linkstwo/smart-wardrobe-iot/执行ALL HOME，M1M3M4全部归零。.md

**执行ALL HOME，M1/M3/M4全部归零。**

**M2以10RPM顺时针CW转650步，进入与放衣相同的基础姿态。**

**Z轴移动到激光定位板高度EC4=3263。**

**M2以10RPM顺时针CW转**1500**步，进入激光扫描姿态。**

**X轴右移到激光起点EC1=8860。**

**清空旧激光样本，等待2帧新响应。**

**X轴以20RPM开始扫描，识别到板面后降至10RPM。**

**扫描到第SLOT块有效定位板并完整退出后，急停X轴。**

**X轴从停止位置向左相对移动1125个EC1计数。**

**Z轴从当前位置向下相对移动1200个EC4计数（中转位置）。**

**Y轴从当前位置向前相对移动1250个EC3计数。**

**M2以10RPM逆时针CCW转1500步，进入衣服吸取姿态。**

**Z轴从当前位置向下相对移动300个EC4计数。**

**电磁铁ON，吸住衣服并等待2秒。**

**Z轴从当前位置向上相对移动200个EC4计数。**

**Y轴从当前位置向前相对移动150个EC3计数。**

**M2以10RPM顺时针CW转1500步，将衣服从挂衣姿态旋转回来。**

**Y轴通过EX\_KEY3归零**

**M2以10RPM逆时针CW转4500步。**

**X轴左移到中转位置EC1=4200。**

**M2以10RPM顺时针CW转3000步。**

**Z轴向下移动到最终位置EC4=12800。**

**Y轴向前移动到EC3=1540。**

**X轴归零。**

**电磁铁OFF，放下衣服并等待2秒。**

**Z轴移动到中转高度EC4=10000。**

**执行ALL HOME，M1/M3/M4全部归零。**

**M2通过绝对编码器回到RAW=1008。**

**确认全部到位后，上报取衣成功。**

eyJjbWQiOjE3LCJwb3NpdGlvbiI6MX0=，第一件的，取衣服的

**X轴左移到中转位置EC1=5000。**

**M2以10RPM逆时针CCW转3000步，退出激光扫描姿态。此时M2仍保留最开始的CW 650步姿态。**

**Z轴移动到中转高度EC4=10000。**

**Y轴向前移动到EC3=1494。**

**X轴通过EX\_KEY1归零，使衣服回到原取放位置的X坐标。**

**Z轴向下移动到最终位置EC4=12800。**

**电磁铁OFF，放下衣服并等待2秒。**

**M4以CCW向上移动650个电机步，离开放衣位置。**

**Y轴通过EX\_KEY3归零。**

**执行ALL HOME，M1/M3/M4全部归零。**

**M2通过绝对编码器回到RAW=1008。**

**确认全部到位后，上报取衣成功。**
