linkstwo/smart-wardrobe-iot/新建 文本文档.md

放衣服 AXIS PLACE\_CLOTH

执行ALL HOME，M1/X、M3/Y、M4/Z归零。

M2以10RPM顺时针CW转650步。

Z轴到绝对位置EC4=10000。

**X轴到绝对位置EC1=这个是一个变量（要根据激光测距2测出的距离在用那个公式转化成EC1的位置）。**

**（公式K = (激光距离变化D2 - D1) / (编码器变化EC2 - EC1)**

**单位：mm/编码器计数）**

Y轴到绝对位置EC3=1381。

Z轴到绝对位置EC4=12552。

电磁铁ON，等待2秒。

M4以CCW向上运行650个电机步，速度使用命令RPM。

**X轴到绝对位置EC1=1000。**

Y轴通过EX\_KEY3物理归零。

Z轴到激光高度EC4=3263。

M2以10RPM顺时针CW转4000步。

X轴到激光起点EC1=8860。

清空旧激光样本，等待2帧新响应。

X轴以75RPM扫描，进入有效板面后降至50RPM。

找到第SLOT块有效板并完整退出后，停止X轴。

X轴从停止位置向左相对移动1125个EC1计数。

Z轴从当前位置向下相对移动1500个EC4计数。

Y轴从当前位置向前相对移动1250个EC3计数。

M2以10RPM逆时针CCW转4000步。

电磁铁OFF，等待2秒。

Z轴从释放位置向上相对移动150个EC4计数。

Y轴通过EX\_KEY3物理归零。

M2以10RPM顺时针CW转1000步。

再次执行ALL HOME，M1/M3/M4全部归零。

M2以25RPM通过绝对编码器回到RAW=1008。

确认全部到位后上报放衣成功。

取衣服 AXIS TAKE\_CLOTH

执行ALL HOME，M1/X、M3/Y、M4/Z归零。

M2以10RPM顺时针CW转650步。

Z轴到激光高度EC4=3263。

M2以10RPM顺时针CW转1500步。

X轴到激光起点EC1=8860。

清空旧激光样本，等待2帧新响应。

X轴以75RPM扫描，进入有效板面后降至50RPM。

找到第SLOT块有效板并完整退出后，停止X轴。

X轴从停止位置向左相对移动1760个EC1计数。

Z轴从当前位置向下相对移动1200个EC4计数。

Y轴从当前位置向前相对移动1350个EC3计数。

M2以10RPM逆时针CCW转1500步。

Z轴从当前位置向下相对移动670个EC4计数。

电磁铁ON，等待2秒。

Z轴从当前位置向上相对移动520个EC4计数。

Y轴从当前位置向前相对移动150个EC3计数。

M2以10RPM顺时针CW转1500步。

Y轴通过EX\_KEY3物理归零。

M2以10RPM逆时针CCW转5500步。

X轴移动到绝对位置EC1=1000。

M2以10RPM顺时针CW转4000步。

Z轴到绝对位置EC4=12552。

Y轴到绝对位置EC3=1470。

X轴到绝对位置EC1=3200。

电磁铁OFF，等待2秒。

Z轴到绝对位置EC4=10000。

再次执行ALL HOME，M1/M3/M4全部归零。

M2以25RPM通过绝对编码器回到RAW=1008。

确认全部到位后上报取衣成功。
