linkstwo/smart-wardrobe-iot/SmartWardrobe/ALL_HOME回零逻辑对话记录.md

# ALL HOME 回零逻辑对话记录

记录时间：2026-06-15 14:32:08

## 用户关注点

- 查询当前程序中，电机回到行程开关后，编码器计数是否会自动归零。
- 查询 `ALL HOME RPM=xx` 是否只有在 M1、M3、M4 三个行程开关都未触发时才会运行。
- 要求修改 `ALL HOME RPM=xx` 的行为：如果 M1、M3、M4 中有一个或两个已经在行程开关位置，也要让其他未触发行程开关的步进电机继续回到行程开关。

## 本小姐的检查结论

- 当前程序在 `HOME_EX` 到达行程开关后，只会急停对应电机并输出完成提示，不会自动调用 `EncoderCtrl_Clear()`，因此不会自动清零编码器计数。
- 修改前的 `ALL HOME RPM=xx` 会先检查 M1、M3、M4，只要其中任意一个行程开关已触发，就直接返回 `ERR 212 EX_KEY_LOW`，整个 `ALL HOME` 不会启动。
- `ALL HOME` 的参与轴是 M1-EX1、M3-EX3、M4-EX4，M2-EX2 被跳过。

## 本次修改意图

- 保留 `ALL HOME` 只作用于 M1、M3、M4 的规则。
- 将 `ALL HOME` 从“任意一个参与轴已触发就整体失败”改为“已触发的轴跳过，未触发的轴继续执行回原点”。
- 如果 M1、M3、M4 全部已经在行程开关，则不启动任何电机，并返回 `OK ALL HOME ALREADY_DONE ...`。
- 后续补充：`ALL HOME RPM=xx` 等 M1/M3/M4 全部到位后，自动清零 EC1、EC3、EC4，并把现场三轴坐标 `X=M1、Y=M3、Z=M4` 归零；M2 的 RS485 绝对值编码器不归零。
- 最新确认：旋转电机对应特殊编码器 2，因此旋转轴命令使用 `M2 ROT_*`，不是 M3 或 M5；`M2 ABS_*` 仍用于 M2 的 RS485 绝对值编码器角度闭环。
- `AXIS MOVE` / `AXIS ZERO` / `AXIS LIMIT_SET` 仍只作用于 XYZ 三轴：`X=M1`、`Y=M3`、`Z=M4`，M2 不加入 XYZ 坐标。

## 验证建议

- 三个轴都离开行程开关时，发送 `ALL HOME RPM=120`，应启动 M1、M3、M4。
- 只有 M1 已触发行程开关时，发送 `ALL HOME RPM=120`，应跳过 M1，只启动 M3、M4。
- M1、M3 已触发行程开关时，发送 `ALL HOME RPM=120`，应跳过 M1、M3，只启动 M4。
- M1、M3、M4 全部已触发行程开关时，发送 `ALL HOME RPM=120`，应返回已完成状态，不启动电机。
- 注意命令参数应为 `RPM`，不是 `PRM`。
