linkstwo/smart-wardrobe-iot/SmartWardrobe/57电机32-25(1)/57电机32-25/搂线图.jpg

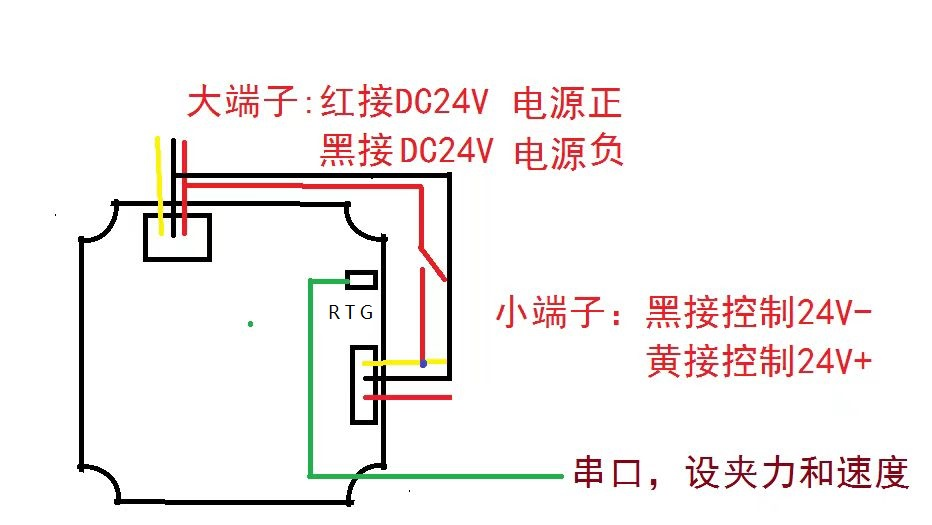
SmartWardrobe/57电机32-25(1)/57电机32-25/搂线图.jpg
