linkstwo/smart-wardrobe-iot/SmartWardrobe/57电机32-25(1)/57电机32-25/操作说明.png

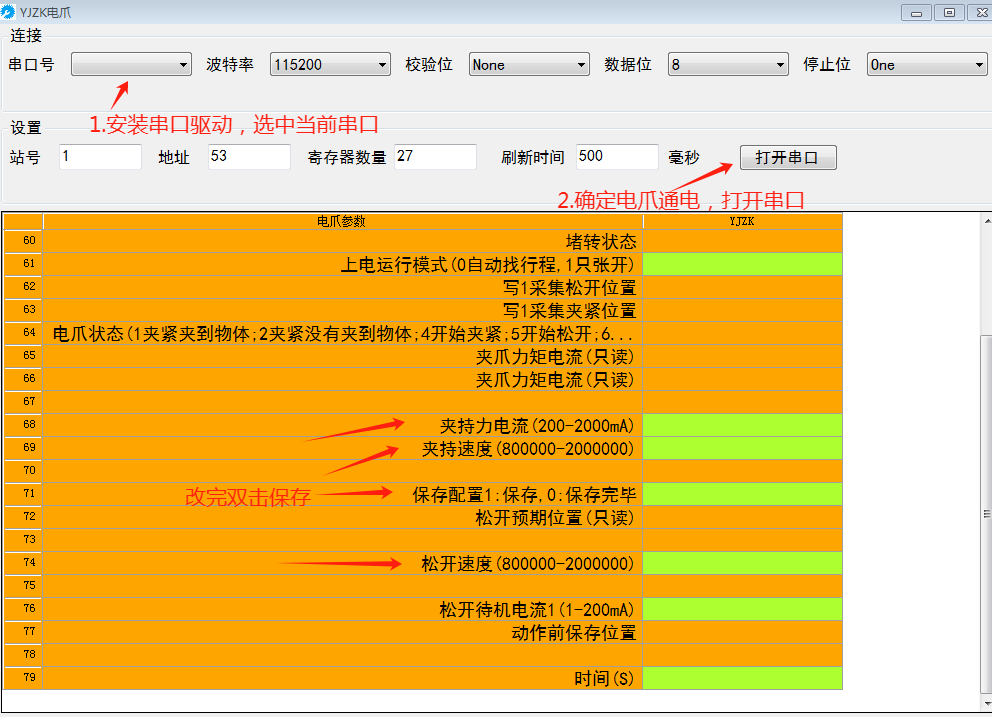
SmartWardrobe/57电机32-25(1)/57电机32-25/操作说明.png
