linkstwo/smart-wardrobe-iot/SmartWardrobe/57电机32-25(1)/57电机32-25/连接图.png

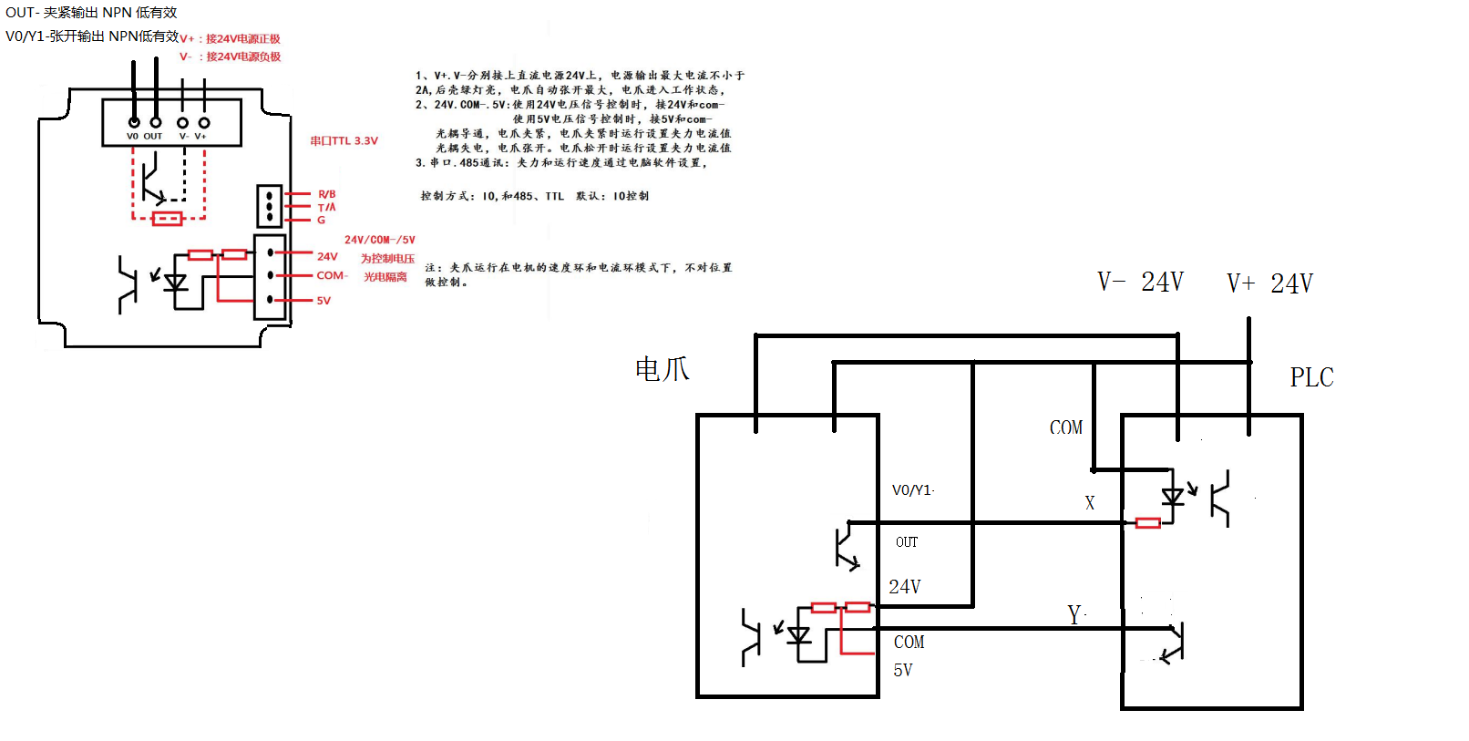
SmartWardrobe/57电机32-25(1)/57电机32-25/连接图.png
