linkstwo/smart-wardrobe-iot/SmartWardrobe/MDK-ARM/ec4_pin_crop.png

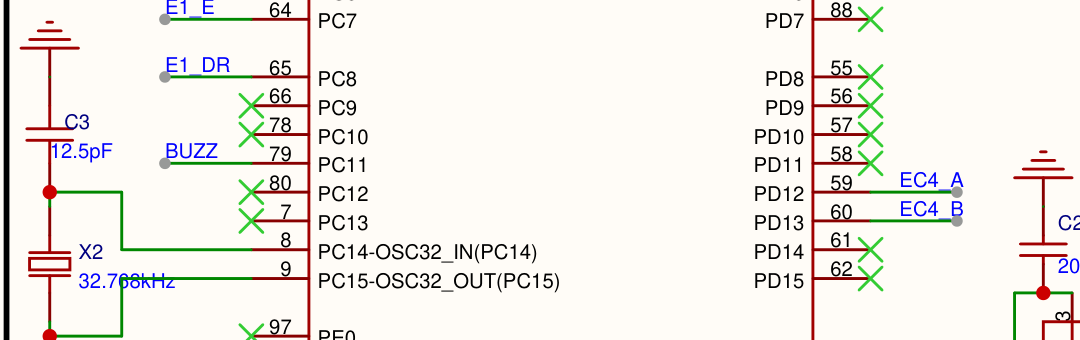
SmartWardrobe/MDK-ARM/ec4_pin_crop.png
