linkstwo/smart-wardrobe-iot/取衣服放衣服.png

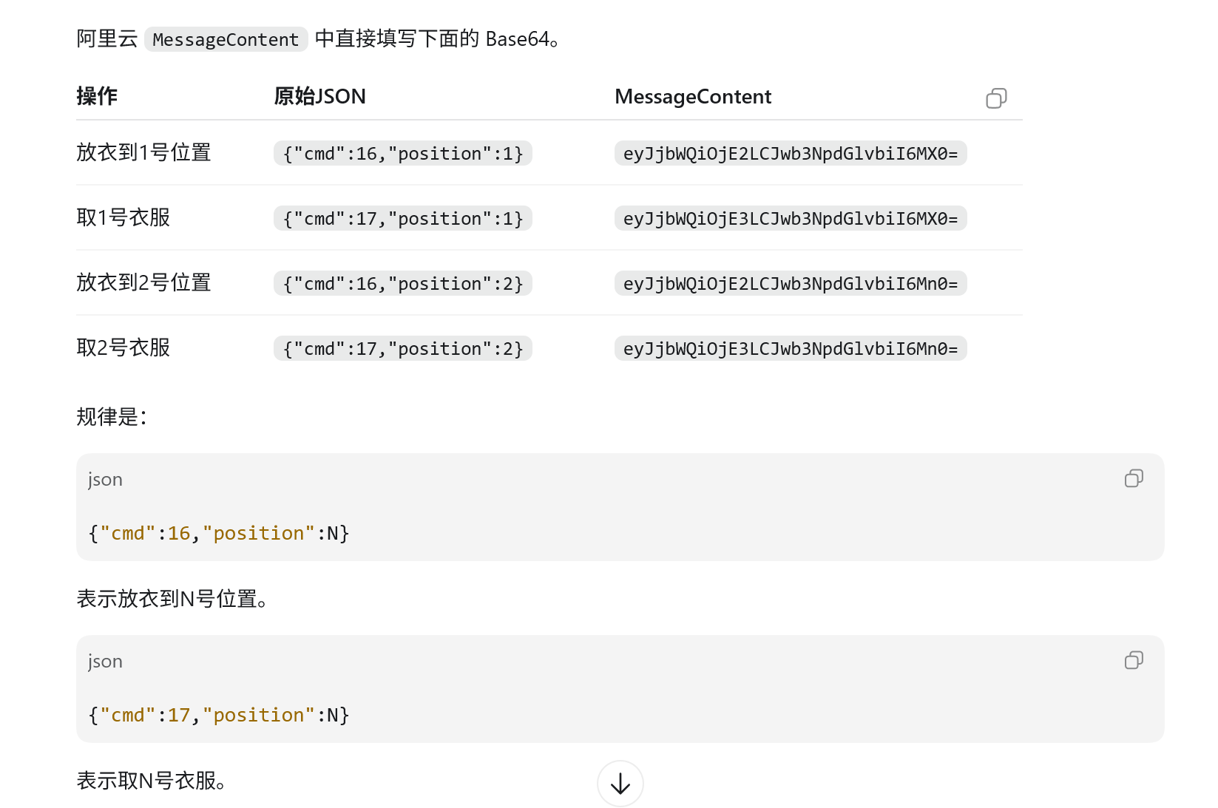
取衣服放衣服.png
