linkstwo/smart-wardrobe-iot/server_esp/修改日志/修改日志.md

# 修改日志

## 2026-07-11 10:58:17

### 修改类型
修改 / 激光衣位协议扩展

### 涉及文件
- `components/esp_mqtt/mqtt.c`
- `docs/README.md`
- `docs/协议.md`
- `协议.md`
- `修改日志/修改日志.md`

### 修改内容
- 取衣命令的 `position` 范围调整为 `1..255`，并原样转发给 STM32，表示从 X 原点扫描到的第 N 块三级定位板。
- 存衣命令仍只允许已配置的 `position=1`。
- 删除 `position=5` 映射为 1 号位的旧兼容逻辑，并同步更新协议说明。

### 修改原因
- STM32 已改为使用 JH-AI-1811 激光模块动态识别取衣位置，不再依赖固定位置别名。

### 问题修复类型
- 根本性功能实现。

### 根因分析
- 原 ESP32 参数校验只允许位置 1 和 5，会拦截新的第 N 衣位取衣命令。

### 工程原则应用
- KISS：仅按命令类型区分位置范围，不改变 UART 帧格式。
- YAGNI：存衣仍保持单一已配置位置。
- DRY：继续复用现有一字节 position 帧和 pending 命令机制。
- SOLID：MQTT 层只负责参数校验和转发，不实现机械扫描逻辑。

### 问题确认情况
- 用户已确认实施 JH-AI-1811 激光衣位识别方案。

### 风险评估
- ESP32 会允许取衣位置 1..255，目标板不存在时由 STM32 扫描超时或限位保护返回故障。

### 验证方式
- 本机未发现 ESP-IDF `idf.py`，未执行 ESP32 全量编译。
- 实机发送 `cmd=17, position=1/2/N`，确认帧原样转发；发送存衣 `position!=1` 应返回 `unsupported_position`。

## 2026-07-10 11:56:31

### 修改类型
修复 / VS Code 烧录目录恢复

### 涉及文件
- `.vscode/settings.json`
- `firmware_cloud/project_description.json`
- `build/flasher_args.json`
- `build/flash_args`
- `build/bootloader.bin`
- `build/partition-table.bin`
- `build/main.bin`
- `build/main.elf`
- `build/project_description.json`
- `修改日志/修改日志.md`

### 修改内容
- 明确设置 ESP-IDF 扩展的构建目录为 `${workspaceFolder}/build`。
- 将 clangd 的编译数据库目录从已失效的旧工程绝对路径改为当前工作区的 `build`。
- 为现有固件补充 ESP-IDF 扩展读取 ELF 文件名所需的 `project_description.json`。
- 将已完成构建并验证过的 ESP32-S3 烧录清单、三个 BIN、ELF 和项目描述同步到标准 `build` 目录，使 VS Code Flash 能完成全部前置校验。

### 修改原因
- VS Code ESP-IDF 扩展默认检查 `server_esp/build/flasher_args.json`，但完整固件此前只集中在 `firmware_cloud/`，因此直接报缺少文件并终止烧录。

### 问题修复类型
分阶段修复

### 根因分析
- 报错不是固件源码编译错误，而是扩展使用的标准构建目录与固件实际存放目录不一致。
- 只复制 `flasher_args.json` 仍会因引用的 BIN 或扩展要求的 ELF/项目描述不存在而失败，因此本次同步完整 Flash 所需文件集合。
- 当前阶段直接恢复现有已验证固件的 Flash 能力；后续源码重新构建仍应通过纯英文工程路径或修复本机 Python/ESP-IDF 的 UTF-8 路径环境完成。

### 工程原则应用
- KISS：继续使用 ESP-IDF 扩展默认的 `build` 目录，不引入额外烧录脚本。
- YAGNI：不修改系统环境变量，不新增全局路径映射。
- DRY：`build` 与 `firmware_cloud` 使用同一套已验证固件产物。
- SOLID：当前为工具链目录配置修复，不强行套用复杂架构。

### 问题确认情况
- 已确认报错目录 `build` 缺少 `flasher_args.json`，而 `firmware_cloud` 中该文件及其引用的三个 BIN 均完整存在。
- 用户回复“继续”，同意按根因方向修改。

### 风险评估
- 本次不自动烧录 `COM19`，不会直接改写 ESP32 Flash。
- 已实测 `PYTHONUTF8=1` 可以消除 `config.env` 的 GBK 解码异常，但 CMake 仍会把中文目录 `M2可转向` 解码成乱码，且本机子进程存在 `Path/PATH` 重复项；因此原路径下源码重构建仍未根治，本次先恢复现有已验证固件的 Flash 能力。

### 验证方式
- `build/flasher_args.json`、三个 BIN、`main.elf` 和 `project_description.json` 应同时存在。
- `flasher_args.json` 中的偏移和文件名应分别为 `0x0 bootloader.bin`、`0x8000 partition-table.bin`、`0x10000 main.bin`。
- VS Code 重新加载窗口后执行 Flash，不应再出现 `flasher_args.json file is missing`。

## 2026-07-10 11:21:11

### 修改类型
修复 / 云端通信联调

### 涉及文件
- `components/esp_mqtt/mqtt.c`
- `components/uart/uart.c`
- `docs/README.md`
- `协议.md`
- `docs/协议.md`
- `firmware_cloud/README.md`
- `firmware_cloud/main.bin`
- `firmware_cloud/main.elf`
- `firmware_cloud/main.map`
- `firmware_cloud/bootloader.bin`
- `firmware_cloud/partition-table.bin`
- `firmware_cloud/flash_args`
- `firmware_cloud/flasher_args.json`
- `修改日志/修改日志.md`

### 修改内容
- 将 STM32 成功、故障和状态响应的 MQTT 发布 Topic 从旧的 `wardrobe/response` 改为当前阿里云自定义 Topic `WARDROBE_MQTT_TOPIC`。
- 将存衣、取衣位置校验从仅允许 `position=1` 调整为允许 `position=1/5`，与 STM32 的 `g_wardrobe_position_map[]` 保持一致。
- 同步更新 README 和两份协议文档中的位置范围及 MQTT 同 Topic 收发说明。
- 从当前源码独立构建 ESP32-S3 固件，并将可烧录产物集中放入 `firmware_cloud/`。
- 修正 `firmware_cloud/flash_args` 和 `flasher_args.json`，使其引用当前目录内的实际固件文件。

### 修改原因
- UART 上行处理仍保留旧响应 Topic，导致 STM32 即使返回 `0x90/0x91/0xA0`，ESP32 也不会发布到当前阿里云联调使用的同一 Topic。
- STM32 已支持云端位置 1 和 5，但 ESP32 会提前拒绝 `position=5`，两端能力边界不一致。
- 原 `build/` 缓存绑定另一份旧工程路径，不能证明当前目录源码已经进入烧录固件。

### 问题修复类型
根本性修复

### 根因分析
- MQTT 下行使用 `WARDROBE_MQTT_TOPIC`，UART 上行却硬编码 `wardrobe/response`，协议上下行 Topic 没有统一事实来源。
- ESP32 的单点位置限制落后于 STM32 映射表，合法命令在进入 UART 前被错误拦截。
- 当前工程路径含中文，ESP-IDF/CMake 在本机默认编码下会产生乱码路径；本次通过临时英文构建目录编译当前源码，并校验暂存源码 SHA256 与当前源码一致。

### 工程原则应用
- KISS：直接复用已有 `WARDROBE_MQTT_TOPIC`，不新增第二套 Topic 配置。
- YAGNI：只放行当前 STM32 已明确映射的 1 和 5，不开放其他未配置位置。
- DRY：上下行统一使用同一 Topic 宏，避免重复硬编码再次漂移。
- SOLID：保持 MQTT 负责下行转换、UART 负责上行解析的现有模块边界。

### 问题确认情况
- 已确认当前 ESP32 ELF 同时包含旧响应 Topic 和阿里云 Topic，属于确定的代码不一致。
- 已确认 STM32 映射表包含 `position=1/5`。
- 用户明确回复“继续”，同意按该根因修改并构建固件。

### 风险评估
- `position=5` 当前与 `position=1` 共用运动点位 1，并不代表已经增加独立的 5 号机械坐标。
- 同 Topic 收发依赖 MQTT 命令处理器继续忽略带 `status` 字段的响应，当前代码已保留该保护。
- 若在阿里云物模型属性页查看状态，仍需另行实现物模型属性上报；本次修复的是自定义 Topic 链路。

### 验证方式
- ESP-IDF 完整构建成功，生成 ESP32-S3 `main.bin`，大小 932416 字节，应用分区剩余约 11%。
- 构建日志显示 `mqtt.c`、`uart.c` 编译成功并完成主程序、bootloader 和分区表镜像生成。
- 新 `firmware_cloud/main.elf` 包含完整阿里云 Topic，不再包含旧字符串 `wardrobe/response`。
- 烧录后发送 `{"cmd":32}`，应看到 ESP32 发出 `A5 20 00 20 5A`，收到 STM32 `0xA0` 后向同一阿里云 Topic 发布状态 JSON。
- 发送 `{"cmd":17,"position":1}` 和 `{"cmd":17,"position":5}`，两者都应进入 UART 转发链路。

## 2026-06-24 22:05:39

### 修改类型
修改

### 涉及文件
- `components/uart/CMakeLists.txt`
- `修改日志/修改日志.md`

### 修改内容
- 补充 ESP32 UART 组件 CMake 文件的中文说明，明确该组件负责 ESP32 与 STM32 串口通信。
- 说明手动添加 include 路径的原因是避免组件循环依赖。

### 修改原因
- 用户要求再次仔细检查是否还有文件漏掉中文注释。

### 问题修复类型
- 不适用

### 根因分析
- 本次不是功能修复，只补充说明性中文注释。

### 工程原则应用
- KISS：只补充构建配置说明，不改组件依赖和构建逻辑。
- YAGNI：没有调整 ESP-IDF 构建结构。
- DRY：把 UART 组件职责写在对应 CMake 文件顶部。
- SOLID：配置注释补充，不强行套用复杂架构。

### 问题确认情况
- 用户反馈可能仍有文件缺少中文注释，已重新扫描确认后补充。

### 风险评估
- 仅增加注释，无运行时行为变化，无明显风险。

### 验证方式
- 重新扫描 ESP32 配置文件中文注释覆盖情况。

## 2026-06-24 21:34:26

### 修改类型
修改

### 涉及文件
- `CMakeLists.txt`
- `main/CMakeLists.txt`
- `app/CMakeLists.txt`
- `components/esp_mqtt/CMakeLists.txt`
- `components/wifi/CMakeLists.txt`
- `components/esp_mqtt/Kconfig`
- `components/uart/Kconfig`
- `components/wifi/Kconfig`
- `components/esp_mqtt/mqtt.c`
- `修改日志/修改日志.md`

### 修改内容
- 为 ESP32 工程 CMake 和 Kconfig 配置文件补充中文注释。
- 在 MQTT 衣柜命令处理处补充中文说明，明确增加 2/3 号衣服点位时需要放开 `position` 判断。
- 明确 ESP32 点位放开必须与 STM32 `g_wardrobe_position_map[]` 和 `g_cloth_slot_cfg[]` 同步。

### 修改原因
- 用户要求继续检查还有哪些文件没有中文注释，并要求在代码中标清楚增加衣服点位的位置。

### 问题修复类型
- 不适用

### 根因分析
- 本次不是功能修复，只补充说明性中文注释。
- 原 C 源码已有较多中文注释，但 ESP-IDF 构建配置文件和 MQTT 点位扩展说明还不够完整。

### 工程原则应用
- KISS：只增加注释，不改 MQTT 协议、Topic、云端认证参数和 UART 帧格式。
- YAGNI：没有提前增加 2/3 号点位运行逻辑，只说明扩展位置。
- DRY：把 ESP32 放开点位的说明写在 `WARDROBE_SUPPORTED_SLOT` 和 `position` 判断附近。
- SOLID：当前为嵌入式 C/ESP-IDF 配置注释补充，不强行套用复杂架构。

### 问题确认情况
- 用户明确要求只写代码注释，不改代码逻辑，并要求继续仔细检查遗漏注释。

### 风险评估
- 仅增加注释，无运行时行为变化，无明显风险。
- `.vscode/*.json` 未添加注释，因为标准 JSON 不支持注释。
- `SmartWardrobeCode.ioc` 未手动添加注释，因为 CubeMX 配置文件开头标明不建议手改。

### 验证方式
- 检查 ESP32 CMake/Kconfig 文件是否已有中文说明。
- 检查 `components/esp_mqtt/mqtt.c` 中 `WARDROBE_SUPPORTED_SLOT` 和 `position` 判断处的点位扩展说明。
- 重新扫描源码和配置文件中的中文注释覆盖情况。

## 2026-06-24 21:14:03

### 修改类型
修改

### 涉及文件
- `main/main.c`
- `app/app.c`
- `app/app_init.c`
- `app/include/app.h`
- `app/include/app_init.h`
- `components/esp_mqtt/mqtt.c`
- `components/esp_mqtt/include/mqtt.h`
- `components/esp_mqtt/include/mqtt_config.h`
- `components/uart/uart.c`
- `components/uart/include/uart.h`
- `components/uart/include/uart_config.h`
- `components/wifi/wifi.c`
- `components/wifi/include/wifi.h`
- `components/wifi/include/wifi_config.h`
- `修改日志/修改日志.md`

### 修改内容
- 为 ESP32 工程核心源码补充详细简体中文注释。
- 说明 ESP32 从阿里云 MQTT 接收 `cmd`/`position` JSON 后，如何转换为 STM32 串口二进制帧。
- 说明衣柜 UART 帧格式 `A5 CMD LEN DATA CRC 5A`、CRC 计算方式和 STM32 响应帧处理路径。
- 说明当前 `WARDROBE_SUPPORTED_SLOT` 只支持 1 号位，后续增加 2 号、3 号位置时需要扩展该限制。
- 为 WiFi、MQTT、UART、应用初始化等模块补充职责、初始化顺序、任务边界和配置项说明。
- 未修改任何函数逻辑、变量名、宏数值、Topic、引脚、协议命令字或控制流程。

### 修改原因
- 用户要求两个工程的代码都增加非常详细的简体中文注释。
- ESP32 工程涉及阿里云 MQTT、UART 转发和 STM32 响应解析，原代码阅读门槛较高，需要在源码中直接标明数据流和协议边界。

### 问题修复类型
- 不适用

### 根因分析
- 本次不是 Bug 修复，而是代码可读性和维护性增强。
- 主要原因是后续可能扩展 2 号、3 号等衣柜位置，需要先把当前 1 号位限制、云端 JSON、ESP32 转发帧和 STM32 响应关系写清楚，避免扩展时改错协议层。

### 工程原则应用
- KISS：只增加注释，不引入新逻辑，不改变现有通信链路。
- YAGNI：没有提前实现 2 号、3 号位置，只在注释中标明后续扩展点。
- DRY：通过模块级注释说明共用协议格式，减少后续重复查找协议细节。
- SOLID：当前为嵌入式 C 工程注释增强，不强行套用复杂架构原则。

### 问题确认情况
- 用户明确要求“代码里面给注释，不是文件名，只写注释，不改代码”，并已回复“确认”授权批量修改。

### 风险评估
- 无明显运行风险。
- 修改范围为注释文本，不应影响编译产物和设备行为。

### 验证方式
- 检查关键协议常量仍保持原值，例如 `WARDROBE_SUPPORTED_SLOT`、MQTT Topic 和 UART 帧格式。
- 使用文本搜索检查未出现明显乱码。
- 后续可通过 ESP-IDF 编译确认注释未影响语法。

## 2026-06-18 17:33:06

### 修改类型
修复 / 文档同步

### 涉及文件
- `components/esp_mqtt/mqtt.c`
- `docs/README.md`
- `docs/协议.md`
- `协议.md`
- `修改日志/修改日志.md`

### 修改内容
- ESP32 在 MQTT 命令入口增加当前支持衣格限制：存衣、取衣只接受 `position=1`。
- 非 `position=1` 的存取命令不再转发到 STM32，直接上报 `unsupported_position` 故障响应。
- 修正协议文档中取衣、成功响应、状态响应的 CRC 示例。
- 将阿里云 `MessageContent` 示例统一改为当前可联调的 1 号位。
- 明确当前 STM32 固件只有 1 号衣服位坐标。

### 修改原因
- STM32 当前二进制协议层只支持 1 号衣服位，而 ESP32 和文档仍允许或示例使用 3/5 号位，导致云端到 ESP32 成功后，ESP32 与 STM32 联调失败或必然返回故障。
- 文档里部分 CRC 示例错误，会误导串口助手手工发帧。

### 问题修复类型
- 根本性修复

### 根因分析
- 根因是 ESP32 对外接口、协议文档和 STM32 实际能力边界没有收敛：STM32 只有 1 号位动作坐标，但 ESP32 仍放行任意 0~255 位置。
- 本次在 ESP32 下发边界提前拒绝不支持的位置，并同步文档，避免把非法业务命令发到 STM32 后再排查串口问题。

### 工程原则应用
- KISS：在 MQTT 到 UART 的边界做最小必要校验，不改动 UART 帧收发基础结构。
- YAGNI：未提前实现多格位坐标表，只支持当前实际具备动作流程的 1 号位。
- DRY：文档和 README 使用同一套 1 号位示例，减少联调口径不一致。
- SOLID：当前为嵌入式 C 协议适配，不强行套用复杂架构；保持云端命令校验、UART 转发、STM32 动作执行职责分离。

### 问题确认情况
- 已通过代码确认 STM32 `WARDROBE_SUPPORTED_SLOT` 为 `1`。
- 已通过用户提供的串口数据确认 STM32 仍在向 ESP32 发送文本状态，链路尚未完全按二进制协议打通。

### 风险评估
- 云端继续发送 `position=3` 或 `position=5` 会被 ESP32 拒绝，不再触发 STM32 动作。
- 若后续需要多衣格，需要先在 STM32 增加多衣格坐标和业务状态，再放开 ESP32 校验。

### 验证方式
- 阿里云 OpenAPI Pub 放衣服：`MessageContent=eyJjbWQiOjE2LCJwb3NpdGlvbiI6MX0=`。
- 阿里云 OpenAPI Pub 取衣服：`MessageContent=eyJjbWQiOjE3LCJwb3NpdGlvbiI6MX0=`。
- 阿里云 OpenAPI Pub 读状态：`MessageContent=eyJjbWQiOjMyfQ==`。
- 串口侧 1 号位放衣帧应为 `A5 10 01 01 10 5A`，取衣帧应为 `A5 11 01 01 11 5A`。

## 2026-06-17 11:03:50

### 修改类型
修改 / 修复

### 涉及文件
- `app/app_init.c`
- `components/esp_mqtt/mqtt.c`
- `components/esp_mqtt/include/mqtt.h`
- `components/uart/uart.c`
- `components/uart/include/uart.h`
- `components/uart/Kconfig`
- `components/uart/include/uart_config.h`
- `sdkconfig`
- `docs/README.md`

### 修改内容
- 将 MQTT 下行订阅主题从旧的 `esp32/move` 改为协议要求的 `wardrobe/command`。
- 将服务器命令格式从 `{"command":"up"}` 改为协议要求的 `{"cmd":16,"position":3}`、`{"cmd":17,"position":5}`、`{"cmd":32}`。
- 将 ESP32 发往 STM32 的 UART 数据从字符串命令改为 `A5 CMD LEN DATA CRC 5A` 二进制帧。
- 新增 STM32 上行帧解析，支持 `0x90` 操作成功、`0x91` 故障异常、`0xA0` 状态上报，并发布到 `wardrobe/response`。
- 关闭旧的 UART 接收后自动发送 `OK\n` ACK，避免污染二进制帧协议。
- 同步更新 `docs/README.md` 中的通信说明。

### 修改原因
- 用户确认当前固件需要和 `协议.md` 的智能衣柜通信协议一致，而原程序仍使用移动方向字符串和旧 MQTT 主题。

### 问题修复类型
根本性修复

### 根因分析
- 根因是固件业务协议实现与文档协议不一致：MQTT 主题、JSON 字段、UART 数据格式和上行响应解析均停留在旧的移动控制字符串协议。
- 本次直接在 MQTT 下行入口和 UART 上行解析处按协议重写转换边界，避免只改主题名或只做字符串兼容造成继续不匹配。

### 工程原则应用
- KISS：保留现有 MQTT/UART 组件边界，只替换协议转换逻辑。
- YAGNI：仅实现协议文档已有的存衣、取衣、读状态、成功、故障、状态上报，不新增额外业务功能。
- DRY：统一使用同一套 XOR CRC 计算规则，避免多处手写校验逻辑。
- SOLID：当前为嵌入式 C 组件协议适配，不强行引入复杂抽象；保持 MQTT 负责下行转换、UART 负责上行解析。

### 问题确认情况
- 已确认 `协议.md` 要求 MQTT 使用 `wardrobe/command`/`wardrobe/response`，UART 使用二进制帧。
- 用户已明确要求“现在就把这个改成和协议一样的”，并连续回复“继续”授权推进修改和验证。

### 风险评估
- 旧的 `esp32/move`、`{"command":"up"}`、串口字符串命令、`esp32/uart/log` 上报方式不再适用。
- 单片机端必须按 `A5 CMD LEN DATA CRC 5A` 二进制帧协议收发，否则无法联调。
- 成功响应 `0x90` 帧只携带位置，不携带原始动作；固件通过最近一次下发的存/取命令补全 MQTT 响应中的 `action`，因此上位机应避免并发下发多个未完成命令。

### 验证方式
- 已运行 `idf.py build`，结果为 `Project build complete`。
- 残留搜索确认旧主题 `esp32/move`、旧上报 `esp32/uart/log`、旧字符串状态 `clothing_taken_*` 未在 app/components/docs/sdkconfig 主路径中作为业务逻辑残留。
- 联调时向 `wardrobe/command` 发布 `{"cmd":17,"position":5}`，ESP32 应向 UART1 发送字节 `A5 11 01 05 15 5A`。

## 2026-06-17 14:18:33

### 修改类型
修改 / 修复

### 涉及文件
- `app/app_init.c`
- `components/esp_mqtt/mqtt.c`
- `components/esp_mqtt/include/mqtt.h`
- `components/esp_mqtt/include/mqtt_config.h`
- `docs/README.md`

### 修改内容
- 将 MQTT 订阅和发布 Topic 从简化的 `wardrobe/command` / `wardrobe/response` 统一改为阿里云自定义 Topic `/k1vtgAzED8C/${deviceName}/user/wardrobe`。
- 为 MQTT Topic 提取统一宏 `WARDROBE_MQTT_TOPIC`，减少重复字符串。
- 在 MQTT 命令处理里增加对带 `status` 字段消息的忽略逻辑，避免同主题发布/订阅时误处理自己发布的响应。
- 修正 `mqtt_config.h` 中备用 `CONFIG_MQTT_CLIENT_ID`，补全阿里云要求的 `ProductKey.DeviceName` 前缀。
- 同步更新 `docs/README.md`，说明当前阿里云 Topic 为同主题收发。

### 修改原因
- 用户提供的阿里云控制台 Topic 与当前代码中的 `wardrobe/command` 不一致，导致 ESP32 无法接收到服务器发往真实云 Topic 的消息。
- 当前控制台 Topic 同时支持发布和订阅，因此需要在同一 Topic 上区分下行命令与上行响应。

### 问题修复类型
根本性修复

### 根因分析
- 根因是 MQTT 业务 Topic 设计与阿里云控制台配置不一致。
- 以前的代码把 Topic 写成了本地化简写 `wardrobe/command`，而阿里云实际转发使用的是产品级完整路径。
- 同主题收发时未过滤上行响应会导致回环，因此补上 `status` 响应过滤。

### 工程原则应用
- KISS：用统一宏表达 Topic，减少分散字符串维护。
- YAGNI：只增加当前控制台配置需要的同主题收发与响应过滤，不扩展额外路由层。
- DRY：Topic 只保留一份定义，避免 app 和 mqtt 两处重复修改。
- SOLID：当前为单组件协议适配，不强行拆复杂抽象。

### 问题确认情况
- 已确认截图中的自定义 Topic 为 `/k1vtgAzED8C/${deviceName}/user/wardrobe`。
- 已确认当前代码里的 `wardrobe/command` 不匹配控制台配置。

### 风险评估
- 同主题收发会带来“收到自己发出的响应”的可能性；已通过 `status` 字段过滤降低风险。
- 需要确保服务器发来的下行命令不带 `status` 字段，否则会被误判为响应消息忽略。

### 验证方式
- 重新构建并确认编译通过。
- 在阿里云控制台向 `/k1vtgAzED8C/7Rzu9Cy7Ze6Yhe1YcMjQ/user/wardrobe` 发布 `{"cmd":17,"position":5}`，ESP32 应收到并向 UART1 下发 `A5 11 01 05 15 5A`。
- ESP32 上行发布的响应消息应同样出现在该 Topic 下，但被本地处理逻辑忽略，不会形成循环。

## 2026-06-17 15:49:54

### 修改类型
创建

### 涉及文件
- `esp.txt`
- `修改日志/修改日志.md`

### 修改内容
- 新增 `esp.txt`，记录本次关于 ESP32-S3、阿里云 MQTT、自定义 Topic、UART 二进制协议、STM32 联调的完整对话要点。

### 修改原因
- 用户要求“把我和你的对话都记录下来，命名为 esp.txt”。

### 问题修复类型
不适用

### 根因分析
- 本次不是问题修复，而是根据用户要求保存联调过程记录，便于后续查阅。

### 工程原则应用
- KISS：创建单个文本文件记录关键过程，不引入额外格式或工具。
- YAGNI：只记录当前 ESP32/阿里云/STM32 联调相关内容，不扩展无关文档。
- DRY：集中到一个 `esp.txt`，避免分散记录。
- SOLID：文档记录任务不涉及复杂架构，不强行套用。

### 问题确认情况
- 用户明确要求创建 `esp.txt`。
- 创建前已检查当前项目根目录不存在同名文件，未覆盖已有内容。

### 风险评估
- 无明显风险。

### 验证方式
- 检查 `esp.txt` 是否存在并包含本次联调记录。

## 2026-06-10 15:24:19

### 修改类型
修复

### 涉及文件
- `app/CMakeLists.txt`

### 修改内容
- 移除了 `app` 组件对未启用蓝牙组件 `bluetooth` 的强制依赖。

### 修改原因
- 当前主程序未启用蓝牙功能，但 `app` 组件仍强制依赖 `bluetooth`，导致 VSCode/ESP-IDF 索引蓝牙头文件时在 `CONFIG_BT_ENABLED` 关闭状态下找不到 `esp_bt.h`。

### 问题修复类型
根本性修复

### 根因分析
- 根因是未使用蓝牙功能时仍将蓝牙组件纳入依赖图，而当前 `sdkconfig` 中 `CONFIG_BT_ENABLED` 未启用，蓝牙组件头文件路径不会完整暴露给索引/构建环境。

### 工程原则应用
- KISS：仅移除未使用依赖，不改动蓝牙实现和业务逻辑。
- YAGNI：当前 MQTT、WiFi、UART 链路不需要蓝牙，不保留未使用组件依赖。
- DRY：避免通过重复配置或额外 includePath 掩盖依赖关系问题。
- SOLID：当前改动为构建依赖收敛，不涉及复杂面向对象设计，不强行套用。

### 问题确认情况
- 已确认报错来自 `esp_bt.h` 找不到，且当前配置关闭了 `CONFIG_BT_ENABLED`。
- 用户已确认按“不使用蓝牙，移除无用依赖”方向修改。

### 风险评估
- 对当前 WiFi、MQTT、UART 主链路无明显风险。
- 如果后续需要启用蓝牙，需要重新把 `bluetooth` 加回依赖并在 `menuconfig` 中启用 Bluetooth。

### 验证方式
- 重新运行 ESP-IDF reconfigure/build。
- 重启 VSCode ESP-IDF/clangd 索引，确认 `esp_bt.h: No such file or directory` 不再出现在当前主链路相关文件中。

## 2026-06-10 20:38:32

### 修改类型
删除 / 修改

### 涉及文件
- `app/CMakeLists.txt`
- `app/include/app.h`
- `app/include/app_init.h`
- `app/app.c`
- `app/app_init.c`
- `main/main.c`
- `components/uart/uart.c`
- `components/uart/CMakeLists.txt`
- `components/bluetooth/`
- `components/https/`
- `components/iic/`
- `components/spi/`

### 修改内容
- 删除 Bluetooth、HTTP/HTTPS、I2C、SPI 四类不用组件目录。
- 移除 app 层对上述组件的配置字段、初始化/反初始化入口、回调声明和构建依赖。
- 移除 UART 组件中对 HTTP/HTTPS 客户端的残留依赖，仅保留原有 MQTT 日志上报路径。

### 修改原因
- 用户确认当前项目不再使用 Bluetooth、HTTP、I2C、SPI，需要从工程中删除这些代码以减少固件体积和构建依赖。

### 问题修复类型
- 根本性修复

### 根因分析
- 当前固件体积过大，同时 app 层和 UART 组件仍保留未使用组件依赖，导致这些组件会进入构建依赖图或阻止删除后的编译。
- 本次从组件目录、app 初始化入口和构建依赖入口移除未使用功能，避免只关闭运行时开关但仍编译无用代码。

### 工程原则应用
- KISS：仅删除用户确认不用的组件及其必要引用，不改动 WiFi、MQTT、UART 主链路。
- YAGNI：移除当前不需要的 Bluetooth、HTTP/HTTPS、I2C、SPI 功能，避免无用固件体积。
- DRY：统一从 app 初始化和构建依赖入口删除未使用组件，避免多处残留重复维护。
- SOLID：当前为嵌入式组件裁剪，不强行套用复杂架构，保持组件边界清晰。

### 问题确认情况
- 用户已明确确认“蓝牙、http、I2C、SPI 的代码都删了，我不用这些东西了，其他代码不变”。

### 风险评估
- 已删除功能无法再被当前工程直接调用；后续若要恢复，需要重新添加对应组件目录和 app 层初始化入口。
- 对 WiFi、MQTT、UART 主链路无明显设计风险，但需要重新构建验证。

### 验证方式
- 运行 `idf.py build`，确认删除组件后工程仍可编译。
- 查看 `build/main.bin` 大小，确认固件体积下降。

## 2026-06-10 21:05:00

### 修改类型
修复

### 涉及文件
- `app/app_init.c`
- `修改日志/修改日志.md`

### 修改内容
- 在 WiFi 初始化时打印当前编译进固件的 STA 目标 SSID，便于确认设备实际连接的热点名称。
- 移除 `app_init_wifi()` 中重复调用 `wifi_sta_connect()` 的逻辑，连接动作保留在 `components/wifi/wifi.c` 的 `WIFI_EVENT_STA_START` 事件处理中。

### 修改原因
- 日志显示 `wifi:sta is connecting, return error`，原因是 WiFi 启动事件已经调用连接，app 层随后又重复调用连接。
- WiFi 连接失败的主因仍是 `reason: 201 / WIFI_REASON_NO_AP_FOUND`，需要通过日志确认当前目标 SSID 是否与手机热点一致。

### 问题修复类型
- 防御性兜底 / 根本性修复

### 根因分析
- 重复连接报错的根因是连接职责重复：WiFi 组件事件层和 app 初始化层都触发了 `esp_wifi_connect()`。
- 无法找到热点的根因不在本次代码修改中完全确认，当前证据指向热点 SSID、频段或手机热点兼容性问题。

### 工程原则应用
- KISS：只删除重复连接调用，并增加必要诊断日志，不改动 WiFi 主流程。
- YAGNI：没有加入扫描列表、配网等额外功能。
- DRY：连接动作只保留在一个入口，避免重复触发。
- SOLID：当前为小范围嵌入式初始化修复，不强行套用复杂架构。

### 问题确认情况
- 用户已确认按建议修改。
- 重复连接原因已由代码路径确认；热点找不到仍需结合实际手机热点配置验证。

### 风险评估
- 对 WiFi 启动流程风险较低，因为保留了原本事件驱动连接入口。
- 若后续修改 WiFi 组件取消 STA_START 自动连接，则需要重新补充显式连接入口。

### 验证方式
- 运行 `idf.py build` 确认编译通过。
- 烧录后查看日志是否出现 `WiFi STA target SSID: ...`，且不再出现 `sta is connecting, return error`。

## 2026-06-10 21:18:00

### 修改类型
修改

### 涉及文件
- `sdkconfig`
- `修改日志/修改日志.md`

### 修改内容
- 将实际参与编译的 WiFi STA SSID 修改为 `TPH`。
- 将实际参与编译的 WiFi STA 密码修改为 `666888tph`。

### 修改原因
- 用户确认当前热点已改为 `TPH`，但日志显示固件仍使用 `sdkconfig` 中旧的 `Zqbkami` 配置。

### 问题修复类型
- 根本性修复

### 根因分析
- `wifi_config.h` 中的 `#ifndef CONFIG_WIFI_STA_SSID` 只是备用默认值；当 `sdkconfig` 已定义同名配置时，实际编译值以 `sdkconfig` 为准。
- 本次直接修改 `sdkconfig`，使固件实际连接目标与用户热点一致。

### 工程原则应用
- KISS：只修改实际生效的 WiFi 配置项，不改动连接逻辑。
- YAGNI：没有添加额外配网功能。
- DRY：避免同时维护多个冲突的 WiFi 配置来源。
- SOLID：当前为配置修正，不涉及复杂架构设计。

### 问题确认情况
- 用户已明确确认修改为 `TPH / 666888tph`。

### 风险评估
- 仅影响设备连接的目标 WiFi 热点，无其他明显风险。

### 验证方式
- 运行 `idf.py build` 后检查 `build/config/sdkconfig.h` 中的 `CONFIG_WIFI_STA_SSID` 是否为 `TPH`。
- 烧录后查看启动日志 `WiFi STA target SSID: TPH`。

## 2026-06-10 21:28:00

### 修改类型
修复

### 涉及文件
- `sdkconfig`
- `修改日志/修改日志.md`

### 修改内容
- 将实际参与编译的 MQTT Broker Host 从 `192.168.25.250` 修改为 `220.177.56.240`。
- 将实际参与编译的 MQTT 用户名和密码同步为 `mqtt_config.h` 中的阿里云服务器凭据。

### 修改原因
- 用户确认 MQTT 服务在阿里云服务器，之前固件仍连接局域网地址 `192.168.25.250`，导致 TCP 连接超时。
- `mqtt_config.h` 中的默认配置被 `sdkconfig` 覆盖，必须修改 `sdkconfig` 才能让固件实际生效。

### 问题修复类型
- 根本性修复

### 根因分析
- 根因是 MQTT 运行配置来源不一致：头文件备用默认值为公网服务器，但 `sdkconfig` 中实际编译值仍是旧局域网地址和空认证信息。
- 本次直接修改实际配置源 `sdkconfig`，让固件连接目标与用户的阿里云服务器一致。

### 工程原则应用
- KISS：只修改实际生效的 MQTT 配置，不改动 MQTT 连接逻辑。
- YAGNI：没有引入额外配网或动态配置功能。
- DRY：减少头文件默认值与 sdkconfig 实际值不一致导致的重复配置误判。
- SOLID：当前为配置修复，不涉及复杂架构设计。

### 问题确认情况
- 用户已明确确认修复。

### 风险评估
- 仅影响 MQTT 连接目标和认证信息。
- 若阿里云安全组、服务器防火墙或 MQTT 服务监听配置未放行 `1883`，仍可能连接失败。

### 验证方式
- 运行 `idf.py build` 后检查 `build/config/sdkconfig.h` 中 MQTT 配置是否为阿里云服务器。
- 烧录后查看启动日志是否显示 `MQTT initialized, broker: 220.177.56.240:1883`。

## 2026-06-10 22:02:20

### 修改类型
修复

### 涉及文件
- `sdkconfig`
- `components/esp_mqtt/include/mqtt_config.h`
- `components/esp_mqtt/Kconfig`
- `修改日志/修改日志.md`

### 修改内容
- 将实际参与编译的 MQTT Broker Host 修改为阿里云 IoT 实例地址 `iot-06z00dgi0u8jci8.mqtt.iothub.aliyuncs.com`。
- 将 MQTT Client ID 修改为阿里云 IoT 签名格式的 clientId。
- 将 MQTT Username 修改为阿里云 IoT 要求的 `DeviceName&ProductKey` 格式。
- 将 MQTT Password 修改为用户提供的 HMAC-SHA256 签名结果。
- 同步更新 MQTT 组件头文件备用默认值和 Kconfig 默认值，避免后续 reconfigure 时回退到旧配置。

### 修改原因
- 当前设备已经成功连接 WiFi 并获取 IP，但 MQTT 仍然连接超时；根因是固件仍在使用旧的公网 IP 和普通 MQTT 认证参数。
- 用户确认目标是阿里云物联网平台，阿里云 IoT 不能用普通 `IP + client_id + username + password` 方式接入，需要使用平台生成的 endpoint、clientId、username 和签名 password。

### 问题修复类型
- 根本性修复

### 根因分析
- 旧配置连接的是 `220.177.56.240:1883`，而用户提供的阿里云 IoT 设备连接地址是 `iot-06z00dgi0u8jci8.mqtt.iothub.aliyuncs.com:1883`。
- 旧 `client_id` 为普通字符串 `esp32_server`，不包含阿里云 IoT 要求的 `securemode`、`signmethod` 和 `timestamp` 参数。
- 旧 password 不是本次阿里云 IoT 连接参数对应的签名值，因此即使网络可达也无法作为该设备上线。

### 工程原则应用
- KISS：仅修正 MQTT 连接配置，不改动 WiFi、UART 和业务逻辑。
- YAGNI：没有引入动态注册、证书 TLS 或额外配置系统，先满足当前设备直连接入需求。
- DRY：同步更新 `sdkconfig`、头文件备用值和 Kconfig 默认值，减少多处配置不一致。
- SOLID：当前为嵌入式配置修复，不强行套用复杂架构，保持组件边界不变。

### 问题确认情况
- 用户已提供阿里云 IoT MQTT 连接参数，且日志已确认 WiFi 正常联网，MQTT 失败集中在 broker 连接和认证配置。

### 风险评估
- 仅影响 MQTT 连接目标和认证信息。
- 如果阿里云平台侧设备密钥、实例 endpoint、时间戳签名或端口策略发生变化，需要重新生成并同步这组参数。

### 验证方式
- 运行 `idf.py build`，确认特殊字符配置可正常编译。
- 烧录后查看日志是否显示 `MQTT initialized, broker=iot-06z00dgi0u8jci8.mqtt.iothub.aliyuncs.com:1883`。
- 设备联网后应出现 `MQTT connected to broker`，阿里云物联网平台设备状态应变为在线。

## 2026-06-23 18:56:13

### 修改类型
修改

### 涉及文件
- `components/esp_mqtt/mqtt.c`
- `docs/README.md`
- `协议.md`
- `docs/协议.md`
- `修改日志/修改日志.md`

### 修改内容
- 在 ESP32 MQTT 衣柜命令处理中新增 `WARDROBE_CMD_RESET_HOME 0x12`。
- `mqtt_wardrobe_command_handler()` 支持 `{"cmd":18}`，并转发零数据 UART 帧 `A5 12 00 12 5A` 给 STM32。
- 存衣服 `cmd=16` 和取衣服 `cmd=17` 仍要求 `position=1`，复位回零 `cmd=18` 与读状态 `cmd=32` 不要求 `position`。
- 同步更新 README 和协议文档中的下行命令说明。

### 修改原因
- 用户要求通过 MQTT 发送复位回零命令，并指出 ESP32 工程也需要同步修改。
- 原 ESP32 白名单只允许 `0x10`、`0x11`、`0x20`，会把 `cmd=18` 判定为 `unsupported_cmd`。

### 问题修复类型
- 根本性修复

### 根因分析
- 根因是 ESP32 MQTT 网关端尚未暴露 STM32 已支持的 `0x12` 复位回零帧，导致 MQTT 下发 `{"cmd":18}` 无法转发到 STM32。
- 本次直接在命令白名单和协议文档中补齐 `0x12`，复用现有零数据帧构造逻辑，避免新增重复转发路径。

### 工程原则应用
- KISS：只增加一个命令常量和白名单条件，不改变 UART 帧构造流程。
- YAGNI：没有新增额外 MQTT 字段、位置参数或复杂状态管理。
- DRY：复用已有 `data_len=0` 帧生成逻辑，与读状态命令保持一致。
- SOLID：当前为嵌入式 C 网关协议入口扩展，不强行套用复杂架构。

### 问题确认情况
- 用户明确提供 `server_esp` 工程路径，并要求同步修改 MQTT 复位命令。

### 风险评估
- 影响范围限定为 ESP32 MQTT 衣柜命令白名单和文档。
- `cmd=18` 会触发 STM32 执行复位回零；存衣服、取衣服、读状态逻辑保持不变。

### 验证方式
- 编译 ESP32 工程。
- 通过 MQTT Topic `/k1vtgAzED8C/7Rzu9Cy7Ze6Yhe1YcMjQ/user/wardrobe` 发送 `{"cmd":18}`。
- ESP32 日志应显示写入 UART 帧 `A5 12 00 12 5A`。
- STM32 侧应启动 `ALL HOME RPM=60` 回零。

## 2026-06-23 20:14:32

### 修改类型
修复

### 涉及文件
- `components/esp_mqtt/mqtt.c`
- `修改日志/修改日志.md`

### 修改内容
- 将 `mqtt_init()` 中的 `s_initialized = true` 提前到 `xTaskCreate(mqtt_event_task, ...)` 之前。
- 在 MQTT 事件任务创建失败时回滚 `s_initialized = false`，避免初始化状态残留。
- MQTT 发布、UART 转发、衣柜 `cmd=18` 复位命令协议均未改动。

### 修改原因
- 现场日志出现 `Failed to send event to queue, type=6`。
- `type=6` 对应 `MQTT_EVT_PUBLISHED`，表示 MQTT 发布成功后的内部发布完成事件入队失败。

### 问题修复类型
- 根本性修复

### 根因分析
- 根因是 `mqtt_event_task()` 的循环条件依赖 `s_initialized`，但原逻辑先创建任务，后设置 `s_initialized = true`。
- FreeRTOS 任务创建后可能立即运行，此时 `s_initialized` 仍为 `false`，事件任务会直接退出，导致后续发布完成事件无人消费，队列最终塞满。
- 本次将初始化标志提前到任务创建前，保证事件任务启动时能持续消费队列。

### 工程原则应用
- KISS：只调整初始化顺序和失败回滚，不改变 MQTT 发布流程。
- YAGNI：没有扩大队列、增加延时或新增状态保护。
- DRY：继续复用原有事件队列和回调任务。
- SOLID：当前为嵌入式 C 初始化竞态修复，不强行套用复杂架构。

### 问题确认情况
- 用户提供现场日志，已确认警告发生在 MQTT 发布成功后的内部事件入队阶段。

### 风险评估
- 影响范围限定为 MQTT 事件任务启动时序。
- 修复后应减少或消除 `Failed to send event to queue, type=6`，不会改变发送到服务器的 MQTT 内容。

### 验证方式
- 编译 ESP32 工程。
- 烧录后观察启动日志，应能继续正常连接 MQTT。
- 连续收到 STM32 状态帧并发布响应时，不应再持续出现 `Failed to send event to queue, type=6`。
- 通过 MQTT 发送 `{"cmd":18}`，确认 ESP32 仍转发 `A5 12 00 12 5A`。

## 2026-07-16 22:17:29

### 修改类型
修改 / 修复

### 涉及文件
- `components/esp_mqtt/mqtt.c`

### 修改内容
- 删除STORE命令仅允许`position=1`的旧限制。
- STORE和TAKE现在统一接受`position=1..255`，并按原有1字节DATA字段原样转发给STM32。
- 二进制帧格式、CRC、成功帧和故障帧格式保持不变。

### 修改原因
- STM32放衣已经改为按第N块激光定位板生成动态X，ESP32若继续拒绝`STORE position!=1`，云端无法使用第二块及后续衣位。

### 问题修复类型
- 根本性修复。

### 根因分析
- 旧MQTT入口仍保留固定放衣点时代的单槽校验，与STM32新的动态定位契约不一致。
- 本次统一STORE/TAKE的position语义，消除跨设备接口约束冲突。

### 工程原则应用
- KISS：复用已有的1..255通用位置校验，不新增映射表。
- YAGNI：不改变协议帧和云端响应结构。
- DRY：STORE/TAKE共用同一position校验和组帧路径。
- SOLID：当前为嵌入式C协议入口修复，不强行引入额外抽象。

### 问题确认情况
- 用户明确要求云端STORE和TAKE的position都直接作为第N块定位板编号。

### 风险评估
- 旧云端`position=1`行为保持兼容；新增开放2..255，实际可用上限仍由机械行程、定位板数量和扫描超时决定。

### 验证方式
- 已使用项目现有ESP-IDF 5.3.5 CMake构建目录完成增量编译，`mqtt.c`重新编译、链接并成功生成`build/main.bin`。
- `main.bin`大小为`0xe3a00`，最小应用分区剩余`0x1c600`字节（11%）。
- 实机分别下发STORE的`position=1`和`position=2`，均应生成`A5 10 01 <position> CRC 5A`并转发到STM32，不应再返回`unsupported_position`。
