linkstwo/smart-wardrobe-iot/SmartWardrobe/修改日志/修改日志.md

## 2026-07-11 09:45:38

### 修改类型
优化 / Y 轴普通坐标运动减速

### 涉及文件
- `APP/Src/cmd_dispatch.c`
- `MDK-ARM/build_y_decel_profile.log`
- `MDK-ARM/SmartWardrobeCode/SmartWardrobeCode.hex`
- `修改日志/修改日志.md`

### 修改内容
- 为 M3/Y 轴编码器目标运动增加最后 `1200` 计数的线性减速曲线，坐标增加和坐标减小方向统一生效。
- 剩余距离大于等于 `1200` 计数时保持命令 RPM；进入减速区后从命令 RPM 线性降低到现有最低 `20 RPM` 或硬件最低 RPM。
- Y 轴短距离运动在启动前即计算曲线 RPM，避免先以最高速度运行约 20ms 再开始减速。
- 保留原有 20ms 调速周期、失速增强、反向检测、目标容差和到位急停。
- X/Z 编码器 PID、上电回零、单独 `Y_HOME`、EX_KEY3 限位和 M2 控制均未修改。

### 修改原因
- Y 轴机械传动和惯量与 X/Z 不同，原统一 PID 在较大误差时长期保持最高 RPM，最低速度又限制为 `20 RPM`，现场观察不到明显减速区。

### 问题修复类型
- 根本性修复 / 运动曲线优化

### 根因分析
- Y 轴并非缺少调速调用，而是原调速结果受统一 PID 参数和 RPM 限幅影响，减速发生得晚且最终直接急停。
- 仅修改周期调速会导致短距离动作先以最高 RPM 启动，因此启动速度和运行时速度必须使用同一距离曲线。

### 工程原则应用
- KISS：采用剩余距离线性插值，参数和现场减速距离直接对应。
- YAGNI：只调整 M3 普通编码器目标运动，不改回零和其他轴。
- DRY：启动和周期调速复用同一 `enc_move_y_profile_rpm()` 计算函数。
- SOLID：减速策略保持在编码器目标运动层，不侵入电机硬件和坐标映射模块。

### 问题确认情况
- 用户确认问题发生在普通坐标后退，并选择 Y 轴前后方向统一、距离分段减速、减速距离 `1200` 计数。

### 风险评估
- Y 轴在最后 1200 计数内运行时间会增加，需要通过实机确认 `20 RPM` 下不会因负载产生失步或失速增强。
- 无公共接口和协议变化；X/Z、回零、RS485 和云端通信无直接影响。

### 验证方式
- Keil ARM Compiler V6.24 已完成全量重编译：`0 Error(s), 0 Warning(s)`。
- 新 HEX 生成时间：`2026-07-11 09:45:14`。
- 实机分别执行 Y 轴坐标增加、坐标减小和小于 1200 计数的短距离运动，确认启动速度和减速区符合预期。
- 回归验证上电回零、EX_KEY3 回零、X/Z、M2 和取放衣完整流程。

## 2026-07-11 09:23:29

### 修改类型
修复

### 涉及文件
- `APP/Inc/rs485_abs_encoder.h`
- `APP/Inc/cmd_dispatch.h`
- `APP/Src/rs485_abs_encoder.c`
- `APP/Src/uart_console.c`
- `APP/COMMANDS.md`
- `APP/SERIAL_COMMANDS_EASY.md`
- `APP/Src/cmd_dispatch.c`
- `Src/main.c`
- `MDK-ARM/build_rs485_root_fix.log`
- `MDK-ARM/SmartWardrobeCode/SmartWardrobeCode.hex`

### 修改内容
- 将 M2 上电回零和运行监控中的阻塞式 RS485 读取改为请求、接收中断、结果轮询组成的非阻塞状态机。
- USART2 发送保留短时同步发送，发送结束后立即使用 `HAL_UARTEx_ReceiveToIdle_IT()` 接收 5/7 字节 Modbus 响应。
- M1/M3/M4 的 `ALL HOME` 启动成功并完成后，才请求 M2 上电回零。
- M2 运行期间每约 60ms提交一次角度读取；连续 3 次通信失败才急停 M2。
- 主循环每轮最多补跑 10 个 1ms tick，超出部分直接同步到真实 `HAL_GetTick()`。
- 清理未接通运行链路的旧异步函数，增加 USART2 接收事件、错误、超时和取消处理。

### 修改原因
- 原 `Rs485AbsEncoder_ReadM2()` 在 `CmdDispatch_SafetyTick1ms()` 内最多执行三次阻塞接收和延时，导致主循环积压并集中回放 1ms 任务。
- M2 与 M1/M3/M4 同时回零还会叠加机械动作、供电负载和通信时序风险。

### 问题修复类型
- 根本性修复

### 根因分析
- 问题源头是阻塞式 Modbus 事务进入 1ms 实时调度路径，而不是 USART3、ESP32 协议或 M2 编码器功能被关闭。
- 阻塞结束后的无上限 tick 补偿会把历史控制任务集中执行，表现为状态帧突发和启动流程异常。

### 工程原则应用
- KISS：保留现场验证过的同步发送时序，只将等待响应改为中断接收。
- YAGNI：仅异步化实时路径，手动编码器命令继续复用原同步接口。
- DRY：正常响应、异常响应、CRC、超时和错误统一由 RS485 驱动处理。
- SOLID：通信驱动负责 Modbus 事务，命令分发层只负责回零和运动状态。

### 问题确认情况
- 用户现场隔离验证确认：关闭 M2 上电回零后，约 1ms 一条的 11 字节状态帧连发现象消失；用户已明确确认实施根本性修复。

### 风险评估
- USART2 非阻塞接收时序仍需通过实机编码器验证；如果编码器响应快于接收中断建立，可能出现接收超时。
- 已保留发送完成后立即开启接收、80ms 超时恢复、通信重试和主循环补偿上限作为保护。

### 验证方式
- Keil ARM Compiler V6.24 全量重编译，要求 0 Error、0 Warning 并生成新 HEX。
- 已完成全量重编译：`0 Error(s), 0 Warning(s)`；HEX 生成时间为 `2026-07-11 09:25:12`。
- 实机确认 M1/M3/M4 先回零，随后 M2 回到 `RAW=1008` 附近。
- 编码器正常和断线两种情况下观察 ESP32，不得再次出现约 1ms 一条的 11 字节状态帧。
- 验证 `M2 ABS_STATUS`、`ABS_MOVE`、`ABS_ZERO` 和取放衣流程。

## 2026-07-10 22:06:37

### 修改类型
修复 / 回退不兼容的 RS485 异步实现

### 涉及文件
- `APP/Inc/rs485_abs_encoder.h`
- `APP/Src/uart_console.c`
- `APP/Src/cmd_dispatch.c`
- `修改日志/修改日志.md`

### 修改内容
- M2 上电回零和运行监控恢复调用已在现场验证可用的同步 `Rs485AbsEncoder_ReadM2()`。
- 移除 USART2 与异步 RS485 回调的运行时连接，不再由 UART 中断驱动 M2 回零状态机。
- 保留基于真实 `HAL_GetTick()` 的状态心跳节流修复。

### 修改原因
- 现场烧录后衣柜无法启动；构建结果正常，说明问题出在新增异步 USART2 收发与现场 RS485 编码器时序不兼容，而不是编译错误。

### 问题修复类型
- 分阶段修复 / 运行稳定性回退。

### 根因分析
- 原同步 Modbus 收发已在现场可用；异步改造改变了发完请求到开启接收的实际时序，M2 无法获得有效位置响应，导致上电回零链路异常。
- 状态帧突发的直接原因已由真实时间心跳节流消除，因此无需以未验证的异步时序替代现场可用的 RS485 通信。

### 工程原则应用
- KISS：恢复已验证的通信实现，只保留对 ESP32 刷帧问题必要的时间节流。
- YAGNI：暂不保留未完成现场时序验证的中断通信方案。
- DRY：继续复用已有 `Rs485AbsEncoder_ReadM2()` 读取和校验逻辑。
- SOLID：当前优先恢复稳定运行，后续异步通信需独立验证后再引入。

### 问题确认情况
- 用户已明确确认按“回退异步 RS485、保留真实时间心跳”方向修改。

### 风险评估
- M2 编码器无响应时，同步读取仍可能造成短暂主循环延迟；但状态上报不会因 tick 补偿而高频突发。
- M2 上电自动回零保持启用。

### 验证方式
- 编译并烧录 STM32 固件。
- 上电确认衣柜各轴恢复启动，M2 仍执行自动回零。
- 观察 ESP32：上电前 3 秒无主动状态帧，后续不出现约 1ms 连发。

## 2026-07-10 21:32:50

### 修改类型
根本性修复 / RS485 异步化

### 涉及文件
- `APP/Inc/rs485_abs_encoder.h`
- `APP/Src/rs485_abs_encoder.c`
- `APP/Src/uart_console.c`
- `APP/Src/cmd_dispatch.c`
- `Src/main.c`

### 修改内容
- 恢复 `M2_ABS_BOOT_HOME_ENABLE=1U`，保留 M2 上电自动回零。
- 新增 USART2 中断式异步读取接口；M2 上电回零和运行位置监控不再调用阻塞式 `HAL_UART_Receive()`。
- 为异步事务增加超时、错误、取消和结果轮询处理。
- 状态心跳改为依据真实 `HAL_GetTick()` 时间差发送，不再根据补跑的 1ms tick 次数累计。

### 修改原因
- 已通过关闭 M2 上电回零的现场隔离验证，确认阻塞 RS485 读取进入 1ms 调度路径会导致状态帧突发。

### 问题修复类型
- 根本性修复，附加防御性兜底。

### 根因分析
- 原 M2 上电回零和运行监控在 `CmdDispatch_SafetyTick1ms()` 中同步等待 RS485 响应，单次失败可阻塞数百毫秒。
- 主循环随后补跑积压 tick，导致原基于 tick 计数的状态上报在短时间内连续触发。

### 工程原则应用
- KISS：复用已启用的 USART2 中断，不新增任务系统或动态内存。
- YAGNI：仅异步化会进入 1ms 调度的 M2 位置读取，保留手动命令的同步接口。
- DRY：统一由 RS485 驱动管理异步事务状态、超时和帧校验。
- SOLID：通信驱动负责收发状态，命令分发层只负责回零和运动状态机。

### 问题确认情况
- 用户现场验证：关闭 M2 上电回零后，ESP32 的约 1ms 11 字节状态帧连发消失。
- 用户已明确同意按异步 RS485 方向实施根治。

### 风险评估
- M2 上电回零仍依赖绝对值编码器正确响应；无响应时将按原有超时策略停止回零，不阻塞主循环。
- 手动同步 M2 编码器命令若与后台异步事务重叠，会返回 `BUSY`，避免 UART2 并发访问。

### 验证方式
- 编译并烧录 STM32 固件。
- 上电后确认 M1/M3/M4 与 M2 均执行各自回零。
- 观察 ESP32 UART：静默结束后不得连续约 1ms 收到 11 字节状态帧；状态帧应按配置周期发送。
- 断开 M2 编码器或制造超时后，确认系统不中断、不刷状态帧，且输出 M2 通信故障。

## 2026-07-10 16:11:53

### 修改类型
修复 / 通信启动时序优化

### 涉及文件
- `Src/main.c`

### 修改内容
- 新增 `WARDROBE_STATUS_BOOT_MUTE_MS`，默认设置为 `3000U`。
- 新增 `g_wardrobe_status_boot_mute_done`，用于记录上电主动状态上报静默窗口是否结束。
- 在 `Wardrobe_StatusHeartbeat_Tick1ms()` 中加入上电静默判断：上电前 3000ms 不主动发送 `0xA0` 状态帧，静默结束后重新开始累计状态上报周期。

### 修改原因
- 现场反馈 STM32 上电后会主动向 ESP32 发送数据，容易在 ESP32 初始化阶段造成误判或日志干扰。
- 当前云端模式需要保留后续周期状态上报，因此不彻底关闭 `WARDROBE_BINARY_STATUS_HEARTBEAT_ENABLE`，而是只屏蔽上电初期主动上报。

### 问题修复类型
- 分阶段修复 / 防御性兜底

### 根因分析
- 当前固件开启了 `WARDROBE_BINARY_STATUS_HEARTBEAT_ENABLE=1U`，主循环每 1ms 累计状态上报计数，计满 `WARDROBE_STATUS_HEARTBEAT_MS` 后会主动发送 `0xA0` 状态帧。
- 本次修改针对“ESP32 上电初始化阶段不应被 STM32 主动状态帧打扰”的时序问题增加静默窗口。
- 如果现场收到的是非 `A5 A0 ... 5A` 的上电瞬时乱码，仍需继续检查串口 TX 上电毛刺、电源时序、共地和 ESP32 UART 接收启动时序。

### 工程原则应用
- KISS：只在现有状态上报调度入口增加启动静默窗口，不改 ESP32 协议、不改取放衣状态机。
- YAGNI：不新增握手协议或运行时配置命令，先满足当前“上电前三秒关闭主动上报”的明确需求。
- DRY：继续复用原有 `Wardrobe_StatusHeartbeat_Tick1ms()`、`Wardrobe_SendStatus()` 和 `Wardrobe_SendFrame()` 链路。
- SOLID：当前为嵌入式 C 启动时序修复，不强行套用复杂架构。

### 问题确认情况
- 已通过源码确认 STM32 当前存在主动 `0xA0` 状态上报路径。
- 用户已明确回复“确认修改”，同意按上电静默窗口方向修改。

### 风险评估
- 上电后首个主动 `0xA0` 状态帧会延后：先静默 3000ms，再重新累计一个 `WARDROBE_STATUS_HEARTBEAT_MS` 周期。
- ESP32 主动下发的命令处理不受影响；如果 ESP32 在静默期间发送 `READ_STATUS`，STM32 仍会按命令回复状态。

### 验证方式
- 重新编译并烧录 STM32。
- 上电后观察 ESP32 UART 原始日志：前 3000ms 内不应出现 STM32 主动 `A5 A0 06 ... CRC 5A` 状态帧。
- 静默结束并经过状态上报周期后，应恢复周期性 `0xA0` 状态帧。

## 2026-07-10 11:21:11

### 修改类型
修复 / 云端通信恢复

### 涉及文件
- `Src/main.c`
- `MDK-ARM/build_cloud_uart.log`
- `MDK-ARM/SmartWardrobeCode/SmartWardrobeCode.axf`
- `MDK-ARM/SmartWardrobeCode/SmartWardrobeCode.hex`
- `MDK-ARM/SmartWardrobeCode/SmartWardrobeCode.map`
- `修改日志/修改日志.md`

### 修改内容
- 将 `WARDROBE_BINARY_PROTOCOL_ENABLE` 从 `0U` 改为 `1U`，恢复 ESP32/阿里云二进制命令处理。
- 将 `WARDROBE_BINARY_STATUS_HEARTBEAT_ENABLE` 从 `0U` 改为 `1U`，每 3000 ms 主动发送一次 `0xA0` 状态帧。
- 将 `WARDROBE_TEXT_OUTPUT_ENABLE` 从 `1U` 改为 `0U`，避免 ASCII 调试文本污染与 ESP32 共用的 USART3 二进制数据流。
- 使用 Keil ARM Compiler V6.24 重新生成 AXF、HEX 和 MAP 固件产物。

### 修改原因
- 当前固件仍处于之前启用的纯 ASCII 串口调试模式，主循环会取出并丢弃 ESP32 二进制帧，且不会周期上报状态。
- 用户已恢复阿里云联调需求，需要 USART3 回到云端二进制协议运行模式。

### 问题修复类型
根本性修复

### 根因分析
- `WARDROBE_BINARY_PROTOCOL_ENABLE=0U` 导致 `UartConsole_PollFrame()` 取得的合法帧进入 discard 分支，不调用 `Wardrobe_HandleFrame()`。
- `WARDROBE_BINARY_STATUS_HEARTBEAT_ENABLE=0U` 导致状态计数器持续清零，不调用 `Wardrobe_SendStatus()`。
- `Wardrobe_SendFrame()` 在二进制协议关闭时不会向 USART3 写入任何响应字节，因此读状态、成功、故障和周期状态都无法返回 ESP32。

### 工程原则应用
- KISS：只恢复现有二进制协议和状态心跳开关，不改取放衣状态机、坐标、PID 或底层电机控制。
- YAGNI：没有新增运行时模式切换或额外协议命令。
- DRY：继续复用现有 `Wardrobe_HandleFrame()`、`Wardrobe_SendFrame()` 和 `Wardrobe_StatusHeartbeat_Tick1ms()` 链路。
- SOLID：当前为嵌入式 C 通信模式配置修复，不强行引入额外抽象。

### 问题确认情况
- 已通过源码、历史修改日志和当前 MAP 文件确认固件处于纯串口调试模式。
- 用户明确回复“继续”，同意按云端二进制协议方向修改。

### 风险评估
- USART3 普通 ASCII 文本输出被关闭，串口助手将不再看到 `OK/ERR/STAT` 文本回复。
- 上电后会每 3 秒发送一次 11 字节二进制状态帧。
- 阿里云存衣、取衣和回零命令将重新执行真实机械动作，烧录联调前必须确认运动空间安全。

### 验证方式
- `MDK-ARM/build_cloud_uart.log` 显示 `0 Error(s), 0 Warning(s)`。
- 新 MAP 文件中 `main.o` 已引用 `UartConsole_QueueBytes()`，并包含 `g_wardrobe_status_hb_ms` 状态计数器。
- 烧录后发送 `A5 20 00 20 5A`，STM32 应立即返回 `A5 A0 06 ... CRC 5A`，并每 3 秒继续上报状态帧。

## 2026-07-09 21:34:43

### 修改类型
修改 / 流程调整

### 涉及文件
- `APP/Src/cmd_dispatch.c`
- `APP/COMMANDS.md`
- `APP/SERIAL_COMMANDS_EASY.md`
- `程序介绍.md`
- `MDK-ARM/build_place_m2turn.log`
- `MDK-ARM/SmartWardrobeCode/SmartWardrobeCode.hex`
- `MDK-ARM/SmartWardrobeCode/SmartWardrobeCode.axf`

### 修改内容
- 将固件版本号更新为 `SmartWardrobe-STM32F407 v1.4.39-place-m2turn`。
- 在 `AXIS PLACE_CLOTH` 放衣流程中，Y/M3 回 `EX_KEY3` 后新增 `M2 MOVE DIR=CCW RPM=10 STEP=600`。
- 在 X/M1 到挂衣点 `X=13000` 后新增 `M2 MOVE DIR=CW RPM=10 STEP=600`。
- 放衣流程现在为：`ALL_HOME,X2250,Y3433,M5_CW10800,WAIT,Z350,X5000,Y_HOME,M2_CCW600,X13000,M2_CW600,Z2450,Y3100,M5_CCW10800,WAIT,Y_HOME,ALL_HOME`。
- 将 M2 定步转向参数抽为放衣/取衣共用常量，取衣原有 M2 顺序和步数保持不变。
- 同步更新命令文档、简易串口说明和程序介绍。

### 修改原因
- 用户明确要求在放衣第 8 步 Y/M3 退出后新增 M2 逆时针转向，并在第 9 步 X/M1 到挂衣点后新增 M2 顺时针转回。

### 问题修复类型
根本性修复

### 根因分析
- 放衣状态机原来从 Y/M3 回 `EX_KEY3` 后直接进入 X/M1 挂衣点，再进入 Z/M4 挂衣高度，没有执行现场要求的 M2 转向/转回动作。
- 本次在状态机中插入两个明确的 M2 等待步骤，确保 M2 动作完成后才进入后续轴移动，避免动作顺序被跳过或并行干扰。

### 工程原则应用
- KISS：只在放衣流程目标位置插入两段 M2 定步动作，不改变其他轴的闭环控制逻辑。
- YAGNI：没有新增额外配置命令，当前按现场固定值 `RPM=10, STEP=600` 执行。
- DRY：M2 转向参数由放衣和取衣共用常量维护，避免两套步数定义不一致。
- SOLID：当前为嵌入式 C 状态机流程调整，不强行套用复杂架构。

### 问题确认情况
- 用户已明确指定新增动作位置、方向、速度和步数。
- 需要烧录后通过 `SYS VER` 和 `AXIS PLACE_CLOTH` 启动回显确认新固件已运行。

### 风险评估
- 影响范围限定于 `AXIS PLACE_CLOTH` 放衣流程。
- 取衣流程保留原有 M2 `CCW 600`、`CW 600` 顺序，不受本次放衣流程插入动作影响。

### 验证方式
- 构建日志 `MDK-ARM/build_place_m2turn.log` 应显示 `0 Error(s), 0 Warning(s)`。
- 检查新 `axf` 中应包含 `SmartWardrobe-STM32F407 v1.4.39-place-m2turn`、`M2_CCW600,X%ld,M2_CW600,Z%ld`、`OK PLACE_CLOTH M2_MOVE M2 CCW RPM=10 STEP=600` 和 `OK PLACE_CLOTH M2_BACK M2 CW RPM=10 STEP=600`。
- 烧录后发送 `SYS VER`，应返回 `OK VER SmartWardrobe-STM32F407 v1.4.39-place-m2turn`。
- 执行 `AXIS PLACE_CLOTH`，启动回显应包含 `Y_HOME,M2_CCW600,X13000,M2_CW600,Z2450`。

## 2026-07-09 18:05:51

### 修改类型
修改 / 修复

### 涉及文件
- `APP/Src/cmd_dispatch.c`
- `APP/COMMANDS.md`
- `APP/SERIAL_COMMANDS_EASY.md`
- `程序介绍.md`
- `MDK-ARM/build_take_z300.log`
- `MDK-ARM/SmartWardrobeCode/SmartWardrobeCode.hex`
- `MDK-ARM/SmartWardrobeCode/SmartWardrobeCode.axf`
- `MDK-ARM/build_place_z350.log`
- `MDK-ARM/SmartWardrobeCode/SmartWardrobeCode.hex`
- `MDK-ARM/SmartWardrobeCode/SmartWardrobeCode.axf`

### 修改内容
- 将固件版本号更新为 `SmartWardrobe-STM32F407 v1.4.33-placez350`。
- 将放衣流程第 6 步 Z/M4 抬高目标从 `EC4=3000` 改为 `EC4=350`。
- 更新 `AXIS PLACE_CLOTH` 启动回显，从 `Z3000` 改为 `Z350`。
- 同步更新命令文档、简易串口说明和程序介绍。
- 使用 `uVision.com` 重新构建并生成新的 `SmartWardrobeCode.hex`。

### 修改原因
- 用户明确要求“放衣服的第6步改成350”。

### 问题修复类型
根本性修复

### 根因分析
- 放衣第 6 步抬高高度由 `PLACE_CLOTH_LIFT_Z` 控制，旧值为 `3000`。
- 本次按现场调试要求将该业务参数改为 `350`，并同步启动回显和文档。

### 工程原则应用
- KISS：只修改放衣抬高高度常量和相关说明，不改动状态机结构。
- YAGNI：没有新增额外配置接口。
- DRY：继续由 `PLACE_CLOTH_LIFT_Z` 统一驱动动作目标。
- SOLID：当前为嵌入式 C 参数修正，不强行套用复杂架构。

### 问题确认情况
- 用户已明确指定目标值为 `350`。
- 已确认新 `axf` 中包含 `SmartWardrobe-STM32F407 v1.4.33-placez350` 和 `Z350`。

### 风险评估
- 影响范围限定于 `AXIS PLACE_CLOTH` 放衣流程第 6 步 Z/M4 抬高目标。
- 取衣流程和放衣挂衣点 `Z=2450` 不受本次修改影响。

### 验证方式
- 构建日志 `MDK-ARM/build_place_z350.log` 显示 `0 Error(s), 0 Warning(s)`。
- 新 `hex/axf` 产物时间为 `2026/7/9 18:05:33`。
- 烧录后发送 `SYS VER`，应返回 `OK VER SmartWardrobe-STM32F407 v1.4.33-placez350`。
- 执行 `AXIS PLACE_CLOTH`，启动回显应包含 `Z350,X5000`。

## 2026-07-09 17:56:00

### 修改类型
修改 / 修复

### 涉及文件
- `APP/Src/cmd_dispatch.c`
- `APP/COMMANDS.md`
- `APP/SERIAL_COMMANDS_EASY.md`
- `程序介绍.md`
- `MDK-ARM/build_take_pick2250.log`
- `MDK-ARM/SmartWardrobeCode/SmartWardrobeCode.hex`
- `MDK-ARM/SmartWardrobeCode/SmartWardrobeCode.axf`

### 修改内容
- 将固件版本号更新为 `SmartWardrobe-STM32F407 v1.4.32-pick2250`。
- 将取衣流程中 `M2_CCW480` 后的 X/M1 目标从 `X=12700` 改为取放交换点 `X=2250`。
- 将 `TAKE_CLOTH_PICK_X` 从复用 `TAKE_CLOTH_SLOT_X` 改为复用 `PLACE_CLOTH_PICK_X`。
- 更新 `AXIS TAKE_CLOTH` 启动回显，从 `M2_CCW480,X12700,...` 改为 `M2_CCW480,X2250,...`。
- 同步更新命令文档、简易串口说明和程序介绍。
- 使用 `uVision.com` 重新构建并生成新的 `SmartWardrobeCode.hex`。

### 修改原因
- 用户确认取衣流程中 M2 转向后应回到取放交换区，X/M1 应到 `2250`，不是继续到取衣衣格点 `12700`。

### 问题修复类型
根本性修复

### 根因分析
- 旧代码中 `TAKE_CLOTH_PICK_X` 被定义为 `TAKE_CLOTH_SLOT_X`，导致取衣第 10 步仍使用衣格 X 点 `12700`。
- 实际业务流程中，`12700` 只用于进入衣格取衣；M2 转向后要回取放交换区，应使用 `PLACE_CLOTH_PICK_X=2250`。

### 工程原则应用
- KISS：直接让 `TAKE_CLOTH_PICK_X` 复用已有交换点常量，不新增重复坐标。
- YAGNI：没有引入额外配置结构。
- DRY：复用 `PLACE_CLOTH_PICK_X`，避免 `2250` 多处硬编码。
- SOLID：当前为嵌入式 C 流程参数修正，不强行套用复杂架构。

### 问题确认情况
- 用户明确指出“应该是 2250”。
- 已确认新 `axf` 中包含 `SmartWardrobe-STM32F407 v1.4.32-pick2250` 和 `M2_CCW480,X2250`。

### 风险评估
- 影响范围限定于 `AXIS TAKE_CLOTH` 中 M2 转向后的 X/M1 回交换点动作。
- 取衣进入衣格的第一段 X 仍保持 `12700`，未受本次修正影响。

### 验证方式
- 构建日志 `MDK-ARM/build_take_pick2250.log` 显示 `0 Error(s), 0 Warning(s)`。
- 新 `hex/axf` 产物时间为 `2026/7/9 17:55:38`。
- 烧录后发送 `SYS VER`，应返回 `OK VER SmartWardrobe-STM32F407 v1.4.32-pick2250`。
- 执行 `AXIS TAKE_CLOTH`，启动回显应包含 `M2_CCW480,X2250,Y3433,Z0`。

## 2026-07-09 17:36:23

### 修改类型
修改 / 修复 / 分阶段调参 / 防御性兜底

### 涉及文件
- `APP/Src/cmd_dispatch.c`
- `APP/COMMANDS.md`
- `APP/SERIAL_COMMANDS_EASY.md`
- `程序介绍.md`
- `MDK-ARM/build_take_boost.log`
- `MDK-ARM/SmartWardrobeCode/SmartWardrobeCode.hex`
- `MDK-ARM/SmartWardrobeCode/SmartWardrobeCode.axf`

### 修改内容
- 将固件版本号更新为 `SmartWardrobe-STM32F407 v1.4.31-boost`。
- 将编码器闭环无计数失速超时从 `300ms` 调整为 `1200ms`。
- 新增失速前脱困提速逻辑：编码器连续 `250ms` 无计数变化时，先将闭环输出保持到 `BOOST_RPM=45`。
- 新增 `stall_boost_active` 状态，编码器恢复计数、到位、停止流程时自动清除。
- `ERR 206 Mx_ENC_STALL` 日志新增 `BOOST=%u` 字段，便于确认最终失速前是否已经进入脱困提速。
- 新增 `ERR 206 Mx_ENC_BOOST_SPEED_FAIL`，用于识别脱困提速下发失败。
- 同步更新命令文档、简易串口说明和程序介绍。
- 使用 `uVision.com` 重新构建并生成新的 `SmartWardrobeCode.hex`。

### 修改原因
- 用户现场反馈 `ERR 206 M1_ENC_STALL CNT=12568 TARGET=12700 LAST=12568 RPM=20.23 STILL=300`，说明启用 KI/KD 后近目标段仍停留在约 `20rpm`，没有在 `300ms` 内产生 EC1 计数变化。
- 继续单纯加大 KI/KD 容易带来过冲和抖动风险；更直接的修复是将“失速判死”改为“先提速脱困，再判真正失速”。

### 问题修复类型
分阶段修复 / 防御性兜底

### 根因分析
- 近目标误差较小时，PID 输出会被 `RPM_MIN=20` 附近夹住；即使启用 KI/KD，在 `300ms` 窗口内也可能来不及把速度抬高。
- 当前日志证明问题更像低速段输出无法让 EC1 继续变化，而不是目标值本身错误。
- 本次通过 `250ms -> BOOST_RPM=45`、`1200ms -> 真失速` 的两阶段判定，让低速段先尝试脱困，同时保留最终保护。

### 工程原则应用
- KISS：在既有闭环监控链路上增加脱困状态，不重写运动控制框架。
- YAGNI：暂不加入串口在线调参命令，先满足当前现场验证。
- DRY：复用现有 PID 状态和失速日志，只增加必要的 boost 状态字段。
- SOLID：当前为嵌入式 C 控制逻辑调试，不强行套用复杂架构。

### 问题确认情况
- 已根据用户最新现场日志确认 `KI/KD` 启用后仍在 `RPM≈20` 附近触发失速。
- 已确认新 `axf` 中包含 `SmartWardrobe-STM32F407 v1.4.31-boost`、`BOOST=%u` 和 `ERR 206 M%u_ENC_BOOST_SPEED_FAIL` 字符串。

### 风险评估
- 脱困提速可能增加近目标段过冲概率；当前仍保留到位判断、方向错误保护和最终 `1200ms` 失速保护。
- 影响范围限定于 M1/M3/M4 编码器闭环目标运动链路，包括 `ENC_MOVE`、`AXIS ENC_MOVE`、`AXIS PLACE_CLOTH` 和 `AXIS TAKE_CLOTH` 的单轴闭环移动。

### 验证方式
- 构建日志 `MDK-ARM/build_take_boost.log` 显示 `0 Error(s), 0 Warning(s)`。
- 新 `hex/axf` 产物时间为 `2026/7/9 17:35:57`。
- 烧录后发送 `SYS VER`，应返回 `OK VER SmartWardrobe-STM32F407 v1.4.31-boost`。
- 再执行 `AXIS TAKE_CLOTH`；若仍报 `ERR 206`，记录 `RPM/STILL/BOOST` 判断是否已经进入脱困提速。

## 2026-07-09 17:09:30

### 修改类型
修改 / 修复 / 分阶段调参

### 涉及文件
- `APP/Src/cmd_dispatch.c`
- `APP/COMMANDS.md`
- `APP/SERIAL_COMMANDS_EASY.md`
- `程序介绍.md`
- `MDK-ARM/build_take_pid.log`
- `MDK-ARM/SmartWardrobeCode/SmartWardrobeCode.hex`
- `MDK-ARM/SmartWardrobeCode/SmartWardrobeCode.axf`

### 修改内容
- 将固件版本号更新为 `SmartWardrobe-STM32F407 v1.4.30-pid`。
- 将编码器闭环参数从 `Kp=0.04, Ki=0, Kd=0` 调整为 `Kp=0.04, Ki=0.12, Kd=0.0002`。
- 将积分限幅从 `20000.0` 收紧为 `120.0`，避免启用 KI 后积分长期饱和导致过冲。
- 保持最低闭环速度 `RPM_MIN=20` 和扩展失速日志 `CNT/TARGET/LAST/RPM/STILL`。
- 同步更新命令文档、简易串口说明和程序介绍中的 PID 参数说明。
- 使用 `uVision.com` 重新构建并生成新的 `SmartWardrobeCode.hex`。

### 修改原因
- 用户现场反馈新日志 `ERR 206 M1_ENC_STALL CNT=12214 TARGET=12700 LAST=12214 RPM=20.20 STILL=300`，说明在约 `20 RPM` 输出下，EC1 仍连续 `300ms` 无计数变化。
- 用户明确要求启用 `KI` 和 `KD`。
- 本次启用积分项用于在静止无计数阶段继续抬高速度输出；微分项小幅启用，避免对编码器噪声过度敏感。

### 问题修复类型
分阶段修复

### 根因分析
- `RPM=20.20 STILL=300` 证明问题已不是简单的 `RPM_MIN=5` 过低；在当前控制和驱动状态下，M1 接近目标时仍可能需要更强的闭环输出才能继续产生编码器变化。
- 对静止无计数场景，D 项帮助有限，因为误差不变化时微分接近 0；真正能在停住时逐步增加输出的是 I 项。
- 直接大幅提高 Kp 或取消失速保护风险较高，因此本次采用小 KD、受限 KI 的分阶段调参。

### 工程原则应用
- KISS：只调整 PID 参数和积分限幅，不重写闭环状态机。
- YAGNI：暂不加入串口在线调参命令，先满足当前现场验证。
- DRY：继续复用既有 PID 字段和失速日志，不新增重复诊断链路。
- SOLID：当前为嵌入式 C 运动参数调试，不强行套用复杂架构。

### 问题确认情况
- 用户已明确要求“把 KI 和 KD 也用上”。
- 已确认 `cmd_dispatch.c` 中参数为 `Kp=0.04, Ki=0.12, Kd=0.0002, I_LIMIT=120, RPM_MIN=20`。
- 已确认新 `axf` 中包含 `SmartWardrobe-STM32F407 v1.4.30-pid`。

### 风险评估
- 启用 KI 后接近目标时输出会更积极，可能增加过冲风险；已通过积分限幅降低风险。
- 影响范围限定于 M1/M3/M4 编码器闭环目标运动链路，包括 `ENC_MOVE`、`AXIS ENC_MOVE`、`AXIS PLACE_CLOTH` 和 `AXIS TAKE_CLOTH` 的单轴闭环移动。

### 验证方式
- 构建日志 `MDK-ARM/build_take_pid.log` 显示 `0 Error(s), 0 Warning(s)`。
- 新 `hex/axf` 产物时间为 `2026/7/9 17:09:17`。
- 烧录后发送 `SYS VER`，应返回 `OK VER SmartWardrobe-STM32F407 v1.4.30-pid`。
- 再执行 `AXIS TAKE_CLOTH`，若仍触发 `ERR 206`，继续记录 `CNT/TARGET/LAST/RPM/STILL` 判断是否需要提高 `RPM_MIN`、延长失速判定或检查 EC1 计数链路。

## 2026-07-09 16:57:30

### 修改类型
修改 / 修复 / 防御性诊断增强

### 涉及文件
- `APP/Src/cmd_dispatch.c`
- `APP/COMMANDS.md`
- `APP/SERIAL_COMMANDS_EASY.md`
- `程序介绍.md`
- `MDK-ARM/build_take_pmin20.log`
- `MDK-ARM/SmartWardrobeCode/SmartWardrobeCode.hex`
- `MDK-ARM/SmartWardrobeCode/SmartWardrobeCode.axf`

### 修改内容
- 将固件版本号更新为 `SmartWardrobe-STM32F407 v1.4.29-pmin20`。
- 将编码器闭环目标运动的最低 PID 输出速度从 `5.0 RPM` 提高到 `20.0 RPM`。
- 保持 `Kp=0.04, Ki=0, Kd=0`，暂不启用积分和微分项，避免未经实机滤波验证就引入积分饱和或微分噪声。
- 将 `ERR 206 Mx_ENC_STALL` 日志扩展为输出 `CNT/TARGET/LAST/RPM/STILL`，便于判断失速时的当前计数、目标计数、最近变化计数、闭环输出速度和无计数变化时长。
- 将失速检测局部日志缓冲区从 `96` 字节扩大到 `128` 字节，避免新增字段被截断。
- 同步更新串口命令文档和程序介绍中的 PID 调试说明。
- 使用 `uVision.com` 重新构建固件，生成新的 `SmartWardrobeCode.hex`。

### 修改原因
- 用户现场反馈 `ERR 206 M1_ENC_STALL CNT=12219 TARGET=12700`，并确认机械无明显阻力，同时询问 PID 是否只写了 P。
- 经源码确认当前确实为 `Ki=0, Kd=0` 的 P 控制；接近目标时若闭环输出速度过低或编码器 300ms 内无跳变，会触发 `ENC_STALL`。
- 本次先提高最低闭环速度并增强失速日志，以区分低速输出不足、编码器计数链路异常和失速判定过紧等不同原因。

### 问题修复类型
分阶段修复 / 防御性兜底

### 根因分析
- 已确认当前 PID 结构中虽然包含 I/D 计算，但默认参数 `Ki=0, Kd=0`，所以实际控制输出为 `Kp * error`。
- 当前报错的直接触发条件不是“目标还差 481 count”，而是运动过程中 `ENC_MOVE_STALL_TIMEOUT_MS=300` 内编码器计数没有变化。
- 本次没有直接启用 KI/KD，因为积分项可能造成过冲，微分项可能放大编码器抖动；更稳妥的第一阶段是提高最低输出速度并增加可诊断日志。

### 工程原则应用
- KISS：只调整闭环最低速度和失速日志，不重构运动控制链路。
- YAGNI：暂不加入运行时 PID 配置命令，先满足当前实机定位需求。
- DRY：继续复用现有 `EncMove_t` 中的 PID 状态字段，不新增重复状态。
- SOLID：当前为嵌入式 C 调参和诊断增强，不强行套用复杂架构。

### 问题确认情况
- 用户已确认按该方向修改。
- 已确认源码中 `ENC_MOVE_PID_KI_DEFAULT=0.0f`、`ENC_MOVE_PID_KD_DEFAULT=0.0f`。
- 已确认新 `axf` 中包含 `SmartWardrobe-STM32F407 v1.4.29-pmin20` 和扩展后的 `ERR 206 M%u_ENC_STALL ... LAST ... RPM ... STILL` 字符串。

### 风险评估
- 影响范围限定于 M1/M3/M4 编码器闭环目标运动链路，包括 `ENC_MOVE`、`AXIS ENC_MOVE`、`AXIS PLACE_CLOTH` 和 `AXIS TAKE_CLOTH` 中的单轴闭环移动。
- 最低闭环速度提高后，接近目标时冲过目标的概率可能上升；当前仍有到位容差和方向/失速保护，需要通过实机日志继续观察。

### 验证方式
- 构建日志 `MDK-ARM/build_take_pmin20.log` 显示 `0 Error(s), 0 Warning(s)`。
- 新 `hex/axf` 产物时间为 `2026/7/9 16:57:06`。
- 烧录后发送 `SYS VER`，应返回 `OK VER SmartWardrobe-STM32F407 v1.4.29-pmin20`。
- 再执行 `AXIS TAKE_CLOTH`，若仍触发 `ERR 206`，应记录新增的 `LAST/RPM/STILL` 字段继续判断。

## 2026-07-09 16:35:40

### 修改类型
修改 / 修复

### 涉及文件
- `APP/Src/cmd_dispatch.c`
- `APP/COMMANDS.md`
- `APP/SERIAL_COMMANDS_EASY.md`
- `程序介绍.md`

### 修改内容
- 将取衣专用 X 目标从 `TAKE_CLOTH_SLOT_X=12500` 调整为 `TAKE_CLOTH_SLOT_X=12700`。
- `TAKE_CLOTH_PICK_X` 继续复用 `TAKE_CLOTH_SLOT_X`，因此取衣进入衣格 X 和后续取衣流程 X 目标同步为 `12700`。
- 将固件版本号更新为 `SmartWardrobe-STM32F407 v1.4.28-x12700`。
- 同步更新取衣启动回显和说明文档中的取衣 X 目标。

### 修改原因
- 用户现场反馈 `ERR 206 M1_ENC_STALL CNT=12047 TARGET=12500` 和 `ERR 203 TAKE_CLOTH_SLOT_X_NOT_REACHED`，并明确要求把目标改为 `X=12700`。
- 当前需要继续按实机反馈调整取衣 X 调试目标。

### 问题修复类型
分阶段修复

### 根因分析
- 从代码逻辑看，M1/X 是编码器闭环目标运动，不是固定步数后停止；如果编码器 300ms 没有变化，会触发 `M1_ENC_STALL`。
- 本次将目标调到 `12700` 是按现场需求继续校准目标点；若后续仍在相近位置报 `ENC_STALL`，应继续检查 M1 机械阻力、电机驱动、联轴器/同步带以及 EC1 编码器计数链路。

### 工程原则应用
- KISS：只调整取衣 X 调试目标和版本标记，不改动底层闭环算法。
- YAGNI：没有引入额外坐标配置结构。
- DRY：继续让 `TAKE_CLOTH_PICK_X` 复用 `TAKE_CLOTH_SLOT_X`，避免同一取衣 X 目标分散维护。
- SOLID：当前为嵌入式 C 参数调整，不强行套用复杂架构。

### 问题确认情况
- 用户已明确指定目标改为 `X=12700`。
- 已复查源码确认 M1/X 到位判断使用 `cloth_axis_wait_done()` 和编码器计数容差；失速判断来自 `CmdDispatch_SafetyTick1ms()` 中的 `ENC_MOVE_STALL_TIMEOUT_MS=300`。

### 风险评估
- 影响范围限定为 `AXIS TAKE_CLOTH` 取衣流程的 X/M1 取衣目标及相关回显/说明文档。
- 若 `12700` 超过当前机械可达范围或仍存在卡滞，取衣流程仍会报 `M1_ENC_STALL`。

### 验证方式
- 重新构建工程并烧录新 hex。
- 烧录后发送 `SYS VER`，应返回 `SmartWardrobe-STM32F407 v1.4.28-x12700`。
- 执行取衣流程，`SLOT_X` 日志应显示 `TARGET=12700`。

## 2026-07-09 16:24:07

### 修改类型
修改 / 修复

### 涉及文件
- `APP/Src/cmd_dispatch.c`
- `MDK-ARM/SmartWardrobeCode/SmartWardrobeCode.hex`
- `MDK-ARM/SmartWardrobeCode/SmartWardrobeCode.axf`
- `MDK-ARM/SmartWardrobeCode/cmd_dispatch.o`
- `MDK-ARM/build_take_x12500.log`

### 修改内容
- 将固件版本号从 `SmartWardrobe-STM32F407 v1.4.26` 更新为 `SmartWardrobe-STM32F407 v1.4.27-x12500`，用于现场确认是否烧录了包含 X=12500 修复的新固件。
- 使用 Keil UV4 重新构建工程并生成新的 `SmartWardrobeCode.hex`。
- 构建日志显示 `0 Error(s), 0 Warning(s)`。

### 修改原因
- 用户现场串口仍显示 `OK TAKE_CLOTH SLOT_X M1 CNT=0 TARGET=13000 START`，与当前源码中的 `TAKE_CLOTH_SLOT_X=12500` 不一致。
- 经核对发现旧构建产物时间戳为 15:51，早于 16:02 的源码修改时间，说明现场很可能烧录了旧 hex。

### 问题修复类型
根本性修复

### 根因分析
- 根因不是当前源码仍为 13000，而是构建产物未更新或现场烧录了旧固件。
- 本次通过版本号标记和重新构建，确保后续可用 `SYS VER` 区分新旧固件。

### 工程原则应用
- KISS：只更新版本标记并重新构建，不引入额外诊断协议。
- YAGNI：没有修改无关运动逻辑。
- DRY：继续以 `CMD_VERSION_TEXT` 作为固件版本唯一回显来源。
- SOLID：当前为嵌入式 C 构建与版本标记调整，不强行套用复杂架构。

### 问题确认情况
- 已确认源码中取衣 `SLOT_X` 目标为 `TAKE_CLOTH_SLOT_X=12500`。
- 已确认旧 `SmartWardrobeCode.axf` 中版本仍为 `v1.4.26`，新构建后的 `axf` 中版本为 `v1.4.27-x12500`。

### 风险评估
- 运行逻辑风险来自上一条 X=12500 改动；本次版本号和重新构建本身无额外机械动作风险。
- 必须烧录新生成的 `SmartWardrobeCode.hex`，否则现场仍会运行旧目标 `13000`。

### 验证方式
- 构建命令生成日志 `MDK-ARM/build_take_x12500.log`，结果为 `0 Error(s), 0 Warning(s)`。
- 烧录后发送 `SYS VER`，应返回 `SmartWardrobe-STM32F407 v1.4.27-x12500`。
- 再执行取衣流程，`SLOT_X` 日志应显示 `TARGET=12500`，不是 `TARGET=13000`。

## 2026-07-09 16:00:48

### 修改类型
修改 / 修复

### 涉及文件
- `APP/Src/cmd_dispatch.c`
- `APP/COMMANDS.md`
- `APP/SERIAL_COMMANDS_EASY.md`
- `程序介绍.md`

### 修改内容
- 新增取衣专用衣格 X 坐标常量 `TAKE_CLOTH_SLOT_X=12500`。
- 将 `AXIS TAKE_CLOTH` 启动时的 `g_take_cloth.slot_x` 从衣格配置表的放衣挂衣 X 坐标改为 `TAKE_CLOTH_SLOT_X`。
- 将 `TAKE_CLOTH_PICK_X` 改为复用 `TAKE_CLOTH_SLOT_X`，确保取衣进衣格 X 和后续取衣流程 X 目标都保持为 `12500`。
- 同步更新取衣启动回显和说明文档，将取衣第一步 X 从 `13000` 改为 `12500`，并明确放衣挂衣点仍为 `13000`。

### 修改原因
- 用户反馈 `ERR 206 M1_ENC_STALL CNT=12507 TARGET=13000` 和 `ERR 203 TAKE_CLOTH_SLOT_X_NOT_REACHED`，并明确要求“调回目标跟计数一样的 12500”。
- 当前现场 M1/X 已接近 `12500`，但取衣第一步仍以 `13000` 为目标，导致继续向 13000 运动并触发卡滞保护。

### 问题修复类型
根本性修复

### 根因分析
- 根因是取衣流程的 `SLOT_X` 直接复用衣格配置表 `g_cloth_slot_cfg[]` 中的放衣挂衣 X 坐标 `PLACE_CLOTH_HANG_X=13000`。
- 现场取衣进入衣格需要使用 `12500`，放衣挂衣仍需要 `13000`，两个业务坐标不应共用同一个 X 值。

### 工程原则应用
- KISS：只新增取衣专用 X 常量并替换取衣启动赋值，不重构槽位配置表。
- YAGNI：没有新增多槽位配置结构或运行时参数，先满足当前 1 号位实机路径。
- DRY：`TAKE_CLOTH_PICK_X` 复用 `TAKE_CLOTH_SLOT_X`，避免两个 12500 分散维护。
- SOLID：当前为嵌入式 C 状态机参数边界调整，不强行套用复杂架构。

### 问题确认情况
- 用户已明确指定目标改为 `12500`。
- 已根据源码确认取衣 `SLOT_X` 来自 `g_take_cloth.slot_x`，旧赋值为 `slot_cfg->x`，即当前 1 号位配置中的 `PLACE_CLOTH_HANG_X=13000`。

### 风险评估
- 影响范围限定为 `AXIS TAKE_CLOTH` 取衣流程的第一段 X/M1 目标和相关回显/说明文档。
- 放衣流程仍使用 `PLACE_CLOTH_HANG_X=13000`，不受本次改动影响。

### 验证方式
- 静态核对取衣启动回显应显示 `SEQ=ALL_HOME,X12500,Z2450,Y3100,...`。
- 烧录后空载低速执行 `AXIS TAKE_CLOTH RPM=35 TOL=6`，串口应出现 `OK TAKE_CLOTH SLOT_X M1 ... TARGET=12500 ...`，不应再出现 `TAKE_CLOTH_SLOT_X_NOT_REACHED` 目标 13000。

## 2026-07-09 15:40:40

### 修改类型
修改 / 修复

### 涉及文件
- `APP/Src/cmd_dispatch.c`
- `APP/COMMANDS.md`
- `APP/SERIAL_COMMANDS_EASY.md`
- `程序介绍.md`

### 修改内容
- 将 `AXIS TAKE_CLOTH` 取衣流程第 8 步从 Y/M3 到固定编码器位置 `EC3=500` 改为 Y/M3 回 `EX_KEY3` 行程开关位置。
- `TAKE_CLOTH_MOVE_TRANSFER_Y` 改为启动 `take_cloth_start_y_home()`，并在 `TAKE_CLOTH_MOVE_M2` 中等待 `take_cloth_y_home_wait_done()` 完成后再执行 `M2_CCW480`。
- 将 `EX_KEY3` 触发完成标志接入 `TAKE_CLOTH_MOVE_M2` 等待状态，避免行程开关瞬时触发后状态机漏掉完成事件。
- 更新取衣启动回显和说明文档，将流程显示为 `...,Z2936,Y_HOME,M2_CCW480,X12500,...`。

### 修改原因
- 用户明确要求“取衣服的第 8 步 Y 转移退出：Y=500 改成退到行程开关的位置上”。
- 现场报错显示 M3/Y 在退到 `Y=500` 前发生卡滞，固定中转点不符合当前机械退出路径要求。

### 问题修复类型
根本性修复

### 根因分析
- 根因是取衣流程抓取并抬升后，Y 轴退出动作仍依赖固定编码器目标 `EC3=500`；现场机械路径实际要求退到 `EX_KEY3` 行程开关位置，再继续 M2 转向和后续取衣点动作。
- 本次直接将状态机的完成条件改为行程开关触发，而不是继续调大容差或延长等待时间。

### 工程原则应用
- KISS：只替换取衣流程中第 8 步的执行和等待条件，不重构整套状态机。
- YAGNI：没有新增额外可配置参数或复杂路径规划。
- DRY：复用已有 `take_cloth_start_y_home()`、`take_cloth_y_home_wait_done()` 和 EX_KEY3 限位守护机制。
- SOLID：当前为嵌入式 C 状态机小范围调整，不强行套用复杂架构。

### 问题确认情况
- 用户已明确指定修改目标。
- 已根据源码确认旧流程在 `TAKE_CLOTH_MOVE_TRANSFER_Y` 中启动 `MOTOR_ID_3` 到 `TAKE_CLOTH_TRANSFER_Y=500`，并在 `TAKE_CLOTH_MOVE_M2` 中等待该目标到位。

### 风险评估
- 影响范围限定为 `AXIS TAKE_CLOTH` 取衣流程抓取抬升后的 Y 轴退出步骤，以及相关回显/说明文档。
- 如果 EX_KEY3 行程开关接线、低电平触发或机械位置异常，取衣流程会在 `TAKE_CLOTH_TRANSFER_Y_HOME_NOT_REACHED` 处失败。

### 验证方式
- 编译工程，确认 `APP/Src/cmd_dispatch.c` 无语法错误。
- 空载低速执行 `AXIS TAKE_CLOTH RPM=35 TOL=6`，启动回显应包含 `...,Z2936,Y_HOME,M2_CCW480,X12500,...`。
- 观察串口应先出现 `OK TAKE_CLOTH TRANSFER_Y_HOME START`，触发 EX_KEY3 后出现 `OK TAKE_CLOTH TRANSFER_Y_HOME DONE`，然后才执行 `OK TAKE_CLOTH M2_MOVE M2 CCW RPM=10 STEP=480`。

## 2026-07-09 11:51:31

### 修改类型
修复

### 涉及文件
- `APP/Src/cmd_dispatch.c`

### 修改内容
- 补全取衣状态机中的 `TAKE_CLOTH_MOVE_M2` 实际执行步骤。
- 将流程从 `Y=500` 后进入 `TAKE_CLOTH_MOVE_M2`，执行 `M2 MOVE DIR=CCW RPM=10 STEP=480`，等待 M2 定步动作完成后再进入 `X=12500`。

### 修改原因
- 前一轮已加入 M2 常量、辅助函数和串口回显，但复查发现状态机枚举与 case 分支未真正插入完整 M2 步骤；若不修复，流程回显会显示 M2，但运行时不会执行该 M2 动作。

### 问题修复类型
根本性修复

### 根因分析
- 根因是状态机路径缺少 `TAKE_CLOTH_MOVE_M2` 中间状态，导致新增需求没有接入真实运行路径。

### 工程原则应用
- KISS：只补齐缺失状态和等待逻辑，不重构取衣流程。
- YAGNI：没有添加额外配置项或复杂调度。
- DRY：复用现有 `MotorCtrl_MoveSteps`、忙碌检测和失败处理机制。
- SOLID：当前为嵌入式 C 状态机小改动，不强行套用复杂架构。

### 问题确认情况
- 已通过代码复查确认原状态机中没有 `TAKE_CLOTH_MOVE_M2` case，属于确定问题。

### 风险评估
- 影响取衣流程中 `Y=500` 到 `X=12500` 之间的动作顺序；放衣流程不受影响。

### 验证方式
- 使用 `Select-String` 核对枚举和状态机 case。
- 使用 `armclang -fsyntax-only` 对 `APP/Src/cmd_dispatch.c` 做语法检查。
## 2026-07-09 11:41:41

### 修改类型
修改

### 涉及文件
- `APP/Src/cmd_dispatch.c`
- `APP/COMMANDS.md`

### 修改内容
- 在 `AXIS TAKE_CLOTH` 取衣流程中，于 Y/M3 到中转位置 `EC3=500` 之后新增 M2 定步动作：`M2 MOVE DIR=CCW RPM=10 STEP=480`。
- 新增取衣状态 `TAKE_CLOTH_MOVE_M2`，等待 Y=500 到位后启动 M2；M2 定步动作完成后再进入 X/M1 到 `EC1=12500`。
- 新增 M2 取衣动作参数常量 `TAKE_CLOTH_M2_RPM=10.0f`、`TAKE_CLOTH_M2_STEPS=480U`。
- 将取衣启动回显 `SEQ` 更新为包含 `M2_CCW480`。
- 将固件版本号更新为 `SmartWardrobe-STM32F407 v1.4.26`。
- 同步更新命令说明文档中的取衣步骤。

### 修改原因
- 用户要求在取衣步骤 8 之后增加 `M2 MOVE DIR=CCW RPM=10 STEP=480`，实际插入位置为 Y/M3 到 `EC3=500` 后、X/M1 到 `EC1=12500` 前。

### 问题修复类型
根本性修复

### 根因分析
- 原 `AXIS TAKE_CLOTH` 状态机在 `Y500` 后直接进入 `X12500`，缺少用户实机调试所需的 M2 旋转定步动作。
- 本次在状态机中加入独立 M2 步骤，并等待该动作完成后再继续后续 X/Y/Z 动作，避免仅在回显中假装执行或让动作并发造成时序不确定。

### 工程原则应用
- KISS：只新增一个状态和两个常量，复用现有 `MotorCtrl_MoveSteps()` 与电机状态查询逻辑。
- YAGNI：没有新增复杂参数系统，固定实现用户明确指定的 M2 方向、速度和步数。
- DRY：复用已有电机忙碌判断和定步运动接口，避免复制底层运动控制逻辑。
- SOLID：保持状态机步骤职责清晰，M2 动作作为独立步骤插入，不破坏原有轴运动函数职责。

### 问题确认情况
- 用户已明确要求“8之后加一个M2 MOVE DIR=CCW RPM=10 STEP=480”。
- 已确认当前取衣步骤中第 8 步为 `X=12500`，因此按用户意图把新增 M2 动作插在 `Y=500` 后、`X=12500` 前。

### 风险评估
- 影响范围限定为 `AXIS TAKE_CLOTH` 取衣流程及其回显/文档。
- 新增 M2 定步动作会延长取衣流程时间；如果 M2 正在执行其他动作，取衣流程会报 `TAKE_CLOTH_M2_MOVE_FAIL` 并中止。

### 验证方式
- 使用 `armclang -fsyntax-only` 对 `APP/Src/cmd_dispatch.c` 做语法检查。
- 烧录后发送 `VER`，应返回 `SmartWardrobe-STM32F407 v1.4.26`。
- 空载执行 `AXIS TAKE_CLOTH RPM=35 TOL=6`，启动回显应包含 `...,Z2936,Y500,M2_CCW480,X12500,Y3433,Z0,...`。
- 串口运行日志应在 `TRANSFER_Y` 到位后出现 `OK TAKE_CLOTH M2_MOVE M2 CCW RPM=10 STEP=480`，然后才出现 `PICK_X ... TARGET=12500`。
## 2026-07-09 11:18:40

### 修改类型
修改

### 涉及文件
- `APP/Src/cmd_dispatch.c`
- `APP/COMMANDS.md`

### 修改内容
- 将 `AXIS TAKE_CLOTH` 取衣流程中 `PICK_X` 的 M1/X 轴目标从复用 `PLACE_CLOTH_PICK_X=2250` 调整为独立常量 `TAKE_CLOTH_PICK_X=12500`。
- 同步更新取衣启动回显 `SEQ`，将取衣后段目标显示为 `X12500`。
- 将固件版本号更新为 `SmartWardrobe-STM32F407 v1.4.25`。
- 同步更新命令说明文档中的取衣流程 X 目标。

### 修改原因
- 用户要求将取衣服 X 轴目标步数改为 `12500`，且该变化只应影响 `AXIS TAKE_CLOTH`，不应连带改变 `AXIS PLACE_CLOTH` 的取衣点 `2250`。

### 问题修复类型
根本性修复

### 根因分析
- 原取衣流程后段 `TAKE_CLOTH_MOVE_PICK_X` 直接复用 `PLACE_CLOTH_PICK_X=2250`，导致放衣取衣点和取衣流程回到交换区的 X 目标耦合。
- 本次新增取衣专用常量 `TAKE_CLOTH_PICK_X`，让取衣流程的 X 目标可独立调试，避免修改取衣参数时误影响放衣流程。

### 工程原则应用
- KISS：只新增一个取衣专用坐标常量并替换取衣状态机中的对应引用，不重构状态机。
- YAGNI：没有新增配置存储或动态参数系统，只满足当前明确的 `12500` 调试目标。
- DRY：保留公共默认速度/容差复用，同时拆开已经产生差异的 X 目标，避免错误复用。
- SOLID：当前为 C 状态机参数调整，不强行套用复杂架构；保持取衣/放衣职责边界更清晰。

### 问题确认情况
- 用户已明确要求“取衣服X轴的目标步数改成12500”。
- 已确认代码中取衣后段 X 目标原先复用 `PLACE_CLOTH_PICK_X=2250`，本次按用户目标改为取衣专用 `12500`。

### 风险评估
- 影响范围限定为 `AXIS TAKE_CLOTH` 后段 `PICK_X` 目标和相关串口回显/文档。
- `AXIS PLACE_CLOTH` 仍使用 `PLACE_CLOTH_PICK_X=2250`，无意外连带修改。

### 验证方式
- 使用 `armclang -fsyntax-only` 对 `APP/Src/cmd_dispatch.c` 做语法检查。
- 烧录后发送 `VER`，应返回 `SmartWardrobe-STM32F407 v1.4.25`。
- 空载执行 `AXIS TAKE_CLOTH RPM=35 TOL=6`，启动回显应包含 `...,Z2936,Y500,X12500,Y3433,Z0,...`，运行日志应出现 `OK TAKE_CLOTH PICK_X M1 ... TARGET=12500 ...`。
# 修改日志

## 2026-07-07 09:27:21

### 修改类型
修改

### 涉及文件
- `Src/main.c`
- `修改日志/修改日志.md`

### 修改内容
- 新增上电自动 `ALL HOME` 参数：`WARDROBE_BOOT_HOME_ENABLE`、`WARDROBE_BOOT_HOME_DELAY_MS`、`WARDROBE_BOOT_HOME_RETRY_PERIOD_MS`。
- 新增 `g_wardrobe_boot_home_pending`、`g_wardrobe_boot_home_ms`、`g_wardrobe_boot_home_last_try_ms`，用于记录上电自动回零启动状态。
- 新增 `Wardrobe_BootHome_Tick1ms()`，上电延时 2 秒后自动触发一次 `ALL HOME`。
- 将 `Wardrobe_BootHome_Tick1ms()` 接入主循环 1ms 调度。
- 如果延时期间云端取衣、放衣或回零命令已经成功启动，则取消本次上电自动回零，避免重复触发机械动作。

### 修改原因
- 用户确认需要设备上电后延时 2 秒自动执行一次 `ALL HOME`。
- 取衣服和放衣服流程仍保留前置 `ALL HOME`，但设备上电后先建立机械零点，可减少后续云端指令第一次动作前的等待感。

### 问题修复类型
- 分阶段修复

### 根因分析
- 现场不希望通过阿里云连续下发两次取衣或放衣命令来达到“先归零再动作”的效果。
- 根本方向是设备启动阶段主动建立机械基准，而不是要求云端或用户承担预回零步骤。
- 本次只增加上电自动回零，不取消取/放衣流程内部的前置回零；这样可以降低坐标漂移、断电后手动移动、编码器状态不一致带来的机械风险。

### 工程原则应用
- KISS：复用现有 `CmdDispatch_Execute()` 和 `CMD_ACTION_REV_EXKEY` 的 `ALL HOME` 能力，没有重写回零控制逻辑。
- YAGNI：没有新增云端协议、配置界面或持久化开关，只实现用户确认的上电延时自动回零。
- DRY：上电自动回零复用已有云端回零命令的 ParsedCmd 路径，避免复制 M1/M3/M4 回零细节。
- SOLID：当前为嵌入式 C 主循环调度，新增函数只负责上电自动回零启动，保持职责边界清晰。

### 问题确认情况
- 用户已明确回复“确认修改”，并指定方案为“上电延时 2 秒后自动执行一次 ALL HOME；取/放衣流程仍保留前置 ALL HOME”。

### 风险评估
- 上电后设备会自动驱动 M1/M3/M4 向回零限位方向运动，属于机械动作风险；现场首次测试必须空载、低风险环境，并保持急停可用。
- 不改变取/放衣坐标、夹爪步数、云端帧协议和最终回零逻辑。
- 如果上电 2 秒内用户已经下发取/放衣或回零命令，自动回零会被取消，避免重复动作。

### 验证方式
- 编译 Keil 工程，确认 `Src/main.c` 与 `APP/Src/cmd_dispatch.c` 无语法错误。
- 烧录后上电等待约 2 秒，观察 M1/M3/M4 应自动执行 `ALL HOME`。
- 串口日志应出现 `OK BOOT ALL_HOME START`，随后应出现各轴 `HOME_EX*_DONE` 和 `OK ALL HOME_ZERO_DONE EC=1,3,4 AXIS=XYZ`。
- 上电自动回零完成后，再从阿里云下发一次取衣或放衣命令，确认仍能按原流程执行，且不需要用户手动先按回零。

## 2026-07-07 08:55:42

### 修改类型
修复

### 涉及文件
- `APP/Src/cmd_dispatch.c`
- `修改日志/修改日志.md`

### 修改内容
- 新增 `cloth_continue_after_start_home()`，统一处理取衣服和放衣服流程在前置 `ALL_HOME` 完成后的状态推进。
- 将 `all_home_mark_done()` 中原本只识别 `WAIT_START_HOME` 的分散判断，改为统一调用前置回零完成推进函数。
- 前置回零完成时同时兼容 `START_HOME` 和 `WAIT_START_HOME` 状态，避免云端一次取衣服/放衣服指令只触发回零、不继续后续动作。

### 修改原因
- 用户反馈阿里云取衣服或放衣服需要按两次，第一次设备只回到零点，第二次才启动实际取衣服或放衣服流程。
- 当前流程设计上本来应当“一次指令 = 前置回零 + 后续取/放衣完整流程”，不应依赖用户再次下发相同指令。

### 问题修复类型
- 根本性修复

### 根因分析
- 取衣服和放衣服状态机启动后都会先执行前置 `ALL_HOME`，回零完成后依赖 `all_home_mark_done()` 推进到后续取/放衣步骤。
- 原推进逻辑只在状态严格等于 `PLACE_CLOTH_WAIT_START_HOME` 或 `TAKE_CLOTH_WAIT_START_HOME` 时继续，状态边界不够稳健。
- 本次把前置回零完成后的继续动作集中处理，并兼容 `START_HOME` 与 `WAIT_START_HOME`，让同一条云端指令在回零完成后可靠进入后续取/放衣动作。
- 两层忙碌判断本身用于防止任务重入和运动冲突，不直接删除；删除会增加重复命令打断机械动作的风险。

### 工程原则应用
- KISS：只补齐前置回零完成后的状态推进，不重写取放衣状态机、不改坐标和夹爪参数。
- YAGNI：没有新增云端协议、队列系统或额外模式开关，只解决当前一次指令不能可靠继续的问题。
- DRY：将放衣和取衣的前置回零完成推进集中到一个函数，避免两套判断分散维护。
- SOLID：当前为嵌入式 C 状态机，保持单一职责；新增函数只负责“前置回零完成后继续业务流程”，不混入运动控制细节。

### 问题确认情况
- 用户已明确确认修改，目标是阿里云一次取衣服或放衣服指令即可启动完整流程。
- 根据源码确认取放衣流程确实以前置 `ALL_HOME` 为第一步，本次修复针对回零完成后的状态推进可靠性。

### 风险评估
- 影响范围集中在 `AXIS PLACE_CLOTH` 和 `AXIS TAKE_CLOTH` 的前置回零完成衔接。
- 不改变最终回零、坐标、速度、容差、夹爪步数和云端帧协议。
- 无明显高风险；现场仍需低速空载验证，确认一次云端指令回零后会继续执行后续动作。

### 验证方式
- 编译 Keil 工程，确认 `APP/Src/cmd_dispatch.c` 无语法错误。
- 阿里云下发一次 `{"cmd":16,"position":1}`，观察设备应先 `ALL_HOME`，随后自动进入 `PLACE_CLOTH` 后续动作，不需要第二次点击。
- 阿里云下发一次 `{"cmd":17,"position":1}` 或现场使用的 `position=5`，观察设备应先 `ALL_HOME`，随后自动进入 `TAKE_CLOTH` 后续动作，不需要第二次点击。
- 串口日志中 `OK ALL HOME_ZERO_DONE EC=1,3,4 AXIS=XYZ` 后应继续出现取衣 `SLOT_X` 或放衣 `PICK_X` 相关动作日志。

## 2026-07-03 21:09:12

### 修改类型
修改

### 涉及文件
- `APP/Src/cmd_dispatch.c`
- `APP/COMMANDS.md`
- `APP/SERIAL_COMMANDS_EASY.md`
- `程序介绍.md`
- `MDK-ARM/SmartWardrobeCode/SmartWardrobeCode.build_log.htm`
- `MDK-ARM/SmartWardrobeCode/SmartWardrobeCode.axf`
- `MDK-ARM/SmartWardrobeCode/SmartWardrobeCode.hex`
- `修改日志/修改日志.md`

### 修改内容
- 在放衣服 `AXIS PLACE_CLOTH` 流程中，加入夹爪夹紧并等待 2 秒后，先让 Z/M4 移动到 `EC4=3000` 的步骤。
- 将后续原有流程保持为：X 到 `5000`，Y 回 `EX_KEY3`，再进入挂衣点动作。
- 同步更新串口返回 `SEQ` 和项目文档中的放衣流程说明。
- 顺带将文档中的 1 号衣服位 Z 坐标同步为当前源码实际值 `2450`。

### 修改原因
- 用户要求放衣夹紧等待后先抬高 Z 轴到 3000，再执行后续步骤。

### 问题修复类型
- 不适用

### 根因分析
- 本次不是故障修复，而是业务流程调整。
- 原流程在夹爪夹紧等待后直接移动 X 到过渡位置；新需求要求先抬高 Z 轴，减少后续横向移动前的机械干涉风险。

### 工程原则应用
- KISS：只在放衣状态机中插入必要状态，未改动取衣流程和无关电机控制逻辑。
- YAGNI：未新增未要求的点位、参数配置界面或额外动作。
- DRY：复用现有 `place_cloth_start_axis_move()` 和 `cloth_axis_wait_done()`，不复制底层运动控制逻辑。
- SOLID：当前为嵌入式 C 状态机改动，不强行套用复杂架构；保持单一流程状态职责清晰。

### 问题确认情况
- 用户明确要求修改放衣流程，目标步骤和坐标已明确为 Z 轴移动到 3000。

### 风险评估
- 影响范围集中在 `AXIS PLACE_CLOTH` 放衣流程；`AXIS TAKE_CLOTH` 不受行为影响。
- 若现场 Z 轴 `3000` 超出机械安全范围或限位配置，会触发原有到位/故障处理，需要按实际机械行程确认。

### 验证方式
- 编译 Keil 工程，确认 `cmd_dispatch.c` 无语法错误。
- 串口发送 `AXIS PLACE_CLOTH`，确认返回 `SEQ` 包含 `...,M5_CW10800,WAIT,Z3000,X5000,...`。
- 实机低速测试放衣流程，观察 M5 夹紧等待后 Z/M4 是否先到 `EC4=3000`，再执行 X/M1 到 `EC1=5000`。

## 2026-06-24 22:05:39

### 修改类型
修改

### 涉及文件
- `APP/Src/cmd_dispatch.c`
- `APP/Inc/motion_profile.h`
- `Inc/dma.h`
- `Inc/gpio.h`
- `Inc/tim.h`
- `Inc/usart.h`
- `Inc/stm32f4xx_it.h`
- `Src/dma.c`
- `Src/system_stm32f4xx.c`
- `修改日志/修改日志.md`

### 修改内容
- 在 `cmd_dispatch.c` 文件开头增加醒目的中文总说明。
- 为 `cmd_dispatch.c` 中参数校验、编码器目标运动、ALL HOME、取衣/放衣启动、响应格式化、状态查询等关键函数补充函数级中文注释。
- 为若干中文注释偏少的头文件和 CubeMX 生成文件补充用途说明。

### 修改原因
- 用户反馈 `cmd_dispatch.c` 看起来没有中文注释，并要求再次仔细检查是否还有文件漏掉中文注释。

### 问题修复类型
- 不适用

### 根因分析
- 本次不是功能修复，只补充说明性中文注释。
- `cmd_dispatch.c` 实际已有大量中文注释，但文件为 UTF-8 无 BOM，部分编辑器若按 ANSI/GBK 打开可能显示异常。

### 工程原则应用
- KISS：只加注释，不改任何状态机逻辑、协议、坐标、宏值或引脚配置。
- YAGNI：没有新增功能或提前实现新点位。
- DRY：把关键职责和扩展位置写在对应函数/表附近。
- SOLID：注释补充，不强行套用复杂架构。

### 问题确认情况
- 已扫描确认 `cmd_dispatch.c` 是唯一同名源文件，并统计到该文件包含大量中文注释。

### 风险评估
- 仅增加注释，无运行时行为变化，无明显风险。

### 验证方式
- 按 UTF-8 重新打开 `APP/Src/cmd_dispatch.c`，检查文件头和关键函数中文注释。
- 重新扫描业务 `.c/.h` 文件，确认不存在完全缺少中文注释的源码文件。

## 2026-06-24 21:34:26

### 修改类型
修改

### 涉及文件
- `Src/main.c`
- `APP/Src/cmd_dispatch.c`
- `APP/Src/axis_planner.c`
- `APP/Src/motor_ctrl.c`
- `修改日志/修改日志.md`

### 修改内容
- 补充云端 `position` 到内部 `motion_slot` 映射表的中文注释。
- 补充 STM32 衣格坐标表 `g_cloth_slot_cfg[]` 的中文扩展说明，明确增加 2/3 号点位时要写的位置。
- 补充 XYZ 三轴规划器和电机控制层说明，明确当前没有 PID 控制，现有逻辑是开环 STEP 输出加到位容差判断。

### 修改原因
- 用户要求继续检查中文注释遗漏位置，并要求在代码中标清楚增加衣服点位的位置。
- 用户询问 XYZ 三轴是否已有 PID 控制程序，需要在核心控制代码附近给出明确注释，避免误解。

### 问题修复类型
- 不适用

### 根因分析
- 本次不是功能修复，只补充说明性中文注释。
- 原代码已有取放衣点位和三轴规划逻辑，但扩展点位和 PID 判断说明还不够集中。

### 工程原则应用
- KISS：只补充必要注释，不改控制逻辑、坐标、协议和宏值。
- YAGNI：没有提前新增 2/3 号点位数据，也没有虚构 PID 参数。
- DRY：把点位扩展说明集中写在映射表和坐标表附近，减少后续重复查找。
- SOLID：当前为嵌入式 C 注释补充，不强行套用复杂架构。

### 问题确认情况
- 用户明确要求只写代码注释，不改代码逻辑，并要求继续仔细检查遗漏注释。

### 风险评估
- 仅增加注释，无运行时行为变化，无明显风险。

### 验证方式
- 检查 `Src/main.c` 的 `g_wardrobe_position_map[]` 注释。
- 检查 `APP/Src/cmd_dispatch.c` 的 `g_cloth_slot_cfg[]` 注释。
- 检查 `APP/Src/axis_planner.c` 和 `APP/Src/motor_ctrl.c` 中关于“当前没有 PID”的说明。

## 2026-06-24 21:14:03

### 修改类型
修改

### 涉及文件
- `APP/Src/motor_hw.c`
- `APP/Src/motor_ctrl.c`
- `APP/Src/motion_profile.c`
- `APP/Src/encoder_hw.c`
- `APP/Src/encoder_ctrl.c`
- `APP/Src/axis_coord.c`
- `APP/Src/axis_limit.c`
- `APP/Src/axis_limit_store.c`
- `APP/Src/axis_planner.c`
- `APP/Src/uart_console.c`
- `APP/Src/rs485_abs_encoder.c`
- `APP/Src/telemetry_curve.c`
- `APP/Src/heartbeat.c`
- `APP/Src/cmd_parser.c`
- `APP/Src/cmd_dispatch.c`
- `APP/Src/yjzk_gripper.c`
- `APP/Inc/motor_hw.h`
- `APP/Inc/motor_ctrl.h`
- `APP/Inc/motion_profile.h`
- `APP/Inc/encoder_hw.h`
- `APP/Inc/encoder_ctrl.h`
- `APP/Inc/axis_coord.h`
- `APP/Inc/axis_limit.h`
- `APP/Inc/axis_limit_store.h`
- `APP/Inc/axis_planner.h`
- `APP/Inc/uart_console.h`
- `APP/Inc/rs485_abs_encoder.h`
- `APP/Inc/telemetry_curve.h`
- `APP/Inc/heartbeat.h`
- `APP/Inc/cmd_parser.h`
- `APP/Inc/cmd_dispatch.h`
- `APP/Inc/yjzk_gripper.h`
- `Src/main.c`
- `Src/usart.c`
- `Src/tim.c`
- `Src/gpio.c`
- `Src/dma.c`
- `Src/stm32f4xx_it.c`
- `Src/stm32f4xx_hal_msp.c`
- `Src/system_stm32f4xx.c`
- `Inc/main.h`
- `Inc/usart.h`
- `Inc/tim.h`
- `Inc/gpio.h`
- `Inc/dma.h`
- `Inc/stm32f4xx_it.h`
- `Inc/stm32f4xx_hal_conf.h`
- `修改日志/修改日志.md`

### 修改内容
- 为 STM32 工程自写业务源码和项目使用的外设初始化文件补充详细简体中文注释。
- 说明 M1~M5 电机硬件映射、STEP PWM、方向/使能、软停止、计步中断和往返运动状态。
- 说明 X/Y/Z 与电机的映射关系：X=M1，Y=M3，Z=M4；M2 为旋转轴，M5 为夹爪。
- 说明三轴坐标累计、三轴运动规划、限位保护、Flash 参数保存和旧版本配置迁移逻辑。
- 说明 USART3 同时支持 ASCII 文本命令和 `A5 CMD LEN DATA CRC 5A` 二进制衣柜协议帧。
- 说明 `cmd_dispatch.c` 中放衣服、取衣服状态机，当前 1 号衣格配置表 `g_cloth_slot_cfg[]`，以及后续增加 2 号、3 号衣格时应扩展的位置。
- 说明 `Src/main.c` 中 ESP32/云端命令 `0x10` 存衣、`0x11` 取衣、`0x12` 回零、`0x20` 读状态的处理路径，以及 `position` 到内部 `motion_slot` 的映射。
- 说明 USART2、USART3、UART4、TIM、GPIO、DMA、中断和 HAL MSP 文件在当前项目中的用途。
- 未修改任何函数逻辑、变量名、宏数值、衣格坐标、引脚配置、串口波特率、协议命令字或状态机流程。

### 修改原因
- 用户要求两个工程的代码都增加非常详细的简体中文注释。
- STM32 工程同时包含电机控制、编码器、三轴坐标、限位、夹爪、RS485 绝对值编码器、取放衣状态机和云端帧协议，需要在源码中直接标明模块职责和数据流。

### 问题修复类型
- 不适用

### 根因分析
- 本次不是 Bug 修复，而是代码可读性和维护性增强。
- 主要原因是后续可能扩展 2 号、3 号等衣柜位置，需要先在代码注释中明确当前 1 号位坐标配置、云端 position 映射、STM32 内部 motion_slot 和取放衣状态机之间的关系。

### 工程原则应用
- KISS：只增加注释，不改变任何控制逻辑和硬件配置。
- YAGNI：没有提前实现新衣格功能，只标明未来扩展点和当前限制。
- DRY：通过头文件和模块级注释集中说明接口职责，减少后续重复追踪调用链。
- SOLID：当前为嵌入式 C 工程注释增强，不强行套用复杂面向对象架构。

### 问题确认情况
- 用户明确要求“代码里面给注释，不是文件名，只写注释，不改代码”，并已回复“确认”授权批量修改。

### 风险评估
- 无明显运行风险。
- 修改范围为注释文本，不应影响编译产物和设备行为。
- `system_stm32f4xx.c` 和 `stm32f4xx_hal_conf.h` 仅补充少量项目用途说明，未大范围修改厂商模板。

### 验证方式
- 检查关键协议常量和业务宏仍保持原值，例如 `WARDROBE_CMD_STORE`、`WARDROBE_CMD_TAKE`、`WARDROBE_TEXT_OUTPUT_ENABLE`、`CLOTH_SLOT1_ID`。
- 使用文本搜索检查未出现明显乱码。
- 后续可通过 Keil/STM32 工程编译确认注释未影响语法。

## 2026-06-23 17:04:50

### 修改类型
修改 / 根本性修复

### 涉及文件
- `APP/Src/cmd_dispatch.c`
- `APP/COMMANDS.md`
- `APP/SERIAL_COMMANDS_EASY.md`
- `程序介绍.md`

### 修改内容
- 按当前代码参数同步取衣服、放衣服流程的串口回显和说明文档。
- 将 M5 夹爪夹紧/松开显示步数统一为 `10800`。
- 将 1 号衣服位 Y 坐标说明统一为 `3100`。

### 修改原因
- 用户确认当前代码里的 `CLOTH_GRIP_*_STEPS=10800` 和 `PLACE_CLOTH_HANG_Y=3100` 是现场有效值，应以代码为准。
- 旧回显和文档仍显示 `10300`、`3291`，会误导现场调试。

### 问题修复类型
- 根本性修复

### 根因分析
- 根因是参数已由用户更新，但串口回显字符串和说明文档没有同步更新。
- 本次不改变动作状态机，只消除代码实际动作与可见说明之间的不一致。

### 工程原则应用
- KISS：只更新展示字符串和文档，不改动已确认的运动逻辑。
- YAGNI：没有新增配置项或兼容旧参数分支。
- DRY：以 `cmd_dispatch.c` 中当前常量为事实来源，同步所有说明。
- SOLID：当前为嵌入式 C 参数说明同步，不强行套用复杂架构。

### 问题确认情况
- 用户明确说明“按代码的来，这个是我改的”。

### 风险评估
- 不改变电机实际动作，只改变串口回显和文档说明。
- 无明显运行逻辑风险。

### 验证方式
- 检索 `APP/Src/cmd_dispatch.c`、`APP/COMMANDS.md`、`APP/SERIAL_COMMANDS_EASY.md`、`程序介绍.md`，确认不再残留旧值 `10300` 和 `3291`。
- 串口启动 `AXIS PLACE_CLOTH` / `AXIS TAKE_CLOTH` 时，`SEQ` 应显示 `M5_CW10800` / `M5_CCW10800`。

## 2026-06-23 09:58:18

### 修改类型
修改 / 根本性修复

### 涉及文件
- `APP/Src/cmd_dispatch.c`
- `APP/COMMANDS.md`
- `APP/SERIAL_COMMANDS_EASY.md`
- `程序介绍.md`

### 修改内容
- 放衣服流程在 M5 夹爪夹紧并等待 2 秒后，新增 X/M1 到 `EC1=5000` 的过渡动作，然后继续原有 Y 回 `EX_KEY3` 和后续挂衣动作。
- 取衣服流程在 M5 夹爪夹紧并等待 2 秒后，新增 Z/M4 到 `EC4=2936` 的上移动作，然后继续原有 `Y=500 -> X=2250 -> Y=3433 -> Z=0` 和后续松爪动作。
- 同步更新 `AXIS PLACE_CLOTH` / `AXIS TAKE_CLOTH` 的串口启动回显 `SEQ` 和说明文档。

### 修改原因
- 用户明确要求在放衣服夹爪夹住并停 2 秒后插入 `X=5000`，其他动作不变。
- 用户明确要求在取衣服夹爪夹住并停 2 秒后插入 `Z=2936`，其他动作不变。

### 问题修复类型
- 根本性修复

### 根因分析
- 本次不是异常修复，而是按最新机械路径要求调整自动取放衣状态机。
- 根因是当前状态机缺少用户现场确认的两个过渡动作，直接进入后续动作会与新的机械路径要求不一致。

### 工程原则应用
- KISS：只新增两个明确的状态步骤和两个目标常量，不改动底层电机、编码器闭环、夹爪步数和整体回零机制。
- YAGNI：没有新增额外参数、复杂路径规划或多槽位扩展。
- DRY：继续复用现有 `place_cloth_start_axis_move()`、`take_cloth_start_axis_move()` 和 `cloth_axis_wait_done()` 到位等待逻辑。
- SOLID：当前为嵌入式 C 状态机小范围流程调整，不强行套用复杂架构。

### 问题确认情况
- 用户已明确给出两个要新增的动作、插入位置和“其他动作不变”的约束。
- 代码路径确认插入点分别对应 `PLACE_CLOTH_WAIT_CLOSE` 和 `TAKE_CLOTH_WAIT_AFTER_CLOSE`。

### 风险评估
- 改动影响范围限定为自动放衣服和自动取衣服流程。
- 新增两段单轴运动会增加流程时间，并改变夹爪夹住衣服后的机械路径；现场测试应保持急停可用。

### 验证方式
- 检查 `AXIS PLACE_CLOTH` 启动回显应包含 `...,M5_CW10300,WAIT,X5000,Y_HOME,...`。
- 检查 `AXIS TAKE_CLOTH` 启动回显应包含 `...,M5_CW10300,WAIT,Z2936,Y500,...`。
- 烧录后空载低速执行 `AXIS PLACE_CLOTH RPM=35 TOL=5` 和 `AXIS TAKE_CLOTH RPM=35 TOL=5`，观察新增动作是否按顺序执行，且原有后续动作不变。

## 2026-06-20 12:25:44

### 修改类型
修复 / 根本性修复

### 涉及文件
- `APP/Src/cmd_dispatch.c`

### 修改内容
- 为编码器闭环运动状态增加 `done` / `fault` 标记。
- 在编码器闭环确认到达目标后记录完成状态，自动取放衣状态机等待同一目标时可直接继续。
- 在编码器状态失败、方向错误、卡滞、主动中止等路径维护完成/故障标记，避免旧状态残留。
- 未修改取衣顺序、`Y=500` 中转位置、`TOL=2` 默认容差和 M5 夹爪参数。

### 修改原因
- 用户反馈 `AXIS TAKE_CLOTH` 在夹爪夹住衣服后，Y 到 `500` 后不继续执行 X 到 `2250`。
- 代码里 `TAKE_CLOTH_MOVE_PICK_X` 会先等待 `M3/Y=500` 到位，原逻辑依赖当前编码器计数再次复核，可能出现底层闭环已判定到位并停轴，但状态机后续没有可靠拿到“本次运动已完成”的结果。

### 问题修复类型
- 根本性修复

### 根因分析
- 根因是编码器闭环完成结果没有被持久记录给上层状态机使用，`cloth_axis_wait_done()` 只能重新读取当前编码器和电机状态判断。
- 当 M3 从 `3291` 回到 `500` 后，闭环 tick 已经可能执行 `ENC_MOVE_DONE` 并清除 `active`，但取衣状态机下一拍仍可能因为二次复核条件没有明确完成标记而停在 `TAKE_CLOTH_MOVE_PICK_X`。
- 本次让底层闭环完成结果成为明确状态，状态机等待同一个目标时优先识别该完成状态，不需要删除必要的安全等待。

### 工程原则应用
- KISS：只补齐编码器运动状态的完成/故障语义，不重写取衣状态机。
- YAGNI：不引入新的流程步骤、不改默认容差、不新增无关调试协议。
- DRY：继续复用 `cloth_axis_wait_done()`，放衣和取衣共享同一套到位等待逻辑。
- SOLID：当前为嵌入式 C 状态机小范围修复，不强行套用复杂架构。

### 问题确认情况
- 已根据代码路径确认卡点位于 `TAKE_CLOTH_MOVE_PICK_X` 等待 `MOTOR_ID_3` 到 `TAKE_CLOTH_TRANSFER_Y=500` 后再启动 X 轴。
- 用户明确否定放宽容差方案，因此本次不修改 `TOL`，改为修复完成状态传递。

### 风险评估
- 影响范围集中在 M1/M3/M4 编码器闭环完成结果和自动取放衣等待逻辑。
- 保留方向错误、编码器状态失败、卡滞保护；不会在未完成或故障时继续流程。
- 无明显无关功能风险。

### 验证方式
- 使用 ArmClang 对 `APP/Src/cmd_dispatch.c` 做语法检查。
- 烧录后执行 `AXIS TAKE_CLOTH RPM=35 TOL=2`，观察夹爪夹紧并等待后，Y 到 `500` 后应继续启动 X 到 `2250`。
- 若仍不继续，查询 `M3 ENC_STATUS` 和 `AXIS STATUS`，并关注是否出现 `M3_ENC_WRONG_DIR` 或 `M3_ENC_STALL`。
## 2026-06-20 11:12:07

### 修改类型
修改 / 根本性修复

### 涉及文件
- `APP/Src/cmd_dispatch.c`
- `APP/COMMANDS.md`
- `APP/SERIAL_COMMANDS_EASY.md`
- `程序介绍.md`
- `修改日志/修改日志.md`

### 修改内容
- 将自动放衣/取衣流程中的 M5 夹爪夹紧步数从 `3000` 修正为 `10300`。
- 将自动放衣/取衣流程中的 M5 夹爪松开步数从 `10000` 修正为 `10300`。
- 同步更新启动响应 `SEQ`、调试日志字符串、命令说明、速查说明和程序介绍。
- 明确记录流程假设：夹爪初始状态为松开，自动取放流程开头不额外执行松爪动作。

### 修改原因
- 用户重新现场测试后确认此前夹爪步数测错，最新实测命令为：松开 `M5 MOVE DIR=CCW RPM=30 STEP=10300`，夹紧 `M5 MOVE DIR=CW RPM=30 STEP=10300`。
- 若继续使用旧参数，夹紧或松开行程会不完整或不符合实际机械状态。

### 问题修复类型
- 根本性修复

### 根因分析
- 根因是现场实测参数更新：之前写入的夹爪动作步数不是最终有效值。
- 本次直接修正参数来源，并保持原有状态机等待 M5 完成的机制不变。

### 工程原则应用
- KISS：只改已确认的夹爪步数常量和对应说明，不重构取放衣状态机。
- YAGNI：不新增开机自动松爪步骤，因为用户明确夹爪初始状态就是松开。
- DRY：继续使用统一的 `CLOTH_GRIP_CLOSE_STEPS` / `CLOTH_GRIP_OPEN_STEPS` 常量驱动放衣和取衣流程。
- SOLID：当前为嵌入式 C 参数修正，不强行套用复杂架构。

### 问题确认情况
- 用户已明确说明此前测错，并确认最新夹紧、松开命令均为 `STEP=10300`。
- 用户已明确要求“现在可以修改了”，并要求记住夹爪初始状态为松开。

### 风险评估
- 自动取放流程会真实执行更长的 M5 行程，现场首次测试应保持急停可用。
- 初始状态依赖机械夹爪确实处于松开状态；如果上电前夹爪不是松开，应先手动执行松开命令复位机械状态。

### 验证方式
- 使用 ArmClang 对 `APP/Src/cmd_dispatch.c` 做语法检查。
- 烧录后先单独测试 `M5 MOVE DIR=CW RPM=30 STEP=10300` 和 `M5 MOVE DIR=CCW RPM=30 STEP=10300`。
- 再测试 `AXIS PLACE_CLOTH RPM=35 TOL=2` 和 `AXIS TAKE_CLOTH RPM=35 TOL=2`，观察 M5 夹紧/松开动作是否完整并等待完成。

## 2026-06-20 10:26:51

### 修改类型
修改 / 根本性修复

### 涉及文件
- `APP/Src/cmd_dispatch.c`
- `APP/COMMANDS.md`
- `APP/SERIAL_COMMANDS_EASY.md`
- `程序介绍.md`
- `修改日志/修改日志.md`

### 修改内容
- 将自动放衣/取衣流程中的夹爪步骤从 `GRIP_*_NOT_CONFIGURED` 故障改为真实执行 M5 定步数动作。
- 夹紧动作接入 `M5 MOVE DIR=CW RPM=30 STEP=3000`。
- 松开动作接入 `M5 MOVE DIR=CCW RPM=30 STEP=10000`。
- 新增自动流程对 M5 夹爪动作完成的等待逻辑，M5 定步数运动完成后再延时 2 秒进入下一步。
- 将 M5 纳入自动取放流程忙碌检测和 `AXIS STOP/ESTOP` 中断范围，避免夹爪运动中又启动取放流程或中断时漏停 M5。
- 自动流程运行中若收到单电机 `Mx STOP/ESTOP`，会取消整套取放衣流程并停止 M1/M3/M4/M5，避免只停单轴导致其他轴或夹爪残留动作。
- 将固件版本更新为 `SmartWardrobe-STM32F407 v1.4.16`。
- 同步更新命令说明、速查说明和程序介绍中的 M5 夹爪控制方式。

### 修改原因
- 用户已现场测出夹爪松开和夹紧的真实 M5 步数命令，自动取放衣流程不应继续在夹爪步骤返回未配置故障。
- 之前保留 `GRIP_*_NOT_CONFIGURED` 是因为缺少夹紧/松开步数，属于阶段性防护；现在参数已经确认，可以接入真实动作。

### 问题修复类型
- 根本性修复

### 根因分析
- 根因是自动取放衣状态机缺少已确认的 M5 夹爪动作参数，导致流程到夹爪步骤只能故障退出。
- 本次直接把用户实测参数绑定到状态机，并等待 M5 动作完成，避免只发送动作不等待造成后续轴提前移动。

### 工程原则应用
- KISS：复用现有 `MotorCtrl_MoveSteps()` 和电机状态查询，不新增独立夹爪驱动链路。
- YAGNI：只接入当前已确认的夹紧/松开动作参数，不新增未验证的夹爪校准协议。
- DRY：放衣和取衣共用 `cloth_grip_start()`、`cloth_grip_wait_done()`，避免四处复制 M5 控制逻辑。
- SOLID：当前为嵌入式 C 状态机小范围修改，不强行引入复杂架构；夹爪控制仍归属于电机控制能力。

### 问题确认情况
- 用户已明确确认松开命令为 `M5 MOVE DIR=CCW RPM=30 STEP=10000`，夹紧命令为 `M5 MOVE DIR=CW RPM=30 STEP=3000`。
- 用户已明确表示“现在可以修改了”，本次按该确认参数执行修改。

### 风险评估
- 自动放衣/取衣流程会真实驱动 M5 夹爪，现场首次测试应低速空载或半载观察，并保持急停可用。
- `AXIS STOP/ESTOP` 和自动流程运行中的单电机 `Mx STOP/ESTOP` 现在会同时停止取放流程相关电机，符合中断预期。
- 无明显无关功能影响。

### 验证方式
- 编译 `MDK-ARM/SmartWardrobeCode.uvprojx`，确认 `APP/Src/cmd_dispatch.c` 无语法错误。
- 烧录后先单独测试 `M5 MOVE DIR=CW RPM=30 STEP=3000` 和 `M5 MOVE DIR=CCW RPM=30 STEP=10000`。
- 再测试 `AXIS PLACE_CLOTH RPM=35 TOL=2` 和 `AXIS TAKE_CLOTH RPM=35 TOL=2`，观察 M5 在夹紧/松开步骤是否动作完成后再进入下一轴动作。

## 2026-06-19 23:59:25

### 修改类型
修改 / 分阶段修复

### 涉及文件
- `Src/main.c`
- `Inc/main.h`
- `Src/gpio.c`
- `APP/Inc/cmd_parser.h`
- `APP/Src/cmd_parser.c`
- `APP/Src/cmd_dispatch.c`
- `APP/Src/motor_hw.c`
- `修改日志/修改日志.md`

### 修改内容
- 移除主程序对 UART4 电夹爪模块 `YjzkGripper` 的包含、初始化和业务调用。
- 删除命令解析中的 `GRIP_STATUS`、`GRIP_OPEN`、`GRIP_CLOSE`、`GRIP_READ`、`GRIP_WRITE` 动作入口。
- 删除 `M5_GRIP_ONLY` 特判，使 `M5` 走和 `M1` 相同的普通电机命令分支。
- 更新帮助文本，`M1~M5` 均支持 `RUN/STOP/ESTOP/SPEED/ACCEL/DECEL/MOVE/RECIP/RECIP_INF/CFG/STATUS/CURVE_*`。
- 保留 M5 无编码器的事实，编码器相关 `ENC_STATUS/ENC_CLR/ENC_MOVE` 仍限制在现有 M1~M4 或 M1/M3/M4 范围内。
- 自动取放衣流程中的夹爪动作先改为 `GRIP_*_NOT_CONFIGURED` 故障，等待后续补充 M5 夹紧/松开步数后再接入。

### 修改原因
- 现场确认电夹爪实际与 M1、M2、M3、M4 一样使用脉冲方向控制，而不是 UART4 Modbus 电夹爪接口。
- 原代码把 M5 特判成 UART4 电夹爪，导致 `M5 RUN/MOVE/STOP` 等普通电机命令被拒绝。
- 当前尚未提供夹紧和松开的具体脉冲步数，自动取放衣流程不能继续调用旧 UART4 接口，也不能假装夹爪动作已经完成。

### 问题修复类型
- 分阶段修复

### 根因分析
- 根因是 M5 设备类型判断错误：软件层按 UART4 电夹爪处理，硬件实际需要走 TIM12 脉冲、PD0 方向、PB15 使能的电机控制链路。
- 本次先恢复 M5 的通用电机控制能力，夹取/松开动作等用户提供步数参数后再绑定到 M5 `MOVE` 流程。

### 工程原则应用
- KISS：直接复用现有 `MotorCtrl_*` 和 `handle_motor_cmd()`，不新增另一套 M5 控制路径。
- YAGNI：未提前猜测夹紧/松开步数，不硬编码未知动作参数。
- DRY：M5 与 M1~M4 共用同一套 RUN/MOVE/STOP/CFG/STATUS 命令逻辑。
- SOLID：把 M5 从错误的 UART4 夹爪职责中移出，恢复为电机控制模块负责。

### 问题确认情况
- 用户已确认电夹爪和 M1、M2、M3、M4 是相同控制方式。
- 用户说明夹紧和松开具体脉冲步数稍后提供，因此本次仅做控制链路切换，不实现最终自动夹取步数。

### 风险评估
- `GRIP_*` 文本命令不再可用，M5 应改用 `M5 RUN/MOVE/STOP/CFG/STATUS` 等电机命令。
- 自动放衣/取衣流程运行到夹爪步骤会返回 `*_GRIP_*_NOT_CONFIGURED` 故障；这是刻意的防护，避免未配置步数时继续执行错误动作。
- UART4 初始化被主程序移除；若后续仍有其他外设需要 UART4，需要重新确认再恢复。

### 验证方式
- 使用 `gcc -fsyntax-only` 检查 `Src/main.c`、`APP/Src/cmd_dispatch.c`、`APP/Src/cmd_parser.c`、`APP/Src/motor_hw.c`、`Src/gpio.c`。
- 烧录后可用 `M5 STATUS` 查看 M5 状态。
- 可用 `M5 MOVE DIR=CW RPM=低速 CNT=小步数` 和 `M5 STOP` 验证 M5 脉冲方向控制是否正常。
- 自动取衣/放衣在未配置夹爪步数前应在夹爪步骤返回明确故障，而不是调用 UART4 旧接口。

## 2026-06-19 23:16:29

### 修改类型
修复 / 分阶段修复

### 涉及文件
- `Src/main.c`
- `APP/Inc/cmd_parser.h`
- `APP/Src/cmd_parser.c`
- `APP/Src/cmd_dispatch.c`
- `修改日志/修改日志.md`

### 修改内容
- 将云端心跳从 USART3 ASCII 文本心跳改为周期发送衣柜协议二进制状态帧 `0xA0`。
- 关闭默认 USART3 文本输出，避免 ASCII 调试日志混入 ESP32 二进制协议口。
- 新增云端 `position` 到机械 `SLOT` 的显式映射：当前 `position=1` 和 `position=5` 都映射到机械槽位 `SLOT=1`。
- 为命令参数新增 `SLOT`，并让放衣服、取衣服状态机从槽位配置表读取挂衣坐标。
- 将取衣服固定的 `CLOTH_SLOT1_*` 坐标引用整理为运行时 `g_take_cloth.slot_x/y/z`。

### 修改原因
- 当前心跳实际是 ASCII `HB...` 文本，不是 ESP32/云端协议期望的 `A5 ... 5A` 二进制帧，云端侧会表现为看不到心跳。
- 原 `position=5` 只是协议入口放行，动作层仍然隐式固定 1 号坐标，容易误判为已经支持真实 5 号衣位。
- 取衣服运行到某一步卡住时，协议心跳应独立于动作状态机继续输出，用于判断主循环是否仍在运行。

### 问题修复类型
- 分阶段修复 / 根因收敛

### 根因分析
- 心跳问题的根因是通信契约不一致：ESP32/云端侧看二进制协议帧，而 STM32 周期输出的是 USART3 ASCII 文本。
- 取衣逻辑问题的根因是云端位置编号和机械槽位坐标没有明确映射层，导致 `position=5` 与真实机械动作坐标关系不清。
- 当前没有 5 号位真实机械坐标，因此本次不伪造 5 号独立坐标，而是显式声明 `position=5 -> SLOT=1`。

### 工程原则应用
- KISS：复用已有 `Wardrobe_SendStatus()` 发送协议状态帧，不新增另一套心跳协议。
- YAGNI：没有在缺少真实坐标时提前实现多衣位坐标表，只保留当前已知的机械 1 号槽配置。
- DRY：槽位坐标集中在 `g_cloth_slot_cfg`，放衣和取衣共用同一份槽位定义。
- SOLID：嵌入式 C 小范围修复中不强行套复杂架构，但将协议位置映射和动作槽位配置分离，职责更清晰。

### 问题确认情况
- 已确认用户下发的 `position=5` 是取衣服动作入口需要兼容的位置编号。
- 已确认旧心跳是 ASCII 文本，不是云端协议二进制帧。
- 用户已回复确认，授权按协议心跳和取衣位置逻辑整理方向修改。

### 风险评估
- USART3 默认文本输出被关闭后，串口助手不会再看到 `OK...`、`HB...` 这类 ASCII 调试文本；协议帧、接收文本命令解析和二进制命令解析不受影响。
- `position=5` 当前仍执行机械 `SLOT=1` 坐标；若后续需要真实 5 号衣位，必须补充 `g_cloth_slot_cfg` 中对应坐标并调整映射。
- 周期 `0xA0` 状态帧会占用少量 USART3 带宽，周期沿用 3000ms，风险较低。

### 验证方式
- 使用 `gcc -fsyntax-only` 检查 `Src/main.c`、`APP/Src/cmd_dispatch.c`、`APP/Src/cmd_parser.c`、`APP/Src/heartbeat.c`。
- 烧录后空闲状态应每约 3 秒输出一帧 `A5 A0 06 ... CRC 5A` 状态帧。
- 下发 `cmd=0x11, position=5` 时，应启动取衣流程，并最终仍以原始 `position=5` 返回成功或故障帧。
- 如需串口文本调试，可临时将 `WARDROBE_TEXT_OUTPUT_ENABLE` 改为 `1U`，但接 ESP32 协议口时建议保持关闭。

## 2026-06-19 22:14:15

### 修改类型
修复 / 诊断增强

### 涉及文件
- `APP/Src/heartbeat.c`
- `APP/Src/uart_console.c`
- `修改日志/修改日志.md`

### 修改内容
- 将默认心跳从完整系统状态输出改为短心跳：`HB TS=... SEQ=... LOST=...`。
- 为 USART3 文本发送增加 TX 起始时间记录和 500ms 超时恢复。
- 新增 USART3 `HAL_UART_ErrorCallback()` 处理，发生 UART 错误时重启接收并恢复 TX 队列。

### 修改原因
- 取衣服流程运行到某一步后，现场表现为心跳不再输出且程序像是卡住。
- 原心跳每次拼接完整系统状态，内容较长且依赖多模块状态，不适合作为“程序是否存活”的轻量信号。
- 原 USART3 异步发送只依赖 `HAL_UART_TxCpltCallback()` 清除忙标志，一旦发送完成回调丢失或 UART 进入错误状态，后续心跳和调试输出会被堵住。

### 问题修复类型
- 分阶段修复 / 防御性兜底

### 根因分析
- 当前可确认的问题是心跳输出链路不够稳健：心跳内容过重，且 USART3 TX 忙状态缺少超时恢复。
- 现场“心跳停”尚不能完全证明取衣服状态机本身停止；也可能是 USART3 输出链路被堵，导致主循环仍运行但看不到心跳。
- 本次先把心跳改为轻量存活信号，并为 USART3 输出增加错误恢复，便于下一次现场判断是真卡死还是仅输出卡死。

### 工程原则应用
- KISS：用短心跳直接表达存活状态，不再把完整系统状态塞进周期心跳。
- YAGNI：没有新增复杂诊断协议或取衣服状态机重构，只补当前必须的输出可靠性。
- DRY：继续复用 `UartConsole_QueueLineDropOldest()` 队列接口，不新增并行串口输出路径。
- SOLID：保持心跳模块只负责轻量存活输出，完整状态查询仍由命令响应负责。

### 问题确认情况
- 已确认用户反馈为取衣服过程中某一步后心跳停止。
- 已确认原心跳依赖 `CmdDispatch_FormatSystemStatus()`，输出内容较重。
- 已确认原 USART3 TX 忙状态只在发送完成回调中恢复，缺少错误/超时兜底。

### 风险评估
- 心跳内容格式会从完整中文系统状态变为短 `HB` 文本；若上位机依赖旧心跳文本解析完整状态，需要改为主动发送 `STATUS` 查询。
- USART3 TX 超时恢复会在发送卡住超过 500ms 后中止当前发送并继续队列，可能丢弃卡住时正在发送的那一条文本，但能避免后续心跳全部堵死。

### 验证方式
- 重新编译烧录后，空闲状态下应周期性输出 `HB TS=... SEQ=... LOST=...`。
- 执行取衣服流程时，即使某一步等待较久，仍应持续看到短心跳递增。
- 若某次 USART3 发送异常，最多短暂停顿后应继续输出后续心跳。
- 如需要完整系统状态，发送 `STATUS` 命令单独查询。

## 2026-06-19 21:58:22

### 修改类型
修改 / 兼容修复

### 涉及文件
- `Src/main.c`
- `修改日志/修改日志.md`

### 修改内容
- 将衣柜协议支持的位置从单一 `position=1` 扩展为 `position=1` 和 `position=5`。
- 新增 `Wardrobe_IsSupportedPosition()` 判断函数，`position=5` 会复用当前已有取衣服/放衣服动作流程。

### 修改原因
- 云端/ESP32 下发的取衣服指令为 `{"cmd":17,"position":5}`，其中 `cmd=17` 对应 STM32 的 `0x11` 取衣服命令。
- 原代码只允许 `position=1`，收到 `position=5` 会返回故障帧并直接拒绝执行，导致取衣服动作没有启动。

### 问题修复类型
- 分阶段修复

### 根因分析
- 根因是 STM32 衣柜协议层的支持位置判断与上游下发的位置编号不一致。
- 当前机械取放流程仍使用一套固定坐标，尚未实现多衣位坐标表，因此本次先让 `position=5` 兼容进入现有动作流程。
- 后续如果需要真实支持多个不同衣位，应增加衣位坐标表并按 `position` 选择不同取放坐标。

### 工程原则应用
- KISS：使用一个小函数集中判断支持位置，不改动底层电机、串口或取放状态机。
- YAGNI：没有提前实现完整多衣位坐标表，只满足当前 `position=5` 的现场联调需求。
- DRY：位置支持判断集中在 `Wardrobe_IsSupportedPosition()`，避免多处硬编码。
- SOLID：当前为嵌入式 C 小范围协议兼容修复，不强行套用复杂架构；保持协议入口与动作调度边界清晰。

### 问题确认情况
- 已解码用户提供的 Base64 指令，确认内容为 `{"cmd":17,"position":5}`。
- 已确认 `cmd=17` 是取衣服命令，动作未执行的原因是 `position=5` 被原支持位置判断拒绝。
- 用户已回复继续，授权按兼容方向修改。

### 风险评估
- `position=5` 目前会执行与 `position=1` 相同的固定取/放衣服动作，不代表已经具备真实 5 号衣位坐标。
- 若云端认为 5 号位有独立机械位置，后续必须补齐坐标映射，否则动作会走当前固定衣位。

### 验证方式
- 重新编译烧录后，通过 ESP32/云端发送 `eyJjbWQiOjE3LCJwb3NpdGlvbiI6NX0=`。
- STM32 应不再因位置不支持直接返回故障，而应启动当前取衣服流程。
- 动作完成后应按原协议返回成功帧，成功数据中的 position 应保持为 `5`。

## 2026-06-19 21:44:31

### 修改类型
修复

### 涉及文件
- `Src/main.c`
- `修改日志/修改日志.md`

### 修改内容
- 在 `UartConsole_Init()` 之后调用 `UartConsole_SetTextOutputEnabled(true)`，恢复 USART3 文本输出。
- 让启动提示、心跳、`PING`、`STATUS`、`VER` 等文本响应重新进入发送队列。

### 修改原因
- 现场确认心跳输出不发送，需要恢复 USART3 文本心跳。
- 原发送路径在文本输出开关关闭时会直接返回成功但不实际发送，导致心跳看起来“发送成功”，串口却没有输出。

### 问题修复类型
- 根本性修复

### 根因分析
- 根因是 `UartConsole_Init()` 默认将 `g_text_output_enabled` 置为 `0U`，而心跳通过 `UartConsole_QueueLineDropOldest()` 发送文本。
- 当文本输出关闭时，`UartConsole_QueueLineDropOldest()` 直接返回 `true`，没有把心跳内容加入 TX 队列。
- 本次在系统初始化阶段显式开启文本输出，使心跳发送路径与现场调试需求一致。

### 工程原则应用
- KISS：只在初始化阶段打开已有文本输出开关，不改串口底层、中断、DMA 或心跳模块结构。
- YAGNI：没有新增协议、命令或额外调试机制，只恢复当前需要的心跳输出。
- DRY：复用现有 `UartConsole_SetTextOutputEnabled()` 接口，不复制发送逻辑。
- SOLID：当前为嵌入式 C 初始化修复，不强行套用复杂架构；保持串口控制职责集中在 `UartConsole`。

### 问题确认情况
- 已确认心跳模块调用 `UartConsole_QueueLineDropOldest()`，且该函数受 `g_text_output_enabled` 控制。
- 用户已明确确认需要继续修改，按该根因执行修复。

### 风险评估
- 影响范围为 USART3 文本输出恢复。
- 若 USART3 同时连接 ESP32 二进制协议解析端，文本心跳可能再次进入同一串口链路，需要现场确认当前连接对象是否就是串口调试助手。

### 验证方式
- 重新编译烧录后，串口助手连接 USART3：PB10=TX、PB11=RX，参数 `115200, 8N1`。
- 上电后应看到 `OK SmartWardrobe Ready`，随后周期性看到系统状态心跳文本。
- 发送 `PING` 应返回 `OK PONG`。

## 2026-06-18 20:21:05

### 修改类型
修复 / 根本性修复

### 涉及文件
- `APP/Src/cmd_dispatch.c`
- `程序介绍.md`
- `修改日志/修改日志.md`

### 修改内容
- 修复 `AXIS TAKE_CLOTH` 中 EX_KEY3 触发时可能没有给取衣状态机设置 `y_home_done` 的时序漏洞。
- 将 EX_KEY3 完成事件匹配条件从仅 `TAKE_CLOTH_MOVE_PICK_X` 扩展为 `TAKE_CLOTH_HOME_Y_WITH_CLOTH` 或 `TAKE_CLOTH_MOVE_PICK_X`。
- 固件版本号更新为 `SmartWardrobe-STM32F407 v1.4.12`。

### 修改原因
- 用户继续反馈取衣流程夹爪抓取后 Y 轴回行程开关，三轴仍不继续动作。

### 问题修复类型
- 根本性修复

### 根因分析
- 1ms 调度中 `take_cloth_tick()` 先运行，EX_KEY3 限位守护后运行。
- Y 回行程完成的那一拍，状态机可能仍处于 `TAKE_CLOTH_HOME_Y_WITH_CLOTH` 或刚切到 `TAKE_CLOTH_MOVE_PICK_X`。
- 之前只在 `TAKE_CLOTH_MOVE_PICK_X` 状态下记录 `y_home_done`，存在时序漏判，导致下一步 X 不启动。

### 工程原则应用
- KISS：扩大完成事件的状态匹配范围，不改变底层电机/行程开关驱动。
- YAGNI：不增加复杂事件队列。
- DRY：继续复用已有 `y_home_done` 机制。
- SOLID：限位守护捕获完成事件，取衣状态机消费完成事件。

### 问题确认情况
- 已从当前代码执行顺序确认该时序漏洞。

### 风险评估
- 只影响取衣流程中 Y 回 EX_KEY3 后进入 X 轴回取放点的推进条件。
- 若 EX_KEY3 没有实际触发，不会设置完成标志。

### 验证方式
- 使用 `gcc -fsyntax-only -DSTM32F407xx ... APP/Src/cmd_dispatch.c` 做语法检查。
- 空载运行 `AXIS TAKE_CLOTH RPM=35 TOL=2`，观察夹爪抓取后 Y 回 EX_KEY3，随后应继续执行 X=2250。

## 2026-06-18 19:58:47

### 修改类型
修复 / 根本性修复

### 涉及文件
- `APP/Src/cmd_dispatch.c`
- `程序介绍.md`
- `修改日志/修改日志.md`

### 修改内容
- 修复 `AXIS TAKE_CLOTH` 夹爪抓取后 Y 轴退到 EX_KEY3 后流程不继续的问题。
- 为放衣/取衣流程增加 `y_home_done` 状态标志，在 EX_KEY3 触发瞬间记录 Y 回行程已完成，避免下一拍重新读取行程开关时因信号弹开或 guard 已清除导致状态机误判未完成。
- `TAKE_CLOTH` 在 Y 回行程完成后直接进入 `X=2445`，不再卡在 `cloth_y_home_wait_done()`。
- 移除取衣流程中残留的 `Y=3433` 回取放点动作，保持最新确认顺序：X=13331，Z=2436，Y=3291，等待，夹爪抓取，Y 回 EX_KEY3，X=2445，Z=0，等待，夹爪松开，等待，ALL HOME。
- 同步固件版本号为 `SmartWardrobe-STM32F407 v1.4.11`。

### 修改原因
- 用户现场反馈夹爪取到衣服后，Y 轴退后，之后设备不动。

### 问题修复类型
- 根本性修复

### 根因分析
- Y 回 EX_KEY3 的完成事件原本只在限位守护里打印 `OK M3 HOME_EX3_DONE` 并清除 guard。
- 取衣状态机下一拍再调用 `cloth_y_home_wait_done()` 时，需要重新读取 EX_KEY3；如果开关信号弹开、状态变化或 guard 已清除，就可能返回未完成/失败，导致流程停在进入 X=2445 之前。
- 本次在 EX_KEY3 触发瞬间直接写入流程级完成标志，状态机消费该标志后再进入下一步，避免事件丢失。

### 工程原则应用
- KISS：增加一个明确的流程完成标志，不重写行程开关底层逻辑。
- YAGNI：不引入复杂事件队列，只处理当前 Y 回行程完成事件。
- DRY：放衣和取衣共用 `cloth_y_home_wait_done()` 的完成标志消费逻辑。
- SOLID：行程开关守护负责捕获硬件事件，自动流程状态机负责消费事件并推进动作。

### 问题确认情况
- 根据代码路径确认，取衣流程卡点位于 `TAKE_CLOTH_MOVE_PICK_X` 前的 Y 回行程完成判断。

### 风险评估
- 改动只影响自动放衣/取衣流程的 Y 回 EX_KEY3 完成判断。
- 若 EX_KEY3 从未触发，流程仍会等待或报错，不会错误进入下一步。

### 验证方式
- 使用 `gcc -fsyntax-only -DSTM32F407xx ... APP/Src/cmd_dispatch.c` 做语法检查。
- 空载运行 `AXIS TAKE_CLOTH RPM=30 TOL=2`，观察夹爪抓取后 Y 回 EX_KEY3，随后应继续执行 X=2445、Z=0。

## 2026-06-18 18:17:25

### 修改类型
创建 / 文档记录

### 涉及文件
- `速度和容差调试说明.txt`
- `修改日志/修改日志.md`

### 修改内容
- 新增 `速度和容差调试说明.txt`。
- 记录取衣服、放衣服默认速度和容差所在代码位置。
- 记录串口临时调试命令、云端 MessageContent 示例，以及云端扩展 RPM/TOL 所需改动方向。

### 修改原因
- 用户要求将“电机速度和容差在哪里调”记录成 txt 文件，便于后续查看和现场调试。

### 问题修复类型
- 不适用

### 根因分析
- 本次不是问题修复，而是调试说明文档沉淀。

### 工程原则应用
- KISS：使用单个 txt 文件记录最常用调试信息，便于现场直接查看。
- YAGNI：没有额外创建复杂文档结构或协议扩展，只记录当前需要的信息。
- DRY：集中记录 MessageContent、默认宏和调试命令，避免后续重复询问或分散查找。
- SOLID：文档任务不涉及面向对象结构，不强行套用复杂架构。

### 问题确认情况
- 用户明确要求记录并写成 txt 文件。

### 风险评估
- 仅新增说明文档，不影响代码运行。

### 验证方式
- 打开 `速度和容差调试说明.txt`，确认其中包含默认宏位置、串口调试命令和阿里云 MessageContent。

## 2026-06-18 17:43:59

### 修改类型
修改 / 流程调整

### 涉及文件
- `APP/Src/cmd_dispatch.c`
- `APP/COMMANDS.md`
- `APP/SERIAL_COMMANDS_EASY.md`
- `程序介绍.md`
- `修改日志/修改日志.md`

### 修改内容
- 按用户要求调整 `AXIS PLACE_CLOTH` 和 `AXIS TAKE_CLOTH` 流程。
- 放衣服和取衣服启动后，先执行一次 `ALL HOME` 归零。
- 初始归零完成后，再继续原有放衣服或取衣服顺序动作。
- 保留动作结束后的 `ALL HOME`，因此取放流程现在是“开始归零 + 业务动作 + 结束归零”。
- 同步更新串口命令文档、速查文档和程序介绍。

### 修改原因
- 用户明确要求不新增云端复位命令，而是在 STM32 执行放衣服或取衣服函数时先归零，再执行对应取放动作。

### 问题修复类型
- 分阶段修复

### 根因分析
- 当前云端和 ESP32 已能下发取放命令，但 STM32 机械动作前的初始位置可能不确定。
- 本次将归零收敛到 STM32 内部流程，不要求云端额外发送复位命令，降低云端控制复杂度。
- 这不是新增协议命令，而是在现有 `0x10` / `0x11` 对应的业务流程内部加入前置归零。

### 工程原则应用
- KISS：复用现有 `ALL HOME` 逻辑，不新增云端命令和新协议帧。
- YAGNI：不扩展额外复位指令，只改当前取放流程需要的前置动作。
- DRY：取放流程继续复用已有 `ALL HOME` 和原状态机，不复制回零实现。
- SOLID：协议入口、取放状态机和底层电机控制边界保持不变，只调整状态机顺序。

### 问题确认情况
- 用户明确回复“还是按照我的来改”，确认采用取放动作前先归零的方向。

### 风险评估
- 每次取衣服或放衣服都会先执行一次 `ALL HOME`，动作总时长会增加。
- 如果衣物已经被夹持或设备处于不适合回零的位置，前置回零可能带来机械风险；现场应确认夹爪和衣物状态。
- 保留动作结束后的 `ALL HOME`，因此一次完整流程会包含两次归零。

### 验证方式
- 已用 `gcc -fsyntax-only -DSTM32F407xx` 对 `APP/Src/cmd_dispatch.c` 做语法检查。
- 串口执行 `AXIS PLACE_CLOTH RPM=30 TOL=36`，返回序列应包含 `SEQ=ALL_HOME,...,ALL_HOME`。
- 串口执行 `AXIS TAKE_CLOTH RPM=30 TOL=36`，返回序列应包含 `SEQ=ALL_HOME,...,ALL_HOME`。
- 通过 ESP32/云端下发 1 号位存取命令时，STM32 应先归零，再继续取放动作。

## 2026-06-18 17:33:06

### 修改类型
修复 / 协议收敛

### 涉及文件
- `APP/Inc/uart_console.h`
- `APP/Src/uart_console.c`
- `修改日志/修改日志.md`

### 修改内容
- 为 `UartConsole` 增加文本输出开关接口。
- STM32 默认关闭 USART3 文本输出，只保留二进制协议帧收发。
- 这样 `OK SmartWardrobe Ready`、状态心跳和调试文本不会再污染 ESP32 协议解析。

### 修改原因
- 用户提供的串口日志证明 STM32 仍在发送系统状态文本，而 ESP32 侧只按 `A5 CMD LEN DATA CRC 5A` 解析二进制帧，导致两端链路没有真正打通。

### 问题修复类型
- 根本性修复

### 根因分析
- 根因是协议口和调试口混用：STM32 的 USART3 同时承担文本调试输出和协议帧收发，导致 ESP32 收到非协议文本后只能忽略或误判。
- 本次先把默认文本输出关掉，消除协议串口上的污染源，再逐步只保留 `0x90/0x91/0xA0` 这类协议帧。

### 工程原则应用
- KISS：用一个开关收敛文本输出，不重写现有状态机。
- YAGNI：不新增额外调试协议，只保留当前协议链路需要的二进制帧。
- DRY：复用已有 `UartConsole` 发送路径，避免新增一套并行串口模块。
- SOLID：协议口与调试输出边界更清晰，减少职责混杂。

### 问题确认情况
- 已确认 STM32 当前通过 USART3 周期性输出系统状态文本。
- 已确认 ESP32 协议解析只接受 `A5` 帧头的二进制协议。

### 风险评估
- 关闭文本输出后，USART3 不再适合直接做串口命令行调试。
- 若现场仍需文本调试，应改用其他串口或在编译期/初始化时显式开启文本输出。

### 验证方式
- 重新编译 STM32 后，USART3 不应再主动输出 `OK SmartWardrobe Ready` 或系统状态文本。
- ESP32 串口日志应只看到协议帧相关的 `A5 ... 5A` 数据或对应 MQTT 上报。

## 2026-06-18 16:17:34

### 修改类型
修复 / 根本性修复

### 涉及文件
- `Src/main.c`
- `APP/Inc/uart_console.h`
- `APP/Src/uart_console.c`
- `APP/Inc/cmd_dispatch.h`
- `APP/Src/cmd_dispatch.c`
- `修改日志/修改日志.md`

### 修改内容
- 将 STM32 的 USART3 接收入口扩展为兼容 ESP32 的 `A5 CMD LEN DATA CRC 5A` UART 二进制帧协议。
- 新增 STM32 对 `0x10` 存衣服、`0x11` 取衣服、`0x20` 读状态命令的解析。
- 将 `0x10` 映射到已有 `AXIS PLACE_CLOTH`，将 `0x11` 映射到已有 `AXIS TAKE_CLOTH`，不重写底层运动流程。
- STM32 动作完成后按协议回 `0x90`，故障或不支持的位置按协议回 `0x91`。
- 新增 `0xA0` 状态上报帧，返回 RAM 中维护的衣物数量和系统运行时长。
- 保留原文本串口命令能力：非 `0xA5` 开头的数据仍按原来的命令行方式处理，便于现场调试。

### 修改原因
- ESP32 侧已经按文档发送 UART 二进制帧，但 STM32 侧仍按文本命令行解析，导致 `A5 10 01 ...` 这类帧无法被 `CmdParser_Parse()` 正确识别。
- 阿里云链路依赖 ESP32 收到 STM32 的 `0x90`、`0x91`、`0xA0` 二进制响应帧；STM32 继续返回文本 `OK ...` 会导致 ESP32 无法按协议上报云端。

### 问题修复类型
- 根本性修复

### 根因分析
- 根因是 STM32 与 ESP32 的 UART 边界协议不一致：ESP32 已改为二进制帧协议，而 STM32 仍使用文本命令协议。
- 本次修复直接在 STM32 USART3 边界层识别并收发协议帧，再复用已有动作调度层，避免只在云端或 ESP32 侧做兼容造成链路继续不一致。
- 当前 STM32 只有 1 号衣服位的运动坐标，因此二进制协议层只接受 `DATA[0]=1` 的存取动作；其它位置会返回故障帧，避免把其它格位误执行成 1 号格动作。

### 工程原则应用
- KISS：只新增 UART 帧边界适配和完成事件出口，不重写电机、编码器、夹爪流程。
- YAGNI：不提前实现多格位坐标表，当前仅支持已有的 1 号衣服位。
- DRY：复用已有 `AXIS PLACE_CLOTH` / `AXIS TAKE_CLOTH` 状态机，避免复制一套动作流程。
- SOLID：串口协议解析、动作调度、底层驱动职责保持分离；本次只打通协议层和调度层之间的必要事件。

### 问题确认情况
- 已确认 ESP32 代码和协议文档使用 `A5 CMD LEN DATA CRC 5A` 二进制帧。
- 已确认 STM32 原入口 `UartConsole_PollLine()` 使用文本命令解析，不能直接识别 ESP32 下发的二进制帧。

### 风险评估
- 对原 USART3 文本调试命令有兼容保留，但同一串口同时连接 ESP32 时，文本日志仍可能被 ESP32 接收并忽略。
- 当前只支持 1 号衣服位；若阿里云下发 3 号、5 号等位置，STM32 会返回故障帧而不是误动作。
- `0x90` 在动作完成事件后发送，不是启动命令时立即发送；如果 ESP32 后续实现严格 3 秒超时重试，需要再在协议中区分“已接收”和“已完成”。

### 验证方式
- 使用 MinGW `gcc -fsyntax-only` 对 `main.c`、`uart_console.c`、`cmd_dispatch.c` 做语法检查。
- 联调时向 ESP32/STM32 UART 发送 `A5 10 01 01 10 5A`，STM32 应启动 1 号位存衣流程，完成后回复 `A5 90 01 01 90 5A`。
- 联调时发送 `A5 11 01 01 11 5A`，STM32 应启动 1 号位取衣流程，完成后回复 `A5 90 01 01 90 5A`。
- 联调时发送 `A5 20 00 20 5A`，STM32 应回复 `0xA0` 状态帧。

## 2026-06-18 15:24:50

### 修改类型
修复 / 逻辑修正

### 涉及文件
- `APP/Src/cmd_dispatch.c`
- `APP/COMMANDS.md`
- `APP/SERIAL_COMMANDS_EASY.md`
- `程序介绍.md`
- `修改日志/修改日志.md`

### 修改内容
- 按用户重新确认的取衣顺序修正 `AXIS TAKE_CLOTH` 状态机。
- 取衣流程改为：X=13331，Z=2436，Y=3291，等待 2 秒，夹爪抓取，Y 回 EX_KEY3，X=2445，Z=0，等待 2 秒，夹爪松开，等待 2 秒，最后 `ALL HOME`。
- 移除取衣流程中“抓取后额外等待 2 秒”步骤。
- 移除取衣流程中回到取放区后再执行 `Y=3433` 的步骤。
- 同步更新命令文档、串口速查和程序版本号 `SmartWardrobe-STM32F407 v1.4.10`。

### 修改原因
- 用户明确指出当前取衣逻辑应以最新确认的顺序为准，抓取后应先 Y 回行程开关，再移动 X 和 Z，之后延迟 2 秒松爪并回零。

### 问题修复类型
- 根本性修复

### 根因分析
- 之前实现混合了两版需求：既保留了抓取后的额外等待，又在回到取放区后执行 `Y=3433`。
- 最新确认的取衣流程不包含这两步，因此状态机与现场动作要求不一致。

### 工程原则应用
- KISS：只调整取衣状态机顺序，不改动底层编码器、夹爪和回零实现。
- YAGNI：不引入新的点位管理或多衣位表功能。
- DRY：继续复用现有编码器到位复核和 Y 回 EX_KEY3 复核逻辑。
- SOLID：流程调度层负责动作顺序，底层驱动职责保持不变。

### 问题确认情况
- 用户已明确给出最新取衣顺序，并说明该顺序才是正确逻辑。

### 风险评估
- 取衣流程抓取后不再额外等待 2 秒；夹爪控制仍以 Modbus 写命令返回成功为准，不等于机械夹紧力传感确认。
- 回到取放区后不再执行 `Y=3433`，Y 轴会保持在 EX_KEY3 行程开关位置直到最后 `ALL HOME`。

### 验证方式
- 使用 `gcc -fsyntax-only -DSTM32F407xx ... APP/Src/cmd_dispatch.c` 做语法检查。
- 空载运行 `AXIS TAKE_CLOTH RPM=30 TOL=2`，观察动作顺序是否为 X、Z、Y、等待、夹爪、Y 回行程、X、Z、等待、松爪、等待、ALL HOME。

## 2026-06-18 15:04:16

### 修改类型
修复 / 根本性修复

### 涉及文件
- `APP/Src/cmd_dispatch.c`
- `程序介绍.md`
- `修改日志/修改日志.md`

### 修改内容
- 将放衣服/取衣服自动流程中的轴等待逻辑从“电机不忙就进入下一步”改为“电机不忙后必须复核编码器已到达或越过目标计数”。
- 为 Y 轴回行程动作增加 EX_KEY3 到位复核，避免 Y 轴异常停止但未压到行程开关时继续下一步。
- `AXIS TAKE_CLOTH` 的 X 轴到 1 号位 `13331` 和回取放点 `2445` 增加失败中止：未确认到位会输出 `TAKE_CLOTH_SLOT_X_NOT_REACHED` 或 `TAKE_CLOTH_PICK_X_NOT_REACHED`。
- 同步将固件版本号更新为 `SmartWardrobe-STM32F407 v1.4.9`。

### 修改原因
- 用户反馈 `AXIS TAKE_CLOTH RPM=30 TOL=2` 实际运行中 X 轴有时没有动作，需要检查取衣流程逻辑。

### 问题修复类型
- 根本性修复

### 根因分析
- 原流程启动 X 轴后，下一状态只检查 M1 是否处于 RUN/RAMP 状态；如果 M1 因编码器方向错误、堵转、状态异常或其它原因停止，流程会把“不忙”误当作“到位”，继续执行 Z/Y 后续动作。
- 本次在状态机层增加编码器目标复核，确保自动流程只有在目标点确认完成后才进入下一步。

### 工程原则应用
- KISS：复用现有编码器读数、目标计数和行程开关检测，不重写底层电机控制。
- YAGNI：只修复当前自动流程的到位确认问题，不额外增加复杂点位管理功能。
- DRY：放衣服和取衣服共用同一套轴到位复核和 Y 回行程复核 helper。
- SOLID：状态机负责流程安全确认，底层电机/编码器模块职责不变。

### 问题确认情况
- 已从代码确认自动流程原本存在“只看 busy、不确认到位”的逻辑缺陷。
- `TOL=2` 下如果 EC1 本来就在目标计数 ±2 内，X 不动作仍是正常“已到位”行为；本次修复的是异常停止也继续下一步的问题。

### 风险评估
- 改动会让自动流程更严格：如果某轴停止后未确认到位，会直接报错并中止，不再继续后续动作。
- 现场如果存在较大机械惯性越过目标，仍按原编码器闭环语义允许“越过目标”视为完成。

### 验证方式
- 使用 `gcc -fsyntax-only -DSTM32F407xx ... APP/Src/cmd_dispatch.c` 做语法检查。
- 空载运行 `AXIS TAKE_CLOTH RPM=30 TOL=2`，观察 X 到 `13331`、回 `2445` 后才进入后续轴动作。
- 故意断开或反接 EC1/让 M1 堵转时，应输出对应 `TAKE_CLOTH_*_NOT_REACHED` 或底层 `M1_ENC_*` 错误，并停止自动流程。

## 2026-06-18 14:30:08

### 修改类型
功能新增 / 分阶段修复

### 涉及文件
- `APP/Inc/cmd_parser.h`
- `APP/Src/cmd_parser.c`
- `APP/Src/cmd_dispatch.c`
- `APP/COMMANDS.md`
- `APP/SERIAL_COMMANDS_EASY.md`
- `程序介绍.md`
- `修改日志/修改日志.md`

### 修改内容
- 新增 `AXIS TAKE_CLOTH [RPM=30] [TOL=36]` 取衣服顺序流程命令。
- 明确 1 号衣服位为编码器计数 `X=13331,Y=3291,Z=2436`，取放交换点为编码器计数 `X=2445,Y=3433,Z=0`。
- 取衣流程按单轴顺序执行：X 到 13331，Z 到 2436，Y 到 3291，等待 2 秒，夹爪抓取并等待 2 秒，Y 回 EX_KEY3，X 到 2445，Z 到 0，Y 到 3433，等待 2 秒，夹爪松开并等待 2 秒，最后执行 `ALL HOME`。
- 将 `AXIS PLACE_CLOTH` 文档说明补充为放衣服到 1 号衣服位，便于后续扩展 2 号、3 号衣服位。
- 启动 `PLACE_CLOTH` / `TAKE_CLOTH` 前增加 M1/M3/M4 忙碌互锁，避免普通 `RUN` 或 `HOME_EX` 尚未结束时启动自动流程。
- 固件版本号更新为 `SmartWardrobe-STM32F407 v1.4.8`。

### 修改原因
- 用户明确要求新增取衣服函数，按现场实测编码器计数逐轴运动，不能三轴一起动，且当前点位对应 1 号衣服位置。

### 问题修复类型
- 分阶段修复

### 根因分析
- 取衣服和放衣服一样，碰撞风险来自路径策略：三轴同时运动会形成对角路径，可能撞到杆子。
- 本次新增独立取衣顺序状态机，使用编码器绝对计数逐轴到位，只有最后复位阶段调用 `ALL HOME`。
- 现场流程还需要继续验证夹爪实际到位反馈和编码器异常中止策略；当前仍沿用已有夹爪写寄存器与编码器闭环机制。

### 工程原则应用
- KISS：复用现有编码器闭环、EX_KEY3 回行程和 `ALL HOME` 清零逻辑，不重写底层运动控制。
- YAGNI：只实现当前明确需要的 1 号衣服位取衣流程，不提前实现 2 号、3 号点位表。
- DRY：沿用放衣流程已有点位常量，并抽出 1 号衣服位常量，减少后续点位含义混乱。
- SOLID：命令解析、流程调度和底层电机/夹爪驱动仍保持各自职责；当前任务规模不强行重构为复杂路径规划器。

### 问题确认情况
- 用户已明确提供 1 号衣服位、取放交换点、运动顺序和“不能三轴一起动”的约束。
- 用户原始取衣顺序中未再次写出回到取放点后的 `Y=3433`，但用户同时明确给出取衣点 `X=2445,Y=3433,Z=0`；本次按完整点位补上单轴 `Y=3433` 后再松爪。

### 风险评估
- 新增 `AXIS TAKE_CLOTH` 命令，不改变原有手动运动命令行为。
- 取衣流程会控制 M1/M3/M4 和 M5 夹爪，现场首次测试应空载低速运行，并保持急停可用。
- 夹爪动作目前仍以 Modbus 写寄存器成功为准，不等同于机械夹取力或到位传感确认。

### 验证方式
- 重新构建 Keil 工程，确认 `0 Error(s), 0 Warning(s)`。
- 烧录后发送 `VER`，应返回 `OK VER SmartWardrobe-STM32F407 v1.4.8`。
- 空载发送 `AXIS TAKE_CLOTH RPM=10 TOL=100`，观察是否严格按 X、Z、Y、夹爪、Y 回行程、X、Z、Y、夹爪、ALL HOME 的顺序执行。
- 流程运行中测试 `AXIS STOP` / `AXIS ESTOP`，确认能中断 M1/M3/M4 和 Y 回行程动作。

## 2026-06-18 12:36:56

### 修改类型
功能新增 / 根本性修复

### 涉及文件
- `APP/Inc/cmd_parser.h`
- `APP/Src/cmd_parser.c`
- `APP/Src/cmd_dispatch.c`
- `APP/COMMANDS.md`
- `APP/SERIAL_COMMANDS_EASY.md`
- `程序介绍.md`
- `修改日志/修改日志.md`

### 修改内容
- 新增 `AXIS PLACE_CLOTH [RPM=30] [TOL=36]` 放衣服顺序流程命令。
- 按用户实测编码器计数写入取衣点 `X=2445,Y=3433,Z=0` 和挂衣点 `X=13331,Y=3291,Z=2436`。
- 放衣流程改为逐轴运动：先 X 到 2445，再 Y 到 3433，夹爪夹紧并等待 2 秒，Y 回 EX_KEY3，X 到 13331，Z 到 2436，Y 到 3291，夹爪松开并等待 2 秒，Y 回 EX_KEY3，最后才执行 `ALL HOME`。
- 流程运行中拒绝新的单电机/三轴运动命令，仅允许 `AXIS STOP`、`AXIS ESTOP`、`ALL STOP`、`ALL ESTOP` 中断。
- 补强放衣流程中断逻辑：`AXIS STOP/ESTOP` 会停止 M1/M3/M4 并取消 Y 回行程守护，避免流程处于 Y 回 EX_KEY3 阶段时只取消编码器闭环而未停 HOME 运动。
- 流程运行中同时拒绝手动 M5 夹爪命令，避免外部夹爪开合命令干扰放衣状态机。
- 固件版本号更新为 `SmartWardrobe-STM32F407 v1.4.7`。
- 同步更新正式命令文档、串口速查和程序介绍。

### 修改原因
- 用户明确说明放衣服时不能三轴一起动，否则会撞到杆子；现有 `AXIS ENC_MOVE` 是三轴同时编码器闭环运动，不适合作为放衣服流程。

### 问题修复类型
- 根本性修复

### 根因分析
- 碰撞风险根因不是点位本身，而是运动路径策略：同时移动 X/Y/Z 会让机械结构走对角路径，可能扫到杆子。
- 本次新增独立顺序状态机，所有取衣/挂衣点位均按 EC1/EC3/EC4 绝对编码器计数逐轴到位，只有最后复位阶段调用现有 `ALL HOME`，符合用户要求。

### 工程原则应用
- KISS：复用现有 `enc_move_start_absolute()`、`HOME_EX3` 行程开关检测和 `ALL HOME` 清零逻辑，不重写底层运动控制。
- YAGNI：只实现当前放衣服固定流程，不新增复杂路径规划器或点位表管理。
- DRY：复用现有编码器闭环、行程开关和夹爪接口，避免复制底层控制逻辑。
- SOLID：命令解析只增加动作枚举，流程控制集中在命令调度状态机中，底层电机/编码器模块职责不变。

### 问题确认情况
- 用户明确提供点位和运动顺序，并明确要求流程中不能三轴一起动，只有最后复位指令可以三轴一起动。

### 风险评估
- 新增 `AXIS PLACE_CLOTH` 命令，不改变原有 `AXIS MOVE` 与 `AXIS ENC_MOVE` 行为。
- 风险集中在现场点位方向、Y 轴回 EX_KEY3 路径和夹爪动作寄存器是否已调通；夹爪通信失败时流程会输出 `WARN` 并继续，便于先验证运动路径。

### 验证方式
- 已通过 Keil MDK 命令行重构建 `SmartWardrobeCode`，结果为 `0 Error(s), 0 Warning(s)`。
- 烧录后发送 `VER`，应返回 `OK VER SmartWardrobe-STM32F407 v1.4.7`。
- 先空载发送 `AXIS PLACE_CLOTH RPM=20 TOL=36`，观察是否严格按 X、Y、夹爪、Y 回行程、X、Z、Y、夹爪、Y 回行程、ALL HOME 的顺序执行。
- 流程运行中测试 `AXIS STOP` 和 `AXIS ESTOP`，尤其在 Y 回 EX_KEY3 阶段确认可立即中断。
- 流程运行中发送 M5 夹爪命令，应返回 `ERR ... PLACE_CLOTH_BUSY`。

## 2026-06-18 09:51:09

### 修改类型
修复 / 文档同步

### 涉及文件
- `APP/Src/motor_hw.c`
- `Src/gpio.c`
- `Inc/main.h`
- `程序介绍.md`
- `修改日志/修改日志.md`

### 修改内容
- 清理 M5 仍被描述为 DM542 步进驱动的旧注释，改为说明 M5 步进输出已不再由命令使用，当前通过 UART4 控制电夹爪。
- 在 `程序介绍.md` 中补充 `yjzk_gripper.c/.h` 模块说明。
- 将 `程序介绍.md` 中三轴/M3 旋转限位说明修正为三轴/M2 旋转限位。
- 移除 `程序介绍.md` 常用命令中的 `EC5 STATUS`，避免误导现场继续查询已停用的 EC5。
- 将 `程序介绍.md` 当前版本号同步为 `SmartWardrobe-STM32F407 v1.4.6`。

### 修改原因
- 当前代码和命令文档已经将 M5 改为 UART4 电夹爪通道，EC5 已停用，但部分注释和程序介绍仍残留旧的 M5 步进/DM542/EC5 信息，容易导致现场调试按旧硬件语义操作。

### 问题修复类型
- 根本性修复

### 根因分析
- 6 月 18 日新增 M5 UART4 电夹爪实现后，源码、Keil 工程和命令文档已基本同步，但程序介绍与少量底层注释没有一起更新，导致“事实来源”不一致。
- 本次直接修正残留说明，使文档与当前实现保持一致，而不是增加额外解释绕开旧信息。

### 工程原则应用
- KISS：只修正已确认不一致的文档和注释，不改动运动控制逻辑。
- YAGNI：不新增额外调试命令或配置项。
- DRY：让程序介绍、命令文档和源码注释指向同一硬件事实。
- SOLID：文档与注释同步不涉及架构设计，不强行套用复杂原则。

### 问题确认情况
- 已通过源码与文档检索确认 `M5 GRIP_*`、`UART4`、`yjzk_gripper.c/.h` 已存在，且 `EC5` 在命令文档中标注为停用；残留问题集中在 `程序介绍.md` 和少量注释。

### 风险评估
- 仅修改文档和注释，不改变固件二进制逻辑；无明显运行风险。

### 验证方式
- 使用 `rg "EC5 STATUS|v1\.3\.4|M5 uses DM542|M1~M5: active low" 程序介绍.md APP/COMMANDS.md APP/SERIAL_COMMANDS_EASY.md APP/Src/motor_hw.c Src/gpio.c Inc/main.h` 检查当前文档和源码注释中的旧描述是否已清理。
- 查看 Keil 构建日志 `MDK-ARM/SmartWardrobeCode/SmartWardrobeCode.build_log.htm`，确认最近构建结果为 `0 Error(s), 0 Warning(s)`。

## 2026-06-15 18:12:00

### 修改类型
修改 / 文档补充

### 涉及文件
- `6.15星期一.txt`
- `修改日志/修改日志.md`

### 修改内容
- 在 `6.15星期一.txt` 中补充 v1.4.6 测试指令对应的大概位移。
- 明确 `360 count ≈ 5cm`、`720 count ≈ 10cm`、`36 count ≈ 5mm`。
- 区分 `AXIS ENC_MOVE` 的绝对目标计数和 `M1/M3/M4 ENC_MOVE` 的相对移动计数。

### 修改原因
- 用户要求记录运行这些测试指令时大概会移动多少厘米。

### 问题修复类型
- 不适用

### 根因分析
- 本次为测试记录补充说明，不涉及程序缺陷修复。

### 工程原则应用
- KISS：直接在原记录文件中补充位移换算和对应指令。
- YAGNI：不新增额外文件。
- DRY：沿用现场确认的计数与位移比例。
- SOLID：文档补充不涉及架构设计。

### 问题确认情况
- 用户明确要求补充指令对应的移动厘米数。

### 风险评估
- 仅文档更新，不影响固件运行逻辑。

### 验证方式
- 打开 `6.15星期一.txt`，确认每条测试指令旁边有对应位移说明。

## 2026-06-15 18:05:00

### 修改类型
创建 / 文档记录

### 涉及文件
- `6.15星期一.txt`
- `修改日志/修改日志.md`

### 修改内容
- 创建 `6.15星期一.txt`，记录今天关于 ALL HOME、M2 旋转轴、XYZ 坐标、编码器闭环移动和 v1.4.6 精度测试指令的关键对话内容。
- 重点记录 `VER`、`ALL HOME RPM=120`、`AXIS ENC_MOVE X=720 Y=720 Z=720 RPM=30 TOL=36`、小距离测试和急停命令。

### 修改原因
- 用户要求将今天对话内容写成 txt 文件放在当前文件夹，尤其记录 v1.4.6 应发送哪些指令测试精度。

### 问题修复类型
- 不适用

### 根因分析
- 本次为对话与测试步骤归档，不涉及程序缺陷修复。

### 工程原则应用
- KISS：用单个 txt 文件集中记录现场测试最关键的信息。
- YAGNI：不额外创建复杂文档结构。
- DRY：复用今天已确认的最终测试指令，避免散落在多个说明中。
- SOLID：文档归档不涉及架构设计。

### 问题确认情况
- 用户明确要求创建记录文件并指定文件名为 `6.15星期一`。

### 风险评估
- 仅新增记录文件并更新修改日志，不影响固件运行逻辑。

### 验证方式
- 打开 `6.15星期一.txt`，确认包含 v1.4.6 精度测试指令和注意事项。

## 2026-06-15 17:45:00

### 修改类型
修正

### 涉及文件
- `APP/Src/cmd_dispatch.c`
- `APP/COMMANDS.md`
- `APP/SERIAL_COMMANDS_EASY.md`
- `程序介绍.md`
- `修改日志/修改日志.md`

### 修改内容
- 将 `AXIS ENC_MOVE` 默认容差从 `720 count` 修正为 `36 count`。
- 将文档示例从 `AXIS ENC_MOVE X=14400 Y=14400 Z=14400 RPM=60 TOL=720` 修正为 `AXIS ENC_MOVE X=720 Y=720 Z=720 RPM=30 TOL=36`。
- 文档按现场实测说明：`720 count` 约等于 `10cm`，`36 count` 约等于 `5mm`。
- 固件版本号更新为 `SmartWardrobe-STM32F407 v1.4.6`。

### 修改原因
- 现场测试表明 `AXIS ENC_MOVE X=1440 ... TOL=720` 会在 `EC=720` 时提前判定到位；`TOL=720` 实际是约 10cm 目标的一半，不能作为 ±5mm 容差。

### 问题修复类型
- 根本性修正

### 根因分析
- 前一版按理论 `1440 count = 10mm` 写入示例和默认容差，但现场实测比例为 `720 count ≈ 10cm`；单位换算错误导致目标值过大、默认容差过大。

### 工程原则应用
- KISS：只修正默认容差和文档示例，不改动已验证的编码器闭环控制逻辑。
- YAGNI：暂不加入额外比例换算层，先按现场实测计数直接控制。
- DRY：同步更新正式命令文档、速查和程序介绍。
- SOLID：不涉及架构调整。

### 问题确认情况
- 用户提供现场数据确认 `X=1440 TOL=720` 最终停在 `EC=720`，且该运动距离约为 10cm。

### 风险评估
- 影响 `AXIS ENC_MOVE` 未显式提供 `TOL` 时的默认到位容差；显式传入 `TOL` 的命令按用户参数执行。

### 验证方式
- 烧录后发送 `VER`，应返回 `OK VER SmartWardrobe-STM32F407 v1.4.6`。
- 回零后发送 `AXIS ENC_MOVE X=720 Y=720 Z=720 RPM=30 TOL=36`，三轴应在 EC1/EC3/EC4 接近 720 count 时停止。

## 2026-06-15 17:20:00

### 修改类型
修改 / 功能增强

### 涉及文件
- `APP/Src/cmd_dispatch.c`
- `APP/COMMANDS.md`
- `APP/SERIAL_COMMANDS_EASY.md`
- `程序介绍.md`
- `修改日志/修改日志.md`

### 修改内容
- 将原先仅支持 M4/EC4 的 `ENC_MOVE` 扩展为 `M1/M3/M4 ENC_MOVE`，分别使用 EC1/EC3/EC4 做相对编码器计数闭环到位。
- 新增 `AXIS ENC_MOVE X=... Y=... Z=... RPM=... [TOL=...]`，使用绝对编码器计数闭环移动三轴：`X=EC1`、`Y=EC3`、`Z=EC4`。
- `AXIS ENC_MOVE` 默认容差设置为 720 count，对应皮带 10mm/转、1440 count/转时约 5mm。
- 保留旧 `AXIS MOVE` 开环电机步数规划，不直接改变原命令语义。
- `AXIS STOP` / `AXIS ESTOP` 同步停止新增的三轴编码器闭环动作。
- 固件版本号更新为 `SmartWardrobe-STM32F407 v1.4.5`。

### 修改原因
- 用户确认编码器 A/B 线已通过硬件调整正常，并希望采用编码器计数闭环方案提升皮带传动定位精度。

### 问题修复类型
- 分阶段修复

### 根因分析
- 原 `AXIS MOVE` 使用电机累计步数坐标，不能直接反映皮带传动末端的实际编码器反馈；皮带弹性、打滑、负载冲击等会导致开环步数与实际位移偏差。
- 本阶段先复用现有编码器反馈和卡滞/方向检测逻辑，增加 M1/M3/M4 的编码器到位控制，为后续是否替换默认 `AXIS MOVE` 或增加 S 曲线做现场验证。

### 工程原则应用
- KISS：优先扩展现有 `ENC_MOVE` 机制，不重写整个三轴规划器。
- YAGNI：暂不加入滑差补偿表、S 曲线和反向间隙补偿，先验证编码器闭环主路径。
- DRY：用统一 `g_enc_move[]` 状态数组复用 M1/M3/M4 编码器闭环检测。
- SOLID：命令调度层负责命令状态机，编码器读取仍由 `EncoderCtrl` 负责，电机执行仍由 `MotorCtrl` 负责。

### 问题确认情况
- 用户已确认接线正常，并确认采用本小姐推荐的编码器闭环优先方案。

### 风险评估
- 新增 `AXIS ENC_MOVE`，旧 `AXIS MOVE` 保持不变；主要风险集中在现场各轴编码器方向是否与 `CW` 增加计数一致。
- 若某轴编码器方向与电机方向相反，运行中会触发 `M*_ENC_WRONG_DIR` 并急停对应电机。

### 验证方式
- 烧录后发送 `VER`，应返回 `OK VER SmartWardrobe-STM32F407 v1.4.5`。
- 分别测试 `M1 ENC_MOVE DIR=CW RPM=20 CNT=1440 TOL=720`、`M3 ENC_MOVE ...`、`M4 ENC_MOVE ...`，确认到位后返回 `OK Mx ENC_MOVE_DONE`。
- 回零并清 EC1/EC3/EC4 后测试 `AXIS ENC_MOVE X=14400 Y=14400 Z=14400 RPM=60 TOL=720`，确认三轴按 EC1/EC3/EC4 到位停止。

## 2026-06-15 16:45:00

### 修改类型
修改 / 文档补充

### 涉及文件
- `APP/SERIAL_COMMANDS_EASY.md`
- `ALL_HOME回零逻辑对话记录.md`
- `修改日志/修改日志.md`

### 修改内容
- 在串口命令速查中补充 `ALL HOME RPM=120` 的 M1/M3/M4 回零、跳过已触发行程开关轴、完成后清零 EC1/EC3/EC4 与 XYZ 的说明。
- 补充 `M2 ABS_*` 与 `M2 ROT_*` 命令速查，明确二者都作用于 M2，但用途不同。
- 明确 `AXIS MOVE / AXIS ZERO / AXIS LIMIT_SET` 仍只作用于 `X=M1、Y=M3、Z=M4`，M2 不参与 XYZ 坐标。
- 更新对话记录，记录用户最新确认旋转轴为 M2。

### 修改原因
- 用户最新确认旋转轴可以改成 M2，因为旋转电机对应特殊编码器 2；现场调试文档需要同步，避免继续按 M3 或 M5 发送旋转轴命令。

### 问题修复类型
- 根本性修复

### 根因分析
- 源码和正式命令文档已迁移到 M2，但简易串口速查缺少 `M2 ABS_*`、`M2 ROT_*` 和 `ALL HOME` 的最新说明，容易造成现场测试按旧命令操作。

### 工程原则应用
- KISS：只补充现场调试需要的命令说明，不扩大源码改动。
- YAGNI：没有新增命令或行为，只同步已有实现的文档。
- DRY：让简易速查与正式命令文档保持同一事实来源。
- SOLID：文档更新不涉及架构设计，不强行套用。

### 问题确认情况
- 用户已明确确认旋转轴改为 M2。

### 风险评估
- 仅文档与对话记录更新，不改变固件运行逻辑；无明显运行风险。

### 验证方式
- 阅读 `APP/SERIAL_COMMANDS_EASY.md`，确认 `ALL HOME`、`M2 ABS_*`、`M2 ROT_*`、`X=M1/Y=M3/Z=M4` 的说明一致。
- 烧录后发送 `M2 ROT_STATUS` 应返回 `ROT M2 STEP=...`；发送 `M3 ROT_STATUS` 或 `M5 ROT_STATUS` 应返回 `ERR ... M2_ONLY`。

## 2026-06-15 16:31:36

### 修改类型
修改 / 修正

### 涉及文件
- `APP/Inc/axis_coord.h`
- `APP/Src/axis_coord.c`
- `APP/Src/axis_limit.c`
- `APP/Src/cmd_dispatch.c`
- `APP/COMMANDS.md`
- `程序介绍.md`
- `修改日志/修改日志.md`

### 修改内容
- 将旋转轴从临时确认的 M5 修正为用户最新确认的 M2。
- 新增统一旋转轴电机宏 `AXIS_ROT_MOTOR_ID = MOTOR_ID_2`，旋转轴步数跟踪和旋转限位均使用该宏。
- `M2 ROT_STATUS / ROT_ZERO / ROT_SET / ROT_SAVE / ROT_GET / ROT_LIMIT_SET / ROT_LIMIT_GET` 作为旋转轴命令入口。
- 旋转轴限位触发时急停 M2，不再影响 M3/Y 轴。
- `AXIS ZERO` 仅清 `X=M1、Y=M3、Z=M4` 三轴坐标，不清 M2 旋转轴步数。
- 固件版本号更新为 `SmartWardrobe-STM32F407 v1.4.4`。

### 修改原因
- 用户确认旋转轴对应 M2，且 M2 对应特殊的 RS485 绝对值编码器；因此旋转轴相关命令和限位不应绑定 M3 或 M5。

### 问题修复类型
- 根本性修复

### 根因分析
- 上一轮为了避免 M3/Y 轴与旋转轴冲突，曾将旋转轴临时迁移到 M5；用户最新确认实际旋转轴为 M2。
- 若旋转轴继续绑定 M5，会导致 `ROT_*` 命令控制对象与现场硬件不一致。
- 若旋转轴继续绑定 M3，会干扰 `Y=M3` 的 `AXIS MOVE / AXIS LIMIT`。

### 工程原则应用
- KISS：使用一个宏集中定义旋转轴电机，减少后续再次调整时的改动范围。
- YAGNI：未改写 M2 ABS 绝对值编码器协议，只迁移旋转轴步数/限位绑定。
- DRY：继续复用原有 ROT 状态、保存和限位逻辑，避免复制一套新实现。
- SOLID：坐标轴映射仍由 `axis_coord.c` 管理，旋转轴电机选择通过明确宏表达。

### 问题确认情况
- 用户明确确认旋转轴改为 M2，因为旋转电机对应特殊编码器 2。

### 风险评估
- `M2 ABS_*` 与 `M2 ROT_*` 都作用于 M2，但前者基于 RS485 绝对值编码器，后者当前仍是开环步数基线/限位逻辑；现场使用时应区分命令含义。
- M2 不参与 `AXIS MOVE / AXIS ZERO / AXIS LIMIT` 的 `X/Y/Z` 三轴坐标，三轴仍为 `X=M1、Y=M3、Z=M4`。

### 验证方式
- 编译固件，确认无语法错误。
- 烧录后发送 `VER`，应返回 `OK VER SmartWardrobe-STM32F407 v1.4.4`。
- 发送 `M2 ROT_STATUS`，应返回 `ROT M2 STEP=...`。
- 发送 `M3 ROT_STATUS`，应返回 `ERR ... M2_ONLY`，确认 M3 不再作为旋转轴。
- 测试 `AXIS MOVE` 时确认 Y 轴仍由 M3 执行，且不被 M2 旋转限位干扰。

## 2026-06-15 15:32:27

### 修改类型
修改

### 涉及文件
- `APP/Src/cmd_dispatch.c`
- `APP/Src/axis_coord.c`
- `APP/COMMANDS.md`
- `APP/SERIAL_COMMANDS_EASY.md`
- `程序介绍.md`
- `ALL_HOME回零逻辑对话记录.md`
- `修改日志/修改日志.md`

### 修改内容
- 为 `ALL HOME RPM=xx` 增加整组回零完成跟踪：M1/M3/M4 全部到达行程开关后，统一清零 EC1、EC3、EC4。
- 在 EC1/EC3/EC4 清零后调用三轴坐标归零，使 `X/Y/Z` 坐标同步回到 0。
- 将三轴坐标映射修正为现场测试结果：`X=M1`、`Y=M3`、`Z=M4`。
- M2 的 RS485 绝对值编码器不参与 `ALL HOME` 后的编码器清零。
- 当 M1/M3/M4 已全部在行程开关时，`ALL HOME` 会立即执行 EC1/EC3/EC4 与 XYZ 清零，并返回 `ALREADY_DONE`。
- 固件版本号更新为 `SmartWardrobe-STM32F407 v1.4.3`。

### 修改原因
- 用户要求发送 `ALL HOME RPM=xx` 后，等参与回零的 M1/M3/M4 都回到行程开关位置，再将编码器 1、3、4 的计数和 XYZ 坐标清零，同时不要清零特殊的 M2 绝对值编码器。

### 问题修复类型
- 根本性修复

### 根因分析
- 原逻辑只负责各轴到行程开关后独立急停，没有整组完成后的统一“机械原点确认 -> 编码器归零 -> 坐标归零”动作。
- 原坐标映射仍是旧规则 `X=M1、Y=M4、Z=M2`，与现场确认的 `X=M1、Y=M3、Z=M4` 不一致；如果不修正，`XYZ` 归零会错误包含 M2 并遗漏 M3。
- 本次通过整组完成掩码跟踪 M1/M3/M4 到位状态，只在三轴全部到位后执行清零，避免某个轴未回到原点时提前归零。

### 工程原则应用
- KISS：在现有 `HOME_EX` 安全轮询内增加整组完成判断，不引入新的任务系统。
- YAGNI：只清零当前要求的 EC1/EC3/EC4 与 XYZ，不增加额外配置项。
- DRY：复用 `EncoderCtrl_Clear()`、`AxisCoord_ZeroNow()` 和现有行程开关守护数组。
- SOLID：清零动作封装在命令调度层辅助函数中，坐标映射仍由 `axis_coord.c` 统一负责。

### 问题确认情况
- 用户明确确认现场三轴为 `X=M1`、`Y=M3`、`Z=M4`，并明确要求 M2 特殊编码器不归零。
- 源码已确认 M2 特殊编码器为 RS485 绝对值编码器，通过 `M2 ABS_STATUS` / `M2 ABS_ZERO` / `M2 ABS_MOVE` 使用，不属于本次 EC1/EC3/EC4 清零范围。

### 风险评估
- 会改变 `AXIS MOVE/STATUS/ZERO/LIMIT` 的三轴电机映射，使其符合现场测试结果；若旧上位机仍按 `Y=M4、Z=M2` 使用，需要同步调整。
- `ALL HOME` 完成后会自动清零 EC1/EC3/EC4 和 XYZ，现场测试时应确认三轴确实已经压到各自行程开关。

### 验证方式
- 编译固件，确认无语法错误。
- 烧录后发送 `VER`，应返回 `OK VER SmartWardrobe-STM32F407 v1.4.3`。
- 测试 `ALL HOME RPM=120`：M1/M3/M4 全部到位后应额外输出 `OK ALL HOME_ZERO_DONE EC=1,3,4 AXIS=XYZ`。
- 再查询 `EC1 STATUS`、`EC3 STATUS`、`EC4 STATUS` 和 `AXIS STATUS`，应接近或等于 0。
- 确认 `M2 ABS_STATUS` 的 RAW/DEG 不会因 `ALL HOME` 后清零动作被重置。

## 2026-06-15 14:32:08

### 修改类型
修改 / 创建

### 涉及文件
- `APP/Src/cmd_dispatch.c`
- `APP/COMMANDS.md`
- `ALL_HOME回零逻辑对话记录.md`
- `修改日志/修改日志.md`

### 修改内容
- 将 `ALL HOME RPM=xx` 从“任意参与轴行程开关已触发就整体拒绝运行”改为“已触发的轴跳过，未触发的 M1/M3/M4 继续回到行程开关”。
- 当 M1/M3/M4 全部已在行程开关时，返回 `OK ALL HOME ALREADY_DONE`，不启动任何电机。
- 在 `ALL HOME` 成功响应中增加 `RUN` 和 `SKIP_LOW` 统计，便于现场判断启动了几个轴、跳过了几个已触发行程开关的轴。
- 更新命令文档中 `ALL HOME RPM=120` 的说明。
- 创建本次对话记录文件。
- 固件版本号更新为 `SmartWardrobe-STM32F407 v1.4.2`。

### 修改原因
- 用户要求发送 `ALL HOME RPM=xx` 时，如果 M1、M3、M4 中有一个或两个已经在行程开关位置，其他未触发行程开关的步进电机仍应继续回到行程开关。

### 问题修复类型
- 根本性修复

### 根因分析
- 原逻辑在启动任意电机前先统一扫描 M1/M3/M4 的行程开关，只要任意一个已触发就返回 `EX_KEY_LOW`，导致其他仍未回原点的轴也无法执行回原点。
- 本次直接调整 `ALL HOME` 的调度规则：按轴判断，已触发的轴不再视为全局错误，而是作为已到位轴跳过；未触发的轴正常启动回原点。

### 工程原则应用
- KISS：只修改 `ALL HOME` 分支的启动调度，不改底层电机控制和单轴 `HOME_EX` 行为。
- YAGNI：未新增额外配置命令或复杂状态机，只实现当前现场需要的跳过已到位轴。
- DRY：继续复用现有 `g_rev_exkey_guards`、`rev_exkey_is_blocked_low()` 和 `MotorCtrl_Run()`。
- SOLID：当前为嵌入式 C 命令调度小范围修改，不强行套用复杂架构；保持行程开关判断和电机启动职责清晰。

### 问题确认情况
- 已通过源码确认原 `ALL HOME` 在任意参与轴触发行程开关时会返回 `ERR 212 EX_KEY_LOW`，与用户描述的现场需求不符。
- 用户已明确要求修改为跳过已在行程开关的轴并继续启动其他轴。

### 风险评估
- 影响范围限定在 `ALL HOME` 命令；单轴 `M1 HOME_EX1`、`M3 HOME_EX3`、`M4 HOME_EX4` 仍保持原有“已触发则拒绝启动”的保护行为。
- 已在行程开关上的轴不会被启动，未触发的轴会继续按 `CCW` 方向回原点。

### 验证方式
- 编译固件，确认无语法错误。
- 烧录后发送 `VER`，应返回 `OK VER SmartWardrobe-STM32F407 v1.4.2`。
- 分别测试 M1/M3/M4 无轴触发、一个轴触发、两个轴触发、三个轴全触发时的 `ALL HOME RPM=120` 行为。

## 2026-05-29 17:01:58

### 修改类型
新增 / 修改

### 涉及文件
- `APP/Inc/rs485_abs_encoder.h`
- `APP/Src/rs485_abs_encoder.c`
- `APP/Inc/cmd_parser.h`
- `APP/Src/cmd_parser.c`
- `APP/Src/cmd_dispatch.c`
- `APP/COMMANDS.md`
- `程序介绍.md`
- `修改日志/修改日志.md`

### 修改内容
- 新增 `M2 ABS_ZERO` 命令。
- 新增 RS485 Modbus 写单寄存器功能，用于向编码器寄存器 `0x0008` 写入 `1`，将当前位置设为编码器内部零点。
- `M2 ABS_ZERO` 写入成功后会再次读取 M2 绝对值编码器，并返回当前 `RAW/DEG`。
- 固件版本更新为 `SmartWardrobe-STM32F407 v1.4.1`。
- 更新命令文档和程序介绍。

### 修改原因
- 用户需要自己规定一个指定零点，并让每次上电自动回到该位置。

### 问题修复类型
- 功能新增 / 根本性实现

### 根因分析
- 已有上电自动归零逻辑回到 `DEG=0`。
- 要让 `DEG=0` 对应用户规定的机械位置，最稳妥方式是使用编码器手册提供的“当前位置设为零点”寄存器，而不是在 MCU 侧叠加临时偏移。

### 工程原则应用
- KISS：直接复用编码器内置零点设定功能。
- YAGNI：只实现 M2 当前需要的零点标定命令，未加入多从站参数配置。
- DRY：复用已有 Modbus CRC、UART2 收发和 M2 状态读取逻辑。
- SOLID：RS485 写寄存器封装在编码器驱动层，命令层只负责触发和响应。

### 问题确认情况
- 手册确认寄存器 `0x0008` 写入 `1` 可设置当前编码器单圈值为 0。

### 风险评估
- `M2 ABS_ZERO` 会改变编码器内部零点，后续 `DEG=0` 和上电自动归零都会回到新位置。
- 使用前必须确保 M2 已经停在想要的机械零点位置。

### 验证方式
- Keil MDK 命令行编译通过：0 Error(s), 0 Warning(s)。
- 烧录后发送 `VER` 应返回 `OK VER SmartWardrobe-STM32F407 v1.4.1`。
- 将 M2 移到目标零点位置，发送 `M2 ABS_ZERO`，再发送 `M2 ABS_STATUS` 确认 `DEG` 接近 0。
- 重新上电，确认 M2 自动回到该零点。

## 2026-05-29 16:55:59

### 修改类型
新增 / 修改

### 涉及文件
- `APP/Src/cmd_dispatch.c`
- `APP/COMMANDS.md`
- `程序介绍.md`
- `修改日志/修改日志.md`

### 修改内容
- 新增 M2 上电自动归零状态机。
- 上电后延时约 2 秒，读取 M2 RS485 绝对值编码器。
- 若 M2 已在 `DEG=0` 附近，则输出 `OK M2 BOOT_HOME_DONE` 且不动作。
- 若不在零点附近，则以 `RPM=20` 自动选择较短方向回到已校准零点 `DEG=0`。
- 若编码器通信失败、M2 非空闲或电机启动失败，则输出对应 `M2_BOOT_HOME_*` 错误并不强行动作。
- 固件版本更新为 `SmartWardrobe-STM32F407 v1.4.0`。
- 更新命令文档和程序介绍。

### 修改原因
- 用户需要实现“上电后 M2 自动回到校准的零点”的功能。

### 问题修复类型
- 功能新增 / 根本性实现

### 根因分析
- M2 已接入绝对值编码器并完成按角度运动控制，校准零点可定义为编码器 `DEG=0`。
- 上电自动归零应复用现有 M2 ABS 到位判断、方向校验、通信失败和卡滞保护，而不是绕过保护直接运行电机。

### 工程原则应用
- KISS：通过上电延时状态机触发一次归零，不引入复杂任务系统。
- YAGNI：当前只实现 M2 上电回到 `DEG=0`，未增加多电机配置菜单。
- DRY：复用 M2 ABS 运动状态结构和安全检查逻辑。
- SOLID：归零启动逻辑放在命令调度安全层，RS485 读取仍由独立驱动负责。

### 问题确认情况
- 已确认 M2 RS485 编码器可读取角度，且用户明确要求上电自动回零。

### 风险评估
- 上电后 M2 会自动运动到零点，现场必须保证机械路径安全。
- 如果编码器通信失败或 M2 不空闲，固件不会强行动作。

### 验证方式
- Keil MDK 命令行编译通过：0 Error(s), 0 Warning(s)。
- 烧录后发送 `VER` 应返回 `OK VER SmartWardrobe-STM32F407 v1.4.0`。
- 上电后等待约 2 秒，观察是否输出 `OK M2 BOOT_HOME...`，并确认 M2 回到 `DEG=0` 附近。

## 2026-05-29 16:37:30

### 修改类型
修复

### 涉及文件
- `APP/Src/cmd_dispatch.c`
- `APP/COMMANDS.md`
- `程序介绍.md`
- `修改日志/修改日志.md`

### 修改内容
- 将 M2 RS485 绝对值编码器方向映射修正为：`DIR=CW` 时编码器 `RAW` 减少，`DIR=CCW` 时编码器 `RAW` 增加。
- 自动选择方向、方向错误检测、越过目标检测统一使用修正后的方向映射。
- 固件版本更新为 `SmartWardrobe-STM32F407 v1.3.9`。
- 更新命令文档和程序介绍中的 M2 ABS 方向说明。

### 修改原因
- 用户测试 `M2 ABS_MOVE ... DIR=CCW` 时电机只动一点点，且此前出现 `ERR 208 M2_ABS_WRONG_DIR RAW=127 TARGET_RAW=305`。
- 现象说明电机命令方向与编码器 RAW 增减方向和程序旧假设相反。

### 问题修复类型
- 根本性修复

### 根因分析
- 旧程序假设 `DIR=CW` 会让 M2 绝对值编码器 RAW 增加。
- 实机表现为 `DIR=CW` 时 RAW 减少，导致方向检测或越过目标检测过早触发，表现为“只动一点点就停”。

### 工程原则应用
- KISS：只修正 M2 ABS 方向映射，不关闭安全保护。
- YAGNI：未新增复杂配置命令，先按当前实机硬件关系固定映射。
- DRY：自动选方向、剩余距离和方向校验复用同一方向映射函数。
- SOLID：改动限定在命令调度层的 M2 ABS 运动判断逻辑。

### 问题确认情况
- 用户提供的 `M2_ABS_WRONG_DIR` 和“只动一点点”现象与方向映射相反一致。

### 风险评估
- 影响 M2 `ABS_MOVE` 的方向判断和自动选方向。
- 不影响普通 `M2 RUN/MOVE`、其他电机、EC1~EC5 TIM 编码器读取。

### 验证方式
- Keil MDK 命令行编译通过：0 Error(s), 0 Warning(s)。
- 烧录后发送 `VER` 应返回 `OK VER SmartWardrobe-STM32F407 v1.3.9`。
- 先发送 `M2 ABS_STATUS` 读取当前角度，再测试 `M2 ABS_MOVE DEG=... RPM=20 TOL=2`。

## 2026-05-29 15:41:24

### 修改类型
修复

### 涉及文件
- `APP/Src/rs485_abs_encoder.c`
- `修改日志/修改日志.md`

### 修改内容
- 将 RS485 Modbus 回复接收从固定读取 7 字节改为先读地址/功能码/字节数，再根据正常帧或异常帧继续读取剩余字节。
- 正常读寄存器回复继续按 7 字节解析；异常回复按 5 字节解析并返回 `EXCEPTION`。

### 修改原因
- 用户实测 `M2 ABS_STATUS` 返回 `ERR 208 RX_TIMEOUT`。
- 原实现固定等待 7 字节，若编码器返回 5 字节 Modbus 异常帧，会被误判为超时，不利于区分协议错误和完全无回复。

### 问题修复类型
- 根本性修复

### 根因分析
- Modbus RTU 正常回复和异常回复长度不同，驱动不应假设所有回复固定 7 字节。
- 分段接收可以准确区分“完全无回复”“异常回复”“CRC 错误”和“帧格式错误”。

### 工程原则应用
- KISS：只修正 Modbus 接收长度判断，不改动命令接口。
- YAGNI：未添加额外调试协议，先提升现有错误码有效性。
- DRY：继续复用同一个 CRC 校验函数。
- SOLID：修复限定在 RS485 编码器驱动层。

### 问题确认情况
- 已确认当前返回为 `RX_TIMEOUT`，但尚不能确定硬件完全无回复还是异常帧被旧逻辑误判；本次修改用于收敛诊断。

### 风险评估
- 对正常 7 字节回复兼容；异常帧会从 `RX_TIMEOUT` 变为更准确的 `EXCEPTION`。

### 验证方式
- Keil MDK 命令行编译通过：0 Error(s), 0 Warning(s)。
- 重新烧录后发送 `M2 ABS_STATUS`，根据返回继续判断接线/波特率/地址/寄存器问题。

## 2026-05-29 14:59:13

### 修改类型
修改 / 新增

### 涉及文件
- `APP/Inc/rs485_abs_encoder.h`
- `APP/Src/rs485_abs_encoder.c`
- `APP/Inc/cmd_parser.h`
- `APP/Src/cmd_parser.c`
- `APP/Src/cmd_dispatch.c`
- `Src/main.c`
- `Src/usart.c`
- `MDK-ARM/SmartWardrobeCode.uvprojx`
- `APP/COMMANDS.md`
- `程序介绍.md`

### 修改内容
- 新增 UART2/RS485 Modbus RTU 绝对值编码器读取模块，默认读取 M2 编码器地址 `1` 的位置寄存器 `0x0000`。
- 将 UART2 初始化为 `9600, 8N1`，并在主程序中启用 `MX_USART2_UART_Init()` 和 `Rs485AbsEncoder_Init()`。
- 新增 `M2 ABS_STATUS` 命令，用于读取 M2 绝对值编码器 `RAW/DEG`。
- 新增 `M2 ABS_MOVE DEG=n RPM=n [DIR=CW|CCW] [TOL=n]` 命令，用于让 M2 转到指定绝对角度。
- `M2 ABS_MOVE` 增加通信失败、方向反向、卡滞检测，到位或越过目标时自动急停 M2。
- 更新 Keil 工程文件，将 `rs485_abs_encoder.c` 加入编译。
- 更新命令文档和程序介绍。

### 修改原因
- 用户确认 BRT38-R0M1024-RT1 绝对值编码器通过 RS485-TTL 模块接入 UART2，并用于 M2，需要读取角度和转到指定角度。

### 问题修复类型
- 根本性修复 / 功能新增

### 根因分析
- 该编码器是 RS485 Modbus RTU 绝对值编码器，不能沿用原 TIM A/B 相编码器读取链路。
- 正确接入方式是通过 UART2 主动发送 Modbus 查询帧，校验返回 CRC 后将 0~1023 的绝对位置换算为角度。

### 工程原则应用
- KISS：新增独立 RS485 编码器模块，命令层只调用清晰接口。
- YAGNI：仅实现当前需要的 M2 读角度和按角度运动，未扩展多从站配置菜单。
- DRY：保留原 EC1~EC5 TIM 编码器链路，不复制原脉冲编码器逻辑。
- SOLID：保持串口协议读取、命令解析、电机运动控制职责分离。

### 问题确认情况
- 已确认硬件模块只有 TTL 串口侧 `VCC/GND/TXD/RXD` 与 RS485 侧 `A/B`，适合由 UART2 直接收发，无需额外 DE/RE 方向控制引脚。

### 风险评估
- UART2 波特率从 115200 改为 9600，UART2 现在专用于 M2 RS485 编码器。
- `M2 ABS_MOVE` 默认假设编码器 RAW 增加对应电机 `CW`；若实际相反，会触发 `M2_ABS_WRONG_DIR`，需要在命令中换方向或调整电机方向定义。

### 验证方式
- Keil MDK 命令行编译通过：0 Error(s), 0 Warning(s)。
- 烧录后先发送 `M2 ABS_STATUS`，手动转动 M2 观察 `RAW/DEG` 是否变化。
- 再低速测试 `M2 ABS_MOVE DEG=90 RPM=20`，观察到位后是否输出 `OK M2 ABS_MOVE_DONE`。

## 2026-05-24 20:25:00

### 修改类型
修复

### 涉及文件
- `Src/main.c`
- `修改日志/修改日志.md`

### 修改内容
- EC3 测试固件增加 1 秒自动输出一次 `EC3 STATUS` 状态。
- 串口命令解析增加尾部空格/Tab 裁剪，避免终端发送 `EC3 STATUS ` 时无法匹配。
- 增加简写命令 `STATUS` 和 `CLR`，便于排查串口命令输入问题。

### 修改原因
- 用户反馈发送 `EC3 STATUS` 没反应，需要先区分程序是否运行、USART3 TX 是否通、以及命令是否被正确接收。

### 问题修复类型
- 分阶段修复

### 根因分析
- 当前现象无法仅凭“没反应”确认是接线、串口参数、命令换行、RX 输入还是固件问题。
- 自动周期输出可以先验证固件运行和 USART3 发送链路；若能看到自动输出但命令无响应，再集中排查 RX 和终端换行。

### 工程原则应用
- KISS：通过自动状态输出建立最小可观察性，不引入复杂日志系统。
- YAGNI：仅增加 EC3 测试需要的状态输出和简写命令。
- DRY：复用原 `ec3_status_response` 状态格式化函数。
- SOLID：当前为测试固件诊断增强，不强行套用复杂架构。

### 问题确认情况
- 已确认用户现象为发送 `EC3 STATUS` 后串口无响应，但尚不能确定是 TX、RX、换行还是接线问题。

### 风险评估
- 测试固件会每秒自动输出一行 EC3 状态，便于调试，但不适合作为正式业务固件长期使用。

### 验证方式
- 烧录后不发送任何命令，串口应每秒收到一行 `EC3 ...`。
- 若能看到自动输出，再发送 `PING`、`STATUS`、`EC3 STATUS` 验证 RX。
- 已重新 Rebuild `SmartWardrobe`，结果 `0 Error(s), 0 Warning(s)`，测试固件代码体积 `Code=16078`。

## 2026-05-24 20:12:00

### 修改类型
分阶段修复

### 涉及文件
- `Src/main.c`
- `Src/stm32f4xx_it.c`
- `MDK-ARM/SmartWardrobe.uvprojx`
- `修改日志/修改日志.md`

### 修改内容
- 增加 `EC3_ENCODER_TEST_ONLY` 测试固件模式，仅保留 EC3 编码器、USART3 串口和状态查询逻辑。
- 在 `SmartWardrobe` 目标中启用 `EC3_ENCODER_TEST_ONLY` 宏，并临时排除完整 `APP` 业务模块参与编译。
- 在测试固件模式下屏蔽电机定时器中断对 `MotorCtrl_OnTimUpdate` 的依赖，避免排除电机模块后链接失败。

### 修改原因
- Keil 当前链接器受限，完整工程代码体积约 47KB，超过当前版本允许的最大代码体积，无法生成 `.axf`。
- 用户当前目标是先烧录测试 EC3 编码器，因此采用测试固件模式绕过完整业务体积限制。

### 问题修复类型
- 分阶段修复

### 根因分析
- `L6050U` 的根因是 Keil 链接器授权/版本限制，不是源码语法错误。
- 根本解决完整工程烧录仍需要完整 Keil 授权、换 GCC/STM32CubeIDE 工具链，或系统性瘦身完整业务功能。
- 当前测试固件模式是面向 EC3 编码器测试目标的阶段性可烧录方案。

### 工程原则应用
- KISS：使用编译宏切换测试固件，不破坏原完整业务代码。
- YAGNI：测试固件只实现 `EC3 STATUS`、`EC3 CLR` 和 `PING`。
- DRY：未复制完整命令框架，避免把测试固件做复杂。
- SOLID：当前为临时测试入口，不强行套用复杂架构。

### 问题确认情况
- 已确认完整工程链接失败是代码体积超过当前 Keil 链接器限制。
- 已确认用户希望本小姐继续解决，使其可以先烧录测试。

### 风险评估
- 当前 `SmartWardrobe` 目标会编译为 EC3 编码器测试固件，不包含完整衣柜业务功能。
- 恢复完整业务固件时，需要去掉 `EC3_ENCODER_TEST_ONLY` 宏并恢复 `APP` 源文件编译，或改用不受 32KB 限制的工具链/授权。

### 验证方式
- 已 Rebuild `SmartWardrobe`，结果 `0 Error(s), 0 Warning(s)`。
- 已生成 `MDK-ARM/SmartWardrobe/SmartWardrobe.axf` 和 `MDK-ARM/SmartWardrobe/SmartWardrobe.hex`，测试固件代码体积 `Code=12678`。
- 烧录后串口发送 `EC3 STATUS`，转动编码器观察计数和 A/B 电平变化。
- 发送 `EC3 CLR` 确认清零。

## 2026-05-24 20:00:00

### 修改类型
修复

### 涉及文件
- `MDK-ARM/SmartWardrobe.uvprojx`
- `MDK-ARM/SmartWardrobeCode.uvprojx`
- `修改日志/修改日志.md`

### 修改内容
- 将 Keil RTE 中 `ARM::CMSIS:CORE` 依赖版本从 `6.1.0` 调整为本机已安装的 `6.3.0`。
- 后续验证发现 Keil 仍按 `6.1.0` 实例化 `SmartWardrobe` 目标，因此进一步移除两个工程文件中多余的 `CMSIS CORE` RTE 组件依赖，保留项目内已有的 `Drivers/CMSIS` 源码引用。

### 修改原因
- Keil 构建时报错 `Error #541: 'ARM::CMSIS:CORE@6.1.0' component is missing`，本机 Pack 目录存在 CMSIS `6.3.0`，不存在 `6.1.0`。

### 问题修复类型
- 根本性修复

### 根因分析
- 工程文件固定引用缺失的 CMSIS 6.1.0 Pack，导致 RTE 组件实例化失败，目标文件 `.axf` 无法生成，后续 ST-LINK 下载也无法加载 `SmartWardrobe.axf`。
- 当前项目已经显式包含 `Drivers/CMSIS/Include` 和 `Drivers/CMSIS/Device/ST/STM32F4xx/Include`，不依赖 RTE 自动拷贝 CMSIS CORE 文件即可编译。

### 工程原则应用
- KISS：只修改 RTE 依赖版本，不改动源码和启动流程。
- YAGNI：未引入额外 Pack 或重建工程。
- DRY：同步修正两个 Keil 工程文件，避免同类构建错误重复出现。
- SOLID：不适用，当前为工程配置修复。

### 问题确认情况
- 已确认本机 `C:/Keil_v5/ARM/PACK/ARM/CMSIS/` 下存在 `6.3.0`，不存在 `6.1.0`。
- 用户已确认按该方向修改。

### 风险评估
- 该修改移除了多余 RTE 组件依赖；若后续重新通过 Keil RTE 管理组件，需要重新选择 CMSIS CORE 组件。

### 验证方式
- 重新 Rebuild `SmartWardrobe` 目标，确认能生成 `MDK-ARM/SmartWardrobe/SmartWardrobe.axf`。
- 生成 `.axf` 后再执行 ST-LINK 下载。

## 2026-05-24 19:50:00

### 修改类型
修复

### 涉及文件
- `APP/Inc/cmd_parser.h`
- `APP/Src/cmd_parser.c`
- `APP/Src/cmd_dispatch.c`
- `Src/tim.c`
- `APP/COMMANDS.md`
- `MDK-ARM/pid_build.log`
- `修改日志/修改日志.md`

### 修改内容
- 将新增测试目标从 `EC1` 修正为 `EC3`，串口命令改为 `EC3 STATUS` 和 `EC3 CLR`。
- 将测试接口映射从 `MOTOR_ID_1/TIM1/PE9/PE11` 修正为 `MOTOR_ID_3/TIM3/PA6/PA7`。
- 将内部上拉配置从 TIM1/PE9/PE11 调整到 TIM3/PA6/PA7，并恢复 TIM1/TIM2 相关输入为无上拉。
- 更新串口命令文档中的 EC3 接线和返回格式说明。

### 修改原因
- 用户确认实际测试的是 EC3 接口编码器，EC3_A 接 PA6，EC3_B 接 PA7。

### 问题修复类型
- 根本性修复

### 根因分析
- 前一次按 EC1/PE9/PE11 建立测试命令，接口对象与实际硬件接线不一致。
- EC3_A=PA6、EC3_B=PA7 对应 STM32F407 的 TIM3_CH1/TIM3_CH2，应复用现有第三路编码器硬件计数链路。

### 工程原则应用
- KISS：直接修正目标映射和 GPIO 上拉位置，不新增无关兼容命令。
- YAGNI：未保留错误的 EC1 快捷测试入口，避免误用。
- DRY：继续复用 `EncoderCtrl`/`EncoderHw` 的统一计数逻辑。
- SOLID：命令解析、命令调度和硬件读取职责保持分离。

### 问题确认情况
- 已由用户确认 EC3_A=PA6、EC3_B=PA7。

### 风险评估
- 影响 EC3/TIM3 的输入上拉配置；TIM1/TIM2/TIM4/TIM5 维持无上拉。
- 原有 `M3 ENC_STATUS` 仍可查询同一路编码器，新增 `EC3 STATUS` 只是更直接的测试入口。

### 验证方式
- 烧录后串口发送 `EC3 STATUS`，慢慢转动编码器，观察 `CNT`、`RAW`、`A`、`B`、`DEG` 是否变化。
- 发送 `EC3 CLR` 后再次查询，确认 `CNT` 和 `RAW` 回到 0 附近。
- 由于本机 Keil Pack 缺少 `ARM::CMSIS:CORE@6.1.0`，命令行构建仍需在 Pack 修复后重新验证。

## 2026-05-24 19:41:28

### 修改类型
修改

### 涉及文件
- `APP/Inc/cmd_parser.h`
- `APP/Src/cmd_parser.c`
- `APP/Inc/encoder_hw.h`
- `APP/Src/encoder_hw.c`
- `APP/Src/cmd_dispatch.c`
- `Src/tim.c`
- `APP/COMMANDS.md`
- `MDK-ARM/build_ec1.log`

### 修改内容
- 新增 `EC1` 串口命令目标，支持 `EC1 STATUS` 和 `EC1 CLR`。
- `EC1 STATUS` 返回累计计数、TIM1 原始计数、A/B 当前电平、方向、按 360PPR 四倍频换算的角度和 CPR。
- 为编码器硬件层新增 A/B 电平读取接口，便于确认 PE9/PE11 接线和信号状态。
- 将 TIM1 编码器输入 PE9/PE11 配置为内部上拉，适配 NPN 开路集电极编码器输出。
- 更新串口命令文档，补充 EC1 接线、计数和测试说明。
- 运行 Keil 命令行重构建验证，并生成 `MDK-ARM/build_ec1.log`。

### 修改原因
- 用户需要在 STM32F407VET6 项目中，为 EC1_A=PE9、EC1_B=PE11 的增量式光电编码器增加串口测试指令。

### 问题修复类型
- 根本性修复

### 根因分析
- PE9/PE11 已是 TIM1_CH1/TIM1_CH2，项目已有 TIM1 编码器计数链路，但缺少面向 EC1 的直接串口测试入口和 A/B 电平诊断信息。
- NPN 开路集电极输出需要上拉，否则高电平会悬空；因此在 TIM1 输入配置中启用内部上拉。

### 工程原则应用
- KISS：复用现有 TIM1 硬件编码器和命令框架，只增加必要测试命令。
- YAGNI：未新增中断软解码、自动校准或复杂诊断流程。
- DRY：EC1 复用 `EncoderCtrl`/`EncoderHw`，避免复制一套计数逻辑。
- SOLID：新增目标解析、调度和硬件读取接口职责清晰，不强行重构现有模块。

### 问题确认情况
- 已确认 STM32F407VET6 的 PE9/PE11 可作为 TIM1_CH1/TIM1_CH2，且项目现有 TIM1 已配置为编码器模式。

### 风险评估
- 对 TIM1/EC1 输入启用内部上拉；若外部已有更强上拉，二者并联通常不影响使用。
- 未修改 TIM2~TIM5 编码器配置，原有 `M1 ENC_STATUS`、`ALL ENC_STATUS` 等命令保持兼容。

### 验证方式
- 已尝试通过 Keil `UV4.exe` 重构建 `SmartWardrobe` 目标；当前本机 Keil Pack 缺少 `ARM::CMSIS:CORE@6.1.0`，日志显示 `Target not created`，因此未能完成真实编译验证。
- 烧录后串口发送 `EC1 STATUS`，慢慢转动编码器，观察 `CNT`、`RAW`、`A`、`B`、`DEG` 是否变化。
- 发送 `EC1 CLR` 后再次查询，确认 `CNT` 和 `RAW` 回到 0 附近。
# 2026-05-28 18:35:11

### 修改类型
修复

### 涉及文件
- `APP/Inc/cmd_parser.h`
- `APP/Src/cmd_parser.c`
- `APP/Src/cmd_dispatch.c`
- `APP/COMMANDS.md`
- `程序介绍.md`
- `Src/main.c`
- `Src/stm32f4xx_it.c`
- `MDK-ARM/build_ec_mapping_final.log`

### 修改内容
- 将编码器命令目标从旧的单一路径 `EC3` 改为通用 `EC1`~`EC5`。
- 统一编码器映射为 `EC1=M1`、`EC2=M2`、`EC3=M3`、`EC4=M4`、`EC5=M5`。
- 将 M4 闭环运动 `M4 ENC_MOVE` 明确改为使用 EC4 编码器。
- 将系统帮助、串口命令文档和程序介绍同步为新编码器映射。
- 将旧测试宏名 `EC3_ENCODER_TEST_ONLY` 改为中性名称 `ENCODER_TEST_ONLY`，避免后续误解。
- 保留 `ALL HOME` 不包含 M2 的行为，文档注明 M2 当前不用初始化。

### 修改原因
- 用户确认硬件已改为 EC1 对应 M1、EC2 对应 M2、EC3 对应 M3、EC4 对应 M4。
- 原程序仍存在 `EC3` 写死绑定 M4 的命令入口和文档说明，容易导致串口测试和闭环控制对象混乱。

### 问题修复类型
- 根本性修复

### 根因分析
- 命令解析层只识别 `EC3`，并将其固定映射到 `MOTOR_ID_4`，与当前硬件规则不一致。
- 底层 `encoder_hw.c` 已经按电机 ID 保存多路编码器映射，因此应在命令层统一支持 `EC1`~`EC5`，而不是保留单个 `EC3` 特例。

### 工程原则应用
- KISS：复用现有 `EncoderCtrl` 和 `EncoderHw`，只修正命令目标和 M4 闭环绑定。
- YAGNI：没有新增复杂校准、自动识别或额外控制算法。
- DRY：统一 `ECx STATUS/CLR` 处理函数，避免为每个 EC 单独复制调度逻辑。
- SOLID：保持命令解析、命令调度和编码器硬件读取职责分离。

### 问题确认情况
- 已确认源码中旧的 `EC3_MOTOR_ID`、`CMD_TARGET_EC3`、`handle_ec3_cmd` 等写死路径已移除。
- 已确认 `M4 ENC_MOVE` 当前读取 `M4_ENCODER_ID`，即 `MOTOR_ID_4` 对应的 EC4。

### 风险评估
- 串口命令 `EC3 STATUS/CLR` 的含义从旧的 M4 测试入口变为当前规则下的 M3 编码器入口。
- 如果旧上位机仍发送 `EC3 STATUS` 期望查看 M4，需要改为发送 `EC4 STATUS`。

### 验证方式
- 已执行 Keil 命令行构建：
  - `MDK-ARM/build_ec_mapping_final.log`
  - 结果：`0 Error(s), 0 Warning(s)`
- 烧录后建议串口依次发送 `EC1 STATUS`、`EC2 STATUS`、`EC3 STATUS`、`EC4 STATUS`，转动对应电机编码器确认 `CNT/A/B` 变化。
# 2026-05-28 19:03:15

### 修改类型
修复

### 涉及文件
- `APP/Src/encoder_hw.c`
- `Src/tim.c`
- `APP/COMMANDS.md`
- `MDK-ARM/pid_build.log`
- `修改日志/修改日志.md`
- `MDK-ARM/build_ec3_ec4_swap_pullup.log`

### 修改内容
- 交换 M3 和 M4 的编码器硬件映射：
  - M3 改为 `TIM3 / PA6 / PA7`
  - M4 改为 `TIM4 / PD12 / PD13`
- 将 TIM4 编码器输入 `PD12/PD13` 从 `GPIO_NOPULL` 改为 `GPIO_PULLUP`。
- 更新串口命令文档中的 EC3/EC4 引脚说明。

### 修改原因
- 用户实测 `M3 RUN` 时 `EC4` 计数变化，而 `EC3` 不变化，说明程序中的 M3/M4 编码器映射与硬件接线相反。
- 原理图确认 `EC4_A=PD12`、`EC4_B=PD13`，应对应 TIM4，而不是旧程序中的 TIM3/PA6/PA7。

### 问题修复类型
- 根本性修复

### 根因分析
- `encoder_hw.c` 中 `g_encoder_map` 第 3、4 项顺序反了，导致 `M3` 查询到 `EC4`，`M4` 查询到 `EC3`。
- `M4 ENC_MOVE` 因读取不到真实 M4 编码器变化，触发 `ERR 206 M4_ENC_STALL`。

### 工程原则应用
- KISS：只修正硬件映射和必要上拉配置，不改动闭环控制算法。
- YAGNI：未添加额外诊断命令或复杂自适应映射。
- DRY：继续复用统一的 `EncoderHw` / `EncoderCtrl` 编码器链路。
- SOLID：硬件映射修复保持在硬件抽象层，命令层和控制层无需重复处理特例。

### 问题确认情况
- 用户已提供串口日志证明 `M3 RUN` 时 `EC4` 计数从 330 增长到 968，而 `EC3` 仍为 0。
- 已通过原理图局部截图确认 `EC4_A/EC4_B` 连接到 `PD12/PD13`。

### 风险评估
- 会改变 `EC3 STATUS` 和 `EC4 STATUS` 的实际硬件来源，使其与原理图一致。
- 若硬件线束仍按旧程序映射接线，则需要同步调整线束；当前修改以原理图和用户实测为准。

### 验证方式
- 已执行 Keil 命令行构建：
  - `MDK-ARM/build_ec3_ec4_swap_pullup.log`
  - 结果：`0 Error(s), 0 Warning(s)`
- 烧录后执行：
  - `EC3 CLR`
  - `EC4 CLR`
  - `M3 RUN DIR=CW RPM=50`
  - `EC3 STATUS`
  - `EC4 STATUS`
  - `ALL ESTOP`
  - 预期：M3 运行时 `EC3` 变化，`EC4` 不应随 M3 变化。
- 再执行：
  - `EC4 CLR`
  - `M4 ENC_MOVE DIR=CW RPM=20 CNT=1440`
  - 预期：不再因 EC4 计数不变触发 `M4_ENC_STALL`。
# 2026-05-28 19:10:09

### 修改类型
修复

### 涉及文件
- `Src/tim.c`
- `APP/Src/cmd_dispatch.c`
- `修改日志/修改日志.md`
- `MDK-ARM/build_ec4_tim4_pullup_v137.log`

### 修改内容
- 确认并修复 TIM4 编码器输入 `PD12/PD13` 的 GPIO 上拉配置，将其设置为 `GPIO_PULLUP`。
- 将固件版本号更新为 `SmartWardrobe-STM32F407 v1.3.7`，便于烧录后通过 `VER` 确认当前板子运行的是新固件。

### 修改原因
- 用户反馈 EC4 编码器实物接入后 `STATUS` 仍无变化。
- 复查源码发现 TIM4 的 `PD12/PD13` 仍为 `GPIO_NOPULL`，对于 NPN 开路集电极编码器可能导致输入悬空或无法可靠计数。

### 问题修复类型
- 根本性修复

### 根因分析
- 前一次修复已将 M4 映射到 TIM4/PD12/PD13，但 TIM4 输入上拉未真正写入源码。
- 若编码器输出为开路集电极，没有上拉时 MCU 引脚无法稳定获得高电平，TIM4 编码器计数可能保持不变。

### 工程原则应用
- KISS：只修正 TIM4 输入上拉和版本号，不改动闭环算法。
- YAGNI：未加入额外临时延时或绕过 `M4_ENC_STALL` 的保护逻辑。
- DRY：继续复用统一 TIM 编码器初始化路径。
- SOLID：保持 GPIO/TIM 初始化职责在 `tim.c`，命令层只负责版本展示。

### 问题确认情况
- 已确认 `Src/tim.c` 中 TIM4 分支 `PD12/PD13` 当前为 `GPIO_PULLUP`。
- 已确认 `APP/Src/cmd_dispatch.c` 版本号为 `v1.3.7`。

### 风险评估
- 对 TIM4/EC4 输入电平有影响；若外部已有强上拉，内部上拉并联通常无明显风险。
- 不影响电机脉冲输出、方向控制和其他编码器映射。

### 验证方式
- 已执行 Keil 命令行构建：
  - `MDK-ARM/build_ec4_tim4_pullup_v137.log`
  - 结果：`0 Error(s), 0 Warning(s)`
- 烧录后先发送 `VER`，应返回 `OK VER SmartWardrobe-STM32F407 v1.3.7`。
- 再发送 `EC4 STATUS`，手动转动 EC4 编码器，观察 `A/B` 是否变化、`CNT` 是否变化。
## 2026-05-29 17:17:42

### 修改类型
修复

### 涉及文件
- `APP/Src/rs485_abs_encoder.c`
- `APP/Src/cmd_dispatch.c`

### 修改内容
- 为 M2 RS485 绝对值编码器读取增加短重试，降低偶发 `RX_TIMEOUT` 对 `ABS_STATUS`、`ABS_MOVE`、上电回零的影响。
- 将 M2 上电自动回零从“延时后只读一次”改为“等待并周期重试”，仅在超过 15 秒仍无法读取编码器时才报 `M2_BOOT_HOME_COMM_RX_TIMEOUT`。

### 修改原因
- 现场现象是零点设置可以成功，但上电回零或状态读取仍可能返回 `ERR 208 RX_TIMEOUT`，说明 UART2/RS485 链路并非完全不可用，更符合编码器或 RS485 转接模块上电稳定时间、偶发响应延迟导致的读命令超时。

### 问题修复类型
- 分阶段修复

### 根因分析
- 当前确认的直接原因是读取路径对单次超时过于敏感：`ABS_ZERO` 可以通过写入和后续校验成功，但 `ABS_STATUS`、上电回零读当前位置时只要一次未收到响应就失败。
- 若修改后仍超时，需要继续确认硬件层面的 A/B 接线、GND 共地、供电稳定性、编码器地址和通信参数。

### 工程原则应用
- KISS：只在通信读取和上电回零等待逻辑上做小范围修复，不引入复杂状态机。
- YAGNI：没有添加暂时用不到的多编码器地址配置和 EEPROM 管理功能。
- DRY：保留统一的 `Rs485AbsEncoder_Read` 入口，让所有 M2 绝对值编码器读取都获得相同重试保护。
- SOLID：当前为嵌入式 C 小范围修复，不强行套用复杂架构，保持模块职责清晰。

### 问题确认情况
- 已通过代码路径确认 `M2_ABS_BOOT_HOME_ENABLE` 开启，旧逻辑上电 2 秒后只尝试读取一次编码器，失败即报错。
- 用户反馈“零点设置成功但仍 RX_TIMEOUT”与该读取路径过于敏感高度吻合。

### 风险评估
- 读取失败时最长会多等待几次重试，单次命令响应可能略慢。
- 上电自动回零在编码器未就绪时会推迟启动，避免误报和过早动作。

### 验证方式
- 烧录后上电观察是否不再立即报 `M2_BOOT_HOME_COMM_RX_TIMEOUT`。
- 发送 `M2 ABS_STATUS` 连续测试 5 到 10 次，应稳定返回 `ABS M2 ADDR=1 RAW=...`。
- 设置零点后发送 `M2 ABS_MOVE DEG=0 RPM=20 TOL=2`，确认 M2 能回到零点附近并自动停止。
## 2026-05-30 14:52:04

### 修改类型
修复

### 涉及文件
- `APP/Src/motor_hw.c`
- `Src/gpio.c`
- `Inc/main.h`

### 修改内容
- 将 M5 从原来的继电器高电平有效逻辑改为 DM542 步进驱动使用的低电平使能逻辑。
- 将 M5 上电默认 EN 状态改为高电平禁用，避免初始化期间误使能。
- 更新 M5 使能脚相关注释，明确 M1~M5 均为低电平使能。

### 修改原因
- 现场现象为 `M5 RUN DIR=CCW RPM=80` 不转，但 `STOP` 时抖动一下。该现象与旧逻辑高度吻合：旧代码运行时 PB15 拉高，停止时 PB15 拉低；若 DM542 的 ENA 低电平才允许驱动工作，则运行期间会被禁用，停止瞬间才短暂释放。

### 问题修复类型
- 根本性修复

### 根因分析
- M5 实际硬件为 DM542 步进驱动，不是继电器输出。旧代码把 M5 EN 配成高电平有效，与 DM542 当前接线/使能语义不匹配，导致运行命令输出 STEP/DIR 时驱动未真正使能。

### 工程原则应用
- KISS：只修改 M5 使能极性和默认电平，不改动通用电机控制框架。
- YAGNI：没有新增多余命令或复杂配置项。
- DRY：继续复用现有 `MotorHw_SetEnable` 极性表统一处理 M1~M5。
- SOLID：当前为嵌入式 C 硬件适配修复，不强行套用复杂抽象，保持职责集中在硬件映射层。

### 问题确认情况
- 用户确认接线无问题，并反馈运行不动、停止抖动；代码中确认 M5 旧逻辑为高电平有效继电器模式，因此判断为确定性较高的使能极性错误。

### 风险评估
- 影响范围限定为 M5 的 EN 输出电平。
- M1~M4 使能极性未改变。
- 如果现场 DM542 的 ENA 没有接入，改动不会影响 STEP/DIR 输出，但也不会解决由电平转换不足导致的不动问题。

### 验证方式
- 已使用 Keil 命令行构建 `SmartWardrobeCode`，结果为 `0 Error(s), 0 Warning(s)`。
- 烧录后发送 `M5 RUN DIR=CCW RPM=80`，M5 应持续转动；发送 `M5 STOP` 后应停止，不应只在停止瞬间抖动。
## 2026-06-15 00:27:48

### 修改类型
创建

### 涉及文件
- `编码器和步进电机的控制对话.txt`
- `修改日志/修改日志.md`

### 修改内容
- 创建“编码器和步进电机的控制对话”文本文件。
- 整理并保存本次对话中关于编码器、步进电机反馈方式、M2/M4 局部闭环和 PID 判断的内容。
- 在修改日志中追加本次文件创建记录。

### 修改原因
- 用户要求将今天对话框内容生成文本文件，并保存在当前项目文件夹中。

### 问题修复类型
- 不适用

### 根因分析
- 本次不是程序问题修复，而是按用户要求保存对话内容。

### 工程原则应用
- KISS：使用单一文本文件保存对话内容，便于直接查看。
- YAGNI：没有额外创建无关格式或附加工程文件。
- DRY：复用现有修改日志文件记录变更。
- SOLID：当前任务是文档保存，不强行套用复杂架构。

### 问题确认情况
- 用户明确要求创建文本文件并指定文件名。

### 风险评估
- 创建新文本文件，不覆盖已有同名文件，无明显风险。

### 验证方式
- 检查项目根目录是否存在 `编码器和步进电机的控制对话.txt`。
- 打开文本文件，确认内容包含编码器、步进电机反馈和 PID 判断说明。

## 2026-06-18 18:30:29

### 修改类型
修复

### 涉及文件
- `APP/Src/cmd_dispatch.c`
- `APP/COMMANDS.md`
- `APP/SERIAL_COMMANDS_EASY.md`
- `程序介绍.md`
- `速度和容差调试说明.txt`
- `修改日志/修改日志.md`

### 修改内容
- 在 `AXIS TAKE_CLOTH` 取衣状态机中新增 `TAKE_CLOTH_MOVE_PICK_Y` 步骤。
- 将取衣流程从 `Y_HOME -> X取放点 -> Z取放点 -> OPEN` 修正为 `Y_HOME -> X取放点 -> Z取放点 -> Y取放点 -> OPEN`。
- 同步更新命令返回的取衣/放衣顺序描述和相关文档说明。
- 将取衣/放衣文档示例默认值同步为当前代码实际值 `RPM=35,TOL=2`。
- 将速度/容差说明文件中的默认宏值同步为当前代码实际值。

### 修改原因
- 用户反馈取衣时夹到衣服后，Y 轴回到行程开关位置，后续三轴不再按预期动作。
- 代码检查确认取衣流程缺少从 Y 轴行程开关位置移动到取放交换点 `Y=3433` 的步骤，导致衣服没有被送到取衣口 Y 坐标就准备松开夹爪。

### 问题修复类型
- 根本性修复

### 根因分析
- 根因是取衣状态机步骤不完整：`TAKE_CLOTH_MOVE_PICK_Z` 后直接进入 `TAKE_CLOTH_WAIT_BEFORE_OPEN`，等待 Z 到 `0` 后就开夹爪，没有启动 M3/Y 轴到取放交换点。
- 本次新增专门的 Y 轴移动状态，让状态机在开夹爪前必须确认 M3 到达 `PLACE_CLOTH_PICK_Y`。

### 工程原则应用
- KISS：只补充缺失的取衣状态，不改动电机控制、编码器闭环和串口协议。
- YAGNI：没有新增云端命令或额外配置项。
- DRY：继续复用现有 `take_cloth_start_axis_move()` 和 `cloth_axis_wait_done()` 到位判断逻辑。
- SOLID：当前为嵌入式 C 状态机修复，不强行套用复杂架构，保持职责集中在命令调度模块。

### 问题确认情况
- 已通过代码路径确认取衣流程确实缺少 Y 轴回取放交换点动作，用户反馈现象与状态机缺失步骤一致。

### 风险评估
- 影响范围限定为 `AXIS TAKE_CLOTH` 取衣流程。
- 放衣服流程、ESP32 串口协议、云端 MessageContent 不受影响。

### 验证方式
- 已执行 `gcc -fsyntax-only -std=c99` 检查 `APP/Src/cmd_dispatch.c`，结果通过。
- 烧录后执行 `AXIS TAKE_CLOTH`，预期夹爪夹紧后顺序为：Y 回 EX_KEY3，X 到 `2250`，Z 到 `0`，Y 到 `3433`，等待后再松开夹爪。

## 2026-06-18 20:51:59

### 修改类型
修复 / 诊断增强 / 分阶段修复

### 涉及文件
- `APP/Src/cmd_dispatch.c`
- `程序介绍.md`
- `修改日志/修改日志.md`

### 修改内容
- 仅调整 `AXIS TAKE_CLOTH` 取衣流程，不改 `AXIS PLACE_CLOTH` 放衣流程。
- 为取衣流程增加 `take_cloth_y_home_wait_done()`，让取衣在夹爪抓取后等待 Y 轴回 EX_KEY3 时只消费取衣自己的 `y_home_done` 标志。
- 为取衣流程单轴启动增加串口回显：`SLOT_X`、`SLOT_Z`、`SLOT_Y`、`PICK_X`、`PICK_Z`，并显示当前编码器计数、目标计数和 `START/ALREADY_DONE`。
- 在取衣夹爪抓取后的 Y 回零阶段增加 `OK TAKE_CLOTH Y_HOME_AFTER_GRIP START/DONE` 回显。
- 固件版本号更新为 `SmartWardrobe-STM32F407 v1.4.13`，并同步 `程序介绍.md`。

### 修改原因
- 现场反馈取衣流程夹爪抓住衣服后，Y 轴回到行程开关，之后三轴不继续动作。
- 当前代码表面逻辑会在 Y 回零后启动 X=2250，但缺少关键步骤回显，无法判断是卡在 Y 回零等待、X 启动失败、X 被判定已到位，还是编码器闭环随后报错。

### 问题修复类型
- 分阶段修复。

### 根因分析
- 已确认取衣状态机没有三轴同时运动，顺序仍为 `ALL_HOME -> X=13000 -> Z=2436 -> Y=3291 -> WAIT -> GRIP -> Y_HOME -> X=2250 -> Z=0 -> WAIT -> OPEN -> ALL_HOME`。
- 取衣和放衣的单轴启动底层逻辑相同，放衣可执行说明 M1 基础驱动和编码器闭环不一定是全局失效。
- 当前现场现象仍缺少串口中间状态支撑，因此本次先把取衣侧 Y 回零等待与诊断输出补齐，便于下一次实测直接定位卡点。

### 工程原则应用
- KISS：只增加取衣侧必要状态输出和等待隔离，不改动放衣流程和底层驱动。
- YAGNI：不提前扩展 2 号、3 号衣服位，也不改云端协议。
- DRY：继续复用现有编码器闭环移动和行程开关机制，只在取衣侧增加专用等待入口。
- SOLID：当前为嵌入式状态机小范围修复，不强行套用复杂架构。

### 问题确认情况
- 已从代码确认取衣动作顺序没有三轴联动，且 Y_HOME 后理论上会进入 `PICK_X`。
- 尚需现场用新增串口回显确认实际卡点。

### 风险评估
- 影响范围限制在 `TAKE_CLOTH` 取衣流程。
- 未改 `PLACE_CLOTH` 放衣流程。
- 新增回显可能增加串口输出量，但只在取衣关键步骤输出，风险较低。

### 验证方式
- 已运行 `gcc -fsyntax-only ... APP/Src/cmd_dispatch.c`，通过。
- 已运行 `gcc -fsyntax-only ... APP/Src/cmd_parser.c`，通过。
- 烧录后发送 `AXIS TAKE_CLOTH RPM=35 TOL=2`。
- 观察夹爪抓取后是否依次出现：`OK TAKE_CLOTH Y_HOME_AFTER_GRIP START`、`OK M3 HOME_EX3_DONE EX_KEY3_LOW`、`OK TAKE_CLOTH Y_HOME_AFTER_GRIP DONE`、`OK TAKE_CLOTH PICK_X M1 CNT=... TARGET=2250 START` 或 `ALREADY_DONE`。
## 2026-06-18 21:26:26

### 修改类型
修复

### 涉及文件
- `APP/Src/cmd_dispatch.c`
- `APP/COMMANDS.md`
- `APP/SERIAL_COMMANDS_EASY.md`
- `程序介绍.md`
- `修改日志/修改日志.md`

### 修改内容
- 仅调整 `AXIS TAKE_CLOTH` 取衣服流程，未改动 `AXIS PLACE_CLOTH` 放衣服流程。
- 将取衣服在 `Y=3291` 到位后的动作从“先等 2 秒再夹紧”改为“先夹爪夹紧，再等待 2 秒”。
- 在取衣服松开夹爪并等待 2 秒后，新增 Y/M3 回 `EX_KEY3` 行程开关的步骤，再进入 `ALL HOME` 归零。
- 为取衣服松爪后的 Y 回行程开关新增 `Y_HOME_AFTER_OPEN START/DONE` 串口回显。
- 同步更新取衣服命令回显和说明文档中的流程描述。

### 修改原因
- 用户确认取衣服目标流程应为：X 到 `13000`，Z 到 `2436`，Y 到 `3291`，夹爪抓取后停 2 秒，Y 回行程开关，X 到 `2250`，Z 到 `0`，停 2 秒，松夹爪，Y 再回行程开关，之后归零。
- 代码检查确认旧流程与该目标不一致：抓取前多等 2 秒，且松爪后直接进入 `ALL HOME`，没有像放衣服流程一样先单独让 Y 轴回行程开关。

### 问题修复类型
- 根本性修复

### 根因分析
- 根因是 `TAKE_CLOTH` 状态机步骤定义和跳转顺序与真实机械流程不一致。
- 旧状态机在 `TAKE_CLOTH_MOVE_SLOT_Y` 后进入等待状态，再执行 `GRIP_CLOSE`，导致抓取动作晚于预期。
- 旧状态机在 `TAKE_CLOTH_WAIT_OPEN` 后直接进入 `TAKE_CLOTH_ALL_HOME`，缺少松爪后的独立 Y 轴回行程开关步骤。
- 本次直接修正状态机顺序和 Y 回零完成标志判断，而不是在外部命令或延时处打补丁。

### 工程原则应用
- KISS：只调整取衣服状态机的必要步骤和回显，不改动放衣服流程及底层电机、编码器、串口驱动。
- YAGNI：没有增加新的衣服位、云端协议字段或额外配置。
- DRY：继续复用现有 `take_cloth_start_y_home()`、`take_cloth_y_home_wait_done()`、`take_cloth_start_axis_move()` 和 `cloth_axis_wait_done()`。
- SOLID：当前为嵌入式 C 状态机修复，不强行套用复杂架构，保持命令调度模块职责集中。

### 问题确认情况
- 已通过代码对比确认 `PLACE_CLOTH` 在松爪后存在 `Y_HOME -> ALL_HOME`，而 `TAKE_CLOTH` 缺少同类步骤。
- 用户已明确回复“确认”，授权按该方向修改。

### 风险评估
- 影响范围限定为 `AXIS TAKE_CLOTH` 取衣服流程和相关说明文档。
- `AXIS PLACE_CLOTH` 放衣服程序未改动。
- 新增一次取衣服末尾 Y 轴回行程开关动作，会让取衣流程多等待该轴到位后再整体归零，符合用户确认的目标逻辑。

### 验证方式
- 编译或语法检查 `APP/Src/cmd_dispatch.c`。
- 烧录后发送 `AXIS TAKE_CLOTH RPM=35 TOL=2`，观察串口回显顺序应包含 `GRIP_CLOSE` 后等待、`Y_HOME_AFTER_GRIP START/DONE`、`PICK_X`、`PICK_Z`、`GRIP_OPEN`、`Y_HOME_AFTER_OPEN START/DONE`、最终 `TAKE_CLOTH DONE`。
- 现场确认取衣末尾松爪后 Y/M3 会先回 `EX_KEY3`，再执行 `ALL HOME`。
## 2026-06-18 21:39:08

### 修改类型
修复

### 涉及文件
- `APP/Src/cmd_dispatch.c`
- `APP/COMMANDS.md`
- `APP/SERIAL_COMMANDS_EASY.md`
- `程序介绍.md`
- `修改日志/修改日志.md`

### 修改内容
- 仅调整 `AXIS TAKE_CLOTH` 取衣服流程，未改动 `AXIS PLACE_CLOTH` 放衣服流程。
- 在取衣服 `Y_HOME -> X=2250 -> Z=0` 中间补入 `Y=3433` 步骤。
- 新增 `TAKE_CLOTH_MOVE_PICK_Y` 状态，等待 X/M1 到 `2250` 后启动 Y/M3 到 `3433`，再等待 Y/M3 到位后启动 Z/M4 到 `0`。
- 同步更新取衣服串口回显和说明文档，流程改为 `... Y_HOME,X2250,Y3433,Z0,WAIT,OPEN,WAIT,Y_HOME,ALL_HOME`。

### 修改原因
- 用户进一步确认取衣服在 `X=2250` 后还需要先让 Y/M3 到 `3433`，再让 Z/M4 到 `0`。
- 当前取衣服状态机少了 `Y=3433` 这一步，导致动作顺序与机械放衣位置不一致。

### 问题修复类型
- 根本性修复

### 根因分析
- 根因是 `TAKE_CLOTH` 状态机在取放交换点阶段步骤不完整：`TAKE_CLOTH_MOVE_PICK_X` 后直接进入 `TAKE_CLOTH_MOVE_PICK_Z`。
- 放衣服流程本身已有 `X=2250 -> Y=3433 -> GRIP` 的取放点逻辑；取衣服放回交换点时也需要先恢复 Y 到 `3433`，再降 Z 到 `0`。
- 本次通过新增专门状态补齐动作序列，而不是用延时或重复命令规避。

### 工程原则应用
- KISS：只补取衣服缺失状态，不改动放衣服流程和底层驱动。
- YAGNI：没有新增额外衣服位、参数或云端协议字段。
- DRY：复用现有 `take_cloth_start_axis_move()`、`cloth_axis_wait_done()` 和 `PLACE_CLOTH_PICK_Y` 常量。
- SOLID：当前为嵌入式 C 状态机小范围修复，不强行套用复杂架构。

### 问题确认情况
- 通过代码确认旧取衣流程中 `X=2250` 后直接启动 `Z=0`，用户已明确指出缺少 `Y=3433`。

### 风险评估
- 影响范围限定为 `AXIS TAKE_CLOTH` 取衣服流程和相关说明文档。
- `AXIS PLACE_CLOTH` 放衣服流程未改动。
- 新增 Y/M3 到 `3433` 会让取衣流程多一次单轴到位等待，符合用户确认的机械流程。

### 验证方式
- 语法检查 `APP/Src/cmd_dispatch.c`。
- 烧录后发送 `AXIS TAKE_CLOTH RPM=35 TOL=2`，观察串口回显应依次出现 `PICK_X`、`PICK_Y`、`PICK_Z`，其中 `PICK_Y` 目标为 `3433`。
## 2026-06-18 21:52:59

### 修改类型
修复

### 涉及文件
- `APP/Src/cmd_dispatch.c`
- `APP/COMMANDS.md`
- `APP/SERIAL_COMMANDS_EASY.md`
- `程序介绍.md`
- `修改日志/修改日志.md`

### 修改内容
- 仅调整 `AXIS TAKE_CLOTH` 取衣服流程，未改动 `AXIS PLACE_CLOTH` 放衣服流程。
- 将取衣服夹爪抓取并等待 2 秒后的动作，从 Y/M3 回 `EX_KEY3` 行程开关改为 Y/M3 到编码器位置 `500`。
- 新增 `TAKE_CLOTH_TRANSFER_Y` 常量，并将对应状态命名为 `TAKE_CLOTH_MOVE_TRANSFER_Y`。
- 同步更新取衣服串口回显和说明文档，流程改为 `... GRIP,WAIT,Y500,X2250,Y3433,Z0,WAIT,OPEN,WAIT,Y_HOME,ALL_HOME`。

### 修改原因
- 用户确认抓取衣服后不是立即回行程开关，而是先让 Y 轴运动到 `500`，再执行后续 `X=2250 -> Y=3433 -> Z=0`。
- 当前代码仍使用 `take_cloth_start_y_home()`，导致该步骤实际是回行程开关，不符合用户确认的机械动作。

### 问题修复类型
- 根本性修复

### 根因分析
- 根因是取衣服状态机中抓取后的过渡动作目标错误：旧逻辑调用行程开关回零函数，而用户确认的目标是编码器位置 `500`。
- 本次用绝对编码器闭环移动到 `500`，并等待该位置到位后再启动 X/M1 到 `2250`，避免用行程开关动作替代中转位置。

### 工程原则应用
- KISS：只替换取衣服抓取后的单个过渡状态目标，不改动放衣服流程。
- YAGNI：没有新增云端协议、额外衣服位或复杂参数配置。
- DRY：复用现有 `take_cloth_start_axis_move()` 和 `cloth_axis_wait_done()`。
- SOLID：当前为嵌入式 C 状态机局部修复，不强行套用复杂架构。

### 问题确认情况
- 用户明确回复“确定”，确认抓取后 Y 轴目标为 `500`。

### 风险评估
- 影响范围限定为 `AXIS TAKE_CLOTH` 取衣服流程。
- `AXIS PLACE_CLOTH` 放衣服流程未改动。
- 若现场 Y=500 位置尚未校准，后续动作会按编码器计数 `500` 到位判断执行，需要烧录后实测确认该中转位置安全。

### 验证方式
- 语法检查 `APP/Src/cmd_dispatch.c`。
- 烧录后发送 `AXIS TAKE_CLOTH RPM=35 TOL=2`，观察串口回显应出现 `OK TAKE_CLOTH TRANSFER_Y M3 ... TARGET=500 ...`，随后才出现 `PICK_X`、`PICK_Y`、`PICK_Z`。
## 2026-06-23 18:11:19

### 修改类型
修复

### 涉及文件
- `APP/Src/cmd_dispatch.c`
- `修改日志/修改日志.md`

### 修改内容
- 调整取衣服和放衣服共用的 X/M1 到位等待逻辑。
- 新增 X 轴专用等待判断：读取 EC1 编码器后，只要 X 已经到目标位置或越过目标位置，就急停 M1 并进入下一步。
- 保留 Y/M3、Z/M4 原来的等待逻辑不变。

### 修改原因
- 用户要求不要额外加状态保护，只要 X 轴到了预定点就执行下一步。
- 原逻辑在 `cloth_axis_wait_done()` 中会先判断电机是否忙，X 正在运行时直接返回等待，只有后续编码器闭环 tick 标记完成后状态机才进入下一步；现场表现可能像 X 后续动作被状态挡住。

### 问题修复类型
- 根本性修复

### 根因分析
- 根因是 X/M1 的流程进入下一步依赖状态标志与忙状态，而用户期望以 EC1 编码器位置作为直接判定依据。
- 本次把 X 轴到位判断改为位置优先：先检查 EC1 是否到达目标，再处理故障和等待状态，避免 X 到点后仍被忙状态阻塞。

### 工程原则应用
- KISS：只改 X 轴等待判定，不重构整套取衣/放衣状态机。
- YAGNI：没有增加新的保护状态、配置项或额外命令。
- DRY：取衣服和放衣服继续复用同一个 `cloth_axis_wait_done()` 入口，X 轴内部统一处理。
- SOLID：当前是嵌入式 C 状态机局部修复，不强行套用复杂架构。

### 问题确认情况
- 已按用户明确要求修改：不要加状态保护，X 到预定点就动下一步。

### 风险评估
- 影响范围限定为 X/M1 在取衣服、放衣服流程中的到位等待判断。
- X 到达或越过目标位置时会立即进入下一步；若机械惯性较大，需要现场确认停点误差是否可接受。

### 验证方式
- 编译检查 `APP/Src/cmd_dispatch.c`。
- 烧录后分别执行 `AXIS PLACE_CLOTH` 和 `AXIS TAKE_CLOTH`。
- 观察 X 轴到 `2250`、`5000`、`13000`、`2250` 等目标点后是否继续进入下一步。
- 如仍卡住，读取 `EC1 STATUS`、`M1 STATUS` 和串口错误回显，确认是否为 EC1 未到点、编码器方向错误或卡滞。
## 2026-06-23 18:35:51

### 修改类型
修改

### 涉及文件
- `Src/main.c`
- `修改日志/修改日志.md`

### 修改内容
- 新增衣柜 MQTT/上位机协议命令 `cmd=18`，对应 STM32 帧命令 `0x12`。
- 收到 `cmd=18` 后执行现有 `ALL HOME RPM=120` 回零逻辑。
- `cmd=16` 放衣服、`cmd=17` 取衣服、`cmd=32` 读取状态保持不变。

### 修改原因
- 用户需要通过 MQTT 发起复位/回零动作。
- 原协议只支持放衣服、取衣服和读取状态，没有直接复位命令。

### 问题修复类型
- 根本性修复

### 根因分析
- 根因是 MQTT/衣柜帧协议未暴露已有的 `ALL HOME` 回零能力。
- 本次复用现有 `CmdDispatch_Execute()` 和 `CMD_ACTION_REV_EXKEY`，没有重新实现第二套回零逻辑。

### 工程原则应用
- KISS：只新增一个协议命令和一个小的启动函数。
- YAGNI：没有新增可配置速度、位置参数或复杂状态机。
- DRY：复用已有 `ALL HOME` 回零逻辑。
- SOLID：当前为嵌入式 C 协议入口扩展，不强行套用复杂架构。

### 问题确认情况
- 用户已明确回复“继续”，授权添加 MQTT 复位命令。

### 风险评估
- 影响范围限定为衣柜帧协议入口。
- 复位命令会启动 M1/M3/M4 回行程开关并清零 EC1/EC3/EC4 与 XYZ。
- 若外部 ESP32/MQTT 网关未同步支持 `cmd=18` 转发为 `0x12` 帧，还需要同步修改网关端。

### 验证方式
- 编译 `Src/main.c`。
- 通过 MQTT 发送 `{"cmd":18}`，确认设备启动 `ALL HOME RPM=120`。
- 串口侧观察应出现 `OK ALL HOME ...` 或回零完成相关回显。

## 2026-06-23 18:56:13

### 修改类型
修改

### 涉及文件
- `Src/main.c`
- `修改日志/修改日志.md`

### 修改内容
- 将衣柜 MQTT/上位机复位回零命令 `cmd=18` 对应的 `WARDROBE_HOME_RPM` 从 `120.0f` 调整为 `60.0f`。
- `cmd=16` 放衣服、`cmd=17` 取衣服、`cmd=32` 读取状态逻辑保持不变。

### 修改原因
- 用户明确要求复位回零使用 `ALL HOME RPM=60`，不要再使用 `ALL HOME RPM=120`。

### 问题修复类型
- 根本性修复

### 根因分析
- 根因是 MQTT/上位机复位入口中固定的回零速度常量仍为 `120.0f`，导致 `cmd=18` 触发的回零动作速度不符合当前现场要求。
- 本次直接修改复位入口使用的速度常量，使 `Wardrobe_StartResetHome()` 构造的 `ALL HOME` 命令按 `RPM=60` 执行。

### 工程原则应用
- KISS：只调整复位命令使用的 RPM 常量，不改动已有回零调度和取放衣状态机。
- YAGNI：没有新增可配置参数或额外 MQTT 字段。
- DRY：继续复用现有 `ALL HOME` 回零逻辑。
- SOLID：当前为嵌入式 C 协议入口常量修正，不强行套用复杂架构。

### 问题确认情况
- 用户明确要求“ALL HOME RPM=60，不要120”，已按该要求修改。

### 风险评估
- 影响范围限定为 MQTT/上位机 `cmd=18` 触发的复位回零速度。
- 回零速度降低后动作时间会变长，但运动更慢。

### 验证方式
- 编译 `Src/main.c`。
- 通过 MQTT 发送 `{"cmd":18}`，确认设备启动 `ALL HOME RPM=60`。
- 串口侧观察应出现 `OK ALL HOME ...` 或回零完成相关回显。

## 2026-07-08 10:20:56

### 修改类型
修改

### 涉及文件
- `APP/Src/cmd_dispatch.c`
- `APP/COMMANDS.md`
- `MDK-ARM/pid_build.log`
- `修改日志/修改日志.md`

### 修改内容
- 将固件版本号从 `SmartWardrobe-STM32F407 v1.4.16` 更新为 `SmartWardrobe-STM32F407 v1.4.17`。
- 为 M1/M3/M4 的编码器目标运动链路增加 PID 调速状态字段和保守默认参数。
- 在 `M1/M3/M4 ENC_MOVE`、`AXIS ENC_MOVE`、`AXIS PLACE_CLOTH`、`AXIS TAKE_CLOTH` 使用的编码器目标运动中，根据剩余编码器误差周期性调整电机 RPM。
- 保留原有到位急停、编码器方向错误检测、卡滞检测和故障上报逻辑。
- 更新命令文档，说明当前 PID 只作用于 M1/M3/M4 编码器目标运动链路，`AXIS MOVE` 和 M2 绝对值编码器暂不并入本 PID。
- 新增 `MDK-ARM/pid_build.log` 记录本轮 Keil 命令行构建尝试结果。

### 修改原因
- 用户要求先按方案完善 PID 功能。
- 原工程中 `axis_planner.c` 和 `motor_ctrl.c` 明确说明当前没有 PID，编码器只用于到位判断和诊断，不能满足“运动中按误差调速”的需求。

### 问题修复类型
分阶段修复

### 根因分析
- 根因是现有 M1/M3/M4 编码器目标运动只用固定 RPM 连续运行，接近目标时没有根据剩余误差主动降速，最终主要依赖到位后急停。
- 本次在现有 `EncMove_t` 异步监控链路内加入 PID 调速，复用原有编码器读取、方向校验、卡滞检测和电机改速接口，避免重写取放衣状态机。
- 当前为第一阶段：先解决 XYZ 编码器目标运动的 PID 调速；M2 绝对值编码器和旧 `AXIS MOVE` 开环规划后续可单独评估。

### 工程原则应用
- KISS：只在现有编码器目标运动链路中增加 PID 调速，不引入新任务框架或新通信协议。
- YAGNI：没有新增暂时用不到的上位机 PID 配置命令，先采用保守源码常量便于实机验证。
- DRY：`M1/M3/M4 ENC_MOVE`、`AXIS ENC_MOVE`、取衣、放衣继续复用同一套 `EncMove_t` 和 SafetyTick 监控逻辑。
- SOLID：当前为嵌入式 C 状态机局部增强，不强行引入复杂模块拆分；后续若需要在线调参，再考虑独立 PID 配置接口。

### 问题确认情况
- 已确认原代码没有真正 PID：原运动链路为固定 RPM 运行加编码器到位/故障判断。
- 用户已明确回复“先按你说的这样加吧”，授权按 M1/M3/M4 编码器目标运动 PID 调速方向修改。

### 风险评估
- 影响范围限定为 M1/M3/M4 的编码器目标运动链路。
- 默认 `Ki=0`、`Kd=0`，实际为保守位置比例调速加完整 PID 状态框架，避免未经实机调参的积分饱和和微分噪声。
- 如果机械最低稳定速度高于当前默认最小 RPM，实机可能仍出现低速段卡滞，需要根据现场串口日志调整 `ENC_MOVE_PID_RPM_MIN_DEFAULT` 或 `ENC_MOVE_PID_KP_DEFAULT`。

### 验证方式
- 本次本地验证：执行 `UV4.exe -b SmartWardrobeCode.uvprojx`，Keil 因目标指定 ARM Compiler V6.24 但本机只检测到 6.18 而中止，结果已记录到 `MDK-ARM/pid_build.log`。
- 本次本地验证：使用本机 `armclang 6.18` 对 `APP/Src/cmd_dispatch.c` 执行 `-fsyntax-only` 语法检查，退出码为 0。
- 后续在装有/注册 ARM Compiler V6.24 的 Keil 环境中重新编译 `SmartWardrobeCode.uvprojx`，确认 0 Error。
- 烧录后先执行 `M1 ENC_MOVE DIR=CW RPM=20 CNT=360 TOL=36`，观察接近目标时是否降速并输出 `OK M1 ENC_MOVE_DONE`。
- 再分别执行 `M3 ENC_MOVE`、`M4 ENC_MOVE` 小距离测试。
- 最后执行 `AXIS ENC_MOVE X=720 Y=720 Z=720 RPM=30 TOL=36`，确认三轴均能到位且无 `ERR 206`。
- 取放衣流程验证前，先用低 RPM 和较大 TOL 进行空载测试。
## 2026-07-08 10:44:45

### 修改类型
修改

### 涉及文件
- `Src/main.c`
- `APP/Src/cmd_dispatch.c`
- `修改日志/修改日志.md`

### 修改内容
- 将 `WARDROBE_TEXT_OUTPUT_ENABLE` 从 `0U` 改为 `1U`，打开 USART3 普通 ASCII 文本调试输出。
- 新增 `WARDROBE_BINARY_STATUS_HEARTBEAT_ENABLE` 开关，并默认设置为 `0U`。
- 在 `Wardrobe_StatusHeartbeat_Tick1ms()` 中关闭周期性自动发送 `A5 A0 06 ... 5A` 二进制状态帧，避免普通串口助手 ASCII 窗口被 11 Bytes 状态帧刷屏。
- 保留手动读取状态命令逻辑：收到二进制读状态命令 `A5 20 00 20 5A` 时仍会调用 `Wardrobe_SendStatus()` 返回状态帧。
- 将版本号从 `SmartWardrobe-STM32F407 v1.4.17` 更新为 `SmartWardrobe-STM32F407 v1.4.18`。

### 修改原因
- 用户反馈发送 `M2 STATUS` 一类 ASCII 指令没有反应，同时串口疯狂显示 11 Bytes 乱码。
- 根因是文本输出默认关闭，而二进制状态帧不受文本输出开关控制，导致串口助手能看到二进制帧但看不到 `OK/ERR/STAT` 文本回复。

### 问题修复类型
根本性修复

### 根因分析
- `UartConsole_QueueLine()` 和 `UartConsole_QueueLineDropOldest()` 在 `g_text_output_enabled == 0U` 时直接返回，不会把 ASCII 文本加入发送队列。
- `UartConsole_QueueBytes()` 不受 `g_text_output_enabled` 控制，二进制状态帧仍会发送。
- 因此用户在 ASCII 串口窗口中看到 `A5 A0 06 ... 5A` 被显示成乱码，但 `M2 STATUS` 等文本命令的响应被丢弃。
- 本次同时打开文本输出并关闭自动二进制状态心跳，使调试时能看到文本响应且不再自动刷屏。

### 工程原则应用
- KISS：只改串口输出开关和状态心跳发送门控，不改协议解析、不改取放衣和 PID 运动逻辑。
- YAGNI：没有新增复杂运行时命令或双模式配置系统，先满足当前串口调试需求。
- DRY：保留现有 `Wardrobe_SendStatus()` 供手动读状态复用，没有复制第二套状态响应逻辑。
- SOLID：当前为嵌入式 C 主循环输出策略调整，不强行套用复杂架构。

### 问题确认情况
- 用户已明确授权“你直接改”。
- 现象、截图和代码路径一致：11 Bytes 且末尾 `Z` 对应二进制状态帧尾 `0x5A`，文本响应关闭对应 `M2 STATUS` 无文本回显。

### 风险评估
- 调试串口会开始输出 `OK/ERR/STAT` 文本，便于现场调试。
- 自动状态心跳关闭后，ESP32 不会再被 STM32 周期性主动推送状态；但 ESP32/上位机主动发 `0x20` 读状态仍可获得状态帧。
- 若后续需要恢复云端周期状态上报，可将 `WARDROBE_BINARY_STATUS_HEARTBEAT_ENABLE` 改回 `1U`。

### 验证方式
- 本次已使用本机 `armclang 6.18` 对 `Src/main.c` 和 `APP/Src/cmd_dispatch.c` 执行 `-fsyntax-only` 语法检查，退出码为 0。
- 烧录后打开普通串口助手 ASCII 显示，确认不再自动刷 11 Bytes 二进制状态帧。
- 发送 `VER`，应返回 `SmartWardrobe-STM32F407 v1.4.18`。
- 发送 `M2 STATUS`、`M2 ABS_STATUS`、`M2 ROT_STATUS`，应看到文本响应。
- 如需验证手动二进制读状态，使用 HEX 发送 `A5 20 00 20 5A`，应返回 `A5 A0 06 ... 5A`。
## 2026-07-08 10:52:18

### 修改类型
修改

### 涉及文件
- `Src/main.c`
- `APP/Src/cmd_dispatch.c`
- `修改日志/修改日志.md`

### 修改内容
- 将固件切换为纯 USART3 ASCII 串口调试模式。
- 将 `WARDROBE_BOOT_HOME_ENABLE` 设置为 `0U`，关闭上电自动 HOME，避免调试刚启动就被自动运动流程干扰。
- 新增并启用 `WARDROBE_BINARY_PROTOCOL_ENABLE 0U`，主循环不再执行 ESP32/云端二进制帧命令。
- `Wardrobe_SendFrame()` 在纯串口调试模式下直接丢弃 `A5 ... 5A` 二进制回复，避免 ASCII 串口窗口继续显示乱码帧。
- 主循环仍会轮询并丢弃二进制帧，防止帧队列堆积，但不会执行二进制协议动作。
- 保持 `WARDROBE_TEXT_OUTPUT_ENABLE 1U`，只保留 `M2 STATUS`、`M2 ABS_STATUS`、`AXIS ...` 等 ASCII 文本命令和响应。
- 将版本号从 `SmartWardrobe-STM32F407 v1.4.18` 更新为 `SmartWardrobe-STM32F407 v1.4.19`。

### 修改原因
- 用户反馈上一轮仍无效，并明确要求“改成纯串口调试”。
- 上一轮虽然关闭了自动状态心跳，但仍保留二进制协议入口和二进制回复；如果 ESP32 或其他设备持续发二进制读状态/业务帧，STM32 仍可能产生二进制输出或执行云端协议逻辑。

### 问题修复类型
根本性修复

### 根因分析
- 真正需要的是把 USART3 从“ESP32 二进制协议 + ASCII 调试共用口”切到“纯 ASCII 调试口”。
- 根因不是 `M2 STATUS` 命令格式，而是调试口仍混杂二进制协议流，普通串口助手无法稳定观察文本响应。
- 本次从输入和输出两侧同时切断二进制协议：输入侧丢弃帧不执行，输出侧不发送二进制帧，调试侧只保留 ASCII 文本命令。

### 工程原则应用
- KISS：通过宏开关切换调试模式，不删除原有 ESP32 协议代码，后续可一行改回。
- YAGNI：没有新增运行时模式切换命令，先满足当前现场串口调试。
- DRY：保留原有 ASCII 命令解析和响应路径，不复制第二套调试命令系统。
- SOLID：当前为嵌入式 C 主循环门控调整，不引入复杂抽象。

### 问题确认情况
- 用户明确要求直接改成纯串口调试，已按要求修改。

### 风险评估
- 当前固件烧录后不再响应 ESP32/阿里云二进制帧，也不会自动上电 HOME。
- 需要云端控制或自动 HOME 时，必须把 `WARDROBE_BINARY_PROTOCOL_ENABLE` 和/或 `WARDROBE_BOOT_HOME_ENABLE` 改回 `1U`。
- 纯串口调试期间建议断开 ESP32 TX/RX，或者至少确认 ESP32 不再占用 USART3。

### 验证方式
- 本次已使用本机 `armclang 6.18` 对 `Src/main.c` 和 `APP/Src/cmd_dispatch.c` 执行 `-fsyntax-only` 语法检查，退出码为 0。
- 烧录后串口助手选择 ASCII/文本模式，波特率 `115200 8N1`。
- 上电后不应再自动刷 `11 Bytes` 二进制帧，也不应自动执行 HOME。
- 发送 `VER`，应返回 `SmartWardrobe-STM32F407 v1.4.19`。
- 发送 `M2 STATUS`、`M2 ABS_STATUS`、`M2 ROT_STATUS`，应看到文本响应。
## 2026-07-08 11:06:38

### 修改类型
修改

### 涉及文件
- `APP/Src/cmd_dispatch.c`
- `APP/COMMANDS.md`
- `修改日志/修改日志.md`

### 修改内容
- 按真实硬件修正 M2 控制方式：M2 没有 EX_KEY2 行程开关，只保留 RS485 绝对值编码器角度控制。
- 将 `M2_ABS_BOOT_HOME_ENABLE` 从 `1U` 改为 `0U`，关闭 M2 上电自动角度归零，避免调试时 M2 自己转动。
- 禁用 `M2 HOME_EX2` 行程开关回零命令；收到该命令时返回 `M2_NO_EXKEY_USE_ABS_MOVE`，提示改用绝对值编码器角度控制。
- 从系统 `HELP` 摘要中移除 `M2 HOME_EX2`。
- 更新 `APP/COMMANDS.md`，说明当前硬件 M2 不使用行程开关，M2 只用 `ABS_STATUS` / `ABS_ZERO` / `ABS_MOVE`。
- 将版本号从 `SmartWardrobe-STM32F407 v1.4.19` 更新为 `SmartWardrobe-STM32F407 v1.4.20`。

### 修改原因
- 用户确认 M2 没有行程开关，只需要控制角度。
- 原代码仍保留 `M2 HOME_EX2` 和 M2 上电自动角度归零，容易在现场造成误操作或上电后非预期运动。

### 问题修复类型
根本性修复

### 根因分析
- M2 的实际硬件能力与命令文档/代码中暴露的 `HOME_EX2` 行程开关回零能力不一致。
- 如果继续允许 `M2 HOME_EX2`，固件会让 M2 向 CCW 方向寻找不存在的 EX_KEY2，存在盲转风险。
- 本次从命令执行、HELP 文本和文档三处同步收敛为“只用绝对值编码器角度控制”。

### 工程原则应用
- KISS：只禁用 M2 行程开关命令并关闭 M2 自动归零，不重构 M1/M3/M4 的回零逻辑。
- YAGNI：没有新增复杂的硬件配置系统，先按当前真实硬件固定 M2 为角度控制。
- DRY：继续复用现有 `ABS_STATUS`、`ABS_ZERO`、`ABS_MOVE` 角度控制链路。
- SOLID：当前是嵌入式 C 命令分发修正，不强行引入抽象层。

### 问题确认情况
- 用户明确说明“M2没有行程开关，只需控制角度”，已按此硬件事实修改。

### 风险评估
- `M2 HOME_EX2` 不再可用，改用 `M2 ABS_MOVE DEG=... RPM=...`。
- M2 上电后不会自动转到 0 度，需要手动发送角度控制命令。
- 若未来 M2 重新加装行程开关，需要恢复 `M2 HOME_EX2` 支持并重新验证 EX_KEY2 接线。

### 验证方式
- 本次已使用本机 `armclang 6.18` 对 `APP/Src/cmd_dispatch.c` 执行 `-fsyntax-only` 语法检查，退出码为 0。
- 烧录后发送 `VER`，应返回 `SmartWardrobe-STM32F407 v1.4.20`。
- 发送 `M2 HOME_EX2 RPM=60`，应返回错误 `M2_NO_EXKEY_USE_ABS_MOVE`。
- 发送 `M2 ABS_STATUS`，应返回当前绝对值编码器角度。
- 发送 `M2 ABS_MOVE DEG=0 RPM=20 TOL=2`，M2 应按绝对值编码器角度移动到 0 度附近。
## 2026-07-08 11:11:41

### 修改类型
修改

### 涉及文件
- `APP/Src/cmd_dispatch.c`
- `APP/COMMANDS.md`
- `修改日志/修改日志.md`

### 修改内容
- 按用户要求恢复 M2 基于 RS485 绝对值编码器的上电自动回零点功能。
- 将 `M2_ABS_BOOT_HOME_ENABLE` 从 `0U` 改回 `1U`。
- 保持 `M2 HOME_EX2` 禁用，M2 仍然不使用行程开关。
- M2 上电自动回零目标仍为 `M2_ABS_BOOT_HOME_TARGET_DEG 0.0f`，即回到用户通过 `M2 ABS_ZERO` 指定的 `DEG=0` 零点。
- 更新命令文档，说明先用 `M2 ABS_ZERO` 保存机械零点，之后上电会自动尝试回到 `DEG=0`。
- 将版本号从 `SmartWardrobe-STM32F407 v1.4.20` 更新为 `SmartWardrobe-STM32F407 v1.4.21`。

### 修改原因
- 用户希望上电后 M2 回到其指定的零点。
- M2 无行程开关，因此应使用绝对值编码器零点作为上电回零目标，而不是 EX_KEY2。

### 问题修复类型
根本性修复

### 根因分析
- 用户所说的“指定零点”对应绝对值编码器的 `DEG=0`，由 `M2 ABS_ZERO` 写入。
- 原上一轮为了纯串口调试关闭了 `M2_ABS_BOOT_HOME_ENABLE`，导致 M2 上电不会自动回到 `DEG=0`。
- 本次只恢复 M2 绝对值编码器上电归零，不恢复 M2 行程开关回零，符合当前硬件事实。

### 工程原则应用
- KISS：只打开 M2 绝对值编码器上电回零开关，不新增第二套零点系统。
- YAGNI：不恢复不存在的 EX_KEY2，也不新增复杂参数配置。
- DRY：复用现有 `M2 ABS_ZERO`、`M2 ABS_MOVE` 和 M2 boot-home 状态机。
- SOLID：当前为嵌入式 C 参数开关修正，不强行抽象。

### 问题确认情况
- 用户明确说明希望上电后 M2 回到其指定的零点，已按该目标修改。

### 风险评估
- 上电约 2 秒后，M2 会尝试以 `M2_ABS_BOOT_HOME_RPM 25.0f` 回到 `DEG=0`，调试时需确保机械周围安全。
- 如果尚未发送过 `M2 ABS_ZERO` 正确设置零点，M2 会回到编码器当前保存的 0 度位置。
- 若方向配置或编码器方向不匹配，可能出现 `M2_ABS_WRONG_DIR`，需要根据串口日志调整方向配置。

### 验证方式
- 本次已使用本机 `armclang 6.18` 对 `APP/Src/cmd_dispatch.c` 执行 `-fsyntax-only` 语法检查，退出码为 0。
- 烧录后发送 `VER`，应返回 `SmartWardrobe-STM32F407 v1.4.21`。
- 手动把 M2 调到希望的机械零点，发送 `M2 ABS_ZERO`。
- 发送 `M2 ABS_STATUS`，确认角度接近 `DEG=0`。
- 重新上电，观察 M2 是否自动回到 `DEG=0` 附近。
## 2026-07-08 11:21:24

### 修改类型
修改

### 涉及文件
- `Src/main.c`
- `APP/Src/cmd_dispatch.c`
- `修改日志/修改日志.md`

### 修改内容
- 按用户明确需求恢复 M1/M3/M4 上电自动 `ALL HOME`。
- 将 `WARDROBE_BOOT_HOME_ENABLE` 从 `0U` 改回 `1U`。
- 保持 `WARDROBE_BINARY_PROTOCOL_ENABLE 0U`、`WARDROBE_BINARY_STATUS_HEARTBEAT_ENABLE 0U`、`WARDROBE_TEXT_OUTPUT_ENABLE 1U`，即仍保持纯 ASCII 串口调试，不恢复 ESP32 二进制协议和状态刷屏。
- 保持 `M2_ABS_BOOT_HOME_ENABLE 1U`，M2 上电后按绝对值编码器回到用户通过 `M2 ABS_ZERO` 指定的 `DEG=0` 零点。
- 将版本号从 `SmartWardrobe-STM32F407 v1.4.21` 更新为 `SmartWardrobe-STM32F407 v1.4.22`。

### 修改原因
- 用户澄清期望行为：上电后 M1/M3/M4 自动 `ALL HOME`，M2 转到其指定零点。
- 上一轮纯串口调试时关闭了 `WARDROBE_BOOT_HOME_ENABLE`，导致 M1/M3/M4 不再自动回零，不符合最终需求。

### 问题修复类型
根本性修复

### 根因分析
- M1/M3/M4 的上电自动回零由 `Src/main.c` 中的 `WARDROBE_BOOT_HOME_ENABLE` 控制。
- M2 的上电回零由 `APP/Src/cmd_dispatch.c` 中的 `M2_ABS_BOOT_HOME_ENABLE` 控制。
- 两者是独立开关：用户最终需要两个都开启，但仍关闭 ESP32 二进制协议以便串口文本调试。

### 工程原则应用
- KISS：只恢复 M1/M3/M4 上电 HOME 开关，不改动已完成的 M2 角度零点逻辑和 PID 逻辑。
- YAGNI：没有恢复 ESP32 二进制协议和周期状态刷屏，避免再次干扰串口调试。
- DRY：继续复用已有 `ALL HOME` 和 M2 ABS boot-home 状态机。
- SOLID：当前为嵌入式 C 配置修正，不引入额外模式系统。

### 问题确认情况
- 用户明确说明“上电后 M1/M3/M4 自动 ALL HOME，M2 转到零点”，已按此行为修改。

### 风险评估
- 上电后 M1/M3/M4 会自动运动到各自回零开关，M2 会自动运动到 `DEG=0`，需要确保机械空间安全。
- 当前仍为纯 ASCII 串口调试模式，ESP32/MQTT 二进制控制不可用。
- 如果需要恢复云端控制，后续再将 `WARDROBE_BINARY_PROTOCOL_ENABLE` 改回 `1U` 并重新验证。

### 验证方式
- 本次已使用本机 `armclang 6.18` 对 `Src/main.c` 和 `APP/Src/cmd_dispatch.c` 执行 `-fsyntax-only` 语法检查，退出码为 0。
- 烧录后发送 `VER`，应返回 `SmartWardrobe-STM32F407 v1.4.22`。
- 重新上电，观察 M1/M3/M4 是否自动执行 `ALL HOME`。
- 重新上电，观察 M2 是否自动回到 `DEG=0` 附近。
- 串口助手应显示 ASCII 文本日志，不应自动刷 `11 Bytes` 二进制状态帧。
## 2026-07-08 11:32:12

### 修改类型
修改

### 涉及文件
- `APP/Src/cmd_dispatch.c`
- `APP/COMMANDS.md`
- `修改日志/修改日志.md`

### 修改内容
- 按用户实测数据修改 M2 上电自动回零目标：`ADDR=1, RAW=1008, DEG=354.38, CPR=1024`。
- 新增 `M2_ABS_BOOT_HOME_USE_FIXED_RAW 1U` 和 `M2_ABS_BOOT_HOME_TARGET_RAW 1008U`。
- 将 `M2_ABS_BOOT_HOME_TARGET_DEG` 改为 `354.38f`，用于日志显示和目标角度语义说明。
- M2 boot-home 目标 `target_raw` 改为直接使用固定 RAW 值，不再通过 `DEG=0` 或 `M2 ABS_ZERO` 推算。
- 更新命令文档，说明当前 M2 上电自动回到固定 `RAW=1008`，不再依赖 `M2 ABS_ZERO` 保存的零点。
- 将版本号从 `SmartWardrobe-STM32F407 v1.4.22` 更新为 `SmartWardrobe-STM32F407 v1.4.23`。

### 修改原因
- 用户反馈 M2 回零有问题，并提供实际需要的零点数据，希望固件上电直接回到该数据对应位置。
- 固定 RAW 目标比依赖 `ABS_ZERO` 更直接，能避免编码器零点写入或 DEG 换算带来的现场不确定性。

### 问题修复类型
根本性修复

### 根因分析
- 现有 M2 上电回零目标以 `DEG=0` 为基准，依赖绝对值编码器零点写入是否正确。
- 用户已经实测出机械需要的位置是 `RAW=1008`，因此最直接的根因修复是把上电目标从逻辑零点改为固定绝对原始计数。
- 固件仍保留 `M2 ABS_STATUS` / `M2 ABS_MOVE` / `M2 ABS_ZERO`，但 boot-home 不再依赖 `ABS_ZERO`。

### 工程原则应用
- KISS：直接使用用户实测 RAW 值作为上电目标，不新增复杂标定表。
- YAGNI：只实现当前需要的固定零点，不做多零点管理或云端配置。
- DRY：复用原 M2 boot-home 的方向选择、容差判断、卡滞检测和错误上报状态机。
- SOLID：当前为嵌入式 C 常量和目标计算修正，不引入额外抽象。

### 问题确认情况
- 用户提供实测数据：`ABS M2 ADDR=1 RAW=1008 DEG=354.38 CPR=1024`，已按该数据修改。

### 风险评估
- 上电后 M2 会尝试回到固定 `RAW=1008`，需确认该位置在机械安全范围内。
- 如果后续机械零点重新调整，需要重新修改 `M2_ABS_BOOT_HOME_TARGET_RAW`。
- 若出现 `M2_ABS_WRONG_DIR`，说明编码器 RAW 增减方向与电机方向配置不匹配，需要调整 `M2_ABS_CW_RAW_INCREASES` 或接线方向。

### 验证方式
- 本次已使用本机 `armclang 6.18` 对 `APP/Src/cmd_dispatch.c` 执行 `-fsyntax-only` 语法检查，退出码为 0。
- 烧录后发送 `VER`，应返回 `SmartWardrobe-STM32F407 v1.4.23`。
- 重新上电，观察 M2 boot-home 日志中的 `TARGET_RAW=1008`。
- 上电完成后发送 `M2 ABS_STATUS`，确认 `RAW` 接近 `1008`，`DEG` 接近 `354.38`。
## 2026-07-08 11:41:41

### 修改类型
修复

### 涉及文件
- `APP/Src/cmd_dispatch.c`
- `修改日志/修改日志.md`

### 修改内容
- 根据实测 M2 绝对值编码器方向，修正 RAW 增减方向配置。
- 将 `M2_ABS_CW_RAW_INCREASES` 从 `0U` 改为 `1U`。
- 将版本号从 `SmartWardrobe-STM32F407 v1.4.23` 更新为 `SmartWardrobe-STM32F407 v1.4.24`。

### 修改原因
- 用户执行 `M2 ABS_MOVE DEG=354.38 RPM=20 TOL=2` 时，固件选择 `DIR=CCW`，但实测 RAW 从 `842` 降到 `841`，随后停在 `833`，并报 `ERR 208 M2_ABS_WRONG_DIR RAW=841 TARGET_RAW=1008`。
- 这说明当前硬件上 `CCW` 会让 RAW 减小，原配置却认为 `CCW` 会让 RAW 增大，方向映射反了。

### 问题修复类型
根本性修复

### 根因分析
- M2 从 `RAW=842` 到目标 `RAW=1008` 的最短路径是 RAW 增大 `166` count。
- 原配置 `M2_ABS_CW_RAW_INCREASES 0U` 表示固件认为 `CCW` 才会让 RAW 增大，因此错误选择 `CCW`。
- 实测 `CCW` 导致 RAW 减小，因此应配置为 `CW` 让 RAW 增大，即 `M2_ABS_CW_RAW_INCREASES 1U`。

### 工程原则应用
- KISS：只修正方向映射常量，不改动 M2 boot-home、ABS_MOVE 或错误检测状态机。
- YAGNI：没有新增额外方向配置命令，先按当前硬件事实固定。
- DRY：继续复用原有方向选择、wrong-dir 检测和卡滞检测逻辑。
- SOLID：当前为嵌入式 C 常量修复，不引入复杂抽象。

### 问题确认情况
- 用户提供了直接运行日志，已确认 `CCW` 导致 RAW 减小，是确定原因。

### 风险评估
- M2 后续从较小 RAW 移动到较大 RAW 时会优先选择 `CW`。
- 如果现场重新调整电机方向接线或驱动器方向设置，该常量可能需要再次反转。

### 验证方式
- 本次已使用本机 `armclang 6.18` 对 `APP/Src/cmd_dispatch.c` 执行 `-fsyntax-only` 语法检查，退出码为 0。
- 烧录后发送 `VER`，应返回 `SmartWardrobe-STM32F407 v1.4.24`。
- 发送 `M2 ABS_MOVE DEG=354.38 RPM=20 TOL=2`，预期固件选择 `DIR=CW`。
- 动作完成后发送 `M2 ABS_STATUS`，预期 `RAW` 接近 `1008`，`DEG` 接近 `354.38`。
- 重新上电，预期 M2 boot-home 也会向 `RAW=1008` 收敛。
## 2026-07-09 18:18:52

### 修改类型
修改 / 修复

### 涉及文件
- `APP/Src/cmd_dispatch.c`
- `APP/COMMANDS.md`
- `APP/SERIAL_COMMANDS_EASY.md`
- `程序介绍.md`

### 修改内容
- 将固件版本号更新为 `SmartWardrobe-STM32F407 v1.4.34-takez300`。
- 将取衣流程回到交换区后的顺序从 `X2250,Y3433,Z0` 改为 `X2250,Z300,Y3433`。
- 新增取衣释放高度常量 `TAKE_CLOTH_PICK_Z=300`，替代原先状态机里的 `0L` 硬编码。
- 更新 `AXIS TAKE_CLOTH` 启动回显和相关文档说明。

### 修改原因
- 用户明确要求把取衣流程中 `Y/M3 到取放交换点：Y=3433` 和 `Z/M4 降到交换点：Z=0` 两个步骤互换，并将 Z 改为 `Z=300`。

### 问题修复类型
根本性修复

### 根因分析
- 原状态机在取衣后段执行顺序为 `PICK_X -> PICK_Y -> PICK_Z -> WAIT`，且 `PICK_Z` 使用硬编码目标 `0L`。
- 现场最新流程要求应先让 X 到 `2250`，再让 Z 到 `300`，最后让 Y 到 `3433` 后再等待松爪。
- 本次直接调整状态机推进顺序和 Z 目标常量，避免只改回显或文档造成实机动作仍按旧顺序执行。

### 工程原则应用
- KISS：只调整取衣后段必要状态顺序和目标常量，不重构底层电机、编码器和回零逻辑。
- YAGNI：没有新增额外配置命令或复杂路径规划器。
- DRY：用 `TAKE_CLOTH_PICK_Z` 统一取衣释放高度，避免状态机和回显分散硬编码。
- SOLID：当前为 C 状态机参数与顺序调整，不强行套用复杂架构。

### 问题确认情况
- 用户已明确指定目标顺序和 Z 目标值。
- 已确认源码中旧顺序确实为 `X2250 -> Y3433 -> Z0`，与用户要求不一致。

### 风险评估
- 影响范围限定为 `AXIS TAKE_CLOTH` 取衣流程回到交换区后的释放动作。
- `AXIS PLACE_CLOTH` 放衣流程、取衣进衣格坐标和 M2 转向动作不受影响。

### 验证方式
- 构建后检查 `hex/axf` 中应包含 `SmartWardrobe-STM32F407 v1.4.34-takez300`。
- 构建日志 `MDK-ARM/build_take_z300.log` 显示 `0 Error(s), 0 Warning(s)`。
- 已确认新 `axf` 中包含版本号 `SmartWardrobe-STM32F407 v1.4.34-takez300` 和启动回显片段 `M2_CCW480,X2250,Z300,Y3433`。
- 烧录后发送 `SYS VER`，应返回 `OK VER SmartWardrobe-STM32F407 v1.4.34-takez300`。
- 执行 `AXIS TAKE_CLOTH`，启动回显应包含 `M2_CCW480,X2250,Z300,Y3433`，运行日志应按 `PICK_X -> PICK_Z -> PICK_Y` 顺序出现。
## 2026-07-09 18:34:26

### 修改类型
修改 / 修复

### 涉及文件
- `APP/Src/cmd_dispatch.c`
- `APP/COMMANDS.md`
- `APP/SERIAL_COMMANDS_EASY.md`
- `程序介绍.md`
- `MDK-ARM/build_m2cw600.log`
- `MDK-ARM/SmartWardrobeCode/SmartWardrobeCode.hex`
- `MDK-ARM/SmartWardrobeCode/SmartWardrobeCode.axf`

### 修改内容
- 将固件版本号更新为 `SmartWardrobe-STM32F407 v1.4.35-m2cw600`。
- 将取衣第 9 步 M2 转向从 `CCW RPM=10 STEP=480` 改为 `CCW RPM=10 STEP=600`。
- 在取衣 `X/M1 到 X=2250` 后新增一步 M2 转向：`CW RPM=10 STEP=600`。
- 将取衣启动回显更新为 `M2_CCW600,X2250,M2_CW600,Z300,Y3433`。
- 同步更新命令文档、简易串口说明和程序介绍。

### 修改原因
- 用户明确要求第 9 步 M2 转到 `600`，并在第 10 步 `X=2250` 后新增 `M2 CW RPM=10 STEP=600`。

### 问题修复类型
根本性修复

### 根因分析
- 原取衣状态机只有一段 M2 定步动作：`Y_HOME -> M2_CCW480 -> X2250 -> Z300 -> Y3433`。
- 当前现场流程要求 M2 先逆时针转 `600`，X 到取放交换点后再顺时针转回 `600`，之后才能继续 Z/Y 释放动作。
- 本次新增 `TAKE_CLOTH_MOVE_M2_BACK` 状态，保证第二段 M2 必须等 X 到位后启动，并且 Z=300 必须等第二段 M2 完成后才执行。

### 工程原则应用
- KISS：只新增必要状态和 M2 参数，不改动底层电机控制和编码器闭环。
- YAGNI：没有新增不需要的配置接口或路径规划功能。
- DRY：将 M2 定步启动函数改为接收方向和步数，避免为 CCW/CW 写两份重复逻辑。
- SOLID：当前为 C 状态机流程调整，不强行套用复杂架构。

### 问题确认情况
- 用户已明确指定第 9 步和第 10 步后的 M2 动作。
- 已确认旧源码中 M2 只有 `CCW STEP=480`，且 `X=2250` 后直接进入 Z/Y 释放动作。

### 风险评估
- 影响范围限定为 `AXIS TAKE_CLOTH` 取衣流程的 M2 转向和后续释放时序。
- `AXIS PLACE_CLOTH` 放衣流程不受影响。

### 验证方式
- 构建日志 `MDK-ARM/build_m2cw600.log` 应显示 `0 Error(s), 0 Warning(s)`。
- 新 `axf` 应包含 `SmartWardrobe-STM32F407 v1.4.35-m2cw600` 和 `M2_CCW600,X2250,M2_CW600,Z300,Y3433`。
- 烧录后发送 `SYS VER`，应返回 `OK VER SmartWardrobe-STM32F407 v1.4.35-m2cw600`。
- 执行 `AXIS TAKE_CLOTH`，串口应先出现 `M2 CCW RPM=10 STEP=600`，X 到 `2250` 后出现 `M2 CW RPM=10 STEP=600`，再进入 `PICK_Z` 和 `PICK_Y`。
## 2026-07-09 20:01:11

### 修改类型
修改 / 修复

### 涉及文件
- `APP/Src/cmd_dispatch.c`
- `APP/COMMANDS.md`
- `APP/SERIAL_COMMANDS_EASY.md`
- `程序介绍.md`
- `MDK-ARM/build_dirfilter.log`
- `MDK-ARM/SmartWardrobeCode/SmartWardrobeCode.hex`
- `MDK-ARM/SmartWardrobeCode/SmartWardrobeCode.axf`

### 修改内容
- 将固件版本号更新为 `SmartWardrobe-STM32F407 v1.4.36-dirfilter`。
- 为 M1/M3/M4 编码器闭环方向保护增加小幅反向容忍。
- 新增方向异常参数：`ENC_MOVE_WRONG_DIR_TOL=20`、`ENC_MOVE_WRONG_DIR_COUNT_LIMIT=3`、`ENC_MOVE_WRONG_DIR_ACCUM_LIMIT=60`、`ENC_MOVE_WRONG_DIR_IMMEDIATE_LIMIT=80`。
- `ENC_WRONG_DIR` 日志新增 `LAST/DELTA/WCNT/WACC`，便于判断反向前计数、单次反向量、连续异常次数和累计异常量。
- 同步更新命令文档、简易串口说明和程序介绍。

### 修改原因
- 用户反馈无机械阻力时，放衣/取衣流程中 M1/M3/M4 偶发 `ENC_WRONG_DIR` 急停。
- 现场日志显示 `CNT=4994 TARGET=13000`，从 `X=5000` 附近只反向跳动约 `6 count` 就触发急停，说明原方向保护过于敏感。

### 问题修复类型
根本性修复

### 根因分析
- 原方向保护逻辑只要单次编码器计数变化方向与目标运动方向相反，就立即 `EStop` 并报 `ERR 206 Mx_ENC_WRONG_DIR`。
- 编码器 A/B 相毛刺、读数抖动、启停瞬间回跳都可能产生小幅反向计数，不代表电机真实反向运行。
- 本次保留真实反向保护，但对 `<=20 count` 的小幅反向跳动不急停；超过阈值后连续或累计异常才报错，单次大反向仍立即急停。

### 工程原则应用
- KISS：只修改 M1/M3/M4 编码器方向保护，不改动 PID 参数、电机方向映射和取放衣状态机。
- YAGNI：没有新增复杂配置命令或运行时参数系统。
- DRY：M1/M3/M4 继续共用同一套 `EncMove_t` 保护逻辑。
- SOLID：当前为嵌入式 C 状态保护逻辑调整，不强行套用复杂架构。

### 问题确认情况
- 用户已明确确认按方向容忍方案修改。
- 已确认该保护只作用于 M1/M3/M4 的编码器闭环运动，不影响 M2 绝对值编码器和 M5 夹爪。

### 风险评估
- 小幅编码器反向抖动不会再立即中断流程。
- 如果真实方向接反但每次反向变化较小，会在连续 `3` 次或累计 `60 count` 后停机；单次反向 `>=80 count` 仍立即停机。

### 验证方式
- 构建日志 `MDK-ARM/build_dirfilter.log` 应显示 `0 Error(s), 0 Warning(s)`。
- 新 `axf` 应包含 `SmartWardrobe-STM32F407 v1.4.36-dirfilter` 和 `LAST=%ld DELTA=%ld WCNT=%u WACC=%lu`。
- 烧录后发送 `SYS VER`，应返回 `OK VER SmartWardrobe-STM32F407 v1.4.36-dirfilter`。
- 复测放衣流程时，`5000 -> 4994` 这类小幅反向跳动不应再触发 `ENC_WRONG_DIR`。
## 2026-07-09 20:50:17

### 修改类型
修改 / 分阶段修复 / 诊断增强

### 涉及文件
- `APP/Src/cmd_dispatch.c`
- `APP/COMMANDS.md`
- `APP/SERIAL_COMMANDS_EASY.md`
- `程序介绍.md`
- `MDK-ARM/build_stalldiag.log`
- `MDK-ARM/SmartWardrobeCode/SmartWardrobeCode.hex`
- `MDK-ARM/SmartWardrobeCode/SmartWardrobeCode.axf`

### 修改内容
- 将固件版本号更新为 `SmartWardrobe-STM32F407 v1.4.37-stalldiag`。
- 将 `ERR 206 Mx_ENC_STALL` 失速日志扩展为输出 `MODE/DIR/MRPM/STEP/REM`。
- 将失速日志缓冲区从 `160` 字节扩大到 `240` 字节，避免新增字段被截断。
- 同步更新命令文档、简易串口说明和程序介绍中的失速日志字段说明。

### 修改原因
- 用户连续反馈 `M1_ENC_STALL` 和 `M4_ENC_STALL`，日志显示 `BOOST=1` 且 `RPM=45.00` 后编码器仍无计数变化。
- 现有日志只能判断编码器无变化，不能区分是 STEP 脉冲没有继续输出，还是电机在动但编码器反馈没有变化。

### 问题修复类型
分阶段修复

### 根因分析
- 当前现象的直接原因是 M1/M4 编码器计数在失速窗口内不变化。
- 由于旧日志缺少电机控制层的 `mode/dir/rpm/steps_total`，还不能直接确认根因属于输出脉冲链路还是编码器反馈链路。
- 本次先增强诊断日志，下一次现场报错即可通过 `STEP` 是否增加判断是脉冲输出问题还是编码器反馈问题。

### 工程原则应用
- KISS：只增强失速日志，不调整 PID、保护阈值、运动顺序或底层驱动接口。
- YAGNI：没有新增运行时配置命令或复杂调试模式，只输出当前定位必需字段。
- DRY：复用 `MotorCtrl_GetStatus()`、`MotorCtrl_ModeToString()` 和 `MotorCtrl_DirToString()` 的现有状态接口。
- SOLID：当前为嵌入式 C 诊断增强，不强行引入额外抽象。

### 问题确认情况
- 用户已明确回复“确认”，同意按失速诊断增强方向修改。
- 本次不宣称已经根治 M1/M4 停止问题，只为下一轮实机日志定位根因。

### 风险评估
- 不改变电机实际动作、PID 参数、失速阈值和急停策略，运行风险较低。
- 串口失速错误行会变长，但当前发送缓冲区支持该长度。

### 验证方式
- 构建日志 `MDK-ARM/build_stalldiag.log` 应显示 `0 Error(s), 0 Warning(s)`。
- 新 `axf` 应包含 `SmartWardrobe-STM32F407 v1.4.37-stalldiag` 和 `MODE=%s DIR=%s MRPM=%.2f STEP=%lu REM=%lu`。
- 烧录后发送 `SYS VER`，应返回 `OK VER SmartWardrobe-STM32F407 v1.4.37-stalldiag`。
- 若再次触发 `ERR 206 Mx_ENC_STALL`，根据 `STEP` 是否增加判断下一步：`STEP` 增加而 `CNT` 不变则查编码器反馈，`STEP` 不增加则查 STEP/PWM/使能输出。
## 2026-07-09 21:05:00

### 修改类型
修复 / 分阶段修复 / 风险收敛

### 涉及文件
- `APP/Src/cmd_dispatch.c`
- `APP/COMMANDS.md`
- `APP/SERIAL_COMMANDS_EASY.md`
- `程序介绍.md`
- `修改日志/修改日志.md`
- `MDK-ARM/build_stalldiag_lite.log`
- `MDK-ARM/SmartWardrobeCode/SmartWardrobeCode.hex`
- `MDK-ARM/SmartWardrobeCode/SmartWardrobeCode.axf`

### 修改内容
- 将固件版本号更新为 `SmartWardrobe-STM32F407 v1.4.38-stalldiag-lite`。
- 将失速日志缓冲区从 `240` 字节恢复为 `160` 字节。
- 将 `ERR 206 Mx_ENC_STALL` 新增诊断字段从 `MODE/DIR/MRPM/STEP/REM` 压缩为 `MODE/DIR/STEP`。
- 同步更新文档中失速日志字段说明。

### 修改原因
- 用户反馈烧录 `v1.4.37-stalldiag` 后衣柜不动。
- `v1.4.37` 未改运动流程、PID、目标坐标或电机驱动，但在 `SafetyTick` 中把局部日志缓冲区扩大到 `240` 字节，存在嵌入式栈压力副作用风险。

### 问题修复类型
分阶段修复

### 根因分析
- 当前无法仅凭现象确认“不动”的根因，但本次最新改动中唯一可能影响运行稳定性的点是长格式日志和更大的局部缓冲区。
- 本次先回收这部分风险，同时保留最关键的 `STEP` 诊断字段，用于后续区分 STEP 脉冲输出问题和编码器反馈问题。

### 工程原则应用
- KISS：只收敛诊断日志长度和栈占用，不改运动控制链路。
- YAGNI：不继续增加额外调试字段，先保留最关键字段。
- DRY：继续复用现有电机状态接口。
- SOLID：当前为嵌入式 C 局部风险收敛，不强行引入新抽象。

### 问题确认情况
- 用户已反馈 `v1.4.37-stalldiag` 烧录后衣柜不动。
- 尚未确认是否由长日志导致，本次为优先恢复运行的保守修正。

### 风险评估
- 不改变电机动作、PID、目标坐标、保护阈值和状态机顺序，风险低。
- 失速日志字段减少，但仍保留 `STEP` 用于关键判断。

### 验证方式
- 构建日志 `MDK-ARM/build_stalldiag_lite.log` 应显示 `0 Error(s), 0 Warning(s)`。
- 新 `axf` 应包含 `SmartWardrobe-STM32F407 v1.4.38-stalldiag-lite` 和 `MODE=%s DIR=%s STEP=%lu`。
- 烧录后发送 `SYS VER`，应返回 `OK VER SmartWardrobe-STM32F407 v1.4.38-stalldiag-lite`。
- 若仍不动，优先发送 `SYS VER`、`M1 STATUS`、`M3 STATUS`、`M4 STATUS` 和完整启动日志。
## 2026-07-10 11:56:31

### 修改类型
修复 / 上电回零一次性执行

### 涉及文件
- `Src/main.c`
- `APP/Src/cmd_dispatch.c`
- `MDK-ARM/SmartWardrobeCode/SmartWardrobeCode.build_log.htm`
- `MDK-ARM/SmartWardrobeCode/SmartWardrobeCode.axf`
- `MDK-ARM/SmartWardrobeCode/SmartWardrobeCode.hex`
- `MDK-ARM/SmartWardrobeCode/SmartWardrobeCode.map`
- `修改日志/修改日志.md`

### 修改内容
- 删除上电自动回零每 500 ms 重试一次的无限重试逻辑。
- 上电延时 2000 ms 后，在没有云端任务占用时只执行一次 `ALL HOME`；无论命令启动成功或失败都清除上电回零请求。
- 保留每 3000 ms 一次的二进制状态心跳，不改变阿里云状态上报需求。
- 固件版本更新为 `SmartWardrobe-STM32F407 v1.4.40-boot-home-once`。

### 修改原因
- 原实现只有 `CmdDispatch_Execute()` 返回成功时才清除 pending；启动失败时会永久保留 pending，并每 500 ms 再次触发回零，造成机械动作或调试消息持续重复。

### 问题修复类型
根本性修复

### 根因分析
- 注释定义的是“一次性上电回零”，实际状态机却实现成无最大次数、无总超时的无限重试，状态语义与实现不一致。
- 周期状态帧与上电回零是独立逻辑，本次不关闭状态心跳，避免再次造成阿里云看不到周期状态。

### 工程原则应用
- KISS：直接将上电回零请求改为一次性消费，不增加新的复杂重试状态机。
- YAGNI：不新增运行时重试配置，当前需求就是上电只回零一次。
- DRY：继续复用现有 `CmdDispatch_Execute()` 和 `ALL HOME` 实现。
- SOLID：当前为嵌入式 C 状态修复，不强行引入额外抽象。

### 问题确认情况
- 已通过 `Wardrobe_BootHome_Tick1ms()` 确认失败路径不会清除 pending，且重试周期固定为 500 ms。
- 用户回复“继续”，同意按根因方向修改。

### 风险评估
- 如果唯一一次上电回零因硬件故障或电机忙而失败，本次上电不会自动再次尝试；可通过阿里云 `cmd=18` 手动重新回零。
- 取衣、放衣、手动回零和 3 秒状态心跳逻辑不变。

### 验证方式
- `SmartWardrobeCode.build_log.htm` 应显示 `0 Error(s), 0 Warning(s)`；AXF 中应包含版本字符串 `SmartWardrobe-STM32F407 v1.4.40-boot-home-once`。
- 上电 2 秒后最多启动一次 `ALL HOME`，失败后不应再按 500 ms 周期重复启动。
- 串口仍应每 3 秒出现一帧 `A5 A0 06 ... CRC 5A` 状态数据。
## 2026-07-10 17:26:13

### 修改类型
修复 / 分阶段隔离验证

### 涉及文件
- `APP/Src/cmd_dispatch.c`
- `修改日志/修改日志.md`

### 修改内容
- 将 `M2_ABS_BOOT_HOME_ENABLE` 从 `1U` 调整为 `0U`，关闭 M2 绝对值编码器的上电自动回零。
- 保留 `WARDROBE_BOOT_HOME_ENABLE`，因此 M1/M3/M4 的上电 `ALL HOME` 仍会正常执行。

### 修改原因
- M2 上电绝对值回零在 `CmdDispatch_SafetyTick1ms()` 中调用阻塞式 RS485 读取；读取超时、重试和延时会阻塞主循环，并可能触发 1ms tick 补偿回放，造成 USART3 状态帧突发。

### 问题修复类型
- 分阶段修复 / 隔离验证。

### 根因分析
- `Rs485AbsEncoder_ReadM2()` 使用阻塞式 `HAL_UART_Receive()`，单次读取失败会重试；其不能位于 1ms 调度路径中。
- 本次先关闭与现象同步出现的 M2 上电回零路径，验证其是否为状态帧高频突发的触发条件。
- 根本性修复仍应将 RS485 读取改为非阻塞状态机，并使状态上报基于真实时间而非补跑 tick 次数。

### 工程原则应用
- KISS：只关闭单独的 M2 上电回零开关，保留其余回零功能。
- YAGNI：不在隔离验证阶段提前重构 RS485 协议栈。
- DRY：复用已有 M2 回零开关，不增加第二套测试逻辑。
- SOLID：当前为嵌入式调度问题的最小隔离改动，不强行引入复杂架构。

### 问题确认情况
- 用户已明确确认按“关闭 M2 上电回零做隔离验证”的方向修改。

### 风险评估
- 上电后 M2 不会自动回到绝对零点；M2 的手动绝对值回零和正常业务控制代码未删除。
- M1/M3/M4 上电回零不受影响。

### 验证方式
- 重新编译并烧录 STM32 固件。
- 上电后确认 M1/M3/M4 仍执行回零，M2 不自动转动。
- 观察 ESP32 UART：静默窗口结束后不应出现连续约 1ms 的 11 字节状态帧；正常周期上报仍按当前配置运行。
## 2026-07-11 10:58:17

### 修改类型
新增 / 根本性功能实现 / 激光衣位识别

### 涉及文件
- `APP/Inc/laser_range.h`
- `APP/Src/laser_range.c`
- `APP/Src/cmd_dispatch.c`
- `APP/Src/uart_console.c`
- `Inc/usart.h`
- `Inc/stm32f4xx_it.h`
- `Src/usart.c`
- `Src/stm32f4xx_it.c`
- `Src/main.c`
- `SmartWardrobeCode.ioc`
- `程序介绍.md`
- `MDK-ARM/SmartWardrobeCode.uvprojx`
- `../server_esp/components/esp_mqtt/mqtt.c`
- `修改日志/修改日志.md`

### 修改内容
- 新增 JH-AI-1811 主动上报驱动，USART1 使用 PA9/PA10、115200 8N1 和非阻塞 ReceiveToIdle 中断接收。
- 实现 8 字节帧的流式同步、拆包/粘包处理、累加和校验、50~4000mm 距离过滤、70% 置信度过滤和 150ms 在线判定。
- 取衣流程在 ALL HOME 后等待 10 帧有效数据，以约 20RPM 从 X 原点扫描，使用 3 点中值滤波和连续 3 帧确认识别三级距离下降。
- 完整通过第三级最外凸平台后记录进入/退出编码器位置，以平台中心加偏移作为 X 对齐目标，再继续原有 Z/Y/夹爪/M2 取衣流程。
- 取衣 `position=1..255` 直接表示第 N 块三级定位板；删除 `position=5` 映射到 1 号位的旧别名。存衣仍只允许已配置的 1 号固定点位。
- 增加激光掉线、扫描超时、轴限位和扫描失速退出；故障时急停相关电机并通过现有衣柜故障帧返回。
- 修正 UART 回调路由：USART1 转发激光模块，USART2 转发 RS485 编码器，USART3 保持 ESP32；删除 USART2 发送完成被误当作串口错误的旧逻辑。
- 同步更新 CubeMX USART1 引脚配置和 Keil 工程源文件列表。
- 同步更新完整命令说明、简易串口说明和程序介绍，删除取衣固定 `X=12700` 的旧描述。

### 修改原因
- 原取衣流程依赖固定 `X=12700` 坐标，只能支持一个预设衣位，不能根据三层定位板自动识别第 N 件衣服。
- JH-AI-1811 以约 50 帧/秒主动上报距离，适合在 X 轴低速运动时连续提取三级板深度轮廓。

### 问题修复类型
- 根本性功能实现。

### 根因分析
- 衣位信息原本来自静态坐标表，系统没有传感器数据入口、距离帧解析器、板型识别状态机和扫描后的编码器中心对齐环节。
- 本次把传感器采集、板型识别和现有取衣动作按职责分开，并通过非阻塞状态机连接，避免在 1ms 调度中加入阻塞串口操作。

### 工程原则应用
- KISS：保留原有取衣后半段动作，只替换固定 X 定位阶段。
- YAGNI：激光当前仅用于取衣，不改放衣流程，不增加未确认的自动标定协议。
- DRY：复用现有编码器绝对目标运动、ALL HOME、限位、失速和衣柜事件上报接口。
- SOLID：激光协议解析独立为 `laser_range` 模块，机械扫描状态保留在取衣业务层，避免驱动直接控制电机。

### 问题确认情况
- 用户已确认模块为 JH-AI-1811、主动上报模式、V 引脚供电为 3.3V，并明确要求实施该方案。

### 风险评估
- 三级板相邻层实际距离差、最外层宽度和激光器到取衣机构的 X 偏移仍需现场标定；默认层间阈值为 12mm、偏移为 0。
- 存衣仍使用固定 1 号位，取衣位置扩展不会自动扩展存衣坐标。
- CubeMX 工程原有 USART2/UART4 为手工维护配置，重新生成代码前仍需确认不会覆盖这些现有串口实现。

### 验证方式
- 已使用 MinGW GCC 对本次涉及的 STM32 C 文件执行 `-fsyntax-only`，检查通过。
- 本机未发现 Keil `UV4.exe` 或 `armclang.exe`，未能完成 ARM Compiler V6.24 链接和 HEX 生成。
- 实机应依次验证静止接收、1/2/N 号板扫描、激光拔线、X 限位、扫描超时和连续 10 次取衣。

## 2026-07-11 16:16:51

### 修改类型
新增 / 根本性功能修复 / USART3运行时调试模式

### 涉及文件
- `APP/Inc/cmd_parser.h`
- `APP/Src/cmd_parser.c`
- `APP/Inc/uart_console.h`
- `APP/Src/uart_console.c`
- `APP/Src/cmd_dispatch.c`
- `Src/main.c`
- `MDK-ARM/SmartWardrobeCode/SmartWardrobeCode.build_log.htm`
- `MDK-ARM/SmartWardrobeCode/SmartWardrobeCode.axf`
- `MDK-ARM/SmartWardrobeCode/SmartWardrobeCode.hex`
- `修改日志/修改日志.md`

### 修改内容
- 新增 `DEBUG ON`、`DEBUG OFF` 和 `DEBUG STATUS` 三条 USART3 ASCII 命令。
- 新增 `BINARY/TO_DEBUG/DEBUG/TO_BINARY` 运行时状态机；调试模式与 ESP32 二进制协议互斥。
- `DEBUG ON` 停止产生新的二进制帧，等待已有发送完成后开启文本回显；调试期间丢弃 ESP32 二进制输入，避免退出后补执行历史命令。
- `DEBUG OFF` 先把完整确认行放入发送队列，再关闭新文本入队；队列清空后恢复 ESP32 二进制收发，并从当前时间重新计算 3 秒状态心跳。
- 云端取放衣任务正在执行时拒绝进入调试模式，单次返回 `ERR DEBUG BUSY CLOUD_TASK`；切换期间暂缓消费云端完成事件，避免丢失成功或故障回包。
- 新增 `UartConsole_IsTxIdle()`，以发送中断和队列真实状态作为模式切换条件，不使用固定延时。
- 激光扫描调试日志改为运行时开关，输出原始距离、滤波距离、置信度、识别层级、衣位计数和 X 编码器位置；限制为每 50ms 最多一条。
- HELP 文本加入 `DEBUG ON/OFF/STATUS`。

### 修改原因
- 原代码没有 `DEBUG ON` 命令，并且文本输出被固定关闭，导致合法的 ASCII 调试命令虽然能够执行，但启动响应、扫描过程和故障原因全部不可见。
- USART3 同时承载 ESP32 二进制协议和调试文本，直接同时输出会污染 ESP32 帧解析，因此需要运行时互斥切换。

### 问题修复类型
根本性修复

### 根因分析
- 调试能力原本由编译期宏控制，没有运行时协议入口；文本队列关闭时会直接丢弃消息并返回成功，调用方无法发现反馈没有真正发送。
- 二进制成功帧、故障帧和心跳均通过同一 USART3 队列发送，若只打开文本开关而不门控二进制路径，必然出现文本与二进制混流。
- 本次在统一二进制发送入口和主循环接收入口增加模式门控，并以发送队列空闲状态完成切换，从协议边界解决冲突。

### 工程原则应用
- KISS：复用现有命令解析器、文本队列和统一二进制发送入口，没有新增独立通信模块。
- YAGNI：仅实现当前需要的运行时调试切换和激光扫描日志，不增加 Flash 持久化或新的串口协议。
- DRY：普通命令响应统一复用 `Wardrobe_QueueTextResponse()`，二进制门控统一放在 `Wardrobe_SendFrame()`。
- SOLID：模式切换留在主循环业务层，串口模块只提供文本开关和发送空闲查询，保持职责边界清晰。

### 问题确认情况
- 已确认 `DEBUG ON` 不存在、USART3文本输出固定关闭、直接串口取衣的文本响应被静默丢弃。
- 用户明确选择调试与 ESP32 二进制协议互斥，并要求按该方案实施。

### 风险评估
- 调试模式下 ESP32 二进制命令会被主动丢弃，必须先执行 `DEBUG OFF` 才能恢复云端控制。
- `DEBUG ON` 只能通过 USART3 的 PB10/PB11、115200 8N1 使用；USART1仍专用于激光测距。
- 不改变电机、限位、M2 RS485、激光识别阈值和取放衣机械参数，无其他明显风险。

### 验证方式
- 已使用 Keil ARM Compiler V6.24 全量构建，结果为 `0 Error(s), 0 Warning(s)`。
- 已生成新的 `SmartWardrobeCode.axf` 和 `SmartWardrobeCode.hex`。
- 实机依次发送 `DEBUG ON`、`AXIS TAKE_CLOTH SLOT=1`、`DEBUG STATUS`、`DEBUG OFF`，确认文本日志、激光数据、衣位识别和二进制恢复顺序正确。

## 2026-07-11 17:16:50

### 修改类型
修复 / 根本性修复 / JH-AI-1811 询问模式 Modbus 通信

### 涉及文件
- `APP/Inc/laser_range.h`
- `APP/Src/laser_range.c`
- `APP/Inc/cmd_parser.h`
- `APP/Src/cmd_parser.c`
- `APP/Src/uart_console.c`
- `APP/Src/cmd_dispatch.c`
- `Src/usart.c`
- `Src/stm32f4xx_it.c`
- `SmartWardrobeCode.ioc`
- `程序介绍.md`
- `MDK-ARM/SmartWardrobeCode/SmartWardrobeCode.build_log.htm`
- `MDK-ARM/SmartWardrobeCode/SmartWardrobeCode.axf`
- `MDK-ARM/SmartWardrobeCode/SmartWardrobeCode.hex`
- `修改日志/修改日志.md`

### 修改内容
- USART1 从 `115200 8N1` 主动上报配置改为 JH-AI-1811 询问模式要求的 `9600 8N1`，并同步 CubeMX 配置与中断说明。
- 激光驱动改为非阻塞 Modbus RTU 状态机，每 50ms 通过 `HAL_UART_Transmit_IT()` 发送 `01 03 00 03 00 02 34 0B`，读取保持寄存器 3 的距离和寄存器 4 的可信度。
- USART1 发送完成回调负责进入等待响应状态，ReceiveToIdle 中断负责接收响应，主循环负责解析、100ms 超时和错误恢复，不使用阻塞接收或 `HAL_Delay()`。
- 完整校验地址、功能码、字节数和 Modbus CRC16；支持 9 字节正常响应与 5 字节异常响应。CRC 错误、异常响应、UART 错误、发送失败和超时均只结束当前询问，下一周期自动恢复。
- 保留现有激光样本接口和三级定位板识别流程，只将数据来源由主动上报帧替换为 Modbus 查询结果；继续过滤 `50~4000mm` 和可信度不低于 70% 的数据。
- 新增 `LASER STATUS` 调试命令，输出状态机、请求数、响应数、超时、CRC错误、协议错误、异常响应、丢弃数据、UART错误、发送错误、在线状态和最新测量值。
- USART1、USART2、USART3 的接收、发送完成和错误回调继续按串口实例独立路由，M2 RS485 与 ESP32 通信路径不变。

### 修改原因
- 实物 JH-AI-1811 工作在询问模式，固定使用 `9600 8N1` 和 Modbus RTU；旧驱动按 `115200` 等待 `AA 05` 主动上报帧，STM32没有发送查询命令，因此永远收不到有效激光数据，取衣流程必然报 `TAKE_CLOTH_LASER_NOT_READY`。

### 问题修复类型
- 根本性修复。

### 根因分析
- 故障最早发生在传感器通信协议层：串口参数、通信发起方和响应帧格式均与实物模块不一致。
- 取衣状态机和三级板识别依赖 `LaserRange_PollSample()`，上游驱动没有生成样本时，扫描流程只能在等待阶段超时；单纯延长等待时间无法解决问题。
- 本次按模块询问模式协议重写数据采集层，同时保持上层接口不变，从协议源头恢复有效样本，并避免把 Modbus 细节扩散到机械控制代码。

### 工程原则应用
- KISS：采用单一的 `IDLE -> TX_REQUEST -> WAIT_RESPONSE` 状态机，没有保留主动上报与询问模式两套并行解析器。
- YAGNI：只读取当前需要的距离和可信度寄存器，不增加地址修改、参数写入或自动配置功能。
- DRY：继续复用现有样本队列、在线判断和取衣扫描接口，避免在业务层重复实现串口协议解析。
- SOLID：`laser_range` 负责 Modbus 通信与样本生成，取衣状态机负责定位板识别和机械动作，职责边界保持清晰。

### 问题确认情况
- 用户明确确认实物模块为 JH-AI-1811 询问模式，并提供《询问模式 Modbus 协议》资料；协议确认默认地址为 1、通信参数为 `9600 8N1`、寄存器 3/4 分别为距离与可信度。
- 用户已明确要求按非阻塞 Modbus 轮询方案实施。

### 风险评估
- 模块地址必须保持出厂默认值 1；若现场地址已修改，请求会持续超时。
- 模块响应的可信度单位必须与资料一致并落在 `0~100`；低于 70 的数据会被统计为 `REJECT`，不会进入扫描样本队列。
- 不改变三级板阈值、扫描速度、电机参数、M2 RS485 或 ESP32 协议，无其他明显风险。

### 验证方式
- 已使用 Keil ARM Compiler V6.24 全量构建，结果为 `0 Error(s), 0 Warning(s)`，并生成新的 AXF 和 HEX。
- 调试模式发送 `LASER STATUS`，确认 `REQ` 持续增加；模块正常连接时 `RESP`、`DIST`、`CONF` 持续更新且 `ONLINE=1`。
- 执行 `AXIS TAKE_CLOTH SLOT=1`，确认收满有效样本后 X 轴开始扫描，不再出现 `TAKE_CLOTH_LASER_NOT_READY`。
- 拔掉模块后确认 `TIMEOUT` 增加，取衣流程安全退出，主循环、M2 RS485 和 ESP32 通信不被阻塞。

## 2026-07-13 11:06:11

### 修改类型
修复 / 分阶段根因修复 / 激光原始数据诊断与取衣校准准备

### 涉及文件
- `APP/Inc/laser_range.h`
- `APP/Src/laser_range.c`
- `APP/Src/cmd_dispatch.c`
- `程序介绍.md`
- `MDK-ARM/SmartWardrobeCode/SmartWardrobeCode.build_log.htm`
- `MDK-ARM/SmartWardrobeCode/SmartWardrobeCode.axf`
- `MDK-ARM/SmartWardrobeCode/SmartWardrobeCode.hex`
- `修改日志/修改日志.md`

### 修改内容
- 为 `LaserRangeStatus_t` 增加原始距离、原始可信度、最近合法响应时间、通信在线、当前数据有效、距离拒绝次数和可信度拒绝次数。
- 每次收到 CRC 正确的正常 Modbus 响应后，先保存寄存器 3/4 原始值，再分别检查距离和可信度；总拒绝次数仍按响应帧计数，分类拒绝次数按字段分别计数。
- 将通信在线与有效测量分离：`COMM_ONLINE` 表示 150ms 内收到合法 Modbus 响应，`DATA_VALID` 表示最近一次正常响应通过数据过滤，原有 `ONLINE` 和 `LaserRange_IsOnline()` 继续表示存在近期有效样本。
- 扩展 `LASER STATUS`，增加 `DIST_REJECT`、`CONF_REJECT`、`COMM_ONLINE`、`DATA_VALID`、`RAW_DIST` 和 `RAW_CONF`。
- 取衣等待激光就绪超时后，如果模块没有合法响应则返回 `TAKE_CLOTH_LASER_OFFLINE`；如果模块在线但测量值未通过过滤，则返回 `TAKE_CLOTH_LASER_DATA_REJECT`，并附带最近一次原始距离和可信度。
- 保持放衣1号位固定坐标 `X=13000、Y=3100、Z=2450`，放衣流程仍不依赖激光。

### 修改原因
- 现场日志显示 `RESP=358`、`CRC_ERR=0`、`REJECT=358`，证明激光模块和 Modbus 通信已经工作，但全部测量响应被数据过滤。
- 原状态只显示通过过滤后的 `DIST/CONF`，因此 `ONLINE=0 DIST=0 CONF=0` 无法区分距离超范围和可信度不足，也容易被误判成模块没有启动。

### 问题修复类型
- 分阶段根因修复。本阶段建立可验证的原始数据诊断能力，不直接调整现场尚未测定的过滤阈值。

### 根因分析
- 取衣状态机在开始 X 轴扫描前要求连续取得 10 帧有效样本；驱动只把距离 50~4000mm 且可信度不低于 70 的响应放入样本队列。
- 现场所有正常响应均被过滤，样本队列始终为空，3 秒后必然进入 `TAKE_CLOTH_LASER_NOT_READY` 旧故障路径。
- 放衣状态机直接读取固定衣位坐标表，没有调用激光样本接口，因此激光数据无效不会阻止放衣动作。

### 工程原则应用
- KISS：只扩展现有状态结构和命令输出，不新增第二套诊断协议。
- YAGNI：不增加模块参数写入或自动阈值修改，先收集当前故障所需的最小原始数据。
- DRY：原始值和分类计数统一在 Modbus 正常响应入口维护，取衣与状态命令读取同一份状态快照。
- SOLID：通信质量判断保留在 `laser_range`，取衣状态机只根据公开状态区分故障原因，职责边界不变。

### 问题确认情况
- 已通过现场日志确认 Modbus 请求和正常响应持续增加，CRC 无错误，同时每个正常响应都被数据过滤。
- 用户明确选择保留取衣激光自动识别、放衣固定坐标，并确认先增加诊断字段再根据实测原始值校准。

### 风险评估
- 本次不放宽距离或可信度阈值，无效测量仍不会驱动 X 轴扫描，机械安全条件不变。
- `LASER STATUS` 文本长度增加，但仍小于 USART3 单条发送队列上限 768 字节。
- 云端取衣故障事件和故障位保持原值，仅调试文本原因更具体；M2 RS485、ESP32二进制协议和放衣流程不变。

### 验证方式
- 调试模式连续发送 `LASER STATUS`，确认即使 `DATA_VALID=0`，仍可看到持续更新的 `RAW_DIST/RAW_CONF` 和分类拒绝计数。
- 模块正常响应但数据不合格时，取衣返回 `TAKE_CLOTH_LASER_DATA_REJECT`；拔掉模块后返回 `TAKE_CLOTH_LASER_OFFLINE`。
- 放衣1号位继续按固定坐标完整运行，不读取激光状态。
- 已使用 Keil ARM Compiler V6.24 全量重建，结果为 `0 Error(s), 0 Warning(s)`，并已生成新的 AXF 和 HEX。

## 2026-07-13 11:39:49

### 修改类型
修复 / 根本性修复 / X轴移动扫描三级定位板

### 涉及文件
- `APP/Inc/laser_range.h`
- `APP/Src/laser_range.c`
- `APP/Src/cmd_dispatch.c`
- `程序介绍.md`
- `MDK-ARM/SmartWardrobeCode/SmartWardrobeCode.build_log.htm`
- `MDK-ARM/SmartWardrobeCode/SmartWardrobeCode.axf`
- `MDK-ARM/SmartWardrobeCode/SmartWardrobeCode.hex`
- `修改日志/修改日志.md`

### 修改内容
- 激光正常响应样本增加 `distance_valid` 标志；距离为0或超范围的响应也进入样本队列，用于通知取衣状态机当前处于无板背景，但不会成为有效测距。
- 可信度寄存器继续记录到 `RAW_CONF/CONF_REJECT`，不再阻止距离样本进入识别；`DATA_VALID` 仅表示距离处于 50~4000mm，总 `REJECT` 只统计距离无效响应。
- 新增 `LaserRange_IsCommunicationOnline(timeout_ms)`，取衣流程使用合法 Modbus 响应判断模块在线，扫描离线窗口调整为300ms。
- 取衣回零完成后不再等待10帧有效距离或建立静态背景基线；只要 Modbus 在线就立即让X轴以约20RPM扫描。
- 三级板识别改为3帧稳定窗口：峰峰值不超过8mm时使用中值确认平台；连续不稳定或无效距离作为无板背景。
- 无板背景确认后，第一个稳定平台记为第一级；后续平台每次至少变近12mm时依次记为第二、第三级。进入第三级记录 `x_enter`，离开第三级记录 `x_exit`，以中心加X偏移得到衣位位置。
- 两帧过渡波动不会清除层级，连续3帧背景才重置或完成板件；第三级后继续出现新的稳定下降平台时作废当前结构并等待背景重新识别。
- 一个完整三级结构只计数一次；未达到目标衣位时，必须重新确认无板背景后才能识别下一块板。
- 激光调试日志增加 `VALID/WIN/FILT/SPREAD/STATE/LEVEL/SLOT/X`，并在处理当前样本后输出最新识别状态。
- 放衣1号位继续使用固定坐标 `X=13000、Y=3100、Z=2450`，不接入激光扫描。

### 修改原因
- 现场状态为 `RESP=578`、`CONF_REJECT=578`、`RAW_CONF=0`，证明模块持续正常响应，但可信度寄存器在当前实物上恒为0，不能作为取衣有效性门槛。
- 现场确认激光检测的是随X轴移动经过的定位板；无板位置本来就会返回0或大且变化明显的距离，因此X轴静止时等待稳定有效距离与真实检测方式冲突。

### 问题修复类型
- 根本性修复。

### 根因分析
- 旧驱动把可信度不低于70作为硬条件，导致所有实物响应被拒绝，取衣永远无法进入扫描阶段。
- 旧状态机把扫描前静止位置当作稳定背景，再检测三级下降；实际无板背景不稳定，只有X轴移动到板面后才出现稳定距离平台。
- 本次把通信在线、距离有效、无板背景和稳定板面拆成独立语义，从数据入口和扫描状态机同时修正错误假设。

### 工程原则应用
- KISS：继续复用现有样本队列和3点窗口，只增加距离有效标志与明确的背景/层级状态。
- YAGNI：不写模块寄存器、不引入自动阈值学习，只实现现场已确认的三级定位板识别。
- DRY：通信在线统一由 `LaserRange_IsCommunicationOnline()` 判断，等待阶段和扫描阶段不再各自推断。
- SOLID：激光驱动负责协议与样本语义，取衣状态机负责机械扫描和板型识别，职责保持分离。

### 问题确认情况
- 已通过现场日志确认通信正常、可信度恒0、部分无板距离为0，其余无板距离大且波动明显。
- 用户明确说明定位板必须由X轴移动扫描发现，并确认按稳定平台和三级递减方案修改。

### 风险评估
- 稳定容差8mm和层级差12mm仍需通过实物扫描日志验证；参数不匹配时会漏检，但不会绕过限位、失速、通信离线或扫描超时保护。
- 无板背景必须至少产生连续3次无效或不稳定判断后才会武装下一块板，防止同一结构重复计数。
- M2 RS485、ESP32二进制协议、Y/Z动作、夹爪动作和放衣流程不变。

### 验证方式
- `RAW_CONF=0` 且 Modbus 在线时执行 `AXIS TAKE_CLOTH SLOT=1`，确认X轴立即进入 `LASER_SCAN START`。
- 无板区域日志应显示 `WIN=BACKGROUND` 和 `STATE=ARMED/SEARCH_BG`，不得误增 `LEVEL`。
- 依次经过三个稳定且每级至少降低12mm的平台，日志应显示 `LEVEL1 -> LEVEL2 -> LEVEL3`，离开第三级后输出目标X并停止扫描。
- `SLOT=2` 应跳过第一块完整定位板，在第二块板中心停止；拔掉模块后300ms内急停并报告离线。
- 使用 Keil ARM Compiler V6.24 全量重建，要求 `0 Error(s), 0 Warning(s)` 并生成新的 AXF 和 HEX。

## 2026-07-13 20:37:49

### 修改类型
修改 / 取衣激光扫描速度调整

### 涉及文件
- `APP/Src/cmd_dispatch.c`
- `APP/COMMANDS.md`
- `APP/SERIAL_COMMANDS_EASY.md`
- `程序介绍.md`
- `MDK-ARM/SmartWardrobeCode/SmartWardrobeCode.build_log.htm`
- `MDK-ARM/SmartWardrobeCode/SmartWardrobeCode.axf`
- `MDK-ARM/SmartWardrobeCode/SmartWardrobeCode.hex`
- `修改日志/修改日志.md`

### 修改内容
- 将 `TAKE_LASER_SCAN_RPM` 从 `20.0f` 调整为 `45.0f`。
- 同步更新完整命令说明、简易串口说明和程序介绍中的取衣扫描速度。

### 修改原因
- 用户要求提高X轴寻找三级定位板时的扫描速度，缩短取衣定位等待时间。

### 问题修复类型
- 不适用，属于机械运行参数调整。

### 根因分析
- 本次不涉及故障根因；扫描速度由单一内部常量控制，调整该常量即可统一作用于取衣激光扫描阶段。

### 工程原则应用
- KISS：只修改统一扫描速度常量，不在状态机各分支重复设置速度。
- YAGNI：不增加运行时调速命令或Flash配置。
- DRY：说明文档统一同步为45RPM，避免参数描述不一致。
- SOLID：不涉及架构调整，不强行引入额外抽象。

### 问题确认情况
- 用户明确要求将X轴激光扫描速度从约20RPM改为45RPM。

### 风险评估
- 45RPM下每50ms采样一次，单个平台能够获得的样本数会少于20RPM；三级板较窄时可能无法满足连续3帧稳定确认，需要实机验证是否漏检。
- 仅影响取衣激光扫描阶段；放衣、回零、普通X轴运动和其他电机参数不变。

### 验证方式
- 执行 `AXIS TAKE_CLOTH SLOT=1`，确认X轴扫描速度为45RPM。
- 观察调试日志能否稳定出现 `LEVEL1 -> LEVEL2 -> LEVEL3`，并确认没有因速度提高导致漏检。
- 使用 Keil ARM Compiler V6.24 全量重建，要求 `0 Error(s), 0 Warning(s)` 并生成新的 AXF 和 HEX。

## 2026-07-13 21:15:23

### 修改类型
修复 / 根本性修复 / 激光可信度移入板面识别层

### 涉及文件
- `APP/Src/cmd_dispatch.c`
- `APP/COMMANDS.md`
- `APP/SERIAL_COMMANDS_EASY.md`
- `程序介绍.md`
- `MDK-ARM/SmartWardrobeCode/SmartWardrobeCode.build_log.htm`
- `MDK-ARM/SmartWardrobeCode/SmartWardrobeCode.axf`
- `MDK-ARM/SmartWardrobeCode/SmartWardrobeCode.hex`
- `修改日志/修改日志.md`

### 修改内容
- 增加板面可信度阈值 `TAKE_LASER_PLATE_CONFIDENCE_MIN=70`。
- 只有距离有效且 `CONF>=70` 的样本才进入三级定位板的3帧稳定窗口。
- 距离无效或 `CONF<70` 的样本会清空当前稳定窗口并按无板背景处理，不会累计板面层级，也不会影响X轴继续扫描。
- 调试日志将原 `VALID` 拆分为 `DIST_VALID` 和 `PLATE_VALID`，分别表示距离范围有效和板面样本有效。
- 保持Modbus通信在线判断、45RPM扫描、50ms轮询、300ms离线保护和 `DATA_VALID` 接口语义不变。

### 修改原因
- 现场数据证明远处无板背景可能返回 `1333mm`、`2280mm` 等范围内距离，但对应 `CONF=0`；旧识别逻辑只检查距离范围，背景连续稳定时可能被误判为定位板平台。

### 问题修复类型
- 根本性修复。

### 根因分析
- 旧代码正确地把可信度从通信启动条件中移除，但同时也从板面识别条件中移除，导致“通信在线”和“检测到可靠板面”再次混为同一判定。
- 本次在业务识别层恢复可信度门槛，同时保持通信层只依据合法Modbus响应，分别解决无法启动扫描和背景误识别两个相反问题。

### 工程原则应用
- KISS：只在现有样本识别入口增加单一可信度条件，不改动稳定窗口和三级板状态机。
- YAGNI：不增加自动阈值学习或Flash参数，使用现场已确认的70作为板面阈值。
- DRY：板面有效性统一在 `take_laser_window_push()` 入口判断，避免各层级分支重复检查。
- SOLID：激光驱动继续负责Modbus通信和原始样本，取衣状态机负责板面可信度和机械识别，职责边界不变。

### 问题确认情况
- 用户提供的实测数据确认合法Modbus响应持续增加；无板背景为 `CONF=0`，近距离可靠目标为 `CONF=100`，并明确确认按可信度移入板面识别层的方案修改。

### 风险评估
- 实际粉色定位板若 `CONF<70` 会被视为背景，需要根据现场板面实测值调整阈值，但不能取消可信度过滤。
- 45RPM和50ms采样周期下，每层板面需要保持至少约150ms有效照射时间，板面过窄时仍可能漏检。
- 不影响USART1轮询、M2 RS485、ESP32二进制协议、放衣流程和其他电机控制。

### 验证方式
- 无板背景 `CONF=0` 时确认 `COMM_ONLINE=1`、X轴正常扫描且 `LEVEL` 不增加。
- 板面 `CONF>=70` 时确认日志出现 `PLATE_VALID=1`，并能依次进入 `LEVEL1 -> LEVEL2 -> LEVEL3`。
- 分别执行 `AXIS TAKE_CLOTH SLOT=1` 和 `SLOT=2`，确认定位对应完整三级结构。
- 拔掉激光模块后确认300ms内停止扫描并报告 `TAKE_CLOTH_LASER_OFFLINE`。
- 已使用 Keil ARM Compiler V6.24 全量重建，结果为 `0 Error(s), 0 Warning(s)`，并已生成新的 AXF 和 HEX。

## 2026-07-14 17:04:12

### 修改类型
修复 / 根本性修复 / 激光开放与挡板双背景识别

### 涉及文件
- `APP/Src/cmd_dispatch.c`
- `APP/COMMANDS.md`
- `APP/SERIAL_COMMANDS_EASY.md`
- `程序介绍.md`
- `MDK-ARM/build_laser_bg_dual.log`
- `MDK-ARM/SmartWardrobeCode/SmartWardrobeCode.build_log.htm`
- `MDK-ARM/SmartWardrobeCode/SmartWardrobeCode.axf`
- `MDK-ARM/SmartWardrobeCode/SmartWardrobeCode.hex`
- `修改日志/修改日志.md`

### 修改内容
- 将固件版本号更新为 `SmartWardrobe-STM32F407 v1.5.1-laser-bg-dual`。
- 将取衣激光扫描速度从45RPM降回20RPM，增加每级定位板获得连续3帧稳定样本的时间。
- 为取衣激光扫描增加 `NONE/OPEN/BASE` 背景模式、挡板基准距离、5窗口基准确认和背景分类状态。
- 距离无效、`CONF<70` 或连续不稳定窗口继续作为开放背景，连续3次后允许识别下一块三级板。
- 前方存在稳定高可信度挡板时，先用5个稳定窗口建立背景基准；只有比基准至少靠近12mm的稳定目标才进入三级板识别。
- 挡板基准只在已确认背景且不处于定位板层级时按四分之一新样本权重缓慢更新，避免板面数据污染基准。
- 完成一块定位板后继续要求重新确认开放背景或挡板背景，防止同一结构重复计数。
- 激光调试日志增加 `CLASS`、`BG_MODE`、`BG_VALID` 和 `BG_MM`，保留原始距离、可信度、稳定窗口、层级、衣位和X编码器位置。
- 同步修正文档中的扫描速度、背景语义和已过期的“等待10帧有效距离”说明。

### 修改原因
- 测试阶段衣柜前方完全开放，激光会测到人员、墙面和其他随机目标，距离可能在有效范围内乱跳，单纯依赖低可信度背景无法稳定覆盖现场环境。
- 最终安装前挡板后，稳定高可信度挡板又可能被旧逻辑当作第一级定位板，因此需要统一支持开放背景和稳定挡板背景。

### 问题修复类型
- 根本性修复。将背景判定从“仅低可信度/无效距离”扩展为开放背景与可学习挡板基准两种明确语义，不通过放宽离线保护或取消可信度门槛掩盖问题。

### 根因分析
- 原状态机把所有稳定且 `CONF>=70` 的距离窗口都交给三级板识别，无法区分稳定挡板和定位板第一级。
- 开放环境的随机回波可能偶尔形成有效高可信度距离，45RPM又减少了每个平台的采样数，导致背景抖动和板面漏检风险同时存在。
- 通信状态数据已证明Modbus请求和响应能够连续一一对应，本次不修改激光通信层与300ms离线保护。

### 工程原则应用
- KISS：在现有扫描状态机内增加背景分类和基准字段，不改动Modbus驱动或后半段机械流程。
- YAGNI：不增加Flash参数、自动调参协议或新的外部命令，只实现已确认需要的双背景兼容。
- DRY：开放背景、挡板背景和三级板最终复用同一套背景确认、层级识别与衣位计数函数。
- SOLID：`laser_range`继续负责Modbus与原始样本，`cmd_dispatch`负责现场背景语义和机械定位识别。

### 问题确认情况
- 用户提供现场图片并确认测试衣柜前方没有挡板，开放区域会造成测距乱跳。
- 用户明确确认采用“三级阶梯板、开放与挡板兼容、先降回20RPM”的推荐方案并授权修改。

### 风险评估
- X原点到第一块定位板前必须保留足够背景区，用于取得3次开放背景或5个稳定挡板窗口。
- 启动时若有人员或物体连续遮挡并形成5个稳定高可信度窗口，可能被学习为临时基准；实机测试时应保持扫描通道清空。
- 20RPM会增加定位扫描时间，但不影响放衣、普通X轴运动、Y/Z、M2、夹爪、ESP32协议和激光离线保护。

### 验证方式
- 已使用 Keil ARM Compiler V6.24 对 `SmartWardrobeCode.uvprojx` 执行全量重建，`laser_range.c`、`cmd_dispatch.c`及全部工程文件均重新编译。
- 构建结果为 `0 Error(s), 0 Warning(s)`，程序大小为 `Code=83672, RO-data=11268, RW-data=116, ZI-data=25100`，已生成新的AXF和HEX。
- 烧录后执行 `SYS VER`，应返回 `SmartWardrobe-STM32F407 v1.5.1-laser-bg-dual`。
- 开放背景应显示 `CLASS=OPEN_BG BG_MODE=OPEN`；稳定挡板应在5个稳定窗口后显示 `CLASS=BASE_BG BG_MODE=BASE BG_VALID=1`。
- 三级定位板应依次显示 `LEVEL1 -> LEVEL2 -> LEVEL3`，离开第三级后输出 `OK TAKE_CLOTH LASER_SLOT`。
- 仍需现场完成 `SLOT=1`、`SLOT=2`、随机遮挡、拔线300ms保护和连续10次取衣验证。

## 2026-07-14 21:26:54

### 修改类型
修改 / 激光调试命令可读性优化

### 涉及文件
- `APP/Inc/cmd_parser.h`
- `APP/Src/cmd_parser.c`
- `APP/Src/cmd_dispatch.c`
- `APP/COMMANDS.md`
- `APP/SERIAL_COMMANDS_EASY.md`
- `程序介绍.md`
- `MDK-ARM/build_laser_status_short.log`
- `MDK-ARM/SmartWardrobeCode/SmartWardrobeCode.build_log.htm`
- `MDK-ARM/SmartWardrobeCode/SmartWardrobeCode.axf`
- `MDK-ARM/SmartWardrobeCode/SmartWardrobeCode.hex`
- `修改日志/修改日志.md`

### 修改内容
- 将固件版本号更新为 `SmartWardrobe-STM32F407 v1.5.2-laser-status-short`。
- 将 `LASER STATUS` 改为短输出：`DIST/CONF/COMM/VALID/PLATE/STATE`。
- `DIST/CONF`直接显示最近一次Modbus响应的原始距离和可信度，不再同时输出容易混淆的原始值与历史有效值。
- `PLATE=1`仅在通信在线、距离有效且 `CONF>=70` 时成立，与取衣三级板入口条件保持一致。
- 新增 `LASER DIAG` 命令，原完整请求、响应、超时、CRC、协议、拒绝和UART错误计数全部保留在该命令中。
- 解析器仅接受 `LASER STATUS` 与 `LASER DIAG` 两种双词命令，保持原有大小写不敏感行为，多余或未知参数继续返回参数错误。
- 同步更新帮助文本和三份调试说明文档。

### 修改原因
- 原 `LASER STATUS` 单行字段过多，不便于现场快速观察距离、可信度和定位板有效性。
- 原输出同时存在 `RAW_DIST/RAW_CONF` 与 `DIST/CONF` 两组值，容易把缓存的历史有效样本误认为当前原始响应。

### 问题修复类型
- 不适用。属于调试接口可读性优化，不改变激光采集、三级板识别或通信保护逻辑。

### 根因分析
- 日常对光只需要距离、可信度、通信、有效性和板面判定；累计通信计数属于低频深度诊断信息，二者混在同一命令中造成信息过载。
- 将短状态与完整诊断拆分后，两种用途的字段语义更加明确，同时不牺牲原有排障能力。

### 工程原则应用
- KISS：短状态只保留6个现场必要字段。
- YAGNI：不增加运行时配置或新的通信协议，仅增加一个文本诊断动作。
- DRY：短状态和完整诊断都读取同一份 `LaserRangeStatus_t` 快照。
- SOLID：解析器只负责识别 `STATUS/DIAG`，分发层负责各自格式化输出。

### 问题确认情况
- 用户明确提出 `LASER STATUS` 输出过长、不便于观察距离和可信度，并确认按短状态加完整诊断命令的方案实施。

### 风险评估
- 若有外部脚本解析旧版 `LASER STATUS` 长文本，需要改用 `LASER DIAG`；当前工程内未发现此类调用方。
- `COMM=0`或`VALID=0`时，短状态中的 `DIST/CONF`只是最后缓存的原始值，不能用于当前位置判断。
- 不影响ESP32二进制协议、Modbus轮询、取放衣流程和电机控制。

### 验证方式
- 已使用Keil ARM Compiler V6.24全量重建，结果为 `0 Error(s), 0 Warning(s)`。
- 程序大小为 `Code=83840, RO-data=11364, RW-data=116, ZI-data=25100`，已生成新的AXF和HEX。
- 已确认AXF包含版本号、`LASER STATUS`短格式和`LASER DIAG`完整格式字符串。
- 烧录后执行 `LASER STATUS`，背景应显示 `PLATE=0`，可靠板面应显示 `PLATE=1`。
- 执行 `LASER DIAG`应返回原完整累计字段；执行未知子命令或多余参数应返回参数错误。

## 2026-07-15 10:35:47

### 修改类型
修复 / 根本性修复 / 取衣激光识别门控与中心回对

### 涉及文件
- `APP/Src/cmd_dispatch.c`
- `APP/COMMANDS.md`
- `APP/SERIAL_COMMANDS_EASY.md`
- `程序介绍.md`
- `MDK-ARM/SmartWardrobeCode/SmartWardrobeCode.build_log.htm`
- `MDK-ARM/SmartWardrobeCode/SmartWardrobeCode.axf`
- `MDK-ARM/SmartWardrobeCode/SmartWardrobeCode.hex`
- `修改日志/修改日志.md`

### 修改内容
- 固件版本更新为 `SmartWardrobe-STM32F407 v1.5.3-laser-gated-align`。
- 新增取衣识别门槛 `EC1>=12200`；门槛前保持激光 Modbus 轮询，但持续丢弃样本，不允许竖梁进入滤波、背景学习或三级板识别。
- 首次越过门槛时清空样本和识别窗口，直接武装开放背景，并从该位置重新计算 30 秒识别超时。
- 新增最内层平台 `380~450mm` 约束，在进入、保持和完成定位板计数时均进行校验。
- 保留三级至少靠近 12mm、3 帧稳定窗口、完整离开后急停并按进入/退出位置回对中心的原有流程。
- 更新取衣和激光状态说明，明确 `PLATE=1` 只是单帧候选，手动 M1 不会自动停车或启动取衣。

### 修改原因
- 现场竖梁与定位板最内层距离均约为 415mm，单纯依赖距离和可信度无法区分；原识别从 X 原点开始，竖梁会污染稳定窗口或背景基准。
- 从原点开始计算 30 秒扫描超时，到达 EC1=12200 已消耗大部分时间，留给实际定位板识别的时间不足。

### 问题修复类型
- 根本性修复。

### 根因分析
- 误判源头是机械空间先验没有进入识别状态机，导致不应参与识别的竖梁样本与真实定位板使用同一套分类路径。
- `LASER STATUS` 的 `PLATE=1` 仅表示单帧距离有效且 `CONF>=70`，不是三级板完成事件；手动电机命令也没有取衣任务上下文，因此不会触发后续动作。
- 本次在取衣识别入口加入编码器位置门控，并用最内层距离窗口校验完整三级轮廓，不改变激光通信层或 ESP32 协议。

### 工程原则应用
- KISS：在现有取衣扫描状态机内增加单一编码器门槛和最内层距离窗口，不新增第二套激光驱动。
- YAGNI：门控仅使用现场确认的 EC1=12200 和 380~450mm，不增加运行时配置协议或 Flash 参数。
- DRY：第三级距离合法性集中由一个内部函数判断，进入、保持和完成路径复用同一规则。
- SOLID：激光驱动继续负责 Modbus 轮询，取衣状态机负责机械位置门控和定位板语义，职责边界不变。

### 问题确认情况
- 用户提供现场实测：EC1=12153 已超过竖梁，确认采用 EC1=12200 作为安全门槛；竖梁距离约 415mm，与定位板最内层接近。
- 用户确认只让 `AXIS TAKE_CLOTH` 或云端 `cmd=17` 联动完整取衣，手动 M1 保持调试行为；最内层采用 380~450mm 窗口。

### 风险评估
- 门槛必须位于竖梁尾缘之后且第一块定位板之前；机械位置变化后需要重新实测 EC1 门槛。
- 最内层实测距离若超出 380~450mm 会被拒绝，需要根据安装偏差校准窗口，但不会绕过限位、失速、离线和超时保护。
- 仅影响取衣激光识别；放衣、普通 M1 控制、Y/Z/M2/夹爪动作和 ESP32 二进制协议不变。

### 验证方式
- 已使用 Keil ARM Compiler V6.24 全量重建，结果为 `0 Error(s), 0 Warning(s)`。
- 程序大小为 `Code=84156, RO-data=11404, RW-data=116, ZI-data=25100`，已生成新的 AXF 和 HEX。
- 烧录后执行 `SYS VER`，应返回 `SmartWardrobe-STM32F407 v1.5.3-laser-gated-align`。
- `DEBUG ON` 后执行 `AXIS TAKE_CLOTH SLOT=1`：EC1<12200 不得进入 LEVEL1/2/3；越过门槛应输出 `OK TAKE_CLOTH LASER_ARM`，最内层 380~450mm 且完整离开后应输出 `OK TAKE_CLOTH LASER_SLOT` 并回对中心。
- 仍需实机验证 SLOT=1/2、最内层窗口外目标、拔线、失速、限位、门槛超时、识别超时和云端完整成功帧。

## 2026-07-15 10:59:51

### 修改类型
修复 / 根本性修复 / 激光门槛两段速度与独立超时

### 涉及文件
- `APP/Src/cmd_dispatch.c`
- `APP/COMMANDS.md`
- `APP/SERIAL_COMMANDS_EASY.md`
- `程序介绍.md`
- `MDK-ARM/SmartWardrobeCode/SmartWardrobeCode.build_log.htm`
- `MDK-ARM/SmartWardrobeCode/SmartWardrobeCode.axf`
- `MDK-ARM/SmartWardrobeCode/SmartWardrobeCode.hex`
- `修改日志/修改日志.md`

### 修改内容
- 固件版本更新为 `SmartWardrobe-STM32F407 v1.5.4-laser-two-speed`。
- 门槛前 X/M1 接近速度设为 45RPM，EC1 达到 12200 后通过 `MotorCtrl_SetSpeed()` 立即切换为 20RPM，再清空样本并武装三级板识别。
- 门槛等待使用独立 60 秒超时，越过门槛后重新开始原有 30 秒定位板识别超时。
- 门槛前每 5 秒输出 `LASER GATE WAIT EC1/TARGET/TIME`，启动和武装日志分别显示接近速度、识别速度、门槛与最内层距离窗口。
- 调速失败时执行取衣故障急停并输出 `TAKE_CLOTH_LASER_SCAN_SPEED_FAIL`。
- 保留激光离线、编码器失速、X 限位、三级至少靠近 12mm、3 帧稳定、最内层 380~450mm 和中心回对逻辑。

### 修改原因
- 实机在原 20RPM 扫描下，30 秒时 EC1 仅为 7019，实际编码器速度约 234 计数/秒，到达 EC1=12200 约需 52 秒，因此原门槛超时必然提前触发。
- 门槛前无需识别定位板，可以使用此前验证过的 45RPM 缩短空行程；进入有效识别区后必须恢复 20RPM，保证 50ms 激光轮询能取得足够稳定样本。

### 问题修复类型
- 根本性修复。

### 根因分析
- 原代码只定义一个 30 秒 `scan_ms` 超时，同时约束门槛接近和门槛后识别；现场实际速度无法在该时间内走到 12200。
- 命令响应中的 RPM=55 是后续取衣坐标运动速度，激光扫描原本固定为 20RPM，不能据此推断门槛到达时间。
- 本次将机械空行程和传感器识别阶段拆成两个速度、两个超时，消除两种阶段共用一个时间预算的根因。

### 工程原则应用
- KISS：复用现有 `MotorCtrl_Run()` 与 `MotorCtrl_SetSpeed()`，不新增电机控制模块。
- YAGNI：不修改尚未确认的电机 PPR、驱动器细分或传动比参数。
- DRY：门槛和识别继续复用同一取衣状态机、失速检查、限位检查与激光在线检查。
- SOLID：电机层负责即时速度更新，取衣状态机负责阶段切换和识别时序，职责不混合。

### 问题确认情况
- 用户提供实机日志确认门槛超时时 EC1=7019，停止后 EC1=7173，方向为 CW 且编码器持续递增。
- 用户确认采用门槛前高速、越过门槛后恢复 20RPM 的方案。

### 风险评估
- 45RPM 仅用于 EC1<12200 的空行程；若机械结构调整导致定位板提前到达 12200 之前，样本会被主动丢弃，需要重新标定门槛。
- `MotorCtrl_SetSpeed()`为即时改速，若现场出现明显机械冲击，应改为短时减速并重新确认门槛到定位板的可用距离。
- 不改变 ESP32 协议、手动 M1 行为、放衣流程和完整取衣完成后的成功上报时机。

### 验证方式
- 已使用 Keil ARM Compiler V6.24 全量重建，结果为 `0 Error(s), 0 Warning(s)`。
- 程序大小为 `Code=84312, RO-data=11584, RW-data=116, ZI-data=25100`，已生成新的 AXF 和 HEX。
- 烧录后执行 `SYS VER`，应返回 `SmartWardrobe-STM32F407 v1.5.4-laser-two-speed`。
- 执行 `DEBUG ON` 和 `AXIS TAKE_CLOTH SLOT=1`，应看到 5 秒周期的门槛进度、约 EC1=12200 时的 `LASER_ARM APPROACH=45 SCAN=20`，随后进入三级定位板识别。
- 仍需实机验证 SLOT=1/2、60 秒门槛超时、30 秒识别超时、调速失败、掉线、失速、限位和云端完整成功帧。

## 2026-07-15 15:43:29

### 修改类型
修复 / 根本性修复 / 激光新响应握手与通信看门狗

### 涉及文件
- `APP/Src/cmd_dispatch.c`
- `APP/COMMANDS.md`
- `APP/SERIAL_COMMANDS_EASY.md`
- `程序介绍.md`
- `MDK-ARM/SmartWardrobeCode/SmartWardrobeCode.build_log.htm`
- `MDK-ARM/SmartWardrobeCode/SmartWardrobeCode.axf`
- `MDK-ARM/SmartWardrobeCode/SmartWardrobeCode.hex`
- `修改日志/修改日志.md`

### 修改内容
- 固件版本更新为 `SmartWardrobe-STM32F407 v1.5.5-laser-fresh-handshake`。
- 每次进入取衣激光等待阶段时记录当前合法响应计数与通信错误计数，必须在任务开始后连续收到 2 帧新的正常响应才允许启动 M1。
- 等待握手期间若发生超时、CRC、协议、异常响应、UART 或发送错误，则以当前计数为新基准重新等待 2 帧；3 秒未完成时返回 `TAKE_CLOTH_LASER_READY_TIMEOUT`。
- 扫描阶段改为监控 `RESP` 是否持续增长：有新响应时清零静默计时，连续 500ms 没有新增响应才返回 `TAKE_CLOTH_LASER_OFFLINE` 并急停。
- 204错误文本增加 `SILENCE/REQ/RESP/TIMEOUT/PROTO_ERR/CRC_ERR/UART_ERR`现场快照。
- 保留45RPM接近、EC1=12200门槛、60秒门槛超时、20RPM识别、30秒识别超时及380~450mm最内层规则。

### 修改原因
- 实机确认一次取衣启动后立即出现204并使M1进入ESTOP，但错误前后激光`REQ/RESP`均持续增长，模块随后保持`COMM_ONLINE=1`。
- 故障窗口内`TIMEOUT`增加1、`PROTO_ERR`增加1，说明启动恰逢短暂通信抖动；旧状态机复用任务开始前临近过期的在线缓存，扫描下一tick便误判离线。

### 问题修复类型
- 根本性修复。

### 根因分析
- 原等待条件只检查最近一次响应是否仍在300ms窗口内，没有证明任务启动后收到过新响应。
- 原扫描保护继续读取同一缓存时间戳，一次超时叠加一次协议错误即可跨过边界并立即触发急停，即使后续轮询已经恢复。
- 本次改为任务级新响应握手和响应计数看门狗，使启动条件与运行保护均基于当前任务内真实发生的通信进展。

### 工程原则应用
- KISS：复用现有`LaserRangeStatus_t`公开计数，不修改Modbus驱动和串口协议。
- YAGNI：不修改已稳定的波特率、地址、PPR、驱动器细分或硬件配置。
- DRY：通信错误总数由单一内部函数汇总，握手重置逻辑不重复枚举各计数器。
- SOLID：激光驱动继续维护协议统计，取衣状态机只消费统计实现任务级握手与安全策略。

### 问题确认情况
- 用户实机确认204发生后`M1 MODE=ESTOP`，排除旧消息残留。
- 前后诊断显示`TIMEOUT 13->14`、`PROTO_ERR 1->2`，而`REQ/RESP`随后同步增加且`COMM_ONLINE=1`，确认属于短暂抖动触发缓存边界误判。
- 用户明确确认按连续2帧新响应与500ms看门狗方向修改。

### 风险评估
- 启动握手正常增加约100ms等待时间；若通信持续抖动，最多等待3秒且M1不会启动。
- 永久断线停止时间由原300ms调整为500ms；失速、X限位和急停保护仍独立生效。
- 不改变ESP32二进制协议、`LASER STATUS/DIAG`格式、手动M1行为和云端成功上报时机。

### 验证方式
- 已使用Keil ARM Compiler V6.24全量重建，结果为`0 Error(s), 0 Warning(s)`。
- 程序大小为`Code=84540, RO-data=11732, RW-data=116, ZI-data=25116`，已生成新的AXF和HEX。
- 烧录后执行`SYS VER`，应返回`SmartWardrobe-STM32F407 v1.5.5-laser-fresh-handshake`。
- 正常通信下执行`AXIS TAKE_CLOTH SLOT=1`，应先完成约100ms新响应握手，再启动45RPM接近，不得立即报204。
- 拔掉激光模块应在启动前3秒握手超时，或扫描中500ms内急停；204文本应包含完整通信快照。
- 仍需实机验证单次TIMEOUT/PROTO错误恢复、EC1=12200降速、三级板识别、SLOT=1/2、失速、限位及云端完整成功帧。

## 2026-07-15 17:22:02

### 修改类型
修复 / 根本性修复 / HardFault 电机安全兜底

### 涉及文件
- `APP/Src/cmd_dispatch.c`
- `MDK-ARM/startup_stm32f407xx.s`
- `Src/stm32f4xx_it.c`
- `程序介绍.md`
- `MDK-ARM/SmartWardrobeCode/SmartWardrobeCode.build_log.htm`
- `MDK-ARM/SmartWardrobeCode/SmartWardrobeCode.axf`
- `MDK-ARM/SmartWardrobeCode/SmartWardrobeCode.hex`
- `修改日志/修改日志.md`

### 修改内容
- 固件版本更新为 `SmartWardrobe-STM32F407 v1.5.6-laser-stack-safe`。
- 启动栈由 1KB 扩大为 4KB；未修改堆大小和 STM32F407 的硬件内存配置。
- 将激光 204 故障路径使用的 `LaserRangeStatus_t` 和 256 字节诊断文本缓冲区移到静态存储区，使该函数栈占用由 432 字节降到 112 字节。
- 重排激光故障处理顺序：先急停相关电机、取消取衣状态机并设置故障事件，再读取诊断计数和输出串口日志。
- HardFault 处理器增加独立安全兜底：关闭 TIM8~TIM12 的 STEP 更新中断、通道输出和计数器，并将 M1~M5 低有效 EN 引脚置高。
- 保留 2 帧新响应握手、45RPM 接近、EC1=12200 门槛、20RPM 识别、通信看门狗和三级定位板算法。

### 修改原因
- 现场出现串口停止输出、M1 在 45RPM 持续运行且不再处理 EC1=12200 的现象，符合 CPU 进入原 HardFault 死循环、硬件定时器继续输出 STEP 的行为。
- 链接器在修改前报告最大已知栈使用约 1288 字节，而启动文件仅分配 1024 字节；204 故障日志函数单独需要 432 字节栈，故障路径存在确定的栈越界风险。

### 问题修复类型
- 根本性修复，并增加独立硬件级防御性兜底。

### 根因分析
- STM32F407 的总 RAM 并未耗尽；问题是启动文件把主栈固定为 1KB，小于链接器计算的已知最大调用链需求。
- 204 故障路径在急停前先进入含 256 字节局部数组、状态结构体和 `snprintf()` 的深调用链，越界后可能在执行急停前触发 HardFault。
- 原 HardFault 处理器只执行死循环，不会停止已由硬件定时器持续产生的步进脉冲，因此表现为主循环和串口停止、M1 仍保持 45RPM。

### 工程原则应用
- KISS：扩大现有主栈并移出单个大缓冲区，不引入动态内存或新的任务框架。
- YAGNI：不修改与根因无关的 PPR、Modbus 参数、定位门槛和识别算法。
- DRY：故障诊断仍复用现有状态接口，未复制通信统计逻辑。
- SOLID：正常故障路径负责业务停机与日志，HardFault 只负责最小寄存器级安全关断，不调用可能依赖已损坏栈的复杂函数。

### 问题确认情况
- 根据链接器栈报告、1KB 启动栈配置以及“串口停止但硬件 PWM 继续”的现场现象，根因已确认。
- 用户明确回复“确认修改”，同意实施栈修复和电机安全兜底。

### 风险评估
- 4KB 栈使 ZI 数据增加约 3KB，但当前总静态 RAM 占用仍远低于 STM32F407 可用 RAM。
- HardFault 发生后 M1~M5 会立即失去驱动保持力，这是异常状态下防止持续运动的安全选择；正常运行路径不受影响。
- 不改变 ESP32 协议、串口命令格式、取衣定位参数和成功上报时机。

### 验证方式
- 已使用 Keil ARM Compiler V6.24 全量重建，结果为 `0 Error(s), 0 Warning(s)`。
- 修改后链接器报告最大已知栈使用为 1200 字节，启动栈为 4096 字节；`take_cloth_fail_laser()` 栈深度由 432 字节降到 112 字节。
- 程序大小为 `Code=84872, RO-data=11728, RW-data=116, ZI-data=28508`，已重新生成 AXF 和 HEX。
- 烧录后执行 `SYS VER`，应返回 `SmartWardrobe-STM32F407 v1.5.6-laser-stack-safe`。
- 仍需实机执行 `AXIS TAKE_CLOTH SLOT=1`，确认串口持续输出、EC1=12200 时从 45RPM 切换到 20RPM，并验证激光拔线时先停机再输出 204 快照。

## 2026-07-15 18:08:26

### 修改类型
修改 / 根本性参数标定修复

### 涉及文件
- `APP/Src/cmd_dispatch.c`
- `APP/COMMANDS.md`
- `APP/SERIAL_COMMANDS_EASY.md`
- `程序介绍.md`
- `MDK-ARM/SmartWardrobeCode/SmartWardrobeCode.build_log.htm`
- `MDK-ARM/SmartWardrobeCode/SmartWardrobeCode.axf`
- `MDK-ARM/SmartWardrobeCode/SmartWardrobeCode.hex`
- `修改日志/修改日志.md`

### 修改内容
- 固件版本更新为 `SmartWardrobe-STM32F407 v1.5.7-laser-level3-calibration`。
- 定位板第三级距离窗口由 `380~450mm` 调整为 `350~450mm`。
- 保留置信度不低于 70、连续 3 帧峰峰值不超过 8mm、三级至少靠近 12mm、完整离开第三级后停车和中心回对等判据。
- 同步更新取衣命令说明和程序介绍。

### 修改原因
- 实机在激光对准定位板时稳定返回 `DIST=373~374, CONF=100, VALID=1, PLATE=1`。
- 原第三级下限为 380mm，现场值低约 6~7mm，导致即使定位板距离和置信度有效也会被第三级范围校验拒绝。

### 问题修复类型
- 根本性参数标定修复。

### 根因分析
- 原 `380~450mm` 范围来自前期约 415mm 的估计，没有覆盖当前安装位置实测的 373~374mm。
- 第三级进入和完整标记确认都会调用同一距离窗口校验，低于 380mm 时会清空识别序列或拒绝衣位计数，因此 X 不会自动停车。

### 工程原则应用
- KISS：仅修正已被现场数据证明不准确的距离下限，不改变识别状态机结构。
- YAGNI：不取消置信度、稳定性、三级形状和完整离开保护。
- DRY：继续由统一的 `take_laser_level3_distance_valid()` 校验所有第三级入口和完成路径。
- SOLID：本次为参数标定，不引入新的模块或职责耦合。

### 问题确认情况
- 用户提供定位板静止实测数据 `DIST=373~374, CONF=100`，确认原下限不覆盖真实定位板距离。
- 用户明确回复“确认修改”，同意将范围调整为 `350~450mm`。

### 风险评估
- 350~379mm 的稳定三级结构现在也可能成为候选，但仍需通过 EC1 门槛、置信度、三级递减、稳定窗口和完整离开等全部条件，不会仅凭单帧距离触发取衣。
- 不改变 ESP32 协议、手动 M1 行为、扫描速度、超时和完整取衣成功上报时机。

### 验证方式
- 已使用 Keil ARM Compiler V6.24 全量重建，结果为 `0 Error(s), 0 Warning(s)`。
- 程序大小为 `Code=84872, RO-data=11736, RW-data=116, ZI-data=28508`，已重新生成 AXF 和 HEX。
- 链接器最大已知栈使用保持为 1200 字节，启动栈保持为 4096 字节。
- 烧录后执行 `SYS VER`，应返回 `SmartWardrobe-STM32F407 v1.5.7-laser-level3-calibration`。
- 执行 `DEBUG ON` 与 `AXIS TAKE_CLOTH SLOT=1`，应在最内层约 373~374mm 时进入 `LEVEL3`，完整离开后输出 `OK TAKE_CLOTH LASER_SLOT` 并回对中心。

## 2026-07-15 18:58:14

### 修改类型
修复 / 根本性状态机修复 / 现场参数标定

### 涉及文件
- `APP/Src/cmd_dispatch.c`
- `APP/COMMANDS.md`
- `APP/SERIAL_COMMANDS_EASY.md`
- `程序介绍.md`
- `MDK-ARM/SmartWardrobeCode/SmartWardrobeCode.build_log.htm`
- `MDK-ARM/SmartWardrobeCode/SmartWardrobeCode.axf`
- `MDK-ARM/SmartWardrobeCode/SmartWardrobeCode.hex`
- `修改日志/修改日志.md`

### 修改内容
- 固件版本更新为 `SmartWardrobe-STM32F407 v1.5.8-laser-board-segment`。
- 删除与真实定位板连续轮廓不匹配的三级递减和背景基准识别，改为完整板面的进入、经过、退出、宽度校验和中心回对。
- EC1<12200 保持 45RPM；达到门槛后以 20RPM 搜索；连续 3 帧满足 330~450mm、`CONF>=70`、峰峰值不超过 8mm 后记录进入位置并立即降至 10RPM。
- 滤波结果拆分为 `WARMUP/STABLE/TRANSITION/BACKGROUND`；有效板面内 `SPREAD>8` 只标记过渡，不再累计背景或清空目标。
- 连续 3 帧不满足板面条件后，以第一帧无效样本的位置作为退出位置；板宽在 1000~2200 计数内才计为衣位。
- `SLOT=1`确认后急停并回对中心；`SLOT=2`跳过第一块后恢复20RPM搜索，进入下一块时再次降至10RPM。
- 搜索和板面穿越分别使用独立30秒计时；新增进入、退出、宽度、中心、恢复搜索和调速失败日志。

### 修改原因
- 真实定位板日志中共有75帧有效目标，EC1约12223~14006，距离353~398mm，置信度70~100，但旧算法全程最高只到`LEVEL1`。
- 实际距离呈连续变化而非三个离散台阶，旧算法的动态参考值会跟随距离变化，无法形成单次至少12mm的级间跳变，因此不会完成定位板确认或停车。

### 问题修复类型
- 根本性状态机修复。

### 根因分析
- 旧状态机建立在“定位板存在三级离散递减平台”的假设上，但真实定位板表现为一个连续有效板面区间。
- 旧滤波函数把有效目标的过渡波动和真正无目标都返回负值，调用方统一累计背景，进一步导致识别状态被错误清零。
- 单纯放宽距离范围或降低速度不能改变识别模型不匹配的根因，因此本次直接改为符合实测特征的完整板面区间检测。

### 工程原则应用
- KISS：使用搜索和目标两个明确状态，直接匹配真实板面进入/退出行为。
- YAGNI：不保留已被实测否定的三级和背景基准分支，也不修改Modbus协议与电机PPR。
- DRY：进入、退出、宽度验证、SLOT计数和恢复搜索由统一内部函数处理。
- SOLID：激光驱动继续提供原始样本和通信统计，取衣状态机只负责板面识别和机械动作决策。

### 问题确认情况
- 已从用户提供的真实记录恢复225条串口记录和186帧激光样本，确认有效板面只形成连续区间而不是三级平台。
- 用户确认采用EC1=12200后20RPM搜索、3帧确认后10RPM精扫和完整板面中心回对方案。

### 风险评估
- 宽度范围按单次真实板面数据标定为1000~2200；若机械尺寸或编码器比例变化，需要重新采集进入/退出位置并调整范围。
- 10RPM会增加板面穿越时间，因此搜索和目标穿越分别重置30秒计时；通信、失速、限位和HardFault保护保持独立有效。
- 不改变串口命令、ESP32协议、手动M1行为和完整取衣后的成功上报时机。

### 验证方式
- 已使用Keil ARM Compiler V6.24全量重建，结果为`0 Error(s), 0 Warning(s)`。
- 程序大小为`Code=84752, RO-data=12052, RW-data=116, ZI-data=28500`，已重新生成AXF和HEX。
- 最大已知栈使用保持为1200字节，启动栈保持为4096字节。
- 使用真实记录离线回放新判据，得到`ENTER=12223, EXIT=14030, WIDTH=1807, CENTER=13126, MIN=353, MAX=398`，宽度校验通过。
- 烧录后执行`SYS VER`，应返回`SmartWardrobe-STM32F407 v1.5.8-laser-board-segment`。
- 执行`DEBUG ON`和`AXIS TAKE_CLOTH SLOT=1`，应在3帧确认后输出`LASER_TARGET_ENTER`并降至10RPM，完整离开后输出`LASER_TARGET_EXIT`与`LASER_SLOT`并回对约13126。

## 2026-07-16 22:17:29

### 修改类型
修改 / 重构 / 修复

### 涉及文件
- `APP/Src/cmd_dispatch.c`
- `Src/main.c`
- `APP/COMMANDS.md`
- `APP/SERIAL_COMMANDS_EASY.md`
- `程序介绍.md`

### 修改内容
- 将取衣专用激光扫描状态重构为取放衣共用扫描器，统一处理新响应握手、45RPM接近、EC1=12200门槛、20RPM首板搜索、10RPM精扫、板宽校验、通信看门狗、超时、失速和限位保护。
- 有效定位板完整退出但尚未到目标`SLOT`时保持10RPM，仅清空当前板面窗口、保留已识别数量，并重新开始下一块板的30秒搜索计时；宽度不在1000~2200计数内的无效目标仍恢复20RPM。
- 放衣在夹紧衣服、Z=350、X=5000、Y回零和M2逆时针600步完成后启动激光扫描；找到第N块板后回对动态X中心，再执行M2顺时针、Z=2450、Y=3100和松夹爪流程。
- 删除固定放衣X=13000和衣格坐标表依赖；取衣、放衣保留独立X机械偏移，当前均为0，挂衣Y/Z固定为3100/2450。
- 云端STORE/TAKE的position均直接作为激光定位板序号，固件版本更新为`SmartWardrobe-STM32F407 v1.5.9-laser-place-dynamic`。

### 修改原因
- 第二块定位板可能紧邻第一块，跳过第一块后恢复20RPM会缩短第二块的有效采样时间，因此有效跳板必须保持10RPM。
- 衣柜挂衣X不是固定坐标，放衣继续使用X=13000会与取衣动态板面中心不一致，无法保证对准同一衣位。

### 问题修复类型
- 根本性修复。

### 根因分析
- 原取衣和放衣使用两套X定位模型：取衣按激光板面中心，放衣按固定坐标；同一衣位没有统一事实来源。
- 原扫描器将跳板后的长距离搜索速度恢复到20RPM，不适合紧邻定位板的连续识别。
- 本次以同一套完整板面扫描器统一生成取放衣动态X，并把有效跳板速度规则放在板面完成分支中统一处理。

### 工程原则应用
- KISS：SLOT统一定义为越过门槛后的第N块有效定位板，取放衣共享同一识别规则。
- YAGNI：未修改激光Modbus、ESP32二进制帧和电机PPR，只保留当前需要的两个独立X偏移参数。
- DRY：握手、门槛、识别、超时和故障处理集中到共用扫描器，避免取放衣复制状态逻辑。
- SOLID：激光扫描负责生成动态X，取放衣状态机只负责各自机械动作编排。

### 问题确认情况
- 用户明确确认取衣跳过有效板后保持10RPM，并要求放衣接入与取衣相同的激光定位。
- 已确认Y=3100、Z=2450为所有衣位固定值，X由板面中心动态生成。

### 风险评估
- 放衣携衣扫描依赖现场假设：Z=350、Y已回零且M2已转向衣柜时，衣服不会遮挡激光且机械路径安全，仍需实机低速验证。
- 第二块及更后位置保持10RPM，运行时间会增加；每块板独立30秒搜索窗口保持有效。
- 扫描失败会急停并取消放衣任务，不会进入松夹爪步骤；夹爪断电后的实际保持能力取决于机械自锁和驱动硬件。

### 验证方式
- 已使用Keil ARM Compiler V6.24全量重建，结果为`0 Error(s), 0 Warning(s)`。
- 程序大小为`Code=86216, RO-data=11584, RW-data=116, ZI-data=28508`，已重新生成AXF和HEX。
- 启动栈保持4096字节，最大已知栈使用为1472字节。
- 烧录后执行`SYS VER`，应返回`SmartWardrobe-STM32F407 v1.5.9-laser-place-dynamic`。
- 分别执行`AXIS TAKE_CLOTH SLOT=2`和`AXIS PLACE_CLOTH SLOT=2`，第一块有效板退出后日志应显示`LASER_SEARCH RESUME RPM=10`，第二块退出后应回对第二块动态中心。

## 2026-07-19 17:31:50

### 修改类型
修改 / 修复 / 重构

### 涉及文件
- `APP/Inc/motor_hw.h`
- `APP/Src/motor_hw.c`
- `APP/Src/encoder_ctrl.c`
- `APP/Src/axis_coord.c`
- `APP/Src/axis_planner.c`
- `APP/Src/cmd_dispatch.c`
- `APP/COMMANDS.md`
- `APP/SERIAL_COMMANDS_EASY.md`
- `程序介绍.md`
- `程序启动指令.txt`

### 修改内容
- 将M4/EX_KEY4回零方向从CCW改为CW，M1/M3继续使用CCW；手动单轴回零、ALL HOME、上电回零以及取放衣前后回零统一读取每轴方向配置。
- 建立统一方向映射：M1/M3以CW为坐标正方向，M4以CCW向下为Z和EC4计数正方向。
- 编码器目标运动将真实电机方向和预期计数增减分开记录，修正M4相对运动、绝对Z目标、到位判断、越界判断和ENC_WRONG_DIR保护。
- 开环AXIS MOVE和AxisCoord坐标累计同步采用M4的CCW正方向，使Z轴逻辑坐标和编码器闭环一致。
- 新增EX_KEY4非回零上端硬限位：M4以CW向上运行时若EX_KEY4变低，立即急停并报告`ERR 212 M4_Z_UPPER_LIMIT EX_KEY4_LOW DIR=CW`；取放衣任务同步终止并上报故障。
- 固件版本更新为`SmartWardrobe-STM32F407 v1.5.10-z-upper-home`，现有Z目标数值保留并重新定义为从上端零点向下的计数。

### 修改原因
- EX_KEY4已从Z轴下端移动到上端，实机方向为CW向上、CCW向下，原代码所有回零入口硬编码CCW会让M4远离新开关。
- EC4在CCW向下时计数增加，原代码把所有轴的CW统一解释为计数增加，会导致M4绝对目标走反并触发ENC_WRONG_DIR。

### 问题修复类型
- 根本性修复。

### 根因分析
- 回零方向、坐标正方向和编码器计数方向此前共用“CW增加、CCW回零”的全轴假设，没有表达M4机械安装方向与其他轴不同。
- 只把M4回零改成CW会让回零后的正Z目标继续向上运行，因此必须同时修复闭环计数趋势、开环坐标、方向保护和上端限位。

### 工程原则应用
- KISS：用一套每电机方向映射统一服务编码器、坐标和规划器。
- YAGNI：不修改GPIO、传感器极性、串口格式和ESP32协议，不引入运行时配置。
- DRY：所有回零入口读取同一`home_dir`，不再分别硬编码M4特例。
- SOLID：电机硬件层负责方向映射，编码器和业务状态机只消费统一契约。

### 问题确认情况
- 已由用户实测确认M4 CW向上、CCW向下，CCW向下时EC4计数增加，新EX_KEY4位于上端。
- 用户确认以上端开关为Z=0、向下为正，并授权按完整方案修改。

### 风险评估
- 原`Z=350/2450/2936/300`现在表示从顶部向下的EC4计数，不保证对应旧下端零点下的相同机械高度，必须低速重新标定。
- EX_KEY4仍按PC3低电平触发；若现场电气极性变化，需要先修正输入极性再运行回零。
- 非回零触发上端开关不会自动清零，必须执行ALL HOME重新建立坐标。

### 验证方式
- 使用Keil ARM Compiler V6.24全量重建，要求`0 Error(s), 0 Warning(s)`并重新生成AXF/HEX。
- 低速执行`ALL HOME RPM=10`，确认M1/M3以CCW、M4以CW回零，EX_KEY4触发后三轴及EC1/EC3/EC4清零。
- 从Z=0执行`M4 ENC_MOVE DIR=CCW RPM=10 CNT=100`，确认M4向下且EC4增加；再以CW返回约0。
- 执行`AXIS ENC_MOVE Z=350 RPM=10 TOL=6`和小距离`AXIS MOVE`，确认正Z均为CCW向下。
- 从开关下方低速CW向上触发EX_KEY4，确认立即急停并输出`M4_Z_UPPER_LIMIT`。

## 2026-07-20 10:37:17

### 修改类型
修复 / 重构 / 修改

### 涉及文件
- `APP/Src/cmd_dispatch.c`
- `APP/Src/motor_hw.c`
- `APP/Src/axis_coord.c`
- `Src/main.c`
- `APP/COMMANDS.md`
- `APP/SERIAL_COMMANDS_EASY.md`
- `程序介绍.md`
- `程序启动指令.txt`

### 修改内容
- 根据最新实测将M4方向修正为`CCW=向上、EC4减少`、`CW=向下、EC4增加`，顶部EX_KEY4继续作为`Z=0`。
- 将M4回零方向改为CCW，并统一修正相对`M4 ENC_MOVE`、绝对Z目标、AxisCoord方向累计、编码器方向显示与`ENC_WRONG_DIR`使用的正方向映射。
- 新增M4两段式回零状态机：EX_KEY4初始高时直接CCW搜索；初始低时先CW释放，连续高20ms后再CCW重寻，连续低20ms后完成。
- 增加1秒释放超时和60秒搜索超时；失败时急停所有正在回零的轴、取消ALL HOME，不清零EC4/Z，也不继续M2上电回零。
- 将上端硬限位方向改为非回零状态下M4以CCW向上触发EX_KEY4时急停。
- 将上电、手动ALL HOME、M4单轴回零及取放衣前后回零统一接入同一启动器，并输出每轴`RUN/RELEASE/SEEK/SKIP`动作日志。
- 上电自动回零会额外输出ALL HOME实际方向和M4初始阶段，固件版本更新为`SmartWardrobe-STM32F407 v1.5.11-m4-home-reseek`。

### 修改原因
- 用户最新实测确认M4执行`DIR=CCW`时实际向上，与v1.5.10采用的方向假设相反。
- 现场上电日志显示M1/M3已有步数而M4保持`IDLE、STEP_TOTAL=0`，代码检查确认EX_KEY4初始低电平会被旧ALL HOME逻辑直接当成已完成并跳过，因此M4从未收到运行命令。

### 问题修复类型
- 根本性修复。

### 根因分析
- 旧逻辑对所有回零轴统一采用“开关低电平即跳过”，没有区分“轴已经可靠完成回零”和“上电时恰好压住开关但尚未重新建立零点”，导致M4在顶部上电时不执行任何动作。
- v1.5.10使用了与最新实测相反的M4机械方向契约；若只改回零方向，正Z目标、EC4目标和上端限位仍会反向，因此必须同步修正统一方向映射。

### 工程原则应用
- KISS：M4只增加`RELEASE/SEEK`两个必要阶段，以固定20ms消抖和明确超时完成可靠回零。
- YAGNI：不修改PC3 GPIO、电平极性、串口命令、ESP32协议或现有Z目标数值。
- DRY：上电、手动、取衣、放衣全部复用`all_home_start()`和`home_guard_start()`，避免四处再次出现低电平跳过错误。
- SOLID：电机硬件层只维护方向契约，命令分发层负责回零状态与业务失败处理，职责边界保持清晰。

### 问题确认情况
- 用户通过手动运行确认M4 CCW向上，并明确确认按本方案修改。
- `ALL STATUS`中的M4 `IDLE、STEP_TOTAL=0`与旧代码EX4低电平跳过分支直接对应，根因已确定。

### 风险评估
- M4在顶部开关已触发时上电会主动CW向下释放再CCW返回，属于新增机械动作，必须先以低速手动验证开关和方向，再使用上电60RPM。
- 原`Z=350/2450/2936/300`继续表示从顶部向下的正计数，生产运行前仍需逐项确认实际机械高度。
- EX_KEY4持续低会在1秒后报释放超时；持续高会在60秒后报搜索超时，两种情况都不会清零。

### 验证方式
- Keil V6.24全量重建，确认`0 Error(s), 0 Warning(s)`并重新生成AXF/HEX；链接映射中的栈段保持4096字节。
- EX_KEY4初始低时执行`ALL HOME RPM=10`，应先看到M4 `ACTION=RELEASE DIR=CW`，随后看到`ACTION=SEEK DIR=CCW`，最终输出低电平稳定20ms完成日志。
- EX_KEY4初始高时执行同一命令，应直接输出M4 `ACTION=SEEK DIR=CCW`。
- 从Z=0执行`M4 ENC_MOVE DIR=CW RPM=10 CNT=100`，应向下且EC4增加；再以CCW返回约0。
- 非回零状态下以CCW向上触发EX_KEY4，应急停并输出`M4_Z_UPPER_LIMIT ... DIR=CCW`。

## 2026-07-20 18:00:18

### 修改类型
创建 / 修改 / 修复

### 涉及文件
- `APP/Inc/electromagnet.h`
- `APP/Src/electromagnet.c`
- `APP/Src/cmd_parser.h`
- `APP/Src/cmd_parser.c`
- `APP/Src/cmd_dispatch.c`
- `Inc/main.h`
- `Src/gpio.c`
- `Src/main.c`
- `Src/stm32f4xx_it.c`
- `MDK-ARM/SmartWardrobeCode.uvprojx`
- `APP/COMMANDS.md`
- `APP/SERIAL_COMMANDS_EASY.md`
- `程序介绍.md`
- `程序启动指令.txt`

### 修改内容
- 新增 `PD8/ELM_CT` 电磁铁驱动模块和 `MAGNET ON/OFF/STATUS` 串口命令，状态明确标注没有继电器触点或线圈电流反馈。
- GPIO 初始化和 HardFault 路径强制 PD8 低电平；普通 STOP 保留吸合状态，ALL/AXIS ESTOP 强制释放。
- 自动取衣、放衣状态机改用电磁铁保持器，吸合和释放后各等待 2 秒；原 M5 自动夹爪函数保留在编译开关备用分支，M5 手动命令不变。
- 修正状态切换清零等待字段的问题：电磁铁动作完成后在进入等待状态之后重新装载 2000ms，避免吸合/释放后立即进入下一步。
- 旧夹爪专用的释放前等待函数只在 M5 备用分支编译，避免默认电磁铁模式新增未使用函数警告，同时保留旧模式完整行为。
- 电磁铁吸合时联锁新的 ALL HOME、AXIS MOVE/ENC_MOVE 和取放衣任务；自动故障若已吸合则输出 `MAGNET=ON HOLD_FOR_MANUAL`，等待人工 `MAGNET OFF`。
- 固件版本更新为 `SmartWardrobe-STM32F407 v1.5.12-magnet-holder`，同步更新取放衣说明和命令文档。

### 修改原因
- 继电器控制板由 `PD8/ELM_CT` 驱动，自动流程需要使用 24V 电磁铁替代原 M5 机械夹爪，同时保留旧夹爪用于手动调试和编译切换。

### 问题修复类型
- 根本性修复。

### 根因分析
- 原自动流程把衣物保持动作绑定到 M5 步进电机，无法控制新的电磁铁继电器；同时没有统一的保持状态、故障保持和手动释放联锁。
- 新模块将 PD8 输出、状态记录和强制关闭集中管理，业务状态机只调用保持器接口，避免取放衣流程分别维护两套电气动作。

### 工程原则应用
- KISS：使用单一高电平有效 PD8 驱动接口，不引入额外协议或硬件反馈假设。
- YAGNI：只增加当前需要的 ON/OFF/STATUS 和故障保持，不添加虚假的触点反馈或自动超时释放。
- DRY：取衣和放衣共用吸合、释放、等待和故障保持接口；M5 旧路径集中在编译开关分支。
- SOLID：电磁铁模块负责 GPIO 和状态，命令分发负责联锁，业务状态机负责流程时序，保持模块边界清晰。

### 问题确认情况
- 用户已明确确认按“PD8 高电平吸合、低电平释放，自动流程替代夹爪”的方案修改。
- 硬件触点、电磁铁线圈电流和 24V 电源容量不由软件反馈，必须按现场接线和万用表验证。

### 风险评估
- `MAGNET STATUS` 的 `FEEDBACK=NONE` 只反映软件命令和 PD8 读回电平，不等同于继电器触点或线圈通电确认。
- 电磁铁连续通电需满足额定电流和散热要求；继电器触点两端应按硬件方案安装续流二极管，PD8 栅极应有约 10kΩ 下拉。
- 自动故障保持吸合会让衣服继续悬挂，必须人工确认后执行 `MAGNET OFF`。

### 验证方式
- Keil V6.24 全量重建，要求 `0 Error(s), 0 Warning(s)`，确认 AXF/HEX 重新生成且栈段保持 4096 字节。
- 上电、`MAGNET ON/OFF/STATUS` 测量 PD8 高低电平和继电器 CN10-1 的 24V 通断。
- 回归 `PLACE_CLOTH/TAKE_CLOTH SLOT=1` 的吸合、2 秒等待、保持搬运、释放、2 秒等待；故障后确认电磁铁保持吸合，ESTOP/HardFault 确认强制释放。
- 手动运行 M5，确认旧夹爪源码和命令仍可独立调试。

## 2026-07-23 11:55:46

### 修改类型
修改 / 修复 / 重构

### 涉及文件
- `APP/Src/cmd_dispatch.c`
- `APP/COMMANDS.md`
- `APP/SERIAL_COMMANDS_EASY.md`
- `程序介绍.md`
- `程序启动指令.txt`
- `../放衣服.txt`
- `MDK-ARM/SmartWardrobeCode/SmartWardrobeCode.axf`
- `MDK-ARM/SmartWardrobeCode/SmartWardrobeCode.hex`

### 修改内容
- 完成此前只改了枚举和参数、尚未接入执行函数的放衣状态机重构，删除旧放衣取衣点、板中心回对、M2双向600步及固定挂衣Y/Z动作。
- 新放衣顺序固定为：`ALL HOME`、M2 CW 650、EC4=10000、EC3=1494、EC4=12800、电磁铁ON等待2秒、M4 CCW上抬650步、EC1=5000、Y归零、EC4=3263、M2 CW 3000、EC1=8860、激光扫描、X左移1125、Z下降1600、Y前移1125、M2 CCW 3000、电磁铁OFF等待2秒、Y归零、`ALL HOME`及M2回RAW=1008。
- X左移1125、Z下降1600和Y前移1125均使用动作起点加减编码器计数的相对闭环目标，并输出起点、目标、方向和相对计数日志。
- 取衣和放衣共用的激光板识别窗口统一由330~450mm调整为200~250mm；放衣在EC1=8860后直接20RPM搜索，取衣保留EC1=12200门槛、45RPM接近和板中心回对。
- 为M2绝对回零增加任务级完成/故障标志；放衣只有确认进入RAW=1008现有容差后才上报成功，通信、状态、失速、反向及越过目标未到位故障均终止任务。
- M5作为磁铁组件手动旋转电机保留，不参与本次自动放衣；PD8电磁铁继续负责吸合和释放。
- 固件版本保持`SmartWardrobe-STM32F407 v1.5.13-place-sequence-v2`，同步更新命令说明和操作文档。

### 修改原因
- 当前`cmd_dispatch.c`的新放衣状态枚举、结构和扫描配置只完成了上半部分，实际`place_cloth_tick()`与命令入口仍引用已删除的旧状态和字段，当前源码无法正常编译。
- 新机械结构要求放衣动作顺序、绝对坐标、相对位移、激光距离窗口及M2最终位置全部变化，旧动态板中心挂衣流程不再适用。

### 问题修复类型
- 根本性修复。

### 根因分析
- 放衣流程的状态定义、运行状态结构、执行状态机和命令初始化未在同一次修改中完成，导致接口契约不一致。
- 激光扫描器由取衣和放衣共用，旧距离窗口是单一全局规则，因此必须统一修改识别函数和`LASER STATUS`，避免运行扫描与状态显示判断不一致。
- 原M2上电绝对回零只有异步运动状态和串口日志，没有可供放衣状态机判断的完成/故障结果，不能保证成功事件晚于RAW=1008到位。

### 工程原则应用
- KISS：复用现有绝对编码器移动、相对编码器移动、电磁铁保持器和激光扫描器，不新增协议。
- YAGNI：只改变已确认的放衣顺序和共用激光窗口，不调整取衣机械动作顺序。
- DRY：三个相对动作统一通过`place_cloth_start_relative_axis_move()`计算和记录目标。
- SOLID：状态机负责业务时序，编码器模块负责闭环运动，激光扫描器负责板面识别，M2绝对编码器状态负责最终到位结果。

### 问题确认情况
- 用户明确确认采用开头`ALL HOME`和结尾M2回RAW=1008的扩展流程。
- 用户明确确认取衣和放衣的激光识别范围都改为200~250mm。
- 用户明确确认M4上抬650步使用`AXIS PLACE_CLOTH`命令RPM，M2固定10RPM。

### 风险评估
- 尚未连接实机执行机械动作；首次运行必须使用`RPM=10`并逐步核对M2、M4及三个相对运动方向。
- M4上抬650步默认会使用55RPM，只有完成低速验证后才允许使用默认速度。
- 激光窗口改变会同时影响取衣和放衣，现场距离必须稳定落在200~250mm，否则不会识别为板面。
- 电磁铁吸合后的自动故障继续保持ON，必须人工确认衣物状态后执行`MAGNET OFF`。

### 验证方式
- 使用ARM Compiler V6.24按`uvprojx`源文件列表全量编译42个C文件，全部编译成功且无C编译错误或警告。
- 使用`armasm`重新生成启动文件对象，仅按诊断号屏蔽与固件源码无关的旧版汇编器弃用提示`A1950W`，结果为0错误、0警告；未屏蔽任何C源码诊断。
- 使用`armlink`完成最新源码链接，结果为`Code=85528, RO-data=12852, RW-data=116, ZI-data=28596`，随后使用`fromelf`重新生成AXF和HEX；编译、链接和HEX转换退出码均为0。
- 烧录后执行`VER`，应返回`SmartWardrobe-STM32F407 v1.5.13-place-sequence-v2`。
- 低速执行`DEBUG ON`和`AXIS PLACE_CLOTH RPM=10 TOL=6 SLOT=1`，逐步核对全部绝对目标、相对计数、电磁铁等待、激光识别及最终M2 RAW=1008。
- 回归执行`AXIS TAKE_CLOTH RPM=10 TOL=6 SLOT=1`，确认除识别窗口改为200~250mm外，取衣动作顺序和板中心回对不变。

## 2026-07-23 15:04:21

### 修改类型
修改 / 功能调整

### 涉及文件
- `APP/Src/cmd_dispatch.c`
- `APP/COMMANDS.md`
- `APP/SERIAL_COMMANDS_EASY.md`
- `程序介绍.md`
- `程序启动指令.txt`
- `../放衣服.txt`
- `MDK-ARM/SmartWardrobeCode/SmartWardrobeCode.axf`
- `MDK-ARM/SmartWardrobeCode/SmartWardrobeCode.hex`

### 修改内容
- 在放衣状态机的`PLACE_CLOTH_WAIT_MAGNET_OFF`与最终Y归零之间新增`PLACE_CLOTH_MOVE_Z_RELEASE_UP`状态。
- 新动作在电磁铁OFF并完整等待2秒后，以动作开始时的实际EC4计数为起点，让M4以CCW向上相对移动150个EC4计数；目标为`起点EC4-150`，使用`AXIS PLACE_CLOTH`命令指定的RPM和TOL。
- 新增常量`PLACE_CLOTH_Z_RELEASE_UP_COUNTS=150U`，并为启动失败及未到位分别保留放衣故障上报。
- 保持现有相对动作参数不变：X左移1125、Z下降1500、Y前移1250；最终流程仍为Y归零、`ALL HOME`、M2回`RAW=1008`后上报成功。
- 更新启动响应`SEQ=`及全部放衣说明文档，移除过时的`Z下降1600/Y前移1125`描述。

### 修改原因
- 新机械释放动作要求电磁铁断开并稳定等待后先抬高Z轴150个编码器计数，再执行Y归零，避免释放位置与后续回零动作直接衔接。

### 问题修复类型
- 根本性修改。

### 根因分析
- 原状态机在电磁铁OFF等待完成后直接进入最终Y归零，没有表达新机械结构要求的释放后Z轴避让动作。
- 说明文档仍保留旧的Z下降1600和Y前移1125参数，与当前源码常量1500和1250不一致，需要与实际固件同步。

### 工程原则应用
- KISS：沿用现有`place_cloth_start_relative_axis_move()`和`cloth_axis_wait_done()`，只增加一个明确状态和一个参数常量。
- YAGNI：不修改取衣流程、激光规则、其他坐标、M2动作和通信接口。
- DRY：相对目标、方向检查、失速及到位判断继续复用现有编码器闭环运动链路。
- SOLID：状态机只负责动作时序，编码器运动模块继续负责相对目标计算和运动故障判定。

### 问题确认情况
- 用户已明确确认在电磁铁关闭并等待2秒与最终Y归零之间新增Z向上相对移动150个EC4计数。
- 用户已锁定其余参数保持X左1125、Z下1500、Y前1250，不在本次修改中调整。

### 风险评估
- 新动作会在衣物释放后增加一次M4 CCW机械运动；首次运行必须低速确认CCW确实向上且EC4减少。
- 尚未连接实机验证电磁铁实际断电、机械间隙、限位和150计数对应的实际高度。

### 验证方式
- 静态检查放衣状态枚举共35项（含IDLE）、执行分支34项，无遗漏或重复状态。
- 确认执行顺序为`PLACE_CLOTH_WAIT_MAGNET_OFF → PLACE_CLOTH_MOVE_Z_RELEASE_UP → PLACE_CLOTH_HOME_Y_FINAL`。
- ARM Compiler V6.24编译`cmd_dispatch.c`成功，无编译错误或源码警告。
- `armlink`链接成功，程序大小为`Code=88696, RO-data=12964, RW-data=116, ZI-data=28572`。
- `fromelf`重新生成HEX成功；AXF时间为2026-07-23 15:03:48，HEX时间为2026-07-23 15:03:59。
- 实机应低速执行`DEBUG ON`和`AXIS PLACE_CLOTH RPM=10 TOL=6 SLOT=1`，确认电磁铁先OFF并等待2秒，随后M4 CCW运行，EC4终点约为动作起点减150，完成后才开始Y归零。

## 2026-07-23 15:34:59

### 修改类型
修改 / 功能调整

### 涉及文件
- `APP/Src/cmd_dispatch.c`
- `APP/COMMANDS.md`
- `APP/SERIAL_COMMANDS_EASY.md`
- `程序介绍.md`
- `程序启动指令.txt`
- `../放衣服.txt`
- `MDK-ARM/SmartWardrobeCode/SmartWardrobeCode.axf`
- `MDK-ARM/SmartWardrobeCode/SmartWardrobeCode.hex`

### 修改内容
- 在最终Y轴通过EX_KEY3归零完成后、`ALL HOME`之前新增M2以固定10RPM顺时针移动1000个电机步。
- 新增`PLACE_CLOTH_M2_AFTER_Y_HOME_CW_STEPS=1000U`、M2启动状态和M2完成等待状态。
- M2启动失败或运行进入ESTOP时终止放衣任务并上报故障；M2未完成时不会启动`ALL HOME`。
- 保留后续`ALL HOME → M2回RAW=1008 → 上报成功`，其他坐标、计数、电磁铁和激光规则不变。
- 更新启动响应`SEQ=`及全部放衣操作说明。

### 修改原因
- 新机械动作要求释放后Z上抬、Y归零完成后，再让M2顺时针转1000步，然后才能执行后续全部归零。

### 问题修复类型
- 根本性修改。

### 根因分析
- 原状态机在最终Y归零完成后直接启动`ALL HOME`，缺少新机械结构要求的M2顺时针1000步动作。

### 工程原则应用
- KISS：直接复用现有`cloth_start_m2_move()`与`cloth_step_motor_wait_done()`，只新增两个顺序明确的状态。
- YAGNI：不修改取衣流程、命令格式、XYZ参数、激光规则或最终M2绝对回零。
- DRY：M2固定10RPM、任务冲突检查和完成判定继续走现有统一接口。
- SOLID：放衣状态机负责编排动作，电机控制模块继续负责步进任务执行。

### 问题确认情况
- 用户明确确认新增动作位置为最终Y轴实际归零完成之后、`ALL HOME`之前。
- 用户明确确认M2方向为CW、速度10RPM、步数1000，后续流程保持不变。

### 风险评估
- 新增M2机械动作会改变`ALL HOME`前的旋转臂位置，首次运行必须确认CW方向和1000步不会发生机械干涉。
- 尚未连接实机验证M2实际方向、行程及最终`RAW=1008`回位过程。

### 验证方式
- 静态检查放衣状态枚举共37项（含IDLE）、执行分支36项，无遗漏或重复状态。
- 确认状态链为`PLACE_CLOTH_WAIT_HOME_Y_FINAL → PLACE_CLOTH_MOVE_M2_AFTER_Y_HOME → PLACE_CLOTH_WAIT_M2_AFTER_Y_HOME → PLACE_CLOTH_ALL_HOME`。
- ARM Compiler V6.24编译`cmd_dispatch.c`成功，无编译错误或源码警告。
- `armlink`链接成功，程序大小为`Code=88784, RO-data=13116, RW-data=116, ZI-data=28572`。
- `fromelf`重新生成HEX成功；AXF时间为2026-07-23 15:34:28，HEX时间为2026-07-23 15:34:42。
- 实机应低速执行`DEBUG ON`和`AXIS PLACE_CLOTH RPM=10 TOL=6 SLOT=1`，确认Y归零完成后才输出`M2_AFTER_Y_HOME M2 CW RPM=10 STEP=1000`，M2完成后才启动`ALL HOME`，最终M2进入`RAW=1008`后才上报成功。

## 2026-07-24 00:45:53

### 修改类型
修改 / 重构 / 功能调整

### 涉及文件
- `APP/Src/cmd_dispatch.c`
- `APP/COMMANDS.md`
- `APP/SERIAL_COMMANDS_EASY.md`
- `程序介绍.md`
- `程序启动指令.txt`
- `MDK-ARM/SmartWardrobeCode/SmartWardrobeCode.axf`
- `MDK-ARM/SmartWardrobeCode/SmartWardrobeCode.hex`

### 修改内容
- 按新机械顺序重写`TAKE_CLOTH`状态机，移除旧板中心回对、`Z2450/Y3100`、M2双向600步、`X2250/Z300/Y3433`交换点流程。
- 新流程固定执行M2 CW650、`EC4=3263`、M2 CW1500、`EC1=8860`后直接扫描；目标板完整退出后执行X左1125、Z下1200、Y前1250、M2 CCW1500、Z下300、电磁铁ON等待2秒、Z上200、Y前150和M2 CW1500。
- 后续固定执行Y通过EX_KEY3归零、M2 CCW4500、`EC1=4200`、M2 CW3000、`EC4=12800`、`EC3=1540`、X通过EX_KEY1归零、电磁铁OFF等待2秒、`EC4=10000`及`ALL HOME`。
- 取衣结束新增M2任务级绝对回零判定，只有确认进入`RAW=1008`现有容差后才上报成功。
- 六个相对动作全部以实时编码器起点计算目标，并输出方向、起点、目标和增量日志。
- 更新`AXIS TAKE_CLOTH`启动`SEQ=`及操作文档；放衣流程和固件版本保持不变。

### 修改原因
- 机械结构、磁铁组件姿态和取衣交换位置已经改变，旧取衣坐标、板中心定位方式及M2 600步动作不再适用。

### 问题修复类型
- 根本性重构。

### 根因分析
- 旧取衣状态机仍基于夹爪和旧交换点设计，无法表达新电磁铁结构要求的多段M2旋转、相对编码器靠近动作以及EX_KEY1物理回零。
- 旧流程完成事件未等待M2绝对编码器回`RAW=1008`，不能保证下一次任务从统一旋转臂基准开始。

### 工程原则应用
- KISS：沿用现有绝对编码器移动、相对编码器移动、电磁铁保持、EX_KEY回零和M2步进接口。
- YAGNI：只重写已确认的取衣动作，不调整放衣参数、激光有效板规则、命令格式或固件版本。
- DRY：六个相对动作统一通过取衣相对移动辅助函数计算和记录目标。
- SOLID：取衣状态机负责编排动作，电机、编码器、激光和电磁铁模块继续承担各自硬件职责。

### 问题确认情况
- 用户明确确认完整动作顺序、全部绝对坐标和相对计数。
- 用户确认“M2逆时针CW 4500步”实际为`CCW逆时针4500步`。
- 用户确认X归零采用EX_KEY1物理回零，不是闭环到`EC1=0`。

### 风险评估
- 新流程包含M2 CCW4500、M2 CW3000及携衣状态下的X/Y/Z复合路径，首次运行必须低速逐步确认机械干涉和衣物摆动。
- 电磁铁吸合后的故障会保持ON等待人工处理；现场必须预留人工释放和急停操作。
- 尚未连接实机验证EX_KEY1/EX_KEY3方向、相对计数对应距离及M2最终绝对回位。

### 验证方式
- 静态检查取衣状态枚举共42项（含IDLE）、执行分支41项，无遗漏或重复状态；放衣状态覆盖仍为37项/36分支。
- 确认源码与现行文档中不存在旧`ALIGN_X/Z2450/Y3100/M2_CCW600/X2250/M2_CW600/Z300/Y3433`流程。
- ARM Compiler V6.24编译`cmd_dispatch.c`成功，无编译错误或源码警告。
- `armlink`链接成功，程序大小为`Code=90144, RO-data=14168, RW-data=116, ZI-data=28564`。
- `fromelf`重新生成HEX成功；AXF时间为2026-07-24 00:45:10，HEX时间为2026-07-24 00:45:26。
- 实机应低速执行`DEBUG ON`和`AXIS TAKE_CLOTH RPM=10 TOL=6 SLOT=1`，逐步核对全部方向、坐标、电磁铁等待、EX_KEY1/EX_KEY3回零及最终M2 `RAW=1008`。

## 2026-07-24 00:57:35

### 修改类型
文档化 / 可维护性调整

### 涉及文件
- `APP/Src/cmd_dispatch.c`

### 修改内容
- 为取衣、放衣、M2绝对回位及共用激光参数逐行补充中文行尾说明。
- 明确区分绝对编码器目标、相对编码器计数、步进电机步数、RPM、毫秒及角度等单位。
- 明确标出动作方向、参数影响的流程，以及当前直扫自动流程不使用的旧保留参数。
- 本次未修改任何参数数值、动作顺序、状态机或通信接口。

### 修改原因
- 便于后续直接在参数集中调整取衣和放衣坐标、点位、速度与超时，并降低把相对计数误当绝对坐标的风险。

### 验证方式
- ARM Compiler V6.24重新编译`cmd_dispatch.c`，确认新增中文注释不影响源码编译。
- 重新链接并生成AXF/HEX，确认固件产物与当前源码一致。

## 2026-07-24 16:21:53

### 修改类型
新增功能 / 第二路测距

### 涉及文件
- `APP/Inc/laser_range2.h`
- `APP/Src/laser_range2.c`
- `Inc/usart.h`
- `Src/usart.c`
- `Src/main.c`
- `APP/Src/uart_console.c`
- `APP/Inc/cmd_parser.h`
- `APP/Src/cmd_parser.c`
- `APP/Src/cmd_dispatch.c`
- `MDK-ARM/SmartWardrobeCode.uvprojx`
- `APP/COMMANDS.md`
- `APP/SERIAL_COMMANDS_EASY.md`
- `程序介绍.md`
- `程序启动指令.txt`
- `MDK-ARM/SmartWardrobeCode/SmartWardrobeCode.axf`
- `MDK-ARM/SmartWardrobeCode/SmartWardrobeCode.hex`

### 修改内容
- 新增完全独立的`LaserRange2`驱动，复用第一套测距的数据结构和Modbus协议，但使用独立的UART4收发缓冲、解析状态、样本队列及诊断计数。
- 新增`MX_UART4_Infrared_Init()`，将CN5的EC5_A/EC5_B对应PA0/PA1配置为UART4、9600、8N1；保留旧`MX_UART4_Init()`和夹爪源文件，不调用也不删除。
- 主程序启动UART4第二测距并持续调用`LaserRange2_Service()`；TIM5继续不初始化。
- UART全局接收、发送完成和错误回调新增UART4分流，USART1第一测距、USART2绝对编码器和USART3 ESP32路径保持不变。
- 新增`LASER2 STATUS`和`LASER2 DIAG`只读命令；第二测距当前不接入取衣、放衣、电机急停或ESP32主动上报。
- Keil工程加入`laser_range2.c`，同步更新命令和接线用途说明。

### 修改原因
- CN5原EC5编码器信号脚已经闲置，硬件确认可复用为第二个同款测距模块，后续需要与电机组合形成新的自动功能。

### 隔离原则
- 不重构、不替换现有`LaserRange`第一测距驱动。
- 不修改取衣和放衣状态机、坐标、速度、激光板识别规则或成功/故障事件。
- 不删除TIM5、EC5旧预留代码或`yjzk_gripper.c/.h`，只保证它们不与UART4第二测距同时初始化。
- 第二测距只在被查询时向USART3返回文本，不产生新增上电主动消息。

### 验证方式
- ARM Compiler V6.24分别编译`laser_range2.c`、`uart_console.c`、`cmd_parser.c`、`cmd_dispatch.c`、`usart.c`和`main.c`，无错误和源码警告。
- `armlink`链接成功，程序大小为`Code=93212, RO-data=14576, RW-data=116, ZI-data=28916`。
- `fromelf`重新生成HEX成功；链接映射确认`LaserRange2_Init/Service/GetStatus`和`MX_UART4_Infrared_Init`均已进入AXF。
- 静态检查确认`main()`中`MX_TIM5_Init()`调用数为0、UART4红外初始化调用数为1、旧YJZK夹爪外部调用数为0。
- 工程文件XML解析正常，`LASER2`解析入口唯一，`STATUS/DIAG`执行分支各一个。
- 尚未连接实机验证CN5测距响应；烧录后应分别执行`LASER2 STATUS`和`LASER2 DIAG`检查距离、置信度、响应计数及错误计数。

## 2026-07-24 17:40:55

### 修改类型
功能增强 / 第二测距串口连续上报

### 涉及文件
- `APP/Inc/laser_range2.h`
- `APP/Src/laser_range2.c`
- `Src/main.c`
- `APP/Inc/cmd_parser.h`
- `APP/Src/cmd_parser.c`
- `APP/Src/cmd_dispatch.c`
- `APP/COMMANDS.md`
- `APP/SERIAL_COMMANDS_EASY.md`
- `程序介绍.md`
- `程序启动指令.txt`
- `MDK-ARM/SmartWardrobeCode/SmartWardrobeCode.axf`
- `MDK-ARM/SmartWardrobeCode/SmartWardrobeCode.hex`

### 修改内容
- 为第二测距模块新增默认关闭的串口连续上报开关，周期固定为200ms。
- 新增`LASER2 STREAM ON`、`LASER2 STREAM OFF`和`LASER2 STREAM STATUS`命令。
- 连续上报只在`DEBUG ON`文本调试模式生效，格式为`LASER2 DATA DIST/CONF/COMM/VALID/ONLINE/SEQ`。
- 二进制ESP32模式或串口发送队列忙时不输出或跳过本次测距数据，避免污染二进制协议或覆盖电机、回零和故障日志。

### 验证方式
- ARM Compiler V6.24编译`laser_range2.c`、`cmd_parser.c`、`cmd_dispatch.c`和`main.c`成功，无错误和源码警告。
- HELP响应字符串长度为744字节，小于768字节发送缓冲区。
- 静态检查确认流输出默认关闭，并且发送前检查文本调试输出状态。
- `armlink`链接成功，程序大小为`Code=93672, RO-data=14696, RW-data=116, ZI-data=29044`；`fromelf`已重新生成HEX。

## 2026-07-25 00:31:45

### 修改类型
功能修改 / 取衣与放衣机械流程更新

### 涉及文件
- `APP/Src/cmd_dispatch.c`
- `APP/COMMANDS.md`
- `APP/SERIAL_COMMANDS_EASY.md`
- `程序介绍.md`
- `程序启动指令.txt`
- `速度和容差调试说明.txt`
- `../放衣服.txt`
- `MDK-ARM/SmartWardrobeCode/SmartWardrobeCode.axf`
- `MDK-ARM/SmartWardrobeCode/SmartWardrobeCode.hex`

### 修改内容
- 放衣在`EC4=10000`后新增EC5第二测距三帧稳定取样、两点标定换算及动态EC1闭环移动；当前标定参数为占位值且有效开关为0，未标定时安全停止并禁止继续吸合电磁铁。
- 放衣取物坐标更新为动态EC1、`EC3=1381`、`EC4=12552`，吸合抬升后的X中转点更新为`EC1=1000`；M2扫描和释放动作统一为4000步。
- 取衣末端参数更新为M2 CCW5500、`EC1=1000`、M2 CW4000、`EC4=12552`、`EC3=1470`和`EC1=3200`，删除释放前单独EX_KEY1回零状态；最终`ALL HOME`仍负责M1物理归零。
- 取放衣第一测距扫描速度固定为75RPM，进入有效板面后降至50RPM；M2普通动作保持10RPM，最终绝对回`RAW=1008`保持25RPM。
- 修正状态日志和启动`SEQ=`中的全部旧坐标、旧相对计数及旧M2步数，同步更新程序说明和串口命令文档。

### 修改原因
- 新机械结构改变了取物点、释放点、中转点和M2旋转步数；放衣取物X坐标需要根据第二测距实时结果确定，旧固定坐标和取衣释放前X物理回零不再符合实际动作顺序。

### 问题修复类型
根本性修改

### 根因分析
- 原状态机仍使用旧机械位置和旧日志，无法表达EC5动态取物位置；仅修改常量无法完成第二测距取样、稳定性判断、标定换算、故障停止和动态闭环目标等待，因此必须补充完整状态链。

### 工程原则应用
- KISS：第二测距直接复用现有`LaserRange2_PollSample()`，不修改独立UART4驱动。
- YAGNI：标定参数暂使用代码常量，不增加串口写配置或Flash持久化接口。
- DRY：动态X及新绝对坐标继续复用现有编码器闭环、方向、失速和到位判断。
- SOLID：第二测距驱动继续负责采集，取放衣状态机只负责业务取样、换算和动作时序。

### 问题确认情况
- 用户明确给出了取衣与放衣的新动作顺序、坐标、步数和速度。
- 用户确认第二测距使用固定模块两点绝对映射，当前没有实测标定值，先使用占位参数并在未标定时安全停止。

### 风险评估
- 当前`PLACE_LASER2_CALIBRATION_VALID=0`，放衣无法越过动态X步骤；实机标定完成前这是预期安全行为。
- 尚未进行机械实机验证。首次启用标定后必须使用`RPM=10、TOL=6`，逐项确认X方向、换算结果、机械干涉和电磁铁时序。

### 验证方式
- 静态检查放衣状态枚举40项（含IDLE）对应39个执行分支，取衣状态枚举41项（含IDLE）对应40个执行分支，无遗漏、重复或未知状态。
- 启动`SEQ=`最大长度285字节，小于USART3文本响应缓冲区768字节。
- ARM Compiler V6.24全量重建成功，结果为`0 Error(s), 0 Warning(s)`。
- 链接程序大小为`Code=92604, RO-data=14900, RW-data=116, ZI-data=29020`，AXF和HEX生成时间均为`2026-07-25 00:33:01`。
- 尚无法验证两点标定端点、中点和真实机械动作；需要获得实测`D_A/EC_A/D_B/EC_B`后再启用标定并进行低速测试。

## 2026-07-25 11:48:00

### 修改类型
修复 / 第二测距动态X坐标换算

### 涉及文件
- `APP/Src/cmd_dispatch.c`
- `程序启动指令.txt`
- `../放衣服.txt`
- `MDK-ARM/SmartWardrobeCode/SmartWardrobeCode.axf`
- `MDK-ARM/SmartWardrobeCode/SmartWardrobeCode.hex`

### 修改内容
- 新增`PLACE_LASER2_X_ZERO_DISTANCE_MM=270.0f`，表示激光出光面到X轴完成EX_KEY1归零后实际工作中心的暂定距离。
- 标定点A固定为`D_A=D_ZERO、EC_A=0`，标定点B继续等待另一处原始激光距离和对应EC1计数的实机数据。
- 动态X目标改为先计算`D_MOVE=D_RAW-D_ZERO`，再按`EC_TARGET=round(D_MOVE/K)`换算，避免把激光总距离直接当成X轴移动距离。
- 新增标定参数一致性、零点前距离、标定区间、负目标和EC1目标范围校验。
- 动态X串口日志新增`D_RAW/D_ZERO/D_MOVE/K/EC_TARGET`，便于现场逐项核对。
- 标定开关继续保持`PLACE_LASER2_CALIBRATION_VALID=0U`，实测参数未完成前放衣流程仍安全停止且不会吸合电磁铁。

### 修改原因
- 第二测距读取的是激光到衣架的总距离，X轴实际需要移动的距离还必须扣除激光到X轴零点工作中心的固定机械偏置。

### 问题修复类型
根本性修复

### 根因分析
- 原换算使用`EC_A+(D-D_A)/K`直接映射原始激光距离，没有在接口和诊断中明确表达X轴零点机械偏置，容易把总距离误当成实际移动距离或在现场重复扣除偏置。

### 工程原则应用
- KISS：保留现有两点标定和第二测距取样状态机，只明确增加零点偏置和必要校验。
- YAGNI：不增加Flash标定存储、自动标定命令或第二套测距驱动。
- DRY：零点和标定参数一致性由统一校验函数处理。
- SOLID：第二测距驱动继续只负责采样，机械坐标换算仍由放衣状态机负责。

### 问题确认情况
- 用户通过实物图确认激光读数包含约270mm的激光到X轴零点工作中心距离，并明确同意按先减固定偏置、再换算EC1的方案修改。

### 风险评估
- `270mm`目前只是暂定值，不能作为正式机械标定值使用。
- 当前标定开关保持关闭，因此不会因暂定偏置或空白标定点B导致X轴自动误动作。

### 验证方式
- 使用ARM Compiler V6.24全量构建成功，结果为`0 Error(s), 0 Warning(s)`。
- 链接程序大小为`Code=92604, RO-data=14900, RW-data=116, ZI-data=29020`。
- AXF和HEX生成时间均为`2026-07-25 11:47:20`。
- 以测试标定`D_ZERO=270、D_B=800、EC_B=5000`静态核算：零点目标为0，中点`D=535`目标为2500，标定点B目标为5000。
- 实机启用前仍需精确测量`D_ZERO`和标定点B，并以`RPM=10、TOL=6`低速验证方向、目标和机械干涉。

## 2026-07-25 14:54:25

### 修改类型
修改 / 第二测距四点拟合标定启用

### 涉及文件
- `APP/Src/cmd_dispatch.c`
- `程序启动指令.txt`
- `../放衣服.txt`
- `MDK-ARM/SmartWardrobeCode/SmartWardrobeCode.axf`
- `MDK-ARM/SmartWardrobeCode/SmartWardrobeCode.hex`

### 修改内容
- 根据4组实测`激光距离/EC1计数`写入有效光学零点`D_ZERO=241.72mm`。
- 写入四点拟合等效B点`D_B=558mm、EC_B=5919`，其中5919不是单个558mm样本的实测5903。
- 将`PLACE_LASER2_CALIBRATION_VALID`从`0U`改为`1U`，允许放衣流程实际执行第二测距动态X运动。
- 保留原有三帧稳定取样、置信度、零点前距离、标定区间、目标范围和X轴限位检查。
- 同步现场说明，明确有效原始距离约`241.72～558mm`及首次低速验证要求。

### 修改原因
- 用户完成4组现场测量并确认采用线性拟合结果，替代照片估算的270mm零点和空白标定参数。

### 问题修复类型
分阶段标定修复

### 根因分析
- 原参数仍是`D_ZERO=270mm、D_B=0、EC_B=0、VALID=0`，只能安全停止，无法根据第二测距执行动态X；四点数据表明有效零点和比例应以实机拟合结果为准。

### 工程原则应用
- KISS：继续使用现有零点加等效B点的线性公式，不增加运行时回归计算。
- YAGNI：不新增Flash标定管理和串口标定写入接口。
- DRY：保留统一标定检查和动态X换算函数。
- SOLID：不修改第二测距驱动或取衣状态机职责。

### 问题确认情况
- 用户提供实测点`558/5903、532/5445、490/4664、455/3977`，并明确确认采用四点拟合参数且立即启用标定。

### 风险评估
- 四点拟合最大残差约18个EC1计数，约1mm；首次运行仍需现场确认夹持工作中心。
- 原始距离小于241.72mm或大于558mm时，程序会拒绝动态X运动。
- 标定开关已启用，烧录后执行放衣命令将不再停在`CAL_REQUIRED`，而会实际驱动X轴。

### 验证方式
- 固件公式得到`K=0.053434702mm/计数`，约18.714430计数/mm。
- 静态核算结果：`558→5919、532→5432、490→4646、455→3991`，与实测误差依次为`+16、-13、-18、+14`计数。
- 使用ARM Compiler V6.24全量构建成功，结果为`0 Error(s), 0 Warning(s)`。
- 链接程序大小为`Code=93116, RO-data=15284, RW-data=116, ZI-data=29020`。
- AXF和HEX生成时间均为`2026-07-25 14:54:09`。
- 尚未执行实机自动放衣；首次必须使用`DEBUG ON`和`AXIS PLACE_CLOTH RPM=10 TOL=6 SLOT=1`核对动态X位置。

## 2026-07-26 11:57:08

### 修改类型
修复 / M1、M3回零限位输入稳定确认

### 涉及文件
- `APP/Src/cmd_dispatch.c`
- `MDK-ARM/SmartWardrobeCode/SmartWardrobeCode.axf`
- `MDK-ARM/SmartWardrobeCode/SmartWardrobeCode.hex`

### 修改内容
- 将M1、M3回零过程中的EX_KEY停止条件由“单次采样为低立即急停”改为“连续低电平稳定20ms后急停”。
- EX_KEY恢复高电平时立即清零低电平累计时间，过滤电机启动时的瞬时干扰。
- 在回零启动、取消、异常退出和全部取消路径中统一清零限位稳定计数，避免历史状态影响下一次回零。
- M1、M3与M4共用`HOME_EXKEY_STABLE_MS=20U`稳定阈值，保留M4原有释放和搜索阶段逻辑。
- 回零完成日志更新为`EX_KEYn_LOW_STABLE=20MS`，明确记录经过稳定确认的真实限位触发。

### 修改原因
- 实机两次执行`M1 HOME_EX1 RPM=60`后分别在约137ms和40ms提前停止，均返回`HOME_EX1_DONE EX_KEY1_LOW`；随后`SYS STATUS`显示`EX1=未触发`，证明回零监控捕获了瞬时低电平并误判为到达限位。

### 问题修复类型
根本性修复

### 根因分析
- 主程序已有20ms EX_KEY消抖，但只用于提示消息；命令分发层的M1、M3回零监控直接读取GPIO原始电平，任何一次1ms低电平采样都会调用`MotorCtrl_EStop()`。
- M1启动时的线束干扰、触点抖动或输入端瞬态会触发该单点判断，造成电机移动一小段后进入急停，而实际机械行程开关并未到位。

### 工程原则应用
- KISS：在现有回零守卫内增加连续低电平计数，不改变电机控制、ALL HOME掩码和回零完成流程。
- YAGNI：不新增配置命令、Flash参数或额外任务，只处理已确认的误触发问题。
- DRY：M1、M3、M4统一复用同一个20ms稳定阈值。
- SOLID：限位稳定确认仍由命令分发层的回零守卫负责，不侵入底层电机PWM和编码器模块。

### 问题确认情况
- 用户提供了两次可重复串口日志，并明确确认按连续20ms稳定低电平方案修改。
- `M1=急停`和`E1=计数-129`证明M1实际启动后由软件限位路径停止，不是命令未执行或驱动器未输出。

### 风险评估
- 真实触发行程开关后，M1和M3最多延迟约20ms急停；在60RPM、3200PPR下约增加64个STEP脉冲，必须确认机械端预留了对应制动余量。
- 软件消抖不能替代硬件抗干扰；若EX1低电平干扰持续超过20ms，仍需增加外部上拉、RC滤波、屏蔽或光耦隔离。
- M4原有20ms稳定判断、1秒释放超时和60秒搜索超时保持不变。

### 验证方式
- 使用ARM Compiler V6.24全量构建成功，结果为`0 Error(s), 0 Warning(s)`。
- 链接程序大小为`Code=93252, RO-data=15296, RW-data=116, ZI-data=29020`。
- AXF和HEX生成时间均为`2026-07-26 11:56:46`。
- 静态核对确认：连续低电平计数达到20才进入急停；任意高电平采样、取消回零、重新启动和异常退出都会清零计数。
- 实机烧录后应先执行`M1 HOME_EX1 RPM=60`，确认瞬时干扰不再触发；手动按下EX1并保持超过20ms后，应返回`OK M1 HOME_EX1_DONE EX_KEY1_LOW_STABLE=20MS`并进入急停。
