linkstwo/smart-wardrobe-iot/串口协议解析工具/修改日志/修改日志.md

# 修改日志

## 2026-07-04 00:00:00

### 修改类型
创建

### 涉及文件
- `代码/wardrobe_uart_parser.py`
- `代码/README.md`

### 修改内容
- 新增电脑端智能衣柜 UART 二进制协议解析器。
- 支持监听串口并解析 `A5 CMD LEN DATA CRC 5A` 帧。
- 支持通过 `--hex` 直接解析单帧 HEX 文本。
- 新增使用说明、常见帧示例和接线提醒。

### 修改原因
- 当前 ESP32 和 STM32 之间传输的是二进制协议，串口助手按文本显示会像乱码。
- 用户希望在不改变现有 ESP32/STM32 固件的情况下解析 ESP32 串口数据。

### 问题修复类型
- 防御性兜底

### 根因分析
- 根因是二进制协议被当作文本显示，而不是字符编码本身错误。
- 本工具不改变固件协议，只在电脑端做协议解码，便于联调定位。

### 工程原则应用
- KISS：使用独立 Python 脚本完成串口监听和协议解析，不引入复杂工程结构。
- YAGNI：只实现当前所需的帧解析、CRC 校验和常见命令解释。
- DRY：CRC、HEX 格式化、帧解释集中为公共函数，避免重复逻辑。
- SOLID：当前是小型调试工具，不强行套用复杂架构，保持职责清晰。

### 问题确认情况
- 已确认项目协议文档和源码均使用 `A5 CMD LEN DATA CRC 5A` 二进制帧。
- 已确认 STM32/ESP32 链路默认使用 `115200 8N1`。

### 风险评估
- 只新增独立电脑端工具，不修改 ESP32 和 STM32 固件，无明显风险。

### 验证方式
- 运行 `python "代码/wardrobe_uart_parser.py" --hex "A5 10 01 01 10 5A"`。
- 预期输出包含 `ESP->STM 存衣服`、`CRC: 0x10 OK`、`position: 1`。
