linkstwo/smart-wardrobe-iot/SCH_Schematic1_1_2026-05-13.pdf

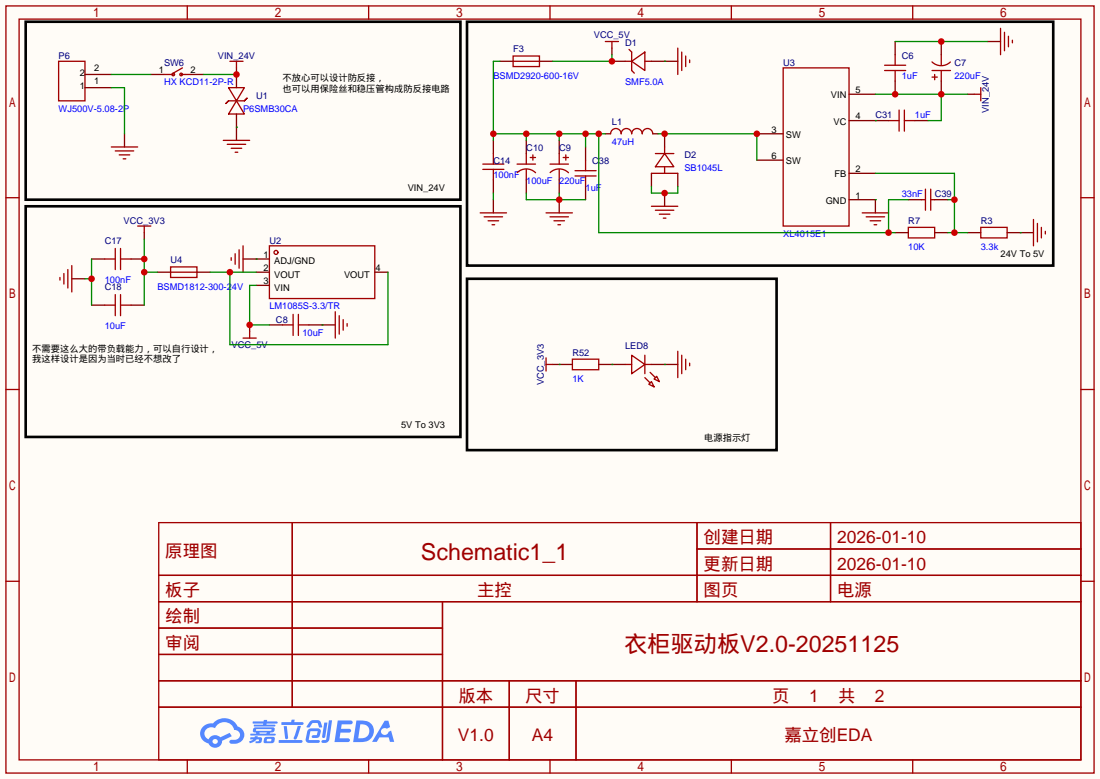
[picture p6: page 1]

原理图 | Schematic1_1 | 创建日期 | 2026-01-10

更新日期 | 2026-01-10

板子 | 主控 | 图页 | 电源
绘制 | | 衣柜驱动板V2.0-20251125
审阅

版本 | 尺寸 | 页 1 共 2
V1.0 | A4 | 嘉立创EDA

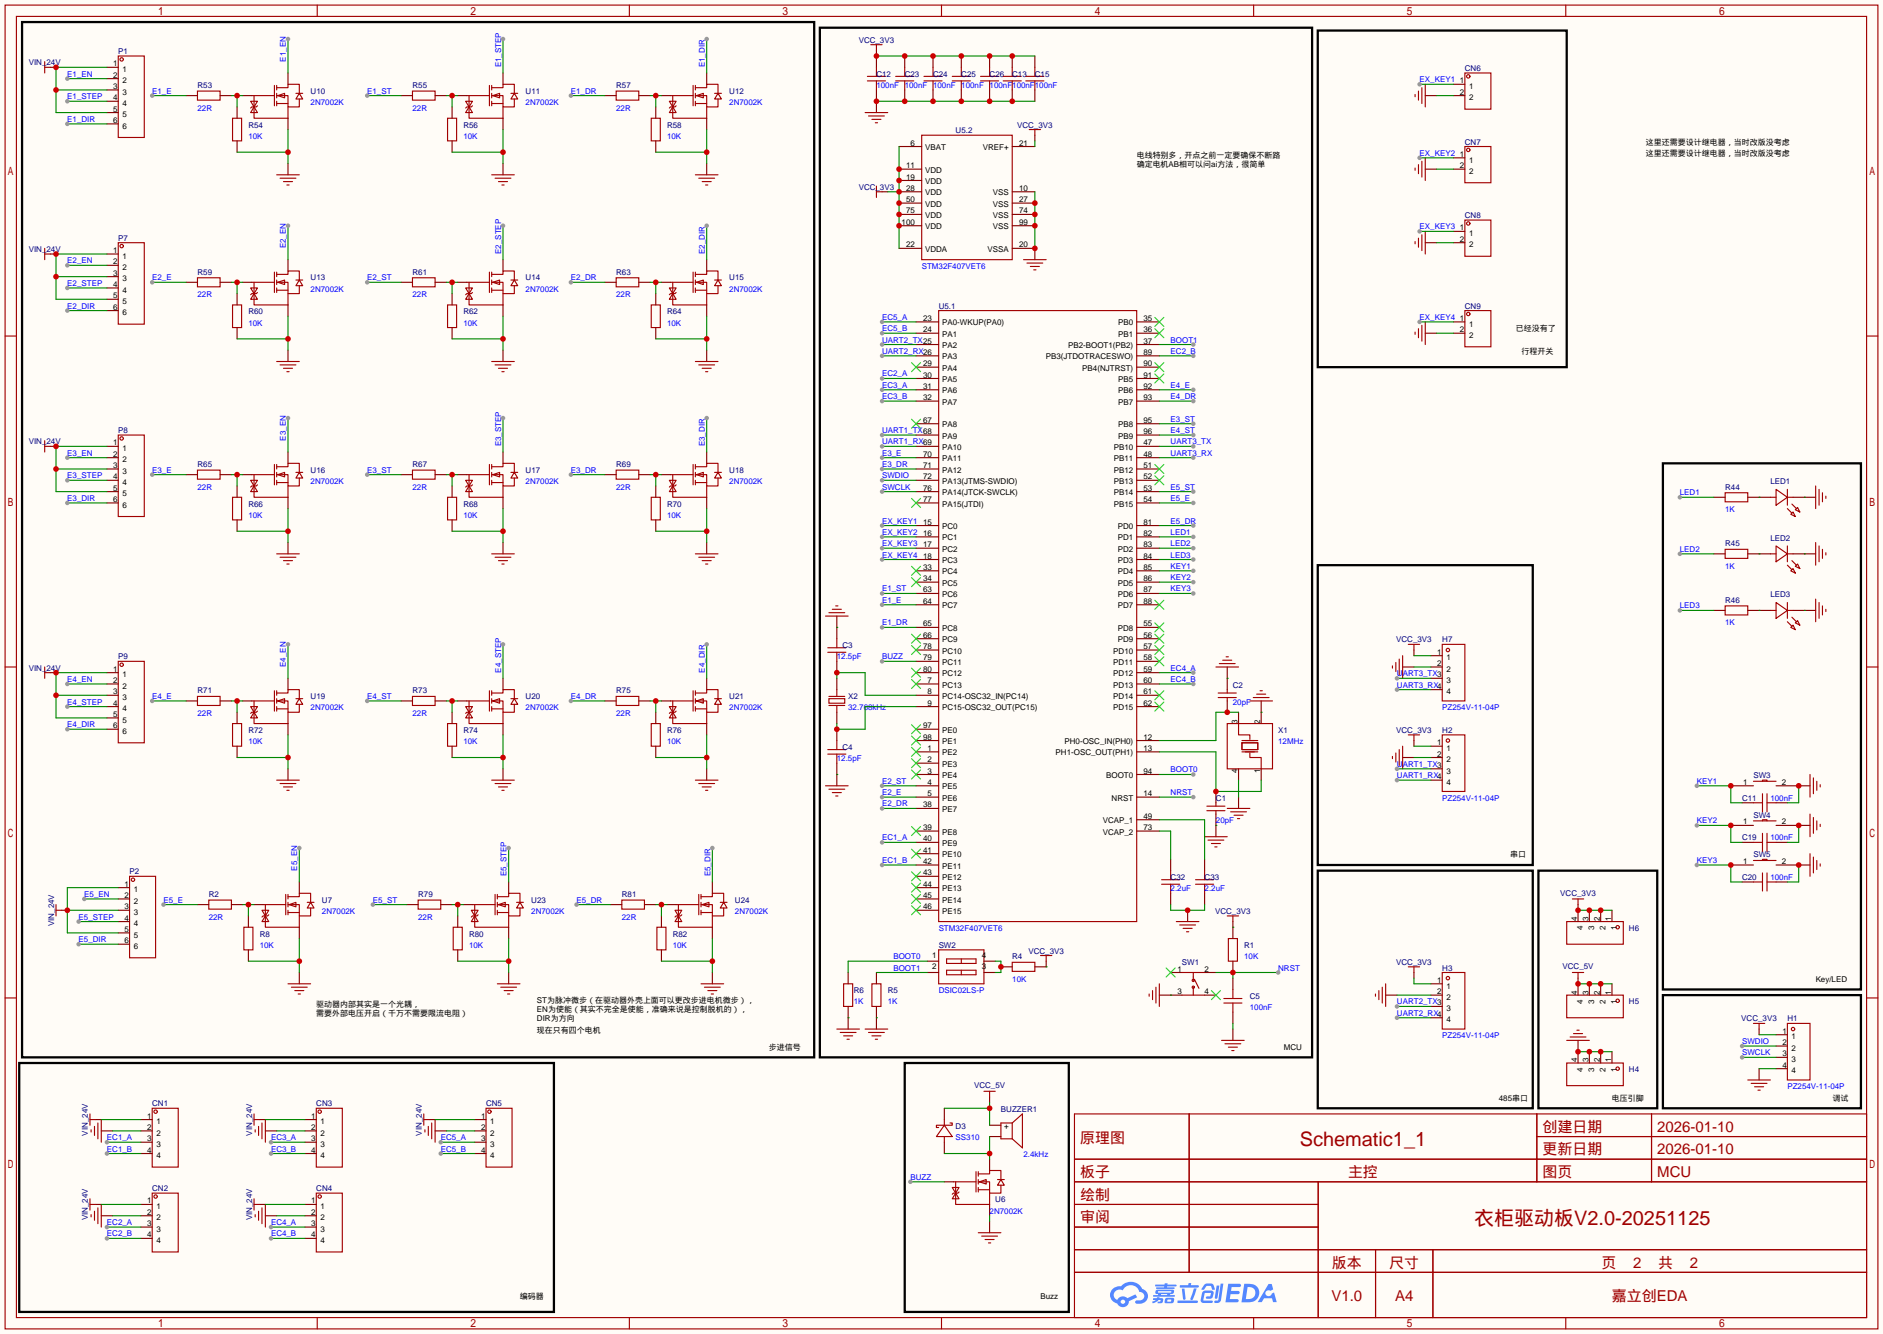
[picture p7: page 2]

原理图 | Schematic1_1 | 创建日期 | 2026-01-10

更新日期 | 2026-01-10

板子 | 主控 | 图页 | MCU

版本 | 尺寸 | 页 2 共 2
V1.0 | A4 | 嘉立创EDA
