linkstwo/smart-wardrobe-iot/SmartWardrobe/APP/Src/motion_profile.c

#include "motion_profile.h"

/*
 * 运动曲线模块：
 * 当前只提供一个 Q15 格式的余弦衰减系数，用于电机软停止。
 * Q15 的满量程约为 32767，调用方用 当前转速 * 系数 / 32767 得到平滑下降转速。
 */
static const uint16_t g_motion_sine_q15[MOTION_SINE_TABLE_SIZE] = {
    0, 405, 810, 1216, 1620, 2025, 2429, 2833, 3237, 3640, 4042, 4444, 4845, 5246, 5646, 6044,
    6442, 6839, 7235, 7630, 8023, 8415, 8806, 9196, 9584, 9971, 10357, 10740, 11122, 11503, 11881, 12258,
    12633, 13006, 13377, 13746, 14113, 14477, 14840, 15200, 15558, 15913, 16266, 16617, 16965, 17310, 17653, 17993,
    18331, 18665, 18997, 19325, 19651, 19974, 20294, 20610, 20924, 21234, 21541, 21845, 22145, 22442, 22736, 23026,
    23313, 23596, 23875, 24151, 24423, 24691, 24956, 25216, 25473, 25726, 25975, 26220, 26461, 26698, 26931, 27160,
    27385, 27605, 27821, 28033, 28241, 28444, 28643, 28838, 29028, 29214, 29395, 29572, 29744, 29912, 30075, 30234,
    30388, 30537, 30682, 30822, 30957, 31087, 31213, 31334, 31450, 31561, 31668, 31770, 31866, 31958, 32045, 32127,
    32205, 32277, 32344, 32407, 32464, 32517, 32564, 32607, 32644, 32677, 32704, 32727, 32744, 32757, 32764, 32767
};

uint16_t MotionProfile_GetCosineDecayQ15(uint32_t elapsed_ms, uint32_t total_ms)
{
    uint32_t idx;

    /* 总时间为 0 时无法计算曲线，直接返回 0，表示立即降到停止。 */
    if (total_ms == 0U) {
        return 0U;
    }

    /* 已经超过软停止总时间时，也返回 0，表示停止过程结束。 */
    if (elapsed_ms >= total_ms) {
        return 0U;
    }

    /*
     * 表中是从 0 增长到 32767 的正弦表。
     * 软停止需要从大到小衰减，因此按反向下标读取，得到近似余弦衰减效果。
     */
    idx = (elapsed_ms * (MOTION_SINE_TABLE_SIZE - 1U)) / total_ms;
    return g_motion_sine_q15[(MOTION_SINE_TABLE_SIZE - 1U) - idx];
}
